SenaxInc/SenaxTankAlarm/TankAlarm-112025-Server-BluesOpta/WEBSITE_PREVIEW.md

# Website Preview - TankAlarm 112025 Server

This document contains screenshots of the web interface served by the TankAlarm-112025-Server-BluesOpta.

## Dashboard
Main fleet telemetry dashboard showing server metadata, statistics, and fleet telemetry table with relay controls.

Dashboard

## Client Console
Configuration management interface for remote clients with PIN-protected controls (unlocked view).

Client Console

## Config Generator
Create new client configurations with sensor definitions and alarm thresholds.

Config Generator

## Serial Monitor
Debug log viewer with server and client serial output.

Serial Monitor

## Calibration
Calibration learning system with manual level reading submission and drift analysis.

Calibration

## Contacts Manager
Contact and notification management with alarm associations.

Contacts Manager

## Server Settings
Server-wide configuration including FTP backup, network settings, and daily email schedule.

Server Settings

## Historical Data
Historical trends, charts, and analytics for tank fleet with level trends, alarm frequency, and site/tank details.

Historical Data

---
*Screenshots automatically generated by GitHub Actions*  
*Last updated: 2026-11-09 08:55:44 UTC*
