SenaxInc/SenaxTankAlarm/CODE REVIEW/CODE_REVIEW_07012026_DAC_LOOP_POWER_INTEGRATION_PLAN.md

# A0602 Internally-Powered DAC Gating Option in Client Firmware

**Date:** 2026-07-01  
**Author:** GitHub Copilot (Gemini 3.5 Flash)  
**Status:** Superseded by v2.1.0 (see note below)  
**Related Firmware:** TankAlarm-112025-Client-BluesOpta `v2.0.77`
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
