SenaxInc/SenaxTankAlarm/TankAlarm-112025-Viewer-BluesOpta/screenshots/dashboard.png

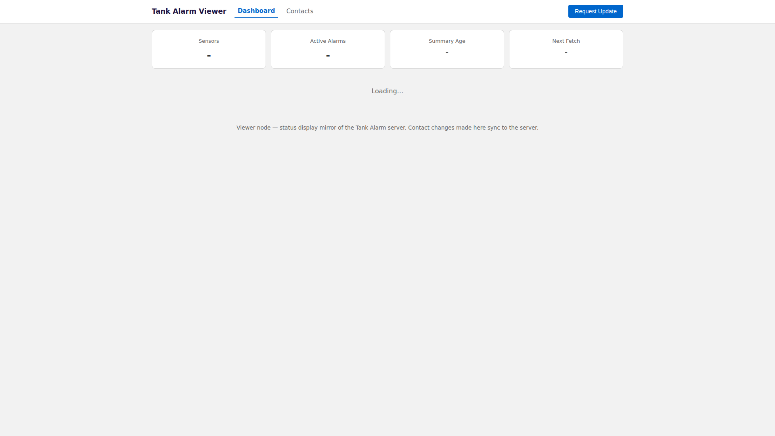
TankAlarm-112025-Viewer-BluesOpta/screenshots/dashboard.png
