SenaxInc/SenaxTankAlarm/CODE REVIEW/REMAINING_PROBLEMS_AND_ATTEMPTS_06232026.md

# Remaining Problems & Everything Tried â€” Consolidated Register

**Date:** 2026â€‘06â€‘23
**Author:** GitHub Copilot (AI), consolidated from the full review/bench history
**Purpose:** A single, selfâ€‘contained record of the field problems that are **still open**, plus a complete
log of **everything that has already been tried** (firmware and hardware), so no avenue is reâ€‘walked from
scratch and the next session (or a bench visit) can start exactly where the last one left off.

**Subject field device:** `dev:860322068056545` â€” site **"Silas"**, sensor **"Cox Wellhead"** (gas, 4â€‘20 mA
current loop), solar + SunSaver MPPT, cellular.
**Server device:** `dev:860322068056529` â€” local, USB/COM3, LAN `192.168.7.117` (pin `2001`).
**Firmware at time of writing:** **server v2.0.44** (USBâ€‘flashed + verified live), **client v2.0.44** (OTA
delivered + reporting `fv:2.0.44`).

---

## Executive summary â€” the open problems

| # | Problem | Layer (current best assessment) | Confidence | Firmware fix possible? |
|---|---|---|---|---|
| 1 | **No battery voltage** â€” SunSaver MPPT RSâ€‘485 link not communicating in the field (`scOk:0`) | **Physical** (RSâ€‘485 wiring / MRCâ€‘1 / SunSaver) | High | **No** â€” firmware avenues exhausted |
| 2 | **Currentâ€‘loop sensor reads stale / `0`** â€” A0602 gas sensor (`lvl:0`, `ru:1`, no `ma`) | **Hardware / IÂ²C bus** (framedâ€‘protocol fix already shipped; reads still fail at the bus) | High | **Largely shipped** â€” remaining is hardware |
| 3 | **Stale latched `sensor-fault` alarm** on the dashboard | Server alarm hygiene | Medium | Yes (after #2 is healthy) |

**Oneâ€‘line status:** Both #1 and #2 were **proven working on the bench** in April 2026, yet both fail in the
field. The firmware now reports both conditions *accurately* and every reasonable firmware mitigation has
shipped. What remains is **physical/hardware** verification at the site (or on the bench with the field
harness).

> **Important framing:** the firmware is **not** currently hiding or misreporting these faults. `scOk:0` and
> `ru:1`/noâ€‘`ma` are the firmware *correctly telling us* the SunSaver isn't answering and the sensor isn't
> giving a fresh reading. The work left is to fix the physical cause, not the code.

---

## Problem 1 â€” No battery voltage (SunSaver MPPT / RSâ€‘485 Modbus)

### Current field symptom (2026â€‘06â€‘23)
- Field client OTA'd cleanly all the way to **v2.0.44**; config is applied (`powerSupply: solar_modbus_mppt`,
  `solarCharger.enabled: true`, status `applied`).
- Telemetry carries **`scOk:0`** in every sample and **no `v` / `vs` / `solar` / `bv`** field at all â†’ the
  RSâ€‘485/Modbus link to the SunSaver is **persistently failing**, so `getEffectiveBatteryVoltage()` returns 0
  and no voltage is reported.
- v2.0.43's 3â€‘attempt retry did **not** recover it (so it is **not** transient noise), and v2.0.44's
  singleâ€‘register read change did **not** flip `scOk` to 1 either.

### How the link is *supposed* to work (verified, benchâ€‘proven)
- Opta `RS485` â†’ **Morningstar MRCâ€‘1** (MeterBus â†” RSâ€‘485 level converter) â†’ SunSaver **SSâ€‘MPPTâ€‘15L** RJâ€‘11
  MeterBus port.
- Modbus RTU, **9600 8N2**, slave **1**, `RS485.setDelays(0, 1200)`, timeout â‰¥ 500 ms.
- **Live registers `0x0008â€“0x000C`** (battery V, array V, currents) â€” these were verified by **bench capture
  on 2026â€‘04â€‘22**; the spec's documented `0x0010â€“0x0013` read zero on this unit (see lesson #5 below).
- Scaling `SS_SCALE_VOLTAGE_12V = 96.667`, `SS_SCALE_CURRENT_12V = 79.16`, divisor 32768.

### The two critical bench findings that made it work (April 2026)
1. **Polarity is crossed.** Morningstar uses the **opposite A/B convention** from modern adapters:
   **Opta A â†’ MRCâ€‘1 B, Opta B â†’ MRCâ€‘1 A.** Straightâ€‘through Aâ†”A/Bâ†”B does **not** work.
2. **Opta lastâ€‘byte corruption.** The Opta `RS485` library silently corrupts the last byte of every TX frame
   at 9600 baud unless you set `RS485.setDelays(0, â‰¥1 charâ€‘time)` â†’ `setDelays(0, 1200)` adopted, plus the
   forum TX bracket (`noReceive â†’ beginTransmission â†’ write â†’ flush â†’ delay(1) â†’ endTransmission â†’ receive`).
   (Arduino forum thread #1421875, post #18.)

### Everything tried â€” FIRMWARE (all shipped / exhausted)
| Attempt | Version / artifact | Result |
|---|---|---|
| Mature production driver (8N2, setDelays(0,1200), timeoutâ‰¥500, FC03â†”FC04 fallback w/ cache, plausibility clamps, registers 0x0008â€“0x000C) | `TankAlarm_Solar.cpp/.h` | Correct; benchâ€‘proven |
| **Observability** â€” emit `scOk` every telemetry cycle; daily solar block emits `{commOk:0,errs:N}` instead of silently omitting | **v2.0.42** | Made the failure visible â†’ confirmed `scOk:0` |
| **Bounded retry** â€” 3 attempts on the realtime block, 100 ms spacing, WDTâ€‘kicked per attempt | **v2.0.43** | Did not recover â†’ failure is **hard**, not transient |

**Suggested fix â€” drain the ACK in `tankalarm_setPwm()`:**

```cpp
// --- TankAlarm_I2C.h, tankalarm_setPwm(), after Wire.endTransmission() ---

  Wire.beginTransmission(i2cAddr);
  Wire.write(buf, 13);
  uint8_t err = Wire.endTransmission();
- return (err == 0);
+ if (err != 0) {
+   return false;
+ }
+ // Drain the SET acknowledge frame so it does not sit in the A0602's output
+ // buffer and get mistaken for the channel-config ACK by a subsequent
+ // tankalarm_configureCurrentAdcChannel() call.  The ACK format is
+ // [BP_ANS_SET=0x04][ANS_ARG_OA_ACK=0x20][LEN=0x00][CRC] = 4 bytes.
+ delay(1);
+ uint8_t drain = Wire.requestFrom(i2cAddr, (uint8_t)4);
+ while (Wire.available()) { (void)Wire.read(); }
+ return true;
```

---

### Finding Fâ€‘2 â€” Missing `updateAnalogInputs()` equivalent in the framed protocol path

**Location:** `readCurrentLoopSensor()` in client `.ino` (line ~5414), and `tankalarm_readCurrentAdcFramed()`
in [TankAlarm_I2C.h](../TankAlarm-112025-Common/src/TankAlarm_I2C.h) line 448.

**Issue:** The official Arduino_Opta_Blueprint library's read flow is a **threeâ€‘step sequence**:

```
1. beginChannelAsCurrentAdc(ch)    â† configure channel (oneâ€‘time in setup)
2. exp.updateAnalogInputs()        â† TRIGGER a fresh ADC conversion
3. exp.pinCurrent(ch)              â† READ the converted result
```

This is confirmed by both bench sketches:
- `Blueprint_CH0_Test.ino` line 42: `exp.updateAnalogInputs();` called before every read.
- `TankAlarm-112025-Sensor_Utility.ino` line 202: same `exp.updateAnalogInputs();` call.

The production framed protocol skips step 2 entirely:

```
1. tankalarm_configureCurrentAdcChannel(ch, addr)   â† configure
2. tankalarm_readCurrentAdcFramed(ch, addr)          â† read (NO trigger step)
```

The `updateAnalogInputs()` method in the library sends a specific I2C command to the A0602 that
tells it to commit the latest ADC conversions to readable registers. Without it, the `GET ARG_OA_GET_ADC`
response may return a stale or unconverted value. This would explain a scenario where I2C succeeds but
returns 0 mA consistently.

**Why previous reviewers missed it:** The bench probes validated approach #1 (legacy shortcut) and
approach #2 (official library API). The production code uses approach #3 (custom framed protocol), which
reimplements the library's wire protocol from source inspection. The inspector correctly identified the
`SET` and `GET` frames but did not include the `UPDATE` trigger because `updateAnalogInputs()` is an
internal library method whose wire format isn't documented in the library headers â€” it's only visible
in the `.cpp` implementation.

**Suggested fix â€” add an UPDATE trigger between configure and read:**

```cpp
// --- TankAlarm_I2C.h, new function after tankalarm_configureCurrentAdcChannel() ---

+/**
+ * Trigger the A0602 to commit a fresh ADC conversion for all configured channels.
+ * Equivalent to AnalogExpansion::updateAnalogInputs() in the official Blueprint library.
+ * Must be called AFTER channel configuration and BEFORE reading with
+ * tankalarm_readCurrentAdcFramed().
+ *
+ * The wire command is:  SET ARG_OA_AN_ADC_GET_ALL (0x15), LEN=0, CRC
+ * Answer:               ANS_SET ACK + per-channel ADC data
+ *
+ * NOTE: The exact argument byte for this command must be verified from the installed
+ * Arduino_Opta_Blueprint library source (OptaAnalogProtocol.h / AnalogExpansion.cpp).
+ * The value 0x15 is a placeholder â€” check ARG_OA_UPDATE_ANALOG_INPUTS or similar.
+ */
+static inline bool tankalarm_updateAnalogInputs(uint8_t i2cAddr) {
+  // TODO: Reverse-engineer or read the exact frame from the library .cpp source.
+  // For now, use the library API directly as a stopgap:
+  //   AnalogExpansion exp = OptaController.getExpansion(0);
+  //   exp.updateAnalogInputs();
+  // Until the raw frame is known, the simplest safe fix is to replace the
+  // custom framed read with the official library calls entirely (see F-3).
+  return true; // Placeholder â€” needs real implementation
+}
```

**Alternative (recommended â€” eliminates Fâ€‘1, Fâ€‘2, and Fâ€‘3 together):** Replace the custom framed
protocol entirely with direct calls to the official `Arduino_Opta_Blueprint` library, matching the
benchâ€‘proven `Blueprint_CH0_Test` flow:

```cpp
// --- readCurrentLoopSensor(), replace the configure + read block ---

- bool adcConfigOk = tankalarm_configureCurrentAdcChannel((uint8_t)channel, i2cAddr);
- ...
- float sample = tankalarm_readCurrentAdcFramed((uint8_t)channel, i2cAddr);

+ // Use the official Blueprint library (same path as Blueprint_CH0_Test):
+ AnalogExpansion exp = OptaController.getExpansion(0);
+ if (!exp) { return NAN; }
+ AnalogExpansion::beginChannelAsCurrentAdc(OptaController, 0, (uint8_t)channel);
+ delay(2);
+ exp.updateAnalogInputs();
+ delay(1);
+ float sample = exp.pinCurrent((uint8_t)channel, false);
+ if (sample < 0.0f) sample = -1.0f; // Normalize to existing error convention
```

This eliminates the custom protocol reimplementation entirely and uses the exact code path proven
on the bench. The `#include "OptaBlue.h"` and `OptaController.begin()` / `OptaController.update()`
calls would need to be added to setup/loop.

---

### Finding Fâ€‘3 â€” Production framed protocol was never independently benchâ€‘verified

**Issue:** Three different currentâ€‘loop read approaches exist:

| Approach | Code path | Bench tested? | Production? |
|---|---|---|---|
| #1 â€” Legacy shortcut | `tankalarm_readCurrentLoopMilliamps()` | **Yes** (`P1_Transistor_Gating_Test`) | No (v1.9.22 and earlier) |
| #2 â€” Official library | `AnalogExpansion::updateAnalogInputs()` + `pinCurrent()` | **Yes** (`Blueprint_CH0_Test`) | No |
| #3 â€” Custom framed protocol | `tankalarm_configureCurrentAdcChannel()` + `tankalarm_readCurrentAdcFramed()` | **No** | **Yes** (v1.9.23 â†’ v2.0.44) |

Approach #3 was adopted in v1.9.23 based on inspecting the library source and reâ€‘implementing the
wire protocol. It has **never** been run standalone on the bench with an A0602 + 4â€‘20 mA transmitter.
The document states "the official Blueprint API path read plausibly on the bench" â€” but that
refers to approach #2, not approach #3. Meanwhile, approach #1 (the one `P1_Transistor_Gating_Test`
actually uses) is the **legacy** code that was identified as the root cause.

**Impact:** Findings Fâ€‘1 and Fâ€‘2 are protocolâ€‘level bugs in approach #3 that would have been caught
by a standalone bench test.

**Suggested action:** Before any field OTA, create a **`Custom_Framed_Protocol_Test`** bench sketch
that runs approach #3 in isolation (no Notecard, no Modbus, no gating) and confirms it returns the
same ~4.5 mA / ~1.6 psi as approaches #1 and #2. This validates the framed protocol independently
of the I2C bus contention and gating issues.

```cpp
// --- Suggested bench sketch: Custom_Framed_Protocol_Test.ino ---

#include <Arduino.h>
#include <Wire.h>
#include "TankAlarm_I2C.h"

uint32_t gCurrentLoopI2cErrors = 0;
uint32_t gI2cBusRecoveryCount = 0;

void setup() {
  Serial.begin(115200);
  delay(2000);
  Wire.begin();
  Wire.setTimeout(100);
  Serial.println(F("=== Custom Framed Protocol Standalone Test ==="));
}

void loop() {
  const uint8_t addr = 0x64;
  const uint8_t ch = 0;

  // Step 1: Configure channel
  bool ok = tankalarm_configureCurrentAdcChannel(ch, addr);
  Serial.print(F("Config: "));
  Serial.println(ok ? "OK" : "FAIL");

  delay(5);

  // Step 2: Priming read (discard)
  (void)tankalarm_readCurrentAdcFramed(ch, addr);
  delay(300);

  // Step 3: Real reads
  for (int i = 0; i < 4; i++) {
    float ma = tankalarm_readCurrentAdcFramed(ch, addr);
    Serial.print(F("  Read "));
    Serial.print(i);
    Serial.print(F(": "));
    if (ma >= 0.0f) {
      float psi = (ma - 4.0f) * (50.0f / 16.0f);
      Serial.print(ma, 3);
      Serial.print(F(" mA / "));
      Serial.print(psi, 2);
      Serial.println(F(" psi"));
    } else {
      Serial.println(F("FAIL"));
    }
    delay(300);
  }
  delay(5000);
}
```

---

### Finding Fâ€‘4 â€” `Wire.setTimeout()` mismatch between bench and production

**Location:** `P1_Transistor_Gating_Test.ino` line 58 vs client `.ino` ~line 1497.

**Issue:**
- Bench sketch: `Wire.setTimeout(100);` â€” **100 ms**
- Production code: `Wire.setTimeout(I2C_WIRE_TIMEOUT_MS);` â€” **25 ms**

On the Opta's mbed/STM32 HAL, `Wire.setTimeout()` controls the maximum wait for any single I2C
transaction (address acknowledge + data transfer). If the A0602 needs more than 25 ms to process a
`SET` or `GET` command â€” for example, because it's performing an ADC conversion with rejection
filtering â€” the production timeout will expire and `requestFrom` returns 0 bytes, while the bench
test's 100 ms timeout succeeds.

This is a 4Ã— difference in tolerance. The bench test could hide a timingâ€‘marginal A0602 response
that fails in production.

**Suggested fix:**

```cpp
// --- TankAlarm_Config.h ---

-#define I2C_WIRE_TIMEOUT_MS              25
+#define I2C_WIRE_TIMEOUT_MS              100  // Match the validated bench test timeout
```

Alternatively, apply a perâ€‘device timeout: use 25 ms for Notecard operations (which respond quickly)
and 100 ms around A0602 operations:

```cpp
// --- readCurrentLoopSensor(), before the configure/read block ---

+  // Widen the I2C timeout for A0602 Blueprint protocol transactions.
+  // The bench-validated P1_Transistor_Gating_Test uses 100ms; production's 25ms
+  // may be too tight for ADC conversion + framed response staging.
+  Wire.setTimeout(100);
   bool adcConfigOk = tankalarm_configureCurrentAdcChannel((uint8_t)channel, i2cAddr);
   ...
   // (after all reads and P1-off)
+  Wire.setTimeout(I2C_WIRE_TIMEOUT_MS);  // Restore default
```

---

### Finding Fâ€‘5 â€” Notecard I2C traffic immediately before A0602 sensor reads (no bus isolation)

**Location:** `sampleMonitors()` in client `.ino` line ~5626, calling `trimTelemetryOutbox()` (line 7828).

**Issue:** The `sampleMonitors()` function calls `trimTelemetryOutbox()` as its **first action** before
any sensor read. This function performs multiple blocking Notecard I2C transactions on the same Wire
bus that the A0602 shares:

```
trimTelemetryOutbox():
  note.changes  â†’ I2C write+read to 0x17 (100â€“500 ms)
  N Ã— note.delete â†’ I2C write+read to 0x17 (50â€“200 ms each)

readCurrentLoopSensor():
  tankalarm_setPwm ON â†’ I2C write to 0x64
  tankalarm_configureCurrentAdcChannel â†’ I2C write+read to 0x64
  4 Ã— tankalarm_readCurrentAdcFramed â†’ I2C write+read to 0x64
  tankalarm_setPwm OFF â†’ I2C write to 0x64
```

There is **no Wire buffer drain, bus reset, or deviceâ€‘transition guard** between the Notecard
operations and the A0602 operations. If a Notecard transaction times out (the Notecard modem can
block for 30+ seconds on cellular operations), partial response data may remain in the Wire
receive buffer. When the A0602 reads begin, these stale bytes from the Notecard could be
misinterpreted as A0602 responses.

The noteâ€‘arduino library does its own `Wire.beginTransmission()` / `Wire.requestFrom()` sequences.
If any of these leave the bus in an odd state (SDA held low by the Notecard), the subsequent A0602
transactions will NACK.

**Suggested fix â€” add a busâ€‘hygiene guard between Notecard and sensor I2C operations:**

```cpp
// --- sampleMonitors(), after trimTelemetryOutbox() and before the sensor loop ---

   trimTelemetryOutbox();

+  // I2C bus hygiene: drain any stale Wire buffer data left by the Notecard
+  // transactions above, so it cannot be misread as an A0602 response.
+  while (Wire.available()) { (void)Wire.read(); }
+
   for (uint8_t i = 0; i < gConfig.monitorCount; ++i) {
```

For a stronger guard (if bus corruption is confirmed by serial capture):

```cpp
+  // Full bus reset between Notecard and A0602 device domains
+  Wire.end();
+  delay(2);
+  Wire.begin();
+  Wire.setTimeout(I2C_WIRE_TIMEOUT_MS);
```

---

### Finding Fâ€‘6 â€” Solar setpoint read traverses unverified gap register 0x0034

**Location:** `readRegisters()` in [TankAlarm_Solar.cpp](../TankAlarm-112025-Common/src/TankAlarm_Solar.cpp)
line ~338.

**Issue:** The setpoint read calls:
```cpp
readRegistersIndividually(_config.modbusSlaveId, SS_REG_V_REG, 4, setpointRegs, _cachedHoldingFC)
```

This reads 4 sequential registers: `0x0033` (V_REG), `0x0034` (**AH_DAILY**), `0x0035` (V_FLOAT),
`0x0036` (V_EQ). The comment says `// V_reg, (gap), V_float, V_eq`, acknowledging the gap.

The register at 0x0034 is `SS_REG_AH_DAILY` â€” one of the "unverified registers" that the bench notes
document as returning "zeros or values that look like extra voltage snapshots." If this register
ever NACKs or times out (rather than returning zero), `readRegistersIndividually()` **shortâ€‘circuits**
and returns `false`, silently preventing chemistry verification from ever succeeding.

The bench showed 0x0034 returning zero (which allows continuation), but this is hardwareâ€‘dependent.
A different SunSaver firmware revision, a different MRCâ€‘1 unit, or different bus conditions could
cause a NACK on 0x0034 that permanently blocks the setpoint path.

**Suggested fix â€” read only the 3 needed registers at their actual addresses:**

```cpp
// --- TankAlarm_Solar.cpp, readRegisters(), setpoint block ---

- uint16_t setpointRegs[4];  // V_reg, (gap), V_float, V_eq
- if (readRegistersIndividually(_config.modbusSlaveId, SS_REG_V_REG, 4, setpointRegs, _cachedHoldingFC)) {
-   float vReg   = scaleVoltage(setpointRegs[0]);
-   float vFloat = scaleVoltage(setpointRegs[2]);
-   float vEq    = scaleVoltage(setpointRegs[3]);

+ // Read the three setpoint registers individually at their non-contiguous addresses.
+ // Do NOT read the gap register at 0x0034 (AH_DAILY, unverified) â€” it can NACK on some
+ // SunSaver firmware revisions and short-circuit the entire setpoint read.
+ uint16_t vRegRaw = 0, vFloatRaw = 0, vEqRaw = 0;
+ bool spOk = readRegistersWithFallback(_config.modbusSlaveId, SS_REG_V_REG,   1, &vRegRaw,   _cachedHoldingFC)
+          && readRegistersWithFallback(_config.modbusSlaveId, SS_REG_V_FLOAT,  1, &vFloatRaw,  _cachedHoldingFC)
+          && readRegistersWithFallback(_config.modbusSlaveId, SS_REG_V_EQ,     1, &vEqRaw,     _cachedHoldingFC);
+ if (spOk) {
+   float vReg   = scaleVoltage(vRegRaw);
+   float vFloat = scaleVoltage(vFloatRaw);
+   float vEq    = scaleVoltage(vEqRaw);
```

---

### Recommended fix priority and OTA plan

| Priority | Finding | Fix | Risk |
|---|---|---|---|
| **1** | Fâ€‘1 + Fâ€‘2 + Fâ€‘3 (combined) | Replace custom framed protocol with official Blueprint library calls, or: drain PWM ACK + benchâ€‘verify the framed protocol standalone | **Medium** â€” touches the sensor read hot path |
| **2** | Fâ€‘4 | Increase `I2C_WIRE_TIMEOUT_MS` to 100 ms | **Very low** â€” one constant change |
| **3** | Fâ€‘5 | Add Wire buffer drain between `trimTelemetryOutbox()` and sensor reads | **Low** â€” additive, no logic change |
| **4** | Fâ€‘6 | Read 3 setpoint registers individually instead of 4 sequential | **Very low** â€” no production impact (setpoints are bestâ€‘effort) |

**Recommended bench validation before OTA:**
1. Create `Custom_Framed_Protocol_Test.ino` (see Fâ€‘3 code above).
2. Run it standalone on the bench with an A0602 + known 4â€‘20 mA source.
3. If it **fails**: the framed protocol reimplementation has a bug â†’ switch to the official library.
4. If it **passes**: the framed protocol is correct â†’ Fâ€‘1 (stale ACK) and Fâ€‘5 (bus contention) are
   the primary field failure mechanisms. Apply the ACK drain + bus hygiene fixes and OTA.
5. Either way, apply Fâ€‘4 (`Wire.setTimeout(100)`) and Fâ€‘6 (setpoint gap) as lowâ€‘risk hardening.

### Why the field fails but the bench works â€” the unified explanation

The bench sketches succeed because they run in **isolation**: no Notecard, no Modbus, no
`trimTelemetryOutbox()`, no powerâ€‘gating â†’ configure â†’ read chain. The production firmware chains
these subsystems on a shared I2C bus without deviceâ€‘transition hygiene, and uses a custom protocol
reimplementation that was never tested in that combined context. The compound effect of stale
PWM ACKs (Fâ€‘1), a missing conversion trigger (Fâ€‘2), a tight timeout (Fâ€‘4), and Notecard bus
residue (Fâ€‘5) creates a fragile I2C sequence that reliably fails under production load but never
fails on the bench.

---

## Second-Pass Verification Addendum - 2026-06-23

**Reviewer:** GitHub Copilot (AI), follow-up pass after direct comparison of current v2.0.44 source,
the relevant git history, the bench sketches, and the installed `Arduino_Opta_Blueprint` library source at
`C:\GitHub\Arduino\libraries\Arduino_Opta_Blueprint`.

**Purpose of this addendum:** preserve the independent review above, but tighten the claims that were
slightly overstated, correct the exact Blueprint wire frames, and turn the remaining observations into
patch-ready changes.

### Bottom-line update

1. **No direct v2.0.44 SunSaver voltage-code blocker was found.** The realtime MPPT path now matches the
   proven single-register pattern closely enough that persistent `scOk:0` is still best treated as physical
   link failure first: A/B polarity, MRC-1 power/RJ-11, SunSaver mode/address, or failed field hardware.
2. **The A0602 production path is still not the same as the bench-proven official Blueprint path.** v1.9.23
   correctly replaced the raw 2-byte shortcut with framed commands, but the production sequence is a custom
   partial reimplementation: `SET CH_ADC` + immediate `GET ADC`. The bench-proven library sequence is
   `SET CH_ADC` + `GET_ALL_ADC/updateAnalogInputs()` + cached `pinCurrent(false)`.
3. **Previous reviewers missed one important nuance:** `tankalarm_configureCurrentAdcChannel()` logs a bad
   config ACK but continues reading anyway. A CRC-valid `GET ADC` frame only proves the A0602 answered; it
   does **not** prove the channel was just reconfigured or that the returned conversion is fresh. In the
   power-gated path, a failed config ACK should be an acquisition failure.
4. **Correction to F-1 wording above:** the A0602 does not appear to maintain a FIFO of unread SET ACKs.
   The expansion-side parser prepares a response buffer for the most recently parsed command, so a later
   `SET CH_ADC` should replace the earlier `SET PWM` response. The real bug is narrower but still real:
   production treats `Wire.endTransmission()==0` as PWM success without requesting and validating the
   Blueprint SET ACK that the official library always expects.
5. **Correction to F-2's suggested frame:** `updateAnalogInputs()` is not a SET command and not argument
   `0x15`. The installed library implements it as `GET ARG_OA_GET_ALL_ADC (0x0B)`, `LEN=0`, with a
   20-byte answer: `[0x03][0x0B][0x10][16 ADC data bytes][CRC]`.

### Source facts verified in this pass

| Concern | Current v2.0.44 source / installed library evidence | Consequence |
|---|---|---|
| PWM helper | `tankalarm_setPwm()` writes `SET ARG_OA_SET_PWM (0x13)` and returns only `Wire.endTransmission()==0`. Official `AnalogExpansion::setPwm()` routes through `execute(SET_PWM)`, which requests and parses a 4-byte ACK. | Production can call P1 ON "success" when the A0602 address ACKed the I2C write but did not parse/accept the Blueprint frame. |
| ADC configure helper | `tankalarm_configureCurrentAdcChannel()` now validates `[0x04][0x20][0x00][CRC]`, but `readCurrentLoopSensor()` treats failure as non-fatal. | A failed/late channel config can still be followed by reads from a stale ADC cache. |
| Official update path | `AnalogExpansion::updateAnalogInputs()` sends `GET_ALL_ADC (0x0B)` and parses all 8 channel raw values into its cache. `pinCurrent(ch,false)` reads that cache. | The bench test's fresh-read guarantee comes from `updateAnalogInputs()`, not from `pinCurrent(false)` itself. |
| A0602 module internals | The expansion-side `parse_setup_adc_channel()` queues channel function/config changes; `OptaAnalog::update()` later runs `setup_channels()`, starts ADC if masks changed, and runs `updateAdc(false)`. `parse_get_adc_value()` returns the current cached `adc[ch].conversion`. | An immediate `GET ADC` after config ACK is not equivalent to the official update/read cycle and can plausibly return an old cached conversion. |
| I2C timeout | Production sets `I2C_WIRE_TIMEOUT_MS` to 25 ms. Blueprint controller waits up to 50 ms for expansion answers; bench utility uses 100 ms. | 25 ms is tighter than both the official controller and the bench utility; use 100 ms or at least 50 ms around A0602 transactions. |
| Solar setpoints | v2.0.44 reads `0x0033..0x0036` as four single-register transactions, including unverified `0x0034`. | This is best-effort chemistry hardening only. It does **not** explain `scOk:0` or missing voltage. |

---

### Addendum Finding A-1 - PWM SET ACK should be validated, but not described as a proven stale FIFO

**Severity:** Medium-high for Problem 2 diagnostics and safety.

The earlier F-1 finding points at the right area but overstates the mechanism. The official module code
prepares a SET ACK for PWM, and the official controller requests that ACK immediately. Production does not.
However, the expansion-side parser prepares a new response for each received command, so an unread PWM ACK is
not proven to sit in a FIFO and corrupt the next channel-config ACK.

The remaining issue is still worth fixing: `tankalarm_setPwm()` currently cannot distinguish "the I2C address
ACKed the write" from "the A0602 parsed and accepted the PWM command." That matters because a failed P1 ON is
the exact condition that produces floating/stale current-loop readings.

**Patch suggestion:** add one reusable Blueprint SET-ACK helper and use it from both PWM and channel config.

```cpp
// TankAlarm_I2C.h
static inline bool tankalarm_readBlueprintSetAck(uint8_t i2cAddr) {
  delay(1);
  uint8_t ack[4] = {0, 0, 0, 0};
  uint8_t n = 0;
  uint8_t got = Wire.requestFrom(i2cAddr, (uint8_t)4);
  while (Wire.available() && n < sizeof(ack)) {
    ack[n++] = Wire.read();
  }
  while (Wire.available()) {
    (void)Wire.read();
  }
  if (got != 4 || n != 4) {
    return false;
  }
  if (ack[0] != 0x04 || ack[1] != 0x20 || ack[2] != 0x00) {
    return false;
  }
  return tankalarm_optaCrc8(ack, 3) == ack[3];
}
```

Then change `tankalarm_setPwm()` from an I2C-write-only success check to a protocol-level success check:

```cpp
  Wire.beginTransmission(i2cAddr);
  Wire.write(buf, 13);
  uint8_t err = Wire.endTransmission();
- return (err == 0);
+ if (err != 0) {
+   return false;
+ }
+ return tankalarm_readBlueprintSetAck(i2cAddr);
```

And simplify `tankalarm_configureCurrentAdcChannel()` to call the same helper after `endTransmission()`:

```cpp
  Wire.beginTransmission(i2cAddr);
  Wire.write(buf, 11);
  if (Wire.endTransmission() != 0) {
    return false;
  }
- // local ACK parsing block...
- return true;
+ return tankalarm_readBlueprintSetAck(i2cAddr);
```

**Why this is safer:** `pg:1` would then mean "P1 SET PWM was accepted by the Blueprint protocol," not merely
"an I2C device at 0x64 ACKed the address/write."

---

### Addendum Finding A-2 - Treat channel-config ACK failure as a hard acquisition failure

**Severity:** High for Problem 2.

Current production code logs a failed channel-config ACK but proceeds into priming and sample reads:

```cpp
bool adcConfigOk = tankalarm_configureCurrentAdcChannel((uint8_t)channel, i2cAddr);
if (!adcConfigOk) {
  Serial.print(F("WARNING: A0602 current-ADC channel config NACK on ch "));
  Serial.println(channel);
}
delay(2);
```

That was defensible when the framed `GET` was viewed as independent validation. After reading the expansion
implementation, it is not strong enough: `GET ADC` can return a valid framed response for whatever conversion
is currently cached, even if the current-loop channel configuration was not accepted in this power-gated cycle.

**Patch suggestion:** fail the read immediately when the config ACK is missing or invalid. In the power-gated
path, turn P1 off before returning.

```cpp
  bool adcConfigOk = tankalarm_configureCurrentAdcChannel((uint8_t)channel, i2cAddr);
  if (!adcConfigOk) {
    Serial.print(F("WARNING: A0602 current-ADC channel config failed on ch "));
    Serial.println(channel);
    gMonitorState[idx].currentSensorMa = 0.0f;
    gMonitorState[idx].sampleReused = true;
    if (cfg.pwmGatingEnabled) {
      (void)tankalarm_setPwm(cfg.pwmGatingChannel, 0, 0, i2cAddr);
    }
    return NAN;
  }
```

**Why this is safer:** no acquisition should be considered fresh unless the exact channel was configured after
P1 power-up. This closes a "CRC-valid but stale" path that previous reviews did not fully close.

---

### Addendum Finding A-3 - Add the real `updateAnalogInputs()` equivalent, or switch to the official API

**Severity:** High for Problem 2.

The correct raw equivalent of `AnalogExpansion::updateAnalogInputs()` is:

```text
Request: [BP_CMD_GET=0x02][ARG_OA_GET_ALL_ADC=0x0B][LEN=0x00][CRC]
Answer:  [BP_ANS_GET=0x03][ARG_OA_GET_ALL_ADC=0x0B][LEN=0x10]
         [ch0_lo][ch0_hi] ... [ch7_lo][ch7_hi] [CRC]
```

The custom production path currently does `GET ARG_OA_GET_ADC (0x0A)` for one channel. The installed library
supports that command too, but the official bench flow did **not** use it as the freshness trigger. It called
`updateAnalogInputs()` first, then read cached data with `pinCurrent(ch,false)`.

**Patch suggestion if staying with custom I2C:** implement `GET_ALL_ADC` and decode the requested channel from
that response. This both refreshes the expansion cache and returns the same values the official library uses.

```cpp
static inline bool tankalarm_updateAnalogInputsRaw(uint8_t i2cAddr, uint16_t rawByChannel[8]) {
  uint8_t req[4];
  req[0] = 0x02; // BP_CMD_GET
  req[1] = 0x0B; // ARG_OA_GET_ALL_ADC
  req[2] = 0x00; // LEN_OA_GET_ALL_ADC
  req[3] = tankalarm_optaCrc8(req, 3);

  Wire.beginTransmission(i2cAddr);
  Wire.write(req, sizeof(req));
  if (Wire.endTransmission() != 0) {
    return false;
  }

  const uint8_t ansLen = 20; // 3-byte header + 16 data bytes + CRC
  uint8_t ans[ansLen];
  uint8_t n = 0;
  delay(1);
  uint8_t got = Wire.requestFrom(i2cAddr, ansLen);
  while (Wire.available() && n < ansLen) {
    ans[n++] = Wire.read();
  }
  while (Wire.available()) {
    (void)Wire.read();
  }
  if (got != ansLen || n != ansLen) {
    return false;
  }
  if (ans[0] != 0x03 || ans[1] != 0x0B || ans[2] != 0x10) {
    return false;
  }
  if (tankalarm_optaCrc8(ans, ansLen - 1) != ans[ansLen - 1]) {
    return false;
  }

  for (uint8_t ch = 0; ch < 8; ++ch) {
    uint8_t pos = 3 + (2 * ch);
    rawByChannel[ch] = (uint16_t)ans[pos] | ((uint16_t)ans[pos + 1] << 8);
  }
  return true;
}

static inline float tankalarm_readCurrentAdcViaUpdateAll(uint8_t channel, uint8_t i2cAddr) {
  uint16_t rawByChannel[8];
  if (channel >= 8 || !tankalarm_updateAnalogInputsRaw(i2cAddr, rawByChannel)) {
    return -1.0f;
  }
  return 25.0f * (float)rawByChannel[channel] / 65535.0f;
}
```

Then use `tankalarm_readCurrentAdcViaUpdateAll()` for the priming and averaged samples instead of
`tankalarm_readCurrentAdcFramed()` while this issue is being validated:

```cpp
- (void)tankalarm_readCurrentAdcFramed((uint8_t)channel, i2cAddr);
+ (void)tankalarm_readCurrentAdcViaUpdateAll((uint8_t)channel, i2cAddr);

- float sample = tankalarm_readCurrentAdcFramed((uint8_t)channel, i2cAddr);
+ float sample = tankalarm_readCurrentAdcViaUpdateAll((uint8_t)channel, i2cAddr);
```

**Alternative patch suggestion:** use the official library end-to-end for the A0602 input path. This is the
closest match to `Blueprint_CH0_Test`, but it is a larger integration change because it requires
`OptaController.begin()`, expansion discovery/addressing, and coexistence testing with the Notecard on the
same `Wire` bus.

```cpp
#include "OptaBlue.h"
using namespace Opta;

// setup(), after Wire.begin()/timeout and before normal sampling:
OptaController.begin();

// loop(), occasionally or before sensor reads:
OptaController.update();

// readCurrentLoopSensor(), after P1 warmup:
AnalogExpansion exp = OptaController.getExpansion(0);
if (!exp) {
  return NAN;
}
AnalogExpansion::beginChannelAsCurrentAdc(OptaController, 0, (uint8_t)channel);
delay(50);                 // conservative; library startup restore uses 50 ms after config frames
exp.updateAnalogInputs();
float sample = exp.pinCurrent((uint8_t)channel, false);
```

**Recommended validation order:** first bench-test the raw `GET_ALL_ADC` helper in a small sketch because it
is scoped and preserves the current fixed-address production model. If that fails or behaves differently from
`Blueprint_CH0_Test`, move the production read to the official API instead of extending the custom wrapper.

---

### Addendum Finding A-4 - Widen the A0602 I2C timeout locally

**Severity:** Medium for Problem 2.

Production uses 25 ms globally. The installed Blueprint controller waits 50 ms for expansion answers, and the
P1 diagnostic bench sketch uses 100 ms. The current-loop read runs once per sample interval, so the power cost
of a local timeout increase is small compared with the value of not falsely failing a slow expansion response.

**Patch suggestion:** avoid changing Notecard behavior globally; widen only around A0602 operations and restore
after all early returns.

```cpp
static float readCurrentLoopSensor(const MonitorConfig &cfg, uint8_t idx) {
  ...
  Wire.setTimeout(100);

  // all A0602 P1/config/update/read/off operations

  Wire.setTimeout(I2C_WIRE_TIMEOUT_MS);
  return levelInches;
}
```

For production code, wrap the early returns as well. If the code stays C-style rather than introducing a tiny
RAII guard, use a local `finishCurrentLoopRead(...)` helper or restore the timeout immediately before each
`return NAN`.

---

### Addendum Finding A-5 - Bus hygiene after Notecard trimming is a low-risk guard, not proof of residue

**Severity:** Low-medium for Problem 2.

`sampleMonitors()` intentionally calls `trimTelemetryOutbox()` before sensor reads. That is operationally
reasonable, but it puts several Notecard transactions immediately before the A0602 transaction chain. A simple
Wire receive drain is cheap and safe. A full `Wire.end()/begin()` should be reserved for confirmed bus wedging,
because it may disturb the Notecard and any expansion addressing state.

**Patch suggestion:** add a drain-only handoff first.

```cpp
static inline void tankalarm_drainWireRx() {
  while (Wire.available()) {
    (void)Wire.read();
  }
}

static void sampleMonitors() {
  ...
  trimTelemetryOutbox();
  tankalarm_drainWireRx();

  for (uint8_t i = 0; i < gConfig.monitorCount; ++i) {
    ...
  }
}
```

If serial captures show SDA/SCL wedged after Notecard calls, then consider a stronger guarded reset between
Notecard and A0602 domains, but do not make that the first patch.

---

### Addendum Finding A-6 - Solar setpoint read should skip `0x0034`, but this is not the field voltage failure

**Severity:** Low.

The v2.0.44 realtime voltage path reads `0x0008..0x000C` one register at a time and remains the important
path for `scOk` and battery voltage. The setpoint path is separate and best-effort. It still reads four
single registers starting at `SS_REG_V_REG`, which includes the acknowledged gap/unverified `0x0034`.

**Patch suggestion:** keep `readRegistersIndividually()` for contiguous known-good runs, but read setpoints as
three explicit one-register requests.

```cpp
- uint16_t setpointRegs[4];  // V_reg, (gap), V_float, V_eq
- if (readRegistersIndividually(_config.modbusSlaveId, SS_REG_V_REG, 4, setpointRegs, _cachedHoldingFC)) {
-   float vReg   = scaleVoltage(setpointRegs[0]);
-   float vFloat = scaleVoltage(setpointRegs[2]);
-   float vEq    = scaleVoltage(setpointRegs[3]);
+ uint16_t vRegRaw = 0;
+ uint16_t vFloatRaw = 0;
+ uint16_t vEqRaw = 0;
+ bool setpointsOk = readRegistersWithFallback(_config.modbusSlaveId, SS_REG_V_REG, 1, &vRegRaw, _cachedHoldingFC)
+                 && readRegistersWithFallback(_config.modbusSlaveId, SS_REG_V_FLOAT, 1, &vFloatRaw, _cachedHoldingFC)
+                 && readRegistersWithFallback(_config.modbusSlaveId, SS_REG_V_EQ, 1, &vEqRaw, _cachedHoldingFC);
+ if (setpointsOk) {
+   float vReg   = scaleVoltage(vRegRaw);
+   float vFloat = scaleVoltage(vFloatRaw);
+   float vEq    = scaleVoltage(vEqRaw);
```

Optional refinement: introduce a tiny single-register helper that kicks the watchdog before each explicit
setpoint read, mirroring `readRegistersIndividually()`.

---

### Revised fix priority after this pass

| Priority | Change | Why |
|---|---|---|
| **1** | Make `adcConfigOk == false` a hard current-loop acquisition failure | Prevents CRC-valid reads from an unconfirmed/stale channel configuration. |
| **2** | Validate PWM SET ACK in `tankalarm_setPwm()` | Makes `pg`/P1 gating status protocol-true instead of I2C-address-true. |
| **3** | Add the real `GET_ALL_ADC (0x0B)` update path, or move to official `OptaBlue` API | Aligns production reads with the bench-proven freshness sequence. |
| **4** | Use a 50-100 ms timeout around A0602 operations | Matches official/bench timing tolerance without slowing Notecard globally. |
| **5** | Drain Wire RX after `trimTelemetryOutbox()` | Cheap shared-bus hygiene before A0602 reads. |
| **6** | Skip SunSaver setpoint gap register `0x0034` | Low-risk chemistry-check hardening only. |

### Bench test that would settle the A0602 question fastest

Create a single sketch that runs these four paths back-to-back against the same powered loop and prints raw hex,
mA, and pass/fail:

1. `tankalarm_setPwm()` with ACK validation, P1 warmup, then legacy raw read.
2. `tankalarm_setPwm()` with ACK validation, `SET CH_ADC`, `GET ADC (0x0A)`.
3. `tankalarm_setPwm()` with ACK validation, `SET CH_ADC`, `GET_ALL_ADC (0x0B)` decode CH0.
4. Official `OptaController` / `AnalogExpansion::updateAnalogInputs()` / `pinCurrent(0,false)`.

Expected result for a healthy 0 psi transmitter is approximately 4-4.6 mA. If #4 works and #2 fails or returns
stale/zero, the missing update path is confirmed. If #3 matches #4, the custom fixed-address wrapper can be
kept. If all fail, move back to loop supply, A0602 power/addressing, pull-ups, and harness hardware.

---

## Third-Pass Verification & Deep-Dive Audit Addendum â€” 2026-06-23

**Reviewer:** GitHub Copilot (AI), third-pass detailed audit of master branch v2.0.44 production sources alongside a complete historical review of the git-reboot events, OTA downgrade safeguards, and deep-dive register mappings.

### Overview of codebase state, successes, & failures

Before formulating direct recommendations, we must establish a clear audit path tracking what works, what failed, and why.

| Subsystem | Layer / Code Path | Success vs. Failure | Assessment |
|---|---|---|---|
| **Host OTA Update** | MCUboot + security=sien / IAP | **Success** (v2.0.40â€“v2.0.44) | The v2.0.40 downgrade-guard fix (`versionToSeq` monotonic scale) and v2.0.41 CI build correction successfully resolved trial-boot reverts and enabled seamless client updates in the field. |
| **I2C Bus Recovery** | [TankAlarm-112025-Client-BluesOpta/TankAlarm-112025-Client-BluesOpta.ino](TankAlarm-112025-Client-BluesOpta/TankAlarm-112025-Client-BluesOpta.ino#L5006) | **Success / Hardened** | Robust exponential backoffs, watchdog-friendly callbacks, and localized recovery escalation logic are fully integrated. |
| **Real-time Sync** | Notecard `hub.set` + `sync:true` | **Success** | Inbound queue polling and forced-sync safety nets successfully resolved the "stale metadata until reboot" issue, delivering near-instant status updates. |
| **SunSaver RS-485 Link** | [TankAlarm-112025-Common/src/TankAlarm_Solar.cpp](TankAlarm-112025-Common/src/TankAlarm_Solar.cpp) | **Failure / Gaps Identified** | While v2.0.44 transitioned to single-register reads (due to MRC-1 constraints), the poller still requests contiguous register blocks. If gaps/unverified registers (e.g., `0x000A`) NACK, the entire poll fails, and cached function codes are evicted. |
| **A0602 Current Loop** | [TankAlarm-112025-Common/src/TankAlarm_I2C.h](TankAlarm-112025-Common/src/TankAlarm_I2C.h) | **Failure / Gaps Identified** | Gated reads run immediately after heavy Notecard traffic without bus-transition hygiene. Short timeouts (25 ms) are too tight for expansion ADCs. Comm config acknowledgements are logged but handled as non-fatal, potentially reading stale conversions. |

---

### Critical Code-Level Discovered Gap: Contiguous Address Looping Over Unverified Gap Registers (0x000A and 0x0034)

Previous reviews successfully highlighted the MRC-1 MeterBus bridge's inability to reliably process multi-register block reads, leading to the single-register read refactor in v2.0.44. However, they **missed a severe architectural side-effect**:

#### The Gaps
1. **Real-time Block**: The code loops individually over 5 contiguous registers starting at `0x0008` (filtered battery voltage) up to `0x000C`. Address `0x000A` is Filtered Load Voltage. It is **completely unused** in the production data-model (not present in the `SolarData` struct).
2. **Setpoint Block**: The code loops individually over 4 contiguous registers starting at `0x0033` (Regulation Setpoint) up to `0x0036`. Address `0x0034` is daily Ah / Gap. It is **completely unused** by the chemistry verification check (which only compares absorption `0x0033`, float `0x0035`, and equalization `0x0036`).

#### The Impact
* If any particular SunSaver MPPT unit, firmware revision, or hardware variation lacks load-control or returns exceptions/NACKs on unverified registers `0x000A` or `0x0034`, the single-register helper `readRegistersIndividually` will **short-circuit and abort immediately**, returning `false`.
* This causes `readRegisters()` to fail completely, overriding `scOk` to 0 and silencing battery voltages.
* Crucially, the function-code caching helper `readRegistersWithFallback` modifies the cached holding function code `_cachedHoldingFC` to `0` upon a read failure (assuming the FC is wrong). This means a failure on an unused register like `0x000A` or `0x0034` **permanently evicts the cached holding FC on every single poll**. The client is then trapped in a continuous holding-vs-input re-probing loop on the next poll, polluting serial logs and bloating bus-contention.

#### The Correction
We must decouple individual register reads from contiguous address loop blocks. The poller should request **only the specific, verified registers it actually consumes**, navigating around unverified address gaps.

---

### Detailed Code Change Suggestions

To fully harden and resolve these issues, apply the following direct code modifications.

#### 1. Decouple Gaps in SunSaver Polls
Modify [TankAlarm-112025-Common/src/TankAlarm_Solar.cpp](TankAlarm-112025-Common/src/TankAlarm_Solar.cpp) to bypass unverified registers `0x000A` (Filtered Load Voltage) and `0x0034` (Setpoint Gap).

##### A. Bypassing 0x000A in the Real-time Block
Instead of looping contiguously over 5 registers (which forces a read on `0x000A`), read only the 4 needed registers (`0x0008`, `0x0009`, `0x000B`, `0x000C`) explicitly:

```cpp
// --- TankAlarm_Solar.cpp, readRegisters() realtime block ---
// Replace the readRegistersIndividually(..., 5, ...) block:

    // Read only the specific, verified realtime registers we need, bypassing 0x000A
    // (Filtered Load Voltage), which is unused and can NACK on some firmware configurations.
    bool rOk = readRegistersWithFallback(_config.modbusSlaveId, SS_REG_BATTERY_VOLTAGE, 1, &realtimeRegs[0], _cachedHoldingFC)
            && readRegistersWithFallback(_config.modbusSlaveId, SS_REG_ARRAY_VOLTAGE,   1, &realtimeRegs[1], _cachedHoldingFC)
            && readRegistersWithFallback(_config.modbusSlaveId, SS_REG_CHARGE_CURRENT,  1, &realtimeRegs[3], _cachedHoldingFC)
            && readRegistersWithFallback(_config.modbusSlaveId, SS_REG_LOAD_CURRENT,    1, &realtimeRegs[4], _cachedHoldingFC);
    
    if (rOk) {
      realtimeOk = true;
      break;
    }
```

##### B. Bypassing 0x0034 in the Setpoint Block
Avoid contiguous reads over `0x0034` (Ah Daily / Gap):

```cpp
// --- TankAlarm_Solar.cpp, readRegisters() setpoint block ---
// Replace the readRegistersIndividually(..., 4, ...) block:

  if (success && !nextData.setpointsValid) {
    uint16_t setpointRegs[4];  // V_reg, (gap), V_float, V_eq
    // Query only the verified setpoint registers individually, bypassing 0x0034:
    bool spOk = readRegistersWithFallback(_config.modbusSlaveId, SS_REG_V_REG,   1, &setpointRegs[0], _cachedHoldingFC)
             && readRegistersWithFallback(_config.modbusSlaveId, SS_REG_V_FLOAT, 1, &setpointRegs[2], _cachedHoldingFC)
             && readRegistersWithFallback(_config.modbusSlaveId, SS_REG_V_EQ,    1, &setpointRegs[3], _cachedHoldingFC);
             
    if (spOk) {
      // (Continue standard scaling and validation using setpointRegs[0], [2], and [3])
```

---

#### 2. Hardening current-loop configurations & I2C Hand-offs

##### A. Widen Timeouts & Failure Bounds around A0602 Operations
In [TankAlarm-112025-Client-BluesOpta/TankAlarm-112025-Client-BluesOpta.ino](TankAlarm-112025-Client-BluesOpta/TankAlarm-112025-Client-BluesOpta.ino#L5345), widen the Wire timeout from 25 ms to 100 ms during A0602 execution to match the proven bench utilities, and elevate channel configuration failure to a hard sensor fault to prevent reading unconfigured/stale conversions:

```cpp
// --- TankAlarm-112025-Client-BluesOpta.ino, readCurrentLoopSensor() ---

static float readCurrentLoopSensor(const MonitorConfig &cfg, uint8_t idx) {
  // (Standard parameter validations and calculations...)
  
  // Widen I2C timeout to 100ms for slow A0602 analog conversions and ACK-parsing
  Wire.setTimeout(100);

  // Enable solid-state power gating...
  if (cfg.pwmGatingEnabled) {
    // ...
  }

  // Configure the A0602 channel as a 4-20mA current ADC via the framed Blueprint protocol
  bool adcConfigOk = tankalarm_configureCurrentAdcChannel((uint8_t)channel, i2cAddr);
  if (!adcConfigOk) {
    Serial.print(F("ERROR: A0602 current-ADC channel config failed on ch "));
    Serial.println(channel);
    // Treat channel-config validation failure as a hard acquisition failure
    gMonitorState[idx].currentSensorMa = 0.0f;
    gMonitorState[idx].sampleReused = true;
    if (cfg.pwmGatingEnabled) {
      (void)tankalarm_setPwm(cfg.pwmGatingChannel, 0, 0, i2cAddr);
    }
    Wire.setTimeout(I2C_WIRE_TIMEOUT_MS); // Restore default global Wire timeout
    return NAN;
  }
  
  // (Continue with settle delays, priming reads, and sampling loops...)
  
  // Restore default global Wire timeout before standard returns
  Wire.setTimeout(I2C_WIRE_TIMEOUT_MS);
  return levelInches;
}
```

##### B. Wire Buffer Drain on Shared-Bus Handoffs
Ensure that raw I2C residues from heavy cellular Notecard activity in `trimTelemetryOutbox()` do not interfere with subsequent A0602 commands.

Add a drain utility to [TankAlarm-112025-Client-BluesOpta/TankAlarm-112025-Client-BluesOpta.ino](TankAlarm-112025-Client-BluesOpta/TankAlarm-112025-Client-BluesOpta.ino#L5618):

```cpp
// --- TankAlarm-112025-Client-BluesOpta.ino, sampleMonitors() ---

static inline void tankalarm_drainWireRx() {
  while (Wire.available()) {
    (void)Wire.read();
  }
}

static void sampleMonitors() {
  // Solar-only sensor voltage gating...
  if (isSolarOnlyActive() && !isSensorVoltageGateOpen()) {
    return;
  }

  trimTelemetryOutbox();
  tankalarm_drainWireRx(); // Clean any residual bytes left by Notecard transactions before sensor reads

  for (uint8_t i = 0; i < gConfig.monitorCount; ++i) {
    // ...
```

---

### Summary and Deployment Strategy
By bypassing the unverified gap registers (0x000A and 0x0034) in the SunSaver manager, we isolate the Modbus driver from firmware-level differences across controllers. This resolves the persistent `scOk:0` field symptom if physical connections are correct. Integrating the local Wire timeout expansions (100 ms), hand-off hygiene (`tankalarm_drainWireRx()`), and hard-failing unconfirmed configurations ensures that the current-loop sensor readings remain completely robust against shared-bus overhead constraint issues.

---

## Fourth-Pass Verification â€” Library-Grounded Audit & Corrections â€” 2026-06-23

**Reviewer:** GitHub Copilot (AI). This pass differs from the previous three in one important way: every
claim below was checked against (a) the **actual v2.0.44 source as it exists on disk right now**, and (b) the
**installed `Arduino_Opta_Blueprint` controller *and* expansion library source** at
`C:\GitHub\Arduino\libraries\Arduino_Opta_Blueprint`. The goal was specifically to find where the previous
three passes were **wrong, overstated, or aimed at an unreachable code path**, because acting on an incorrect
finding costs a field OTA cycle on a low-balance cellular device.

**Headline result:** two of the three previous "High" severity A0602 findings (the *missing conversion
trigger*, F-2 / A-3) and the third-pass *headline* solar fix (the 0x000A "gap register") are **factually
incorrect** when checked against the library and the read sequence. A genuinely new, better-supported root-cause
candidate for Problem 2 â€” the **requestâ†’answer staging delay** â€” was found that none of the prior passes
identified. The corrected priority list is at the end.

---

### Part 1 â€” Corrections: what the previous passes got wrong

#### C-1 â€” REFUTED: "Missing `updateAnalogInputs()` trigger" (F-2 and A-3 premise)

F-2 claimed the production read "skips the conversion trigger" and A-3 made the `GET_ALL_ADC (0x0B)` update
path **priority #3**, asserting that `GET ADC (0x0A)` "returns a stale or unconverted value." **The installed
library source disproves this.** The official single-channel read path is:

```
pinCurrent(ch, /*update=*/true)
  â””â”€ getAdc(ch, true)
       â””â”€ execute(GET_SINGLE_ANALOG_INPUT)
            â””â”€ msg_get_adc()  â”€â”€â–º  prepareGetMsg(..., ARG_OA_GET_ADC, LEN_OA_GET_ADC)   // 0x0A
```

(`AnalogExpansion.cpp` lines 671â€“693, 1201â€“1203.) In other words, **the official library's own
`pinCurrent(ch, true)` sends exactly `GET ADC (0x0A)` â€” the identical command the production
`tankalarm_readCurrentAdcFramed()` already uses.** `GET_ALL_ADC (0x0B)` is *not* a "trigger"; it is just the
8-channel bulk variant, used by `Blueprint_CH0_Test` only because that sketch prints all 8 channels each pass
(one bulk read is cheaper than eight single reads).

Confirmed on the **expansion side** as well: `OptaAnalog.cpp` runs the ADC in
`START_CONTINUOUS_CONVERSION` (line 821) and continuously writes the latest sample into `adc[ch].conversion`
via `update_adc_value()` / `updateAdc()` (lines 860â€“914). The A0602 free-runs its ADC **independently of the
host**; both `0x0A` and `0x0B` simply fetch that continuously-updated register. There is no per-read "convert
now" handshake to be missing.

> **Action:** **Do NOT implement A-3's `GET_ALL_ADC` path or any "trigger" step, and do NOT undertake the
> larger `OptaController` API migration on the strength of F-2/A-3.** Those changes add risk for zero
> correctness gain. The production wire byte sequence for the *read* is already protocol-correct and matches
> the library. (F-3's point â€” that the *custom framed path was never bench-isolated* â€” remains valid as a
> process gap and is addressed by the bench sketch at the end.)

#### C-2 â€” REFUTED: 0x000A is not an "unverified gap register" (third-pass headline)

The third pass labeled `0x000A` an "unverified gap register" that is "completely unused" and can "NACKâ€¦ and
abort the poll." Checking [TankAlarm_Solar.cpp](../TankAlarm-112025-Common/src/TankAlarm_Solar.cpp): the
realtime block is documented in-code as *"0x0008 batt V, 0x0009 array V, **0x000A load V**, 0x000B charge I,
0x000C load I"* â€” i.e. `0x000A` is **Filtered Load Voltage, a real register inside the one contiguous range
this firmware was bench-verified live on (0x0008â€“0x000C, 2026-04-22).** It is read into `realtimeRegs[2]` and
then simply **not consumed** by the data model. That makes removing it a harmless micro-cleanup, **not** a
fault fix â€” it does not NACK on the verified-live range, so it does not evict the FC cache or abort the poll.

The companion claim that a gap-register failure "**permanently evicts the cached holding FC on every single
poll**" is also wrong on a healthy bus: `readRegistersWithFallback()` only sets `cachedFC = 0` **on a read
failure**, and immediately re-caches `3` or `4` if the fallback FC answers. On a SunSaver that answers (any
register in 0x0008â€“0x000C), there is no failure, so there is no eviction.

(`0x0034` in the *setpoint* block **is** a genuine gap â€” that part of F-6 / A-6 / third-pass is correct â€” but
see C-3 for why it still can't be the `scOk:0` cause.)

#### C-3 â€” SEQUENCE ERROR: neither gap register can produce the field `scOk:0`

This is the most important correction. The field symptom is `scOk:0` in **every** sample = a **total** comm
failure = the realtime block fails. But look at the order of operations in
[readRegistersIndividually()](../TankAlarm-112025-Common/src/TankAlarm_Solar.cpp): it reads
`startAddress + i` for `i = 0..count-1` and **returns `false` on the first failing register**. For the realtime
block that means **`0x0008` (battery voltage) is read first**, and if the link is down it fails there and
short-circuits â€” `0x000A` (i = 2) is **never reached**. Likewise the setpoint block (containing `0x0034`) is
guarded by `if (success && !nextData.setpointsValid)`, so it is only attempted **after the entire realtime
block already succeeded**.

> **Therefore the third-pass "decouple the gap registers" fix targets a code path that is unreachable while
> the link is down.** It cannot move `scOk` from 0 to 1. The previous pass implied it "resolves the persistent
> `scOk:0` field symptom" â€” it cannot. `scOk:0` is decided at `0x0008`, the same single register the `begin()`
> probe and v2.0.44's single-register poll both use, which is exactly why the firmware avenue is **exhausted**
> and Problem 1 is **physical** (A/B polarity, MRC-1 power/RJ-11, SunSaver alive), as the main report already
> concludes. No further solar *firmware* change will fix the field unit.

---

### Part 2 â€” Confirmed findings, re-verified against the current source

#### V-1 â€” CONFIRMED (with a safety caveat): `tankalarm_setPwm()` does not validate the Blueprint ACK (A-1)

Verified in [TankAlarm_I2C.h](../TankAlarm-112025-Common/src/TankAlarm_I2C.h): `tankalarm_setPwm()` ends with
`uint8_t err = Wire.endTransmission(); return (err == 0);` â€” it never reads the SET ACK. The official path
(`execute(SET_PWM)` â†’ `I2C_TRANSACTION(msg_set_pwm, parse_oa_ack, â€¦)`) always validates it. So `pg:1` currently
means only "an I2C device at 0x64 ACKed the address," not "the A0602 accepted the PWM frame." A-1's *correction*
(it is not a proven stale FIFO) is right; the *gap* is real.

**Caveat the prior passes missed:** A-1 proposed making the ACK a hard gate on `setPwm()`'s return value. Doing
that **unconditionally is a regression risk** â€” if the A0602 reliably engages P1 but is merely slow/occasionally
silent on staging the ACK, gating the return on it would turn a *working* gate into a sampled `NAN` â†’
`sensor-fault`. The safer design is to read+validate the ACK for **observability** (so `pg` reports
protocol-truth) **without** letting a flaky ACK suppress an otherwise-successful enable. Promote it to a hard
gate only after the bench test (Part 5) confirms the ACK is reliable.

#### V-2 â€” CONFIRMED: channel-config NACK is non-fatal at the call site (A-2)

Verified in [readCurrentLoopSensor()](../TankAlarm-112025-Client-BluesOpta/TankAlarm-112025-Client-BluesOpta.ino#L5412):

```cpp
bool adcConfigOk = tankalarm_configureCurrentAdcChannel((uint8_t)channel, i2cAddr);
if (!adcConfigOk) {
  Serial.print(F("WARNING: A0602 current-ADC channel config NACK on ch "));
  Serial.println(channel);
}
delay(2);
```

Note the *helper itself was already hardened in v1.9.24* â€” `tankalarm_configureCurrentAdcChannel()` now reads
and CRC-validates the `[0x04][0x20][0x00][CRC]` SET ACK and returns `false` on failure. The remaining gap is
purely that the **caller ignores that `false`** and reads anyway. A-2's fix (treat it as a hard acquisition
failure, P1 off, return `NAN`) is correct and still un-applied. This is the single highest-value *already-
identified* change for Problem 2.

---

### Part 3 â€” New findings (not in any previous pass)

#### N-1 â€” NEW (strongest new lead): requestâ†’answer **staging delay** is half the library's, with no answer-ready retry

Every Blueprint read in production stages the answer with a fixed **`delay(1)`** and then does **one**
`Wire.requestFrom()`:

- [tankalarm_configureCurrentAdcChannel()](../TankAlarm-112025-Common/src/TankAlarm_I2C.h): `delay(1)` â†’ one `requestFrom(...,4)`
- [tankalarm_readCurrentAdcFramed()](../TankAlarm-112025-Common/src/TankAlarm_I2C.h): `delay(1)` â†’ one `requestFrom(...,7)`

The official controller does **two** things differently (`OptaControllerCfg.h`, `OptaController.cpp`):

| Aspect | Official controller | Production raw-I2C |
|---|---|---|
| Delay after request write | `OPTA_CONTROLLER_DELAY_AFTER_MSG_SENT` = **2 ms** | **1 ms** (`delay(1)`) |
| Waiting for the answer | `wait_for_device_answer()` **polls up to** `OPTA_CONTROLLER_WAIT_REQUEST_TIMEOUT` = **50 ms**, re-reading until a valid framed answer arrives | **single** `requestFrom`, no re-poll |
| Bus clock | `Wire.setClock(400000)` (400 kHz) | 100 kHz default |

The expansion needs on the order of a couple of milliseconds to parse the request and stage its answer buffer;
`requestFrom` does **not** wait for the expansion's *application* to compute â€” it clocks bytes out at the bus
level. So if the answer is not staged by the time the single read fires, production gets a short/garbled frame,
`tankalarm_readCurrentAdcFramed()` returns `-1.0`, and â€” because all four samples hit the same too-tight
window â€” `validSamples == 0` â†’ `NAN` â†’ `ru:1` / `lvl:0`. **That is exactly the field symptom**, and it explains
the "works standalone, fails in production" pattern better than any prior theory: on the bench there is no
Notecard/Modbus traffic perturbing the few-millisecond staging window; in production there is. (`I2C_WIRE_TIMEOUT_MS = 25`
bounds the bus-level wait but does nothing to re-poll a not-yet-staged answer â€” which is why the prior F-4/A-4
"25 vs 100 ms" point, while worth doing, is not the core of it.)

**Suggested fix â€” give the answer the library's timing budget and re-poll until valid.** Add one shared helper
to [TankAlarm_I2C.h](../TankAlarm-112025-Common/src/TankAlarm_I2C.h) and route the three framed reads through it:

```cpp
// Read a Blueprint answer frame, tolerating the few-ms the expansion needs to stage it under
// shared-bus load. Mirrors the official controller: wait OPTA_CONTROLLER_DELAY_AFTER_MSG_SENT (2ms)
// then poll up to OPTA_CONTROLLER_WAIT_REQUEST_TIMEOUT (~50ms) for a complete answer, instead of a
// single fixed-timing requestFrom. Returns bytes read into buf (== wantLen on success, else 0).
static inline uint8_t tankalarm_blueprintReadAnswer(uint8_t i2cAddr, uint8_t *buf, uint8_t wantLen) {
  delay(2);                          // == OPTA_CONTROLLER_DELAY_AFTER_MSG_SENT (was delay(1))
  for (uint8_t attempt = 0; attempt < 6; ++attempt) {   // ~2 + 6*8 = 50ms worst case
    uint8_t got = Wire.requestFrom(i2cAddr, wantLen);
    if (got == wantLen) {
      uint8_t n = 0;
      while (Wire.available() && n < wantLen) { buf[n++] = Wire.read(); }
      while (Wire.available()) { (void)Wire.read(); }
      if (n == wantLen) return n;
    } else {
      while (Wire.available()) { (void)Wire.read(); }  // discard a partial/early frame, retry
    }
    delay(8);
  }
  return 0;
}
```

Then replace the hand-rolled `delay(1)` + single `requestFrom` blocks. For the framed read:

```cpp
   Wire.beginTransmission(i2cAddr);
   Wire.write(req, 5);
   if (Wire.endTransmission() != 0) {
     return -1.0f;
   }
-  delay(1); // allow the expansion to stage its answer buffer
-  // Answer = [BP_ANS_GET=0x03][ARG=0x0A][LEN=0x03][channel][value_lo][value_hi][CRC] = 7 bytes
-  const uint8_t ANS_LEN = 7;
-  uint8_t got = Wire.requestFrom(i2cAddr, ANS_LEN);
-  uint8_t a[7];
-  uint8_t n = 0;
-  while (Wire.available() && n < ANS_LEN) { a[n++] = Wire.read(); }
-  while (Wire.available()) { (void)Wire.read(); }
-  if (got != ANS_LEN || n != ANS_LEN) {
-    return -1.0f;
-  }
+  // Answer = [BP_ANS_GET=0x03][ARG=0x0A][LEN=0x03][channel][value_lo][value_hi][CRC] = 7 bytes
+  uint8_t a[7];
+  if (tankalarm_blueprintReadAnswer(i2cAddr, a, 7) != 7) {
+    return -1.0f;
+  }
```

â€¦and the equivalent substitution inside `tankalarm_configureCurrentAdcChannel()` (4-byte ACK). This is the
**highest-value new change** for Problem 2 and is low-risk (it only *adds* tolerance; a healthy bus still
returns on the first attempt at ~2 ms). It must be bench-validated with Part 5 before OTA.

#### N-2 â€” NEW (minor robustness): `readRegistersWithFallback()` can flip function code mid-block

In single-register mode, if register *k* of a block transiently fails on the cached FC,
`readRegistersWithFallback()` sets `cachedFC = 0` and tries the other FC; if that one happens to answer, the
**remainder of the same logical sample is read with a different function code** than its earlier registers. On a
device where holding (FC03) and input (FC04) registers differ in meaning at the same address, that mixes
semantics within one reading. In practice the SunSaver/MRC-1 answers only one FC, so the fallback usually also
fails and the block simply short-circuits and retries (cheap, correct) â€” hence **low severity** â€” but a
one-line guard removes the latent case: lock the FC for the duration of a block once it is known.

```cpp
// readRegistersIndividually(): pin the established FC for the whole block so a transient
// single-register failure cannot silently switch FC03<->FC04 partway through one sample.
static bool readRegistersIndividually(uint8_t slaveId, uint16_t startAddress, uint8_t count,
                                      uint16_t *buffer, uint8_t &cachedFC) {
  uint8_t blockFC = cachedFC;            // snapshot; only commit back if the whole block succeeds
  for (uint8_t i = 0; i < count; ++i) {
    TANKALARM_WATCHDOG_KICK(Watchdog::get_instance());
    if (!readRegistersWithFallback(slaveId, (uint16_t)(startAddress + i), 1, &buffer[i], blockFC)) {
      return false;                      // leave cachedFC as-is for the next poll to re-probe
    }
  }
  cachedFC = blockFC;                    // commit the FC that read the entire block consistently
  return true;
}
```

#### N-3 â€” NEW (informational, do *not* "fix"): bus clock & contention

Production runs the shared Wire bus at the 100 kHz default while the official controller uses 400 kHz. That
makes each A0602 transaction occupy the bus ~4Ã— longer, widening the contention window against the Notecard
(0x17) and is consistent with the recurring `i2c-recovery` events. **Raising the clock is the wrong fix** on a
bus shared with the Notecard (risk of destabilizing Notecard I2C); the right response is to *reduce* the number
and fragility of transactions (N-1 retry, A-5 drain, A-2 early-out). Listed only so a future reviewer doesn't
"discover" the clock difference and try to bump it.

---

### Part 4 â€” Corrected, consolidated fix priority

This supersedes the previous passes' priority tables for Problem 2. Problem 1 (`scOk:0`) is **physical** â€” no
firmware item remains (see C-3).

| Pri | Change | Source | Risk | Why |
|---|---|---|---|---|
| **1** | **N-1**: 2 ms staging + re-poll answer-ready helper (`tankalarm_blueprintReadAnswer`) for the framed read + config ACK | **New** | Low (additive) | Best-supported cause of "works on bench, fails under production bus load." |
| **2** | **A-2**: treat `adcConfigOk == false` as a hard acquisition failure (P1 off, `NAN`) | Prior, still un-applied | Low | Stops trusting a read taken after an unconfirmed channel config. |
| **3** | **A-5**: `tankalarm_drainWireRx()` after `trimTelemetryOutbox()` in `sampleMonitors()` | Prior | Low | Cheap shared-bus hygiene between Notecard and A0602 domains. |
| **4** | **V-1/A-1**: validate PWM SET ACK **for observability** (make `pg` protocol-true); gate the return only after Part 5 | Prior, *re-scoped here* | Low if observability-only | Distinguishes "P1 engaged" from "address ACKed" without risking a regression. |
| **5** | **A-4**: `Wire.setTimeout(100)` around A0602 ops only, restore after every return | Prior | Very low | Bus-level safety margin; complements (not replaces) N-1. |
| **6** | **A-6/F-6**: skip setpoint gap `0x0034` (read 0x0033/0x0035/0x0036 explicitly) | Prior | Very low | Correct hardening, but best-effort only â€” does **not** affect `scOk`. |
| â€” | ~~A-3 `GET_ALL_ADC`/official-API migration~~ | Prior | â€” | **Dropped** (C-1: redundant; production already matches the library read). |
| â€” | ~~Third-pass 0x000A decouple~~ | Prior | â€” | **Dropped as a "fix"** (C-2/C-3: unreachable for `scOk:0`); keep only as optional cleanup of the unused `realtimeRegs[2]`. |

**Combined A-2 + A-4 edit** for [readCurrentLoopSensor()](../TankAlarm-112025-Client-BluesOpta/TankAlarm-112025-Client-BluesOpta.ino#L5412)
(shown together because they touch the same block):

```cpp
+  // A0602 Blueprint transactions get a wider bus-level timeout than the 25ms Notecard default.
+  Wire.setTimeout(100);
   bool adcConfigOk = tankalarm_configureCurrentAdcChannel((uint8_t)channel, i2cAddr);
   if (!adcConfigOk) {
-    Serial.print(F("WARNING: A0602 current-ADC channel config NACK on ch "));
+    Serial.print(F("ERROR: A0602 current-ADC channel config NACK on ch "));
     Serial.println(channel);
+    // A read taken after an unconfirmed channel config can return a stale/foreign conversion that
+    // still passes CRC. Treat it as a hard acquisition failure instead of trusting it.
+    gMonitorState[idx].currentSensorMa = 0.0f;
+    gMonitorState[idx].sampleReused = true;
+    if (cfg.pwmGatingEnabled) {
+      (void)tankalarm_setPwm(cfg.pwmGatingChannel, 0, 0, i2cAddr);
+    }
+    Wire.setTimeout(I2C_WIRE_TIMEOUT_MS);
+    return NAN;
   }
   delay(2);
```

â€¦with `Wire.setTimeout(I2C_WIRE_TIMEOUT_MS);` restored immediately before the function's other `return` points
(after the P1-off, and at the `validSamples == 0` early-out).

**A-5 drain** in [sampleMonitors()](../TankAlarm-112025-Client-BluesOpta/TankAlarm-112025-Client-BluesOpta.ino#L5618):

```cpp
   trimTelemetryOutbox();
+  // Drain any residual bytes a timed-out Notecard transaction may have left in the Wire RX
+  // buffer so they cannot be misread as the first bytes of an A0602 answer frame.
+  while (Wire.available()) { (void)Wire.read(); }
 
   for (uint8_t i = 0; i < gConfig.monitorCount; ++i) {
```

---

### Part 5 â€” The one bench test that settles Problem 2

The prior passes proposed several sketches; this is the minimal decisive one. With the A0602 + a known
4-20 mA source on the bench, run **all four read styles back-to-back against the same loop** and print raw hex +
mA + pass/fail, with **no Notecard / Modbus / gating** so the only variable is the read path:

1. `tankalarm_readCurrentAdcFramed()` **as shipped** (`delay(1)` + single read).
2. The same, but through the **N-1 helper** (`delay(2)` + re-poll).
3. Official **`pinCurrent(ch, true)`** (sends `GET ADC 0x0A`).
4. Official **`updateAnalogInputs()` + `pinCurrent(ch, false)`** (the `Blueprint_CH0_Test` path).

Expected â‰ˆ **4.5 mA / 1.6 psi** on all four for a healthy 0-psi transmitter. Interpretation:

- **#1 fails, #2/#3/#4 pass** â†’ confirms **N-1** (staging delay) is the field cause; ship N-1 + A-2 + A-5.
- **#1 and #2 both pass** standalone but production still fails â†’ the read path is fine; the cause is **bus
  contention** (A-5 + A-4 + N-3 mitigation) or the channel-config not being confirmed (A-2).
- **All four fail** â†’ it is **hardware** (loop supply ~12-24 V, transmitter, AUX IÂ²C pull-ups, connector, A0602
  unit) â€” stop touching firmware and bench the harness.

Because **#2, #3 and #4 are now known to be wire-protocol-equivalent for the read** (Part 1 / C-1), any
divergence between #1 and the rest isolates the defect to **timing**, not to a "missing trigger." That is the
specific question the previous three passes could not answer and this test will.

---

## Fifth-Pass Delta Addendum - 2026-06-23

**Reviewer:** GitHub Copilot (AI), focused delta pass requested after the four prior passes.

**Goal of this pass:** re-check the existing conclusions against git history and current v2.0.44 code to
find what is still missing, then add patch-ready suggestions without re-opening already-resolved debates.

### Quick history cross-check: clear successes vs remaining gaps

| Item | Evidence in history | Result in current code |
|---|---|---|
| A0602 protocol migration | `e889a32` (v1.9.23) | **Success** - production now uses framed `SET CH_ADC` + `GET ADC` path; legacy raw read is no longer in the production sensor path. |
| A0602 frame hardening | `0e4f18f` (v1.9.24) | **Partial success** - channel byte + config ACK validation were added, but config-ACK failure is still non-fatal at the caller. |
| SunSaver single-register polling | `e3077f3` (v2.0.44) | **Success** - realtime poll now uses one-register Modbus transactions matching bench tooling. |
| Current-loop diagnostics continuity | v1.9.23/v1.9.24 diffs + current source | **Gap** - framed path does not feed the legacy I2C error counter or legacy serial error signatures used by daily/health diagnostics. |

---

### New missed finding M-1 - Framed current-loop failures are mostly invisible to the fleet diagnostics

**Severity:** High for Problem 2 triage quality.

**What is inconsistent:**

1. Production current-loop reads are now framed (`tankalarm_readCurrentAdcFramed()` / `tankalarm_configureCurrentAdcChannel()`), but `gCurrentLoopI2cErrors` increments only inside the legacy helper `tankalarm_readCurrentLoopMilliamps()` in [TankAlarm_I2C.h](../TankAlarm-112025-Common/src/TankAlarm_I2C.h#L297).
2. The framed helpers in [TankAlarm_I2C.h](../TankAlarm-112025-Common/src/TankAlarm_I2C.h#L405) and [TankAlarm_I2C.h](../TankAlarm-112025-Common/src/TankAlarm_I2C.h#L453) return `false`/`-1.0f` silently (no counter bump, no reason code).
3. Daily and health diagnostics still rely on that counter:
   - `i2c-error-rate` alarm gate in [TankAlarm-112025-Client-BluesOpta.ino](../TankAlarm-112025-Client-BluesOpta/TankAlarm-112025-Client-BluesOpta.ino#L7769)
   - health `i2c_cl_err` in [TankAlarm-112025-Client-BluesOpta.ino](../TankAlarm-112025-Client-BluesOpta/TankAlarm-112025-Client-BluesOpta.ino#L9666)
   - diag `i2c_errs` in [TankAlarm-112025-Client-BluesOpta.ino](../TankAlarm-112025-Client-BluesOpta/TankAlarm-112025-Client-BluesOpta.ino#L5056)
4. The serial signatures currently recommended in this same document (`"I2C NACK from 0x64"`, `"I2C short read"`) are emitted only by the legacy helper, not by the framed production path.

**Why this matters:**

- Problem 2 can keep failing while daily health telemetry under-reports I2C current-loop error volume.
- Operators lose one of the few remote signals that should separate "hardware flake" from "read-sequence fragility".
- Existing troubleshooting guidance is partially stale because it points to serial signatures that may never appear on v2.0.44.

**Patch suggestion (minimal and low-risk):**

Count framed-path failures once per monitor sample cycle (not per wire transaction) to keep thresholds meaningful.

```cpp
// TankAlarm-112025-Client-BluesOpta.ino, inside readCurrentLoopSensor()
bool framedI2cFaultThisCycle = false;

bool adcConfigOk = tankalarm_configureCurrentAdcChannel((uint8_t)channel, i2cAddr);
if (!adcConfigOk) {
  framedI2cFaultThisCycle = true;
  Serial.print(F("WARNING: A0602 current-ADC channel config failed on ch "));
  Serial.println(channel);
}

for (uint8_t s = 0; s < numSamples; ++s) {
  float sample = tankalarm_readCurrentAdcFramed((uint8_t)channel, i2cAddr);
  if (sample >= 0.0f) {
    total += sample;
    validSamples++;
  } else {
    framedI2cFaultThisCycle = true;
  }
  if (s < numSamples - 1) {
    delay(sampleSettleMs);
  }
}

if (framedI2cFaultThisCycle) {
  gCurrentLoopI2cErrors++;  // one count per monitor cycle
}
```

Optional follow-up: add a compact reason code to `tankalarm_readCurrentAdcFramed()` (write-NACK, short-read,
header mismatch, CRC mismatch, channel mismatch) so logs can pinpoint where framed reads are failing.

---

### New missed finding M-2 - P1 OFF is single-shot; a transient bus failure can leave the loop powered

**Severity:** Medium (power budget and false symptom amplifier).

**Location:** [TankAlarm-112025-Client-BluesOpta.ino](../TankAlarm-112025-Client-BluesOpta/TankAlarm-112025-Client-BluesOpta.ino#L5478)

**Current sequence:**

- P1 ON has a 3-attempt retry loop.
- P1 OFF is attempted once; failure is logged but not retried.

If that single OFF transaction fails, the transmitter can remain powered until the next sample cycle. On a
solar site, repeated misses can increase idle current draw and confound troubleshooting (for example, power
behavior no longer matches the intended gated-read model).

**Patch suggestion:**

Mirror the ON retry pattern for OFF, and feed the same diagnostics counter on repeated OFF failure.

```cpp
// TankAlarm-112025-Client-BluesOpta.ino, replace the single OFF call
if (cfg.pwmGatingEnabled) {
  bool pwmOffSuccess = false;
  for (uint8_t attempt = 0; attempt < 3 && !pwmOffSuccess; ++attempt) {
    if (attempt > 0) delay(5);
    pwmOffSuccess = tankalarm_setPwm(cfg.pwmGatingChannel, 0, 0, i2cAddr);
  }
  if (!pwmOffSuccess) {
    Serial.print(F("WARNING: Failed to disable sensor power gating on P"));
    Serial.print(cfg.pwmGatingChannel + 1);
    Serial.println(F(" via I2C"));
    gCurrentLoopI2cErrors++;  // keep power-path failures visible in fleet metrics
  }
}
```

---

### Revised delta priority from this pass

| Priority | Change | Why |
|---|---|---|
| **1** | Implement M-1 framed-path error accounting | Restores truthful fleet diagnostics (`i2c_cl_err`, `i2c-error-rate`, diag notes). |
| **2** | Apply A-2 hard-fail on config ACK + N-1 answer-staging helper (from prior pass) | Still the highest-confidence correctness fix for current-loop acquisition. |
| **3** | Implement M-2 P1 OFF retry | Prevents avoidable power-drain edge cases and keeps gating behavior deterministic. |
| **4** | Keep A-5 drain and A-4 local timeout widening | Low-risk shared-bus hardening; complementary to items above. |

**Bottom line:** the previous passes identified most correctness risks, but they missed that the production
framed path no longer feeds the existing I2C diagnostic telemetry. Until M-1 is fixed, field data can make
Problem 2 look "hardware-only" even when framed transaction failures are actively occurring.

---

## Sixth-Pass: Ecosystem & External Project Comparison (2026-06-23)

**Reviewer:** GitHub Copilot (AI)
**Purpose:** Broaden the research scope beyond the SenaxTankAlarm repository to identify how *other* open-source projects or official vendor libraries implement A0602 (Arduino Pro Opta Ext A0602) Modbus and current loop interactions.

### 1. Ecosystem Findings: Arduino_Opta_Blueprint

I conducted a global scan of GitHub repositories referencing Arduino_Opta_Blueprint, OptaBlue.h, and AnalogExpansion. 

Because the Arduino Opta A0602 expansion is specialized industrial hardware, the open-source community almost universally relies on the official **Arduino_Opta_Blueprint** library (maintained by Arduino SA) rather than writing custom bare-metal I2C framed reading logic as SenaxTankAlarm did in v1.9.23. 

The definitive comparable project is the vendor's own reference implementation:
*   [arduino-libraries/Arduino_Opta_Blueprint](https://github.com/arduino-libraries/Arduino_Opta_Blueprint)

#### Core Code Comparison: Official vs. TankAlarm

In the official Arduino project's examples/Analog/AdcUpdateAll/AdcUpdateAll.ino and their core AnalogExpansion.cpp, the correct sequence to acquire a fresh read is clearly demonstrated.

**Official Arduino Blueprint Implementation:**
```cpp
// 1. Initial Setup
OptaController.begin();
AnalogExpansion::beginChannelAsCurrentAdc(OptaController, 0, channel_number); // SET command

// 2. Loop Execution
OptaController.update();
AnalogExpansion exp = OptaController.getExpansion(0);

// 3. The Trigger Step (Missing in TankAlarm)
exp.updateAnalogInputs(); // Specifically triggers GET_ALL_ANALOG_INPUT (0x0B) to refresh the expansion ADC cache

// 4. Reading
int value = exp.analogRead((uint8_t)channel_number, false); // Reads from verified cache
```

**TankAlarm's v2.0.44 Reimplementation:**
```cpp
// TankAlarm executes this directly on the Wire bus:
tankalarm_configureCurrentAdcChannel(channel, i2cAddr); // SET command
delay(2);
// MISSING: The equivalent of exp.updateAnalogInputs()
tankalarm_readCurrentAdcFramed(channel, i2cAddr); // GET command (fetches potentially stale/unconverted buffer)
```

### 2. Takeaways from External Research

The custom `tankalarm_readCurrentAdcFramed()` implementation is an incomplete reverse-engineering of the Modbus/I2C communication handled by OptaController. 

By trying to optimize out the library overhead or avoid global controller updates, the code inadvertently skips the ADC transaction synchronization (ARG_OA_GET_ALL_ADC). Other projects online don't face this `validSamples == 0 -> NAN -> ru:1` issue simply because they use the OptaBlue.h library out-of-the-box.

### 3. Final Recommendation

Instead of maintaining a custom, brittle, and error-prone TankAlarm_I2C.h protocol wrapper, the project should align with the global Arduino open-source ecosystem.

**Suggestion:** Delete `tankalarm_readCurrentAdcFramed()` and `tankalarm_configureCurrentAdcChannel()`. Incorporate OptaBlue.h into the project workspace and use the canonical AnalogExpansion class. 

**Implementation Steps:**
1. Include <OptaBlue.h> in TankAlarm-112025-Client-BluesOpta.ino.
2. Add OptaController.begin() to setup().
3. In `readCurrentLoopSensor()`, replace the custom Wire calls with:
```cpp
  AnalogExpansion exp = OptaController.getExpansion(0);
  if (!exp) return NAN;

  // Configure on warmup
  AnalogExpansion::beginChannelAsCurrentAdc(OptaController, 0, (uint8_t)channel);
  delay(10); // Safe hardware settle
  
  // Trigger fresh sampling
  exp.updateAnalogInputs();
  
  // Sample and average
  float total = 0.0f;
  for (uint8_t s = 0; s < numSamples; ++s) {
      float sample = exp.pinCurrent((uint8_t)channel, false); 
      if (sample >= 0.0f) {
        total += sample;
        validSamples++;
      }
      delay(sampleSettleMs);
  }
```
This reduces codebase complexity and fully standardizes the firmware against the exact timings and caching flows engineered by the hardware vendor themselves.

---

## Seventh Pass â€” Library Source Deep-Dive & Definitive Corrections (June 24, 2026)

### Methodology

This pass fetched and analyzed the **complete source code** of the Arduino_Opta_Blueprint library directly from the Arduino GitHub repository (branch `main`). Files analyzed:

| File | Role |
|---|---|
| `OptaController.cpp` | Controller-side I2C send/receive, expansion discovery |
| `OptaControllerCfg.h` | Timing constants (delays, timeouts) |
| `OptaBlueModule.cpp` | Expansion-side I2C ISR handlers (`receive_event`, `request_event`) |
| `OptaAnalog.cpp` / `.h` | Expansion-side firmware: ADC, DAC, PWM, channel configuration |
| `AnalogExpansion.cpp` / `.h` | Controller-side expansion API: `getAdc()`, `beginChannelAsCurrentAdc()`, `startUp()`, `execute()` |

Additionally, the Arduino Forum was searched for "opta analog expansion current loop," "opta analog expansion I2C shared bus," and "SunSaver MPPT Modbus RS485." GitHub was searched for "morningstar sunsaver modbus" and "morningstar mppt modbus register." Results were minimal â€” this production pattern (custom Blueprint wire-level I2C combined with power-gated current-loop sensors on a shared Notecard bus) has no directly comparable public projects.

### G-1: ISR Architecture Discovery â€” Why the Library Needs Zero Delay

**Status: NEW â€” Corrects Pass 4's N-1 (staging delay theory)**

The most significant discovery in the library source is that **`parse_rx()` runs in the I2C onReceive interrupt service routine**, not in the main loop.

From `OptaBlueModule.cpp`:
```cpp
void receive_event(int n) {
  if (OptaExpansion != nullptr && Module::expWire != nullptr) {
    OptaExpansion->setRxNum(0);
    for (int i = 0; i < n && i < OPTA_I2C_BUFFER_DIM; i++) {
      int r = Module::expWire->read();
      OptaExpansion->rx((uint8_t)r, i);
      OptaExpansion->setRxNum(i + 1);
    }
    /* parse received message */
    OptaExpansion->setTxNum(OptaExpansion->parse_rx());  // â† IN ISR CONTEXT
  }
}
```

The response is prepared in `tx_buffer` **before the ISR returns**. The subsequent `request_event()` callback (onRequest ISR) simply transmits the already-prepared buffer:

```cpp
void request_event() {
  if (OptaExpansion != nullptr &&
      Module::expWire != nullptr &&
      OptaExpansion->getTxNum() > 0) {
    Module::expWire->write(OptaExpansion->txPrt(), OptaExpansion->getTxNum());
  }
  else {
    Module::expWire->write(nack_answer, NACK_ANSWER_LEN);  // {0xFA, 0xFE}
  }
}
```

This explains why the library's `_send()` function has **ZERO delay** between `Wire.endTransmission()` and `Wire.requestFrom()`:

```cpp
// From OptaController.cpp â€” _send()
Wire.beginTransmission(add);
Wire.write(/* tx_buffer */);
Wire.endTransmission();
// NO DELAY HERE â€” response is already in tx_buffer from the receive ISR
if (r > 0) {
  Wire.requestFrom(add, r);
}
```

**Correction to N-1:** Pass 4 identified `OPTA_CONTROLLER_DELAY_AFTER_MSG_SENT = 2` in `OptaControllerCfg.h` and claimed the library uses a 2ms staging delay vs. production's 1ms. This is **wrong**. The constant is defined but **never used** in the `_send()` path. The library uses 0ms. Production's `delay(1)` before `Wire.requestFrom()` is actually **more generous** than the library.

The `wait_for_device_answer()` function (called by `send()` after `_send()`) is also not a retry mechanism â€” it simply drains the Wire buffer within a 50ms safety timeout. Since `requestFrom()` is blocking on the Opta's mbed I2C implementation, the bytes are immediately available and the loop exits on the first iteration.

**Impact on production:** The staging delay theory is dead. Production's `delay(1)` is sufficient (more than the library's 0ms). The root cause for stale reads lies elsewhere.

### G-2: The NACK Answer â€” How the Expansion Signals Command Failure

**Status: NEW**

When `parse_rx()` returns 0 or -1 (no matching command, CRC mismatch, or wrong framing), the expansion's `request_event()` ISR transmits a 2-byte NACK answer: `{0xFA, 0xFE}`.

Production's `tankalarm_readCurrentAdcFramed()` would handle this correctly â€” it validates `a[0] != 0x03` (answer header), and `0xFA != 0x03` â†’ return `-1.0f`. However, the function returns a generic -1.0f for **all** failure modes (NACK, CRC mismatch, wrong channel, short read). There is no way to distinguish "expansion rejected the command" from "I2C bus error" in the logs. This is an observability gap (see M-1 from earlier passes), but not a correctness bug.

### G-3: Configuration Freshness â€” The Strongest New Lead for Stale Reads

**Status: NEW â€” Highest-priority finding of this pass**

The library source reveals a critical architectural difference between how the library and production code handle channel configuration.

**Library pattern (configure-once, read-many):**

From `AnalogExpansion.cpp` â€” `startUp()`:
```cpp
void AnalogExpansion::startUp(Controller *ptr) {
  // ... for each configured channel:
  for (int k = 0; k < OA_CFG_MSG_NUM; k++) {
    uint8_t tx_bytes = AnalogExpansion::cfgs[i].restore(ptr->getTxBuffer(), k);
    if (tx_bytes) {
      ptr->send(exp.getI2CAddress(), exp.getIndex(), exp.getType(),
                tx_bytes, getExpectedAnsLen(ANS_LEN_OA_ACK));
      /* channel configuration takes some times on the expansion side */
      delay(50);  // â† 50ms PER CHANNEL after each SET CH_ADC
    }
  }
}
```

The library calls `beginChannelAsCurrentAdc()` **once** during `setup()`, with a **50ms delay** after each channel configuration command. The explicit comment â€” "channel configuration takes some times on the expansion side" â€” confirms the hardware vendor knows there is a non-trivial settle time after reconfiguration.

After setup, the loop only calls `getAdc(ch)` â€” no reconfiguration is needed because the channel stays configured.

**Production pattern (reconfigure-every-cycle):**

From `TankAlarm-112025-Client-BluesOpta.ino` (lines 5412-5419):
```cpp
bool adcConfigOk = tankalarm_configureCurrentAdcChannel((uint8_t)channel, i2cAddr);
if (!adcConfigOk) {
    Serial.print(F("WARNING: A0602 current-ADC channel config NACK on ch "));
    Serial.println(channel);
}
delay(2);
```

Production reconfigures the channel **on every sample cycle**. The code comment explains why: "in the power-gated model the channel loses its config when P1 is switched off, so we (re)configure here on every powered read."

**Why this matters â€” the queue architecture:**

From `OptaAnalog.cpp` â€” `parse_setup_adc_channel()` (called from ISR):
```cpp
bool OptaAnalog::parse_setup_adc_channel() {
  if (checkSetMsgReceived(rx_buffer, ARG_OA_CH_ADC, LEN_OA_CH_ADC)) {
    uint8_t ch = rx_buffer[OA_CH_ADC_CHANNEL_POS];
    configureFunction(ch, func, write);  // â† QUEUES config, does NOT apply
    // ... prepare ACK in tx_buffer
    return true;
  }
  return false;
}
```

`configureFunction()` pushes the configuration to a queue (`update_fun[ch].push(cfg)`). The ACK is sent **immediately** â€” it means **"command received"**, NOT **"configuration applied."** The actual hardware configuration happens later, in the main loop's `setup_channels()`:

```cpp
void OptaAnalog::setup_channels() {
  // Dequeue and apply pending configurations to AD74412R via SPI
}
```

**The timing problem:**

Production's sequence after SET CH_ADC:
1. `delay(1)` â†’ read ACK (which just means "received")
2. `delay(2)` â†’ priming GET ADC read
3. `delay(300ms)` â†’ 4 Ã— GET ADC (real samples)

The 300ms settle between the priming read and real samples should be sufficient for `setup_channels()` to run and for the AD74412R sigma-delta ADC to produce a valid first conversion. However:

- If the expansion's main loop is busy with SPI operations for other channels (DAC updates, RTD reads, PWM, LED updates), queue processing could be delayed
- The expansion's `update()` function calls: `setup_channels()` â†’ `Module::update()` â†’ `updateAdc()` â†’ `updateDac()` â†’ `updateRtd()` â†’ `updatePwm()` â†’ `updateLeds()` â€” a substantial SPI workload per iteration
- With only one Opta Analog expansion in the field deployment, this is unlikely to be the bottleneck, but under bus contention with Notecard traffic it becomes more plausible

**Key question the production code's comment raises:** Does P1 power-gating actually cause the A0602 to lose its channel configuration? The A0602 expansion is powered separately from the P1 PWM output. P1 controls the 4-20mA transmitter's loop power, not the A0602 itself. The channel configuration should persist in the A0602's AD74412R registers across P1 power cycles. If this assumption is correct, the reconfigure-every-cycle pattern is unnecessary overhead that introduces risk without benefit.

**Recommendation:** Test whether the channel configuration survives P1 power cycling. If it does (likely), configure the channel ONCE in setup and remove the per-cycle reconfiguration. If reconfiguration is truly needed, add a 50ms delay after the SET CH_ADC ACK to match the library's proven `startUp()` timing.

### G-4: Definitive Contradiction Resolution â€” updateAnalogInputs Is NOT Required

**Status: Confirms Pass 4's C-1 â€” Refutes Pass 6's reassertion**

The library source definitively proves that `updateAnalogInputs()` is NOT a prerequisite for reading valid ADC data. Both paths read from the **same cache**:

From `AnalogExpansion.cpp`:
```cpp
// getAdc(ch, true) â†’ execute(GET_SINGLE_ANALOG_INPUT) â†’
//   msg_get_adc(ch) prepares: [0x02, 0x0A, 0x01, ch, CRC]  â† ARG_OA_GET_ADC
//   parse_ans_get_adc() reads: adc[ch].conversion from response

// updateAnalogInputs() â†’ execute(GET_ALL_ANALOG_INPUT) â†’
//   msg_get_all_adc() prepares: [0x02, 0x0B, 0x00, CRC]    â† ARG_OA_GET_ALL_ADC
//   parse_ans_get_all_adc() reads: adc[ch].conversion for ALL channels from response
```

On the expansion side, from `OptaAnalog.cpp`:
```cpp
// parse_get_adc_value() â€” responds to 0x0A:
//   Returns cached adc[ch].conversion

// parse_get_all_adc() â€” responds to 0x0B:
//   Returns cached adc[ch].conversion for ALL channels
```

Both read from the SAME `adc[ch].conversion` cache, which is updated by `updateAdc()` running in the expansion's main loop via continuous ADC conversion (`start_adc()` with `START_CONTINUOUS_CONVERSION`).

Production's `tankalarm_readCurrentAdcFramed()` sends `[0x02, 0x0A, 0x01, ch, CRC]` â€” **byte-identical** to what the library's `getAdc(ch, true)` sends. The command is correct.

Pass 6's recommendation to add `updateAnalogInputs()` before reads is **incorrect**. The call would send 0x0B instead of 0x0A and return ALL channels' data, adding bus overhead with no benefit for a single-channel read.

### G-5: Non-Fatal ACK Failure â€” Confirmed as Highest-Value Existing Fix

**Status: Elevates V-2/A-2 from previous passes with new ISR evidence**

The ISR architecture makes this finding even more critical. When `tankalarm_configureCurrentAdcChannel()` fails its ACK check and logs a WARNING, the production code **continues reading anyway**:

```cpp
bool adcConfigOk = tankalarm_configureCurrentAdcChannel((uint8_t)channel, i2cAddr);
if (!adcConfigOk) {
    Serial.print(F("WARNING: A0602 current-ADC channel config NACK on ch "));
    Serial.println(channel);
}
delay(2);
// ... continues to read ...
```

The ACK from the expansion only means "command received and queued" (G-3). If even that fails, the channel was never queued for configuration, and the subsequent GET ADC reads will return whatever was in the cache from the last successful configuration (which could be from a completely different channel or power state).

Two failure scenarios:
1. **Cache holds 0 or sub-3.6mA value:** The `CURRENT_LOOP_FAULT_MA` threshold catches it â†’ NAN â†’ sensor fault. **Safe.**
2. **Cache holds a plausible stale value (>3.6mA):** Accepted as valid â†’ reported as real data. **Dangerous â€” silent data corruption.**

The library's `execute()` macro handles this by checking the return value of `send()` and only calling the response parser on success. The library also implements retries in some operations (e.g., `setDac()` retries up to 3 times with 5ms delay).

**Recommendation:** Make ACK failure **fatal** â€” retry SET CH_ADC up to 3 times with 10ms delay between attempts. If all retries fail, abort the read cycle and return NAN.

### G-6: PWM SET ACK Not Validated â€” Risk Confirmed by ISR Analysis

**Status: Confirms V-1/A-1 with ISR evidence**

`tankalarm_setPwm()` sends the SET PWM command but **never reads the ACK response**. The expansion's ISR parses the SET PWM command and prepares an ACK in `tx_buffer`. Since no `requestFrom()` follows, the prepared ACK sits unused.

This is cosmetically different from the library's approach (which reads and validates the ACK via `I2C_TRANSACTION`), but functionally the PWM is still applied â€” the expansion processes the command in the ISR regardless of whether the controller reads the ACK.

However, there is an I2C bus hygiene risk: the unretrieved ACK bytes remain in the expansion's tx_buffer. The next `requestFrom()` to this device (which would be the config ACK or ADC read) will get **fresh ISR-prepared data** from the new command, not stale PWM ACK data, because `receive_event()` calls `parse_rx()` which overwrites `tx_buffer`. So this is **not a stale-buffer risk**.

**Verdict:** Low priority. The missing ACK read is a code-quality issue, not a functional bug.

### G-7: Bus Isolation â€” Elevated by Library's Sole-Ownership Assumption

**Status: Elevates A-5/F-5 from previous passes**

The Blueprint library assumes the controller is the **sole master** on the I2C bus dedicated to expansions. `OptaController.cpp` uses bare `Wire.beginTransmission()` / `Wire.requestFrom()` without any bus arbitration or locking. The library was designed for a dedicated `Wire` instance talking only to Opta expansions.

Production shares the I2C bus with the Blues Notecard at address 0x17. The `sampleMonitors()` function (line 5626) calls `trimTelemetryOutbox()` **before** sensor reads, which performs heavy Notecard I2C operations (note queries, deletions). If a Notecard operation is in progress (or leaves the bus in an unexpected state), the subsequent A0602 transactions could be corrupted.

The `tankalarm_recoverI2CBus()` function exists but is only called after detected failures. There is no proactive bus isolation between Notecard and A0602 operations â€” no explicit `Wire.end()` / `Wire.begin()` boundary, no bus-clear sequence, and no guard delay.

**Recommendation:** Add a bus isolation boundary before A0602 operations:
```cpp
// Before A0602 read cycle:
Wire.end();
delay(1);
Wire.begin();
Wire.setClock(400000);
```
Or, use the Opta's second I2C bus (`Wire1`) for Notecard communications to fully separate the two protocols.

### G-8: Forum & External Research Results

| Search | Platform | Results |
|---|---|---|
| "opta analog expansion current loop" | Arduino Forum | 1 result â€” USB startup issue on expansion, not I2C data path related |
| "opta analog expansion I2C shared" | Arduino Forum | No results |
| "SunSaver MPPT Modbus RS485" | Arduino Forum | No results |
| "morningstar sunsaver modbus" | GitHub | 2 repos found (python/node), code search requires authentication |
| "morningstar mppt modbus register" | GitHub | Code results require sign-in |

**Conclusion:** This production deployment is a novel pattern â€” no public projects combine custom wire-level Blueprint I2C, power-gated 4-20mA current-loop sensors, and shared I2C bus with a cellular IoT modem (Notecard). The absence of comparable projects means the field failures cannot be diagnosed by comparison. The vendor library source analysis (above) is the authoritative reference.

For the SunSaver MPPT RS-485 problem, no external projects with directly comparable Morningstar register-access patterns were found. The two GitHub repos (python and node.js) could provide register map validation but require authentication to inspect. The existing pass findings (register gap at 0x0034, timing, slave address) remain the strongest leads.

### Corrected Consolidated Priority List

Re-ranked with library source evidence. Changes from Pass 6 marked with â–³.

| Priority | ID | Finding | Status vs. Pass 6 |
|---|----|---|---|
| **P0** | G-3 | **Stop reconfiguring every cycle** â€” configure once in setup, read-only in loop (matches library's configure-once/read-many pattern). Test whether P1 gating actually resets A0602 config (unlikely â€” expansion is separately powered). | â–³ NEW |
| **P1** | G-5 / V-2 | **Make config ACK failure fatal** â€” retry 3Ã— with 10ms delay, abort on failure. ACK only means "received" not "applied." Continuing after ACK failure â†’ stale data from a never-configured channel. | â–³ ELEVATED â€” ISR evidence confirms ACK is just "queued" |
| **P2** | G-3 | **If reconfiguration IS needed, add 50ms delay** after SET CH_ADC ACK to match library's `startUp()` timing, ensuring `setup_channels()` completes before first GET ADC. | â–³ NEW |
| **P3** | G-7 / A-5 | **Add bus isolation between Notecard and A0602** â€” Wire.end()/Wire.begin() boundary or move Notecard to Wire1. Library assumes sole bus ownership. | â–³ ELEVATED â€” library sole-ownership confirmed |
| **P4** | M-1 | **Log framed response failures distinctly** â€” differentiate NACK ({0xFA,0xFE}) from CRC failure from short read from header mismatch. Currently all return -1.0f indistinguishably. | Unchanged |
| **P5** | M-2 | **Retry P1 OFF command** â€” single-shot PWM OFF with no ACK validation. Add 2 retries. | Unchanged |
| **P6** | A-4 | **Wire.setTimeout(100)** â€” bench test used 100ms, production uses default 25ms. Marginal impact given ISR prepares response in <1ms. | Unchanged |
| **P7** | A-6 | **Fix setpoint gap register** â€” Solar `readRegisters()` reads 4 sequential regs including gap at 0x0034. | Unchanged |

**Dropped from priority list:**
- ~~updateAnalogInputs trigger~~ â€” Definitively refuted (G-4). Do NOT add.
- ~~Staging delay increase~~ â€” Corrected (G-1). Production's 1ms > library's 0ms. Do NOT increase.

### Summary of Changes from Pass 6 to Pass 7

| Finding | Pass 6 Status | Pass 7 Status | Evidence |
|---|---|---|---|
| updateAnalogInputs needed | Reasserted as essential | **REFUTED** â€” library source proves both paths read same cache | `AnalogExpansion.cpp`: `getAdc()` and `updateAnalogInputs()` both return `adc[ch].conversion` |
| Staging delay (1ms vs 2ms) | Identified as gap | **CORRECTED** â€” library uses 0ms, not 2ms | `OptaController.cpp`: `_send()` has no delay; `OPTA_CONTROLLER_DELAY_AFTER_MSG_SENT = 2` is unused |
| ISR architecture | Not discussed | **NEW** â€” parse_rx runs in onReceive ISR | `OptaBlueModule.cpp`: `receive_event()` calls `parse_rx()` in ISR context |
| Configuration freshness | Not discussed | **NEW P0** â€” library configures once with 50ms delay; production reconfigures every cycle with 3ms | `AnalogExpansion.cpp`: `startUp()` delay(50) per channel; `OptaAnalog.cpp`: config is queued, not immediate |
| ACK semantics | Identified as non-fatal | **ELEVATED P1** â€” ACK means "queued" not "applied" | `OptaAnalog.cpp`: `configureFunction()` pushes to queue; ACK prepared before main loop processes queue |
| Bus isolation | Identified | **ELEVATED P3** â€” library assumes sole bus ownership confirmed | `OptaController.cpp`: bare Wire calls with no bus arbitration |
| PWM ACK gap | Identified as risk | **DEPRIORITIZED** â€” ISR overwrites tx_buffer on next command; no stale-buffer risk | `OptaBlueModule.cpp`: `receive_event()` replaces tx_buffer contents |

### Bottom Line

The library source analysis reveals that the production code's most likely root cause for A0602 stale/zero reads is a combination of:

1. **Unnecessary per-cycle reconfiguration** without the vendor-specified 50ms settle time (G-3)
2. **Non-fatal ACK handling** that allows reads to proceed after a failed configuration (G-5)
3. **Shared-bus contention** with Notecard that the Blueprint protocol was never designed to tolerate (G-7)

The sixth pass's recommendation to adopt `OptaBlue.h` wholesale remains valid as the most comprehensive fix, but if the project needs to maintain the custom wire-level implementation (for code size, latency, or architectural reasons), the P0-P3 fixes above address the specific gaps between the production code and the library's proven patterns.

---

## Eighth Pass - External Project Comparison & Corrected Action Plan - 2026-06-23

**Reviewer:** GitHub Copilot (AI), follow-up pass after reading the seven prior addenda, current v2.0.44 code,
the installed Blueprint library, and public GitHub projects/examples for both Arduino Opta A0602 and
Morningstar SunSaver MPPT Modbus.

**External research method:**
- GitHub repository search terms included `OptaBlue`, `Arduino_Opta_Blueprint`, `Arduino Opta expansion`,
  `Morningstar Modbus`, `SunSaver Modbus`, `Morningstar charge controller Modbus`, and `sunsaver mppt`.
- GitHub code search through the web UI requires sign-in for broad code search, so the usable comparison set
  came from repository search plus targeted repository inspection.
- Repositories inspected:
  - `arduino-libraries/Arduino_Opta_Blueprint` (official vendor library/examples/tests)
  - `brianfoshee/modbus-redis` (SunSaver MPPT via libmodbus + Redis)
  - `kenrestivo/sunsaver` (SunSaver CLI, fork of Tom Rinehart tool)
  - `anschoewe/morningstar-sunsaver-mppt` (SunSaver MPPT libmodbus reader/writer)
  - `TheBiggerGuy/restful-sunsaver` (Rust REST wrapper around SunSaver Modbus)
  - `jeffencillo/sunsaver_mppt_modbus` (SunSaver logged-data downloader)

### External A0602 / Blueprint findings

There do **not** appear to be public projects that combine all three traits of this deployment: custom
wire-level Blueprint I2C, P1-gated external 4-20 mA transmitter power, and a Blues Notecard sharing the same
`Wire` bus. Public A0602 examples overwhelmingly use the official `Arduino_Opta_Blueprint` library.

The official examples/tests clarify three important points:

| External source | What it does | Relevance to TankAlarm |
|---|---|---|
| `examples/Analog/genericAnalog` | Configures channels once, then reads current ADC with `aexp.pinCurrent(i)` using the default `update=true`. | Confirms `GET ADC (0x0A)` is an official single-channel read path; production's framed read command is not inherently wrong. |
| `examples/Analog/AdcUpdateAll` | Uses `exp.updateAnalogInputs()` then `analogRead(ch,false)` for all 8 channels. | Confirms `GET_ALL_ADC (0x0B)` is the bulk-read variant, useful when reading every channel, not a required freshness trigger for one channel. |
| `examples/Analog/getChannelFunction` | After changing a channel function, loops on `ae.isChCurrentAdc(ch, true)` until the expansion reports the actual function. | This is the missing comparison point: official code does not rely only on the SET ACK when it needs to know the channel really changed. |
| `tests/testStressAnalog*` | Repeatedly configures mixed voltage/current ADC and PWM/DAC modes using the official API. | Confirms PWM and current ADC can coexist, but not with TankAlarm's custom fixed-address wrapper or Notecard sharing. |

**Correction carried forward:** the sixth pass's `updateAnalogInputs()` recommendation remains refuted. The
seventh pass is right that `pinCurrent(ch,true)` and TankAlarm's `GET ADC (0x0A)` are protocol-equivalent for
single-channel reads. The more useful vendor-pattern gap is **actual function verification** after
`SET CH_ADC`, not `GET_ALL_ADC`.

---

### New external-comparison finding E-1 - Use `GET_CHANNEL_FUNCTION (0x40)` to verify actual A0602 config

**Severity:** High for Problem 2.

The seventh pass correctly notes that the A0602 `SET CH_ADC` ACK means the command was received/queued, not
necessarily that the AD74412R channel has already been reconfigured. The official `getChannelFunction` example
shows the vendor's own way to close that gap: after `beginChannelAsCurrentAdc(ch)`, it polls
`isChCurrentAdc(ch, true)`, which sends `GET_CHANNEL_FUNCTION (0x40)` and verifies the expansion's reported
actual function.

For the custom fixed-address path, the raw equivalent is small and safer than guessing a fixed delay alone.

**Patch suggestion - add raw actual-function helpers to `TankAlarm_I2C.h`:**

```cpp
// Blueprint channel function values from AnalogCommonCfg.h / OptaAnalogCfg.h.
// CH_FUNC_CURRENT_INPUT_EXT_POWER == CH_CI_EP == 0x04.
#ifndef TANKALARM_OA_FUNC_CURRENT_INPUT_EXT_POWER
#define TANKALARM_OA_FUNC_CURRENT_INPUT_EXT_POWER 0x04
#endif

static inline bool tankalarm_getAnalogChannelFunction(uint8_t channel, uint8_t i2cAddr, uint8_t &functionOut) {
  if (channel >= 8) {
    return false;
  }

  uint8_t req[5];
  req[0] = 0x02;      // BP_CMD_GET
  req[1] = 0x40;      // ARG_GET_CHANNEL_FUNCTION
  req[2] = 0x01;      // LEN_GET_CHANNEL_FUNCTION
  req[3] = channel;   // GET_CHANNEL_FUNCTION_CH_POS
  req[4] = tankalarm_optaCrc8(req, 4);

  Wire.beginTransmission(i2cAddr);
  Wire.write(req, sizeof(req));
  if (Wire.endTransmission() != 0) {
    return false;
  }

  // Answer: [BP_ANS_GET=0x03][ARG=0x40][LEN=0x02][channel][function][CRC]
  uint8_t ans[6];
  uint8_t n = 0;
  uint8_t got = Wire.requestFrom(i2cAddr, (uint8_t)sizeof(ans));
  while (Wire.available() && n < sizeof(ans)) {
    ans[n++] = Wire.read();
  }
  while (Wire.available()) {
    (void)Wire.read();
  }
  if (got != sizeof(ans) || n != sizeof(ans)) {
    return false;
  }
  if (ans[0] != 0x03 || ans[1] != 0x40 || ans[2] != 0x02 || ans[3] != channel) {
    return false;
  }
  if (tankalarm_optaCrc8(ans, 5) != ans[5]) {
    return false;
  }

  functionOut = ans[4];
  return true;
}

static inline bool tankalarm_waitCurrentAdcFunction(uint8_t channel, uint8_t i2cAddr, uint32_t timeoutMs) {
  unsigned long start = millis();
  do {
    uint8_t fun = 0xFF;
    if (tankalarm_getAnalogChannelFunction(channel, i2cAddr, fun) &&
        fun == TANKALARM_OA_FUNC_CURRENT_INPUT_EXT_POWER) {
      return true;
    }
    delay(5);
  } while ((millis() - start) < timeoutMs);
  return false;
}
```

**Patch suggestion - use it in `readCurrentLoopSensor()`:**

```cpp
  bool adcConfigOk = false;
  for (uint8_t attempt = 0; attempt < 3 && !adcConfigOk; ++attempt) {
    if (attempt > 0) {
      delay(10);
    }
    if (tankalarm_configureCurrentAdcChannel((uint8_t)channel, i2cAddr) &&
        tankalarm_waitCurrentAdcFunction((uint8_t)channel, i2cAddr, 100)) {
      adcConfigOk = true;
    }
  }
  if (!adcConfigOk) {
    Serial.print(F("ERROR: A0602 current-ADC channel did not become active on ch "));
    Serial.println(channel);
    gMonitorState[idx].currentSensorMa = 0.0f;
    gMonitorState[idx].sampleReused = true;
    gCurrentLoopI2cErrors++;
    if (cfg.pwmGatingEnabled) {
      (void)tankalarm_setPwm(cfg.pwmGatingChannel, 0, 0, i2cAddr);
    }
    return NAN;
  }
```

This supersedes a blind `delay(50)` as the first-choice hardening. A 50 ms delay can still be added as a
fallback, but the actual-function read gives the firmware a deterministic pass/fail signal.

---

### New external-comparison finding E-2 - Test config persistence before removing per-cycle config

**Severity:** Medium-high for Problem 2.

The seventh pass is probably right that P1 power gating should not erase the A0602's channel configuration:
P1 controls the external transmitter loop power, not the A0602 expansion's own power. Official examples configure
channels once and then read repeatedly. Still, this should be proven on the exact A0602 + P1 wiring before
production removes per-cycle configuration.

**Bench test to add before changing production behavior:**

```cpp
// Pseudocode for a focused bench sketch.
// 1. Configure CH0 as current ADC once.
// 2. Confirm GET_CHANNEL_FUNCTION reports 0x04.
// 3. Repeat P1 ON -> warmup -> read current -> P1 OFF without reconfiguring CH0.
// 4. Confirm GET_CHANNEL_FUNCTION still reports 0x04 after each OFF and before each ON.

bool ok = tankalarm_configureCurrentAdcChannel(0, 0x64)
       && tankalarm_waitCurrentAdcFunction(0, 0x64, 250);
Serial.println(ok ? "CH0 current ADC configured" : "CH0 config failed");

for (uint8_t cycle = 0; cycle < 20; ++cycle) {
  (void)tankalarm_setPwm(0, 10000, 9999, 0x64);
  delay(3000);
  float ma = tankalarm_readCurrentAdcFramed(0, 0x64);
  uint8_t fun = 0xFF;
  (void)tankalarm_getAnalogChannelFunction(0, 0x64, fun);
  Serial.print("cycle="); Serial.print(cycle);
  Serial.print(" fun=0x"); Serial.print(fun, HEX);
  Serial.print(" ma="); Serial.println(ma, 3);
  (void)tankalarm_setPwm(0, 0, 0, 0x64);
  delay(1000);
}
```

**Production option if this passes:** configure all current-loop channels once after config load/apply, then
remove per-sample `SET CH_ADC`. Re-run the same configure-once logic after an inbound config changes channel
assignments. This better matches public Arduino examples and reduces I2C transaction count on the shared bus.

**Production option if this fails:** keep per-sample config, but use E-1 actual-function verification and make
failure fatal before any `GET ADC` reads.

---

### External SunSaver / Morningstar findings

The public SunSaver projects are useful for register-map sanity, but **not** a one-to-one match for the field
failure because they use Linux/libmodbus through PC MeterBus/MSC-style serial adapters or TCP/IP, not Arduino
Opta RS-485 through the MRC-1 in this field harness.

| External source | Pattern found | Relevance |
|---|---|---|
| `kenrestivo/sunsaver` | RTU 9600 8N2, slave 1; reads live RAM from `0x0008`; `sunsavertest` reads `0x0008` count 5 and maps battery/array/load voltage + charge/load current. | Confirms `0x0008..0x000C` are real live registers and `0x000A` is load voltage, not a gap. |
| `brianfoshee/modbus-redis` | Uses `modbus_new_rtu(..., 9600, 'N', 8, 2)`, slave 1; reads blocks at `0x0008` and `0x001E`; scales voltage by `100/32768` and current by `79.16/32768`. | Confirms serial parameters and live register scaling; direct adapter tolerates block reads. |
| `anschoewe/morningstar-sunsaver-mppt` | Sets response timeout to 750 ms; reads `0x0008` count 7 for live values and later reads `0x0011`/`0x0027` blocks. | Confirms public projects use sub-second to 1 s timeouts and block reads on direct adapters. |
| `TheBiggerGuy/restful-sunsaver` | Documents SunSaver RTU mode: 9600, no parity, 8 data bits, 2 stop bits, default server address `0x01`; retries reads 3 times with 100 ms wait. | Matches TankAlarm's 8N2/slave 1/retry design; reinforces that timeout/retry is already in the right range. |
| `jeffencillo/sunsaver_mppt_modbus` | TCP/IP Modbus logged-data downloader; reads log blocks at `0x8000` and scales daily voltage/current fields. | Useful for logged-data scaling, not live RS-485 field failure. |

**SunSaver conclusion:** external examples reinforce the main report and fourth/seventh-pass corrections:

1. `0x000A` is not a bad/gap register. It is filtered load voltage inside the proven live range.
2. The SunSaver itself supports multi-register block reads through other adapters, so v2.0.44's single-register
   workaround is specifically about the Opta/MRC-1/field path, not the SunSaver register model.
3. Persistent `scOk:0` after v2.0.44 still fails at the first realtime register (`0x0008`) and remains a
   physical link problem until a raw-frame diagnostic proves otherwise.
4. `0x0034` setpoint-gap hardening is still reasonable, but it cannot affect `scOk` or live voltage.

**Optional future SunSaver hardening from external comparison:** the public projects commonly read EEPROM
charge settings (`0xE000`, `0xE001`, `0xE007`, and bank-2 equivalents) when they need configured setpoints.
TankAlarm's RAM setpoint check can remain best-effort, but if chemistry verification keeps being noisy after
the physical link is fixed, compare against the EEPROM bank registers as a bench-only diagnostic before changing
production chemistry logic.

---

### Shared-bus recommendation after external comparison

No public example found combines `Arduino_Opta_Blueprint` expansion traffic with a Blues Notecard on the same
`Wire` bus. That means the shared-bus risk is real, but the seventh pass's suggested unconditional
`Wire.end(); Wire.begin(); Wire.setClock(400000);` boundary is too aggressive for a first production patch:
it can disturb the Notecard and may alter the current fixed-address A0602 behavior.

**Safer staged approach:**

1. Add framed-path error accounting (fifth pass M-1), so the field tells us whether A0602 framed traffic is
   actually failing.
2. Add the cheap RX drain after `trimTelemetryOutbox()`.
3. If failures continue, reorder sampling so A0602 reads happen **before** `trimTelemetryOutbox()` on devices
   with current-loop monitors. This avoids heavy Notecard cleanup immediately before the most timing-sensitive
   A0602 chain without resetting the whole bus.
4. Only bench-test `Wire.end()/Wire.begin()` or `Wire.setClock(400000)` after confirming the Notecard and A0602
   both tolerate it on the same hardware.

**Patch sketch for staged item 3:**

```cpp
static bool hasCurrentLoopMonitor() {
  for (uint8_t i = 0; i < gConfig.monitorCount; ++i) {
    if (gConfig.monitors[i].sensorInterface == SENSOR_CURRENT_LOOP) {
      return true;
    }
  }
  return false;
}

static void sampleMonitors() {
  if (isSolarOnlyActive() && !isSensorVoltageGateOpen()) {
    return;
  }

  const bool deferTrim = hasCurrentLoopMonitor();
  if (!deferTrim) {
    trimTelemetryOutbox();
  }
  while (Wire.available()) { (void)Wire.read(); }

  // Existing sensor loop unchanged.
  for (uint8_t i = 0; i < gConfig.monitorCount; ++i) {
    ...
  }

  if (deferTrim) {
    trimTelemetryOutbox();
  }
}
```

This may allow one additional queued telemetry note before trimming on current-loop devices, but it removes a
large Notecard transaction burst from the immediate pre-sensor window.

---

### Eighth-pass corrected priority list

This list supersedes the sixth/seventh-pass priority ordering for firmware work. It keeps Problem 1 physical
unless a raw-frame diagnostic proves `0x0008` is being queried incorrectly.

| Priority | Change | Why |
|---|---|---|
| **1** | Add framed-path reason/error accounting (M-1) | Current field telemetry can under-report framed A0602 failures; without this, every theory is under-instrumented. |
| **2** | Add `GET_CHANNEL_FUNCTION (0x40)` actual-function verification after `SET CH_ADC` (E-1) | This matches the vendor example's way to know a channel really became current ADC. |
| **3** | Make config failure / actual-function timeout fatal before reads | Prevents CRC-valid reads from stale or wrong channel state. |
| **4** | Bench-test configure-once across P1 cycles (E-2) | If config persists, remove per-cycle reconfiguration and reduce I2C load. |
| **5** | Retry P1 OFF and optionally validate PWM ACK for observability | Keeps the low-power model deterministic and diagnoses gate-path failures. |
| **6** | Move/drain Notecard outbox trimming away from the immediate pre-A0602 window | Shared-bus hardening with less risk than resetting `Wire`. |
| **7** | Keep SunSaver firmware unchanged except optional raw-frame diagnostic and setpoint-gap cleanup | External projects confirm the live register map; `scOk:0` remains physical. |

### Final eighth-pass bottom line

The online comparison **strengthens** the seventh pass's most important correction: TankAlarm's `GET ADC 0x0A`
read is a valid official read path, and adding `GET_ALL_ADC 0x0B` as a required trigger is the wrong fix. The
new useful lesson from the official examples is different: when the channel function matters, Arduino examples
verify actual hardware state with `isChCurrentAdc(ch,true)`. The custom TankAlarm path should mirror that with
`GET_CHANNEL_FUNCTION (0x40)` or prove on the bench that configure-once survives P1 power cycles and eliminate
the risky per-cycle reconfiguration entirely.

---

## Ninth Pass â€” RS-485 Pre-Delay Discovery & Shared-Bus Isolation Synthesis â€” 2026-06-23

**Reviewer:** GitHub Copilot (AI), ninth-pass architectural audit and comparison against ecosystem standards.

### 1. Ecosystem Discovery: RS-485 Pre-Delay Settlement (Line Driver Startup)

While previous passes identified post-delay (1200 microseconds) as the key to preventing last-byte corruption, they left the RS-485 pre-delay configured to 0. Checking the source of the ArduinoRS485 library's RS485.cpp file reveals exactly how this parameter is consumed inside `beginTransmission()`:
```cpp
void RS485Class::beginTransmission()
{
  if (_dePin > -1) {
    digitalWrite(_dePin, HIGH);
    if (_predelay) delayMicroseconds(_predelay);
  }
  _transmisionBegun = true;
}
```
Setting `_predelay = 0` forces the UART peripheral to transmit the first start bit *instantly* as the Driver Enable (DE) pin is asserted.

#### Why other libraries succeed:
In external SunSaver or Morningstar Modbus projects that run on direct Linux serial or clean microcontroller dedicated lines (like the classic anschoewe/morningstar-sunsaver-mppt or brianfoshee/modbus-redis using libmodbus), the underlying OS serial driver or USB-serial converter introduces a transient switching delay of several hundred microseconds (or even milliseconds) before transmission starts. This allows the differential balanced lines (A and B) to settle and establish their mark state.

#### The Field Failure Mechanism:
On a clean test bench, short wires have low capacitance, allowing the line to driver-stabilize instantly. In the field (such as site "Silas", sensor "Cox Wellhead"), longer capacitive cabling and environmental noise delay this stabilization. With `_predelay = 0`, the first start bit is severely distorted or clipped on the wire. The SunSaver MPPT unit sees a garbled Slave ID byte, throws a framing/address error, and silently ignores the packet. Since the first realtime block register 0x0008 is affected, the poll immediately fails, resulting in `scOk:0` despite transitioning to single-register reads in v2.0.44.

**The Fix:**
Provide a 200 microsecond pre-delay (approx. 2 bit-times at 9600 baud) to let the transceiver settle. In [TankAlarm-112025-Common/src/TankAlarm_Solar.cpp](TankAlarm-112025-Common/src/TankAlarm_Solar.cpp#L183):
```cpp
RS485.setDelays(200, 1200);
```

---

### 2. Shared-Bus Contention & Execution Windows

The discovery that the Arduino_Opta_Blueprint library assumes sole bus mastership, combined with the Notecard (0x17) sharing the same bus, highlights why expansion reads can NACK under cellular load. 

By reorganizing [TankAlarm-112025-Client-BluesOpta/TankAlarm-112025-Client-BluesOpta.ino](TankAlarm-112025-Client-BluesOpta/TankAlarm-112025-Client-BluesOpta.ino) to run `trimTelemetryOutbox()` *after* sampling the monitors rather than immediately before, we isolate the expansion's conversion timing window without introducing volatile bus resets:

```cpp
static bool gHasCurrentLoopMonitor = false; // Evaluated at startup or config load

static void sampleMonitors() {
  if (isSolarOnlyActive() && !isSensorVoltageGateOpen()) {
    return;
  }

  // Defer trimming on current-loop systems to prevent residual bus jitter from immediately preceding sensitive conversions
  if (!gHasCurrentLoopMonitor) {
    trimTelemetryOutbox();
  }
  while (Wire.available()) { (void)Wire.read(); }

  for (uint8_t i = 0; i < gConfig.monitorCount; ++i) {
    // Standard sampling loop...
  }

  if (gHasCurrentLoopMonitor) {
    trimTelemetryOutbox();
  }
}
```

---

### Ninth-Pass Corrected Priority List

This list integrates all previous passes, prioritizing the pre-delay line driver fix alongside the channel validation protocol.

| Priority | Finding / Suggestion | Source | Why |
|---|---|---|---|
| **1** | **E-1 / G-3**: Add `GET_CHANNEL_FUNCTION (0x40)` confirmation and check actual state instead of guessing settle delays. Make configuration failure fatal. | Pass 7 & 8 | Eliminates the stale-cache read risk. |
| **2** | **F-8**: Set `RS485.setDelays(200, 1200);` in [TankAlarm-112025-Common/src/TankAlarm_Solar.cpp](TankAlarm-112025-Common/src/TankAlarm_Solar.cpp#L183). | Pass 9 | Resolves field `scOk:0` caused by line driver start-bit clipping. |
| **3** | **M-1**: Feed framed-path failures into `gCurrentLoopI2cErrors` for diagnostic visibility. | Pass 5 | Ensures remote telemetry continues to log failure metrics. |
| **4** | **M-2**: Retry P1 OFF commands up to 3 times. | Pass 5 | Guarantees low-power power gating remains deterministic. |
| **5** | **F-9**: Defer Notecard outbox trimming on devices with A0602 loop sensors. | Pass 9 | Decouples heavy I2C bus traffic from expansion reads. |
| **6** | **F-6**: Skip setpoint gap register `0x0034` by explicit addressing. | Pass 3 | Ensures best-effort chemistry checks never short-circuit the poll. |

---

## Tenth Pass â€” Cross-Pass Reconciliation & External-Grounded RS-485 Correction â€” 2026-06-23

**Reviewer:** GitHub Copilot (AI). After nine passes this document contains **mutually contradictory
conclusions** (pass 4 vs 7 on staging delay; pass 6 vs 4/7/8 on `updateAnalogInputs`; pass 9's new pre-delay
value). A reader can no longer act on it safely. This pass does two things: (1) **reconciles every contested
claim against the actual library source and authoritative external references**, and (2) does the requested
**fresh external research** specifically on the RS-485 timing the last passes introduced.

**Sources consulted this pass (all read directly):**
- **ArduinoRS485** `RS485.cpp` / `RS485.h` (installed): `begin()`, `beginTransmission()`, `endTransmission()`, `setDelays()`, default-delay constants.
- **ArduinoModbus** `libmodbus/modbus-rtu.cpp` (installed): how RTU brackets a transmission.
- **Arduino_Opta_Blueprint** `OptaController.cpp` (installed): `_send()`, `send()`, `wait_for_device_answer()`.
- **Arduino Forum thread 1421875** "Opta RS485 bug: last byte of any frame is modified" â€” the definitive community thread, **the exact one this report cites**.
- **Official Arduino tutorial** "Getting Started with RS-485 on Optaâ„¢" â€” the vendor's own `setDelays()` example.

---

### Part 1 â€” Reconciliation table: the verdict on every contested claim

| Claim | Raised in | Final verdict (this pass) | Decisive evidence |
|---|---|---|---|
| A0602 read needs an `updateAnalogInputs()` / `GET_ALL_ADC (0x0B)` "trigger" | F-2, A-3, **Pass 6** | **REFUTED (final)** | Library `pinCurrent(ch,true)`â†’`getAdc(ch,true)`â†’`GET_ADC (0x0A)`; expansion free-runs ADC. Official `genericAnalog` example reads with `pinCurrent(i)` (single-channel `0x0A`). Production already matches. |
| Production requestâ†’answer **staging delay** (`delay(1)`) is too short; need 2 ms + re-poll | **Pass 4 (N-1)** | **REFUTED â€” I withdraw my own N-1** | `OptaController::_send()` does `endTransmission()`â†’`requestFrom()` with **zero** delay; `OPTA_CONTROLLER_DELAY_AFTER_MSG_SENT (2)` is **not used** in the send path. Expansion stages its reply in the onReceive **ISR**, so it is ready instantly. Production's `delay(1)` is already **more** than the library uses. Pass 7 (G-1) was correct. |
| `setDelays(200, 1200)` â€” raise **pre-delay** to 200 Âµs to stop field "start-bit clipping" | **Pass 9 (F-8)** | **Mechanism real, value wrong, priority too high** | See Part 2. 200 Âµs matches **neither** documented reference (community uses **0**; official tutorial uses **3.5 char-times â‰ˆ 3646 Âµs**). Bench already worked at pre=0 with the same MRC-1. |
| Config-ACK failure must be **fatal** before reading | A-2, G-5, E-1 | **CONFIRMED â€” top firmware item** | Caller still ignores `adcConfigOk==false` ([client .ino L5412](../TankAlarm-112025-Client-BluesOpta/TankAlarm-112025-Client-BluesOpta.ino#L5412)). ACK only means "queued." |
| Reconfigure-once + verify actual function (`GET_CHANNEL_FUNCTION 0x40`) | G-3, E-1 | **CONFIRMED â€” strong** | Library `startUp()` configures once with `delay(50)`/channel; official `getChannelFunction` example polls `isChCurrentAdc(ch,true)`. |
| Framed failures invisible to fleet diagnostics (`gCurrentLoopI2cErrors`) | M-1 | **CONFIRMED** | Counter bumped only in legacy helper; framed path returns silently. |
| 0x000A / 0x0034 "gap register" decouple fixes `scOk:0` | Pass 3 | **REFUTED for `scOk` (final)** | `readRegistersIndividually` fails at `0x0008` first (short-circuit). 0x000A is real "load V" in the verified-live range. (0x0034 cleanup is harmless but cannot affect `scOk`.) |
| Persistent field `scOk:0` is physical (MRC-1 / A-B / power), firmware exhausted | Main report, Pass 4 | **CONFIRMED â€” reinforced** | Production `setDelays(0,1200)` = the community-accepted Opta fix (Part 2). No external project uses the MRC-1 MeterBus bridge, so the bridge remains the unique, code-unvalidatable suspect. |

---

### Part 2 â€” The RS-485 pre-delay, grounded in the actual library + the two authoritative references

Pass 9 introduced `RS485.setDelays(200, 1200)` as a **#2 priority field fix** for `scOk:0`. The mechanism it
cites is real, but the **value and the priority are not supported** by the evidence.

**What the library actually does (`RS485.cpp`, verified):**
```cpp
void RS485Class::beginTransmission() {            // called by ModbusRTU TX (modbus-rtu.cpp L331)
  if (_dePin > -1) { digitalWrite(_dePin, HIGH); if (_predelay) delayMicroseconds(_predelay); }
  _transmisionBegun = true;
}
void RS485Class::endTransmission() {
  _serial->flush();
  if (_dePin > -1) { if (_postdelay) delayMicroseconds(_postdelay); digitalWrite(_dePin, LOW); }
}
```
So `_predelay` is the **DE-assert â†’ first-byte** guard and `_postdelay` is the **last-byte â†’ DE-release** guard.
Confirmed too: ArduinoModbus routes its TX through these (`ctx_rtu->rs485->beginTransmission()/endTransmission()`,
`modbus-rtu.cpp` L330â€“334), so `setDelays()` **does** apply to the SunSaver poll.

**The two authoritative reference values â€” and why 200 Âµs is neither:**

| Source | `setDelays` used | Pre-delay @ 9600 | Rationale |
|---|---|---|---|
| Arduino **Forum 1421875** (the cited thread, accepted solution post #18) | `setDelays(0, postDelay)` | **0** | Author swept post-delay; **800â€“1000 Âµs fixes last-byte corruption**; pre stays 0. Explicitly "not pre-delay." |
| Official **Arduino RS-485 tutorial** | `setDelays(preDelayBR, postDelayBR)` with `bitduration*wordlen*3.5` | **â‰ˆ3646 Âµs** (3.5 char-times) | The Modbus **T3.5** inter-frame silence guard. |
| **Production (current)** | `setDelays(0, 1200)` | **0** | Matches the forum fix; post 1200 Âµs > the ~1146 Âµs one-char time for 8N2. âœ… |
| **Pass 9 proposal** | `setDelays(200, 1200)` | **200** | ~2 bit-times â€” **arbitrary**; the transceiver's own DE-valid time is < 1 Âµs, and 200 Âµs is far below T3.5. |

**Conclusion on F-8:**
1. The bench **already proved pre=0 works with this exact MRC-1** (the document's own April log). A pure
   cable-capacitance explanation is therefore weak â€” capacitance does not change a `3646`-vs-`0` outcome into a
   `200`-vs-`0` one.
2. If a pre-delay experiment is still wanted (field â‰  bench is a legitimate concern), use the **protocol-meaningful
   T3.5 value**, not 200 Âµs. For the production **8N2** framing (11 bits/char): `1/9600 Ã— 11 Ã— 3.5 â‰ˆ 4010 Âµs`
   (use ~4000 Âµs). T3.5 has a real purpose â€” it guarantees the inter-frame silence the SunSaver needs to detect a
   fresh frame â€” whereas 200 Âµs has none.
3. **Do this on the bench first** (`firmware/sunsaver-rs485-windowed-probe`, which already sweeps the pre-delay),
   **not** as a field OTA labeled a "fix." Demote F-8 from #2 to a **diagnostic experiment**, because every prior
   bench result says the TX timing is already correct and the field fault is physical.

**Suggested change (if/when bench-confirmed) â€” note the corrected value and the comment:**
```cpp
// TankAlarm_Solar.cpp begin(), after ModbusRTUClient.begin():
// Post-delay 1200us > one 8N2 char-time (~1146us) â€” fixes the documented Opta last-byte
// corruption (Arduino forum 1421875). Pre-delay normally 0 (bench-proven). Only raise the
// pre-delay to the Modbus T3.5 inter-frame guard (~4000us for 9600 8N2) if a bench sweep with
// the field MRC-1 harness shows the first request byte is being clipped; 200us is not a
// meaningful value for either the transceiver DE-valid time or T3.5.
RS485.setDelays(0, 1200);   // unchanged default; see windowed-probe sketch before changing pre-delay
```

---

### Part 3 â€” What the external research adds (requested comparison)

**RS-485 / Opta (new this pass):**
- The **definitive Opta RS-485 community thread (1421875)** independently re-derives exactly what this project
  already ships: **post-delay â‰ˆ one character time eliminates the corruption; pre-delay 0 is fine.** This is
  strong third-party confirmation that the firmware's TX timing is correct and **not** the `scOk:0` cause.
- The **official Arduino RS-485 example** is the only mainstream source using a non-zero pre-delay, and it uses
  **T3.5 (~3646 Âµs)**, reinforcing that the only defensible non-zero pre-delay is T3.5 â€” never 200 Âµs.

**A0602 / Blueprint (re-confirmed against examples):** the official `genericAnalog` example reads a current-ADC
channel with `aexp.pinCurrent(i)` (default `update=true` â†’ single-channel `GET_ADC 0x0A`), which is **byte-for-byte
the production command**. This is the third independent confirmation that the read protocol is correct and that
the open A0602 issues are config-confirmation, settle/verify, bus hygiene, and diagnostics â€” not the read opcode.

**SunSaver / MeterBus (carry-forward from Pass 8, still decisive):** every public SunSaver project
(`kenrestivo/sunsaver`, `brianfoshee/modbus-redis`, `anschoewe/morningstar-sunsaver-mppt`,
`TheBiggerGuy/restful-sunsaver`) talks to the controller through a **direct USB/serial MeterBus adapter or
TCP**, at 9600 8N2 slave 1 with live registers at `0x0008`. **None use the Morningstar MRC-1 RS-485 bridge** this
field harness depends on. So no online code can validate the MRC-1 path â€” which is exactly why Problem 1 must be
closed on the bench with the field MRC-1, not in firmware. (Arduino also publishes an Opta "tank level
application note" â€” relevant as an architecture reference, but it is a level-sensor demo, not a SunSaver/MRC-1
Modbus example.)

---

### Part 4 â€” Final de-conflicted priority list (supersedes Pass 9's table)

Problem 1 (`scOk:0`) = **physical**; the only firmware item is an optional raw-frame diagnostic. Problem 2 (A0602)
has real, low-risk firmware hardening. Refuted items are struck so they are not re-attempted.

| Pri | Change | Source | Risk | Status |
|---|---|---|---|---|
| **1** | Make config-ACK failure / `GET_CHANNEL_FUNCTION (0x40)` verify **fatal** before any read (P1 off, `NAN`) | A-2 / G-5 / E-1 | Low | **Top firmware fix for Problem 2** |
| **2** | Bench-test **configure-once across P1 cycles**; if config persists, stop per-cycle `SET CH_ADC` (else add 50 ms settle) | G-3 / E-2 | Low (bench-gated) | Removes the riskiest A0602 timing assumption |
| **3** | Feed framed-path failures into `gCurrentLoopI2cErrors` + distinct reason codes | M-1 | Low | Restores fleet diagnostics truthfulness |
| **4** | Drain Wire RX after `trimTelemetryOutbox()`; optionally read A0602 **before** trimming on current-loop devices | A-5 / F-9 | Low | Shared-bus hygiene (Blueprint assumes sole master) |
| **5** | Retry **P1 OFF** Ã—3; validate PWM SET ACK **for observability only** (don't gate the return) | M-2 / A-1 | Low | Deterministic gating + truthful `pg` |
| **6** | `Wire.setTimeout(100)` around A0602 ops; skip setpoint gap `0x0034` | A-4 / A-6 | Very low | Margin + best-effort cleanup |
| **D** | **Diagnostic only:** bench-sweep RS-485 **pre-delay at T3.5 (~4000 Âµs, 8N2)** with the field MRC-1; add a one-shot raw-frame client dump for `0x0008` | Pass 9 (corrected) / Main report | n/a | Characterizes the physical link; **not** a field OTA |
| ~~â€”~~ | ~~Raise staging delay to 2 ms + re-poll (N-1)~~ | Pass 4 | â€” | **Withdrawn** â€” library uses 0 ms; `delay(1)` already sufficient |
| ~~â€”~~ | ~~`setDelays(200, 1200)` as a field fix (F-8)~~ | Pass 9 | â€” | **Dropped** â€” 200 Âµs unsupported; see Part 2 |
| ~~â€”~~ | ~~`updateAnalogInputs()` / `GET_ALL_ADC` trigger; OptaBlue migration for "freshness"~~ | F-2/A-3/Pass 6 | â€” | **Refuted** â€” production read already matches the library |

### Bottom line of the tenth pass

Reading the **actual** RS-485/Modbus/Blueprint source plus the two authoritative Arduino references resolves the
inter-pass contradictions: (a) the A0602 **read opcode is correct** (no trigger needed) â€” confirmed a third way;
(b) the **staging-delay theory (my own N-1) is withdrawn** â€” the library uses no such delay; (c) the **RS-485 TX
timing production ships (`setDelays(0,1200)`) is the community-accepted correct configuration**, so the pass-9
`200 Âµs` pre-delay is not a fix â€” if anything is swept it must be the **T3.5 â‰ˆ 4000 Âµs** value, on the bench. The
genuinely actionable firmware work remains entirely on the A0602 side (config-confirmation fatal-fail, configure-
once/verify, diagnostics, bus hygiene), and **Problem 1 stays physical** because no external project â€” and no
firmware change â€” can substitute for verifying the MRC-1/SunSaver harness on the bench.

## Eleventh Pass - External Pattern Delta (Error Taxonomy + Bounded Retries) - 2026-06-23

**Reviewer:** GitHub Copilot (AI). This pass is intentionally **delta-only** against pass 10.
It does not reopen refuted claims (no `updateAnalogInputs` trigger, no revived staging-delay theory,
no `setDelays(200,1200)` field-fix claim). It adds two practical gaps found while comparing against
external ArduinoModbus and note-arduino transport patterns.

---

### Part 1 - Net-new external comparison points

1. **ArduinoModbus examples consistently expose transport errors via `lastError()`** when
   `requestFrom(...)` fails. The library itself also tracks protocol-level errors internally.
2. **note-arduino I2C transport uses bounded retries and typed error paths** for failed I2C
   send/receive operations (including explicit handling of `endTransmission()` error classes),
   rather than a single attempt with a generic failure.

These two patterns match what this codebase already does well in other places: bounded retries,
typed telemetry, and failure-mode visibility.

---

### Part 2 - New finding E11-1 (Solar Modbus observability gap)

**What is new:**

`readHoldingRegisters()` and `readInputRegisters()` in [TankAlarm-112025-Common/src/TankAlarm_Solar.cpp](../TankAlarm-112025-Common/src/TankAlarm_Solar.cpp#L23)
and [TankAlarm-112025-Common/src/TankAlarm_Solar.cpp](../TankAlarm-112025-Common/src/TankAlarm_Solar.cpp#L43)
return `false` on failure but do not capture `ModbusRTUClient.lastError()` or classify the
failure source.

That means all solar comm failures currently collapse into a single boolean path (`success=false`),
which obscures whether the dominant failure is timeout, CRC/integrity, illegal response, or other
transport-level faults. This is now the biggest missing observability piece on the solar side.

**Why this matters now:**

Pass 10 correctly concludes Problem 1 is physical-first. To close physical faults faster,
we need error taxonomy from field telemetry, not only `scOk`.

**Suggested low-risk patch direction:**

```cpp
// TankAlarm_Solar.cpp (file-local diagnostics)
static uint32_t sSolarModbusFailCount = 0;
static char sSolarModbusLastErr[48] = {0};

static void noteSolarModbusFailure() {
  ++sSolarModbusFailCount;
  const char* err = ModbusRTUClient.lastError();
  if (err && err[0]) {
    // Truncate safely for telemetry-friendly storage
    size_t i = 0;
    while (err[i] && i < sizeof(sSolarModbusLastErr) - 1) {
      sSolarModbusLastErr[i] = err[i];
      ++i;
    }
    sSolarModbusLastErr[i] = '\0';
  }
}

// In readHoldingRegisters/readInputRegisters failure branches:
// noteSolarModbusFailure();
```

Then include compact health fields (for example `sc_errs`, `sc_lerr`) in the existing health/diag note paths,
mirroring the current-loop `i2c_cl_err` style.

---

### Part 3 - New finding E11-2 (A0602 framed path lacks in-function retry envelope)

**What is new:**

Framed A0602 helpers are single-attempt per transaction:

- [TankAlarm-112025-Common/src/TankAlarm_I2C.h](../TankAlarm-112025-Common/src/TankAlarm_I2C.h#L405)
- [TankAlarm-112025-Common/src/TankAlarm_I2C.h](../TankAlarm-112025-Common/src/TankAlarm_I2C.h#L453)

Both return immediate failure on first write NACK/short answer/header/CRC mismatch. While the caller
does multi-sample averaging, there is no **local bounded retry** for the transaction itself.

External comparison shows a stronger baseline pattern: bounded transport retries with strict caps.

**Important scope guard:**

This is **not** a request to re-introduce the withdrawn pass-4 timing theory. Keep pass-10's
timing conclusions unchanged. This is only about retrying explicit transport failures.

**Suggested low-risk patch direction:**

```cpp
// TankAlarm_I2C.h
static inline bool tankalarm_i2cWriteWithRetry(uint8_t i2cAddr, const uint8_t* buf, uint8_t len) {
  const uint8_t kMaxAttempts = 3;  // bounded, deterministic
  for (uint8_t a = 0; a < kMaxAttempts; ++a) {
    Wire.beginTransmission(i2cAddr);
    Wire.write(buf, len);
    if (Wire.endTransmission() == 0) {
      return true;
    }
    if (a + 1 < kMaxAttempts) {
      delay(2);
    }
  }
  return false;
}

// Use for framed SET/GET writes in tankalarm_configureCurrentAdcChannel()
// and tankalarm_readCurrentAdcFramed() before parsing the framed answer.
```

This keeps behavior deterministic (bounded time), improves resilience to transient bus disturbances,
and aligns with the transport-hardening pattern already proven in external libraries.

---

### Part 4 - Eleventh-pass delta priority (additive to pass 10)

| Delta Pri | Item | Why |
|---|---|---|
| **D1** | Add solar Modbus error taxonomy (`lastError()` capture + counters) | Fastest way to sharpen Problem 1 field diagnostics without changing transport behavior. |
| **D2** | Add bounded write-retry wrapper for framed A0602 SET/GET transactions | Reduces transient single-attempt dropouts while preserving pass-10 timing conclusions. |

### Bottom line of the eleventh pass

Pass 10 remains directionally correct: Problem 1 stays physical-first, and the major firmware work is still
on the A0602 hardening path. The two net-new additions here are transport-observability and bounded retry
consistency. They do not contradict prior reconciliations and give better field evidence for the next bench cycle.

---

## Final Recommendation â€” Signed Review with Implementation Code (June 23, 2026)

**Reviewer:** GitHub Copilot, Claude Opus 4.6 (fast mode) (Preview)
**Scope:** Definitive final recommendation after reviewing all eleven prior passes, reading the complete
production source (`TankAlarm_I2C.h`, `TankAlarm_Solar.cpp/.h`, `TankAlarm_Config.h`,
`TankAlarm-112025-Client-BluesOpta.ino`), the Arduino_Opta_Blueprint library source, the ArduinoModbus
`ModbusClient.h` API, and all external comparison research.

This section contains:
1. **What to implement** â€” concrete code changes, ready for review and merge
2. **What NOT to change** â€” things the prior passes got right, or things that are correct as-is
3. **Bench-gated items** â€” changes that need hardware verification before shipping
4. **Signature**

---

### 1. IMPLEMENT â€” A0602 Config-Fatal + Actual-Function Verification

**Priority: Highest. This is the single most impactful firmware change for Problem 2.**

The production code currently treats `tankalarm_configureCurrentAdcChannel()` failure as a non-fatal WARNING
and continues reading. The library source proves the ACK only means "command received and queued" â€” not
"configuration applied." If the ACK itself fails, the channel was never even queued, and all subsequent
reads return stale or zero data. Making this fatal with retry and actual-function verification closes the
most dangerous gap in the A0602 read path.

**File: `TankAlarm-112025-Common/src/TankAlarm_I2C.h`** â€” add after `tankalarm_readCurrentAdcFramed()`:

```cpp
// ============================================================================
// A0602 Channel Function Verification (Blueprint GET_CHANNEL_FUNCTION 0x40)
// ============================================================================

// Blueprint channel function value for current-input with external power.
// From AnalogCommonCfg.h: CH_FUNC_CURRENT_INPUT_EXT_POWER = 0x04.
#define OA_FUNC_CURRENT_INPUT_EXT_POWER 0x04

/**
 * Query the A0602 expansion for the actual configured function of a channel.
 * This mirrors the official library's isChCurrentAdc(ch, true) behavior.
 *
 * @param channel  A0602 channel (0-7)
 * @param i2cAddr  I2C address of the expansion
 * @param functionOut  Receives the reported function byte on success
 * @return true if the query succeeded and the response was valid
 */
static inline bool tankalarm_getChannelFunction(
    uint8_t channel,
    uint8_t i2cAddr,
    uint8_t &functionOut
) {
  if (channel >= 8) return false;

  uint8_t req[5];
  req[0] = 0x02;      // BP_CMD_GET
  req[1] = 0x40;      // ARG_GET_CHANNEL_FUNCTION
  req[2] = 0x01;      // payload length
  req[3] = channel;
  req[4] = tankalarm_optaCrc8(req, 4);

  Wire.beginTransmission(i2cAddr);
  Wire.write(req, 5);
  if (Wire.endTransmission() != 0) return false;

  delay(1);
  const uint8_t ANS_LEN = 6;
  uint8_t got = Wire.requestFrom(i2cAddr, ANS_LEN);
  uint8_t ans[6];
  uint8_t n = 0;
  while (Wire.available() && n < ANS_LEN) { ans[n++] = Wire.read(); }
  while (Wire.available()) { (void)Wire.read(); }

  if (got != ANS_LEN || n != ANS_LEN) return false;
  if (ans[0] != 0x03 || ans[1] != 0x40 || ans[2] != 0x02 || ans[3] != channel) return false;
  if (tankalarm_optaCrc8(ans, 5) != ans[5]) return false;

  functionOut = ans[4];
  return true;
}

/**
 * After sending SET CH_ADC, poll the expansion until it reports the channel
 * is actually configured as current-ADC (function 0x04). This closes the
 * gap between "ACK = queued" and "configuration applied."
 *
 * @param channel   A0602 channel (0-7)
 * @param i2cAddr   I2C address
 * @param timeoutMs Maximum time to wait
 * @return true if the channel reports current-ADC function within the timeout
 */
static inline bool tankalarm_waitChannelCurrentAdc(
    uint8_t channel,
    uint8_t i2cAddr,
    uint32_t timeoutMs
) {
  unsigned long start = millis();
  do {
    uint8_t fn = 0xFF;
    if (tankalarm_getChannelFunction(channel, i2cAddr, fn) &&
        fn == OA_FUNC_CURRENT_INPUT_EXT_POWER) {
      return true;
    }
    delay(5);
  } while ((millis() - start) < timeoutMs);
  return false;
}
```

**File: `TankAlarm-112025-Client-BluesOpta.ino`** â€” replace the existing config block at ~L5412:

```cpp
  // Configure the A0602 channel as a 4-20mA current ADC via the framed Blueprint protocol.
  // Retry up to 3 times, then verify the expansion actually applied the configuration
  // by polling GET_CHANNEL_FUNCTION (0x40). If the channel never becomes current-ADC,
  // abort the read cycle â€” continuing would return stale/zero data from an unconfigured
  // channel cache. (See review passes G-3, G-5, E-1.)
  bool adcConfigOk = false;
  for (uint8_t cfgAttempt = 0; cfgAttempt < 3 && !adcConfigOk; ++cfgAttempt) {
    if (cfgAttempt > 0) delay(10);
    if (tankalarm_configureCurrentAdcChannel((uint8_t)channel, i2cAddr)) {
      // ACK received â€” now wait for the expansion's main loop to actually apply
      // the queued configuration. The vendor library uses 50ms in startUp().
      if (tankalarm_waitChannelCurrentAdc((uint8_t)channel, i2cAddr, 100)) {
        adcConfigOk = true;
      }
    }
  }
  if (!adcConfigOk) {
    Serial.print(F("ERROR: A0602 ch "));
    Serial.print(channel);
    Serial.println(F(" did not become current-ADC after 3 attempts â€” aborting read"));
    gMonitorState[idx].currentSensorMa = 0.0f;
    gMonitorState[idx].sampleReused = true;
    gCurrentLoopI2cErrors++;
    if (cfg.pwmGatingEnabled) {
      (void)tankalarm_setPwm(cfg.pwmGatingChannel, 0, 0, i2cAddr);
    }
    return NAN;
  }
```

This replaces the current:
```cpp
  bool adcConfigOk = tankalarm_configureCurrentAdcChannel((uint8_t)channel, i2cAddr);
  if (!adcConfigOk) {
    Serial.print(F("WARNING: A0602 current-ADC channel config NACK on ch "));
    Serial.println(channel);
  }
  delay(2);
```

---

### 2. IMPLEMENT â€” Framed-Path Failure Accounting

**Priority: High. Without this, field telemetry cannot distinguish A0602 bus failures from protocol failures.**

The framed read functions (`tankalarm_configureCurrentAdcChannel`, `tankalarm_readCurrentAdcFramed`) return
boolean/float failure codes but never increment `gCurrentLoopI2cErrors`. Only the legacy bare-read path
(`tankalarm_readCurrentLoopMilliamps`) feeds that counter. Since production uses the framed path exclusively,
the counter is always 0 â€” a blind spot.

**File: `TankAlarm-112025-Client-BluesOpta.ino`** â€” in `readCurrentLoopSensor()`, after the sample loop
(~L5475), add accounting for framed failures:

```cpp
  // Feed framed-path failures into gCurrentLoopI2cErrors so fleet diagnostics
  // report the true A0602 error rate. The framed functions return -1.0f on any
  // I2C/header/CRC failure but do not increment the shared counter themselves
  // (they are in the header-only common library without access to sketch globals).
  uint8_t failedSamples = numSamples - validSamples;
  if (failedSamples > 0) {
    gCurrentLoopI2cErrors += failedSamples;
  }
```

---

### 3. IMPLEMENT â€” Defer Notecard Trim on Current-Loop Devices

**Priority: Medium. Reduces shared-bus contention risk without resetting the Wire bus.**

`trimTelemetryOutbox()` does heavy I2C traffic (note.changes + N Ã— note.delete) to the Notecard at 0x17
immediately before sensor reads. The Blueprint library assumes sole bus ownership. Moving the trim after
sensor reads on current-loop devices isolates the A0602's timing-sensitive window.

**File: `TankAlarm-112025-Client-BluesOpta.ino`** â€” modify `sampleMonitors()`:

```cpp
static void sampleMonitors() {
  if (isSolarOnlyActive() && !isSensorVoltageGateOpen()) {
    return;
  }

  // On devices with current-loop sensors, defer the Notecard outbox trim until
  // after sensor reads to avoid heavy I2C bus traffic immediately before the
  // timing-sensitive A0602 framed protocol. The Blueprint library was designed
  // for sole bus ownership â€” interleaving Notecard I2C can cause NACKs.
  bool hasCLMonitor = false;
  for (uint8_t i = 0; i < gConfig.monitorCount; ++i) {
    if (gConfig.monitors[i].sensorInterface == SENSOR_CURRENT_LOOP) {
      hasCLMonitor = true;
      break;
    }
  }

  if (!hasCLMonitor) {
    trimTelemetryOutbox();
  }

  // Drain any stale bytes left on the Wire bus from prior operations
  while (Wire.available()) { (void)Wire.read(); }

  for (uint8_t i = 0; i < gConfig.monitorCount; ++i) {
    // ... existing sensor loop unchanged ...
```

And at the end of the function, before the closing brace:

```cpp
  if (hasCLMonitor) {
    trimTelemetryOutbox();
  }
}
```

---

### 4. IMPLEMENT â€” Solar Modbus Error Taxonomy

**Priority: Medium. Sharpens Problem 1 diagnostics for the next bench cycle.**

`readHoldingRegisters()` and `readInputRegisters()` return `false` on failure without capturing
`ModbusRTUClient.lastError()`. This collapses all failures into a single boolean â€” timeout,
CRC error, illegal response, and bus fault are all indistinguishable in telemetry.

**File: `TankAlarm-112025-Common/src/TankAlarm_Solar.cpp`** â€” add file-local diagnostics:

```cpp
// Solar Modbus error accounting for fleet diagnostics
static uint32_t sSolarModbusErrors = 0;
static char     sSolarLastError[32] = {0};

static void recordModbusFailure() {
  ++sSolarModbusErrors;
  const char* err = ModbusRTUClient.lastError();
  if (err && err[0]) {
    strlcpy(sSolarLastError, err, sizeof(sSolarLastError));
  }
}
```

Then in `readHoldingRegisters()` and `readInputRegisters()`, add `recordModbusFailure()` on the
`requestFrom` failure branch:

```cpp
static bool readHoldingRegisters(uint8_t slaveId, uint16_t startAddress, uint8_t count, uint16_t *buffer) {
  if (!ModbusRTUClient.requestFrom(slaveId, HOLDING_REGISTERS, startAddress, count)) {
    recordModbusFailure();
    return false;
  }
  // ... rest unchanged ...
}
```

Add public accessors to `SolarManager` so the client can include these in health/diag notes:

```cpp
// In TankAlarm_Solar.h â€” SolarManager public section:
uint32_t getModbusErrorCount() const { return sSolarModbusErrors; }
const char* getLastModbusError() const { return sSolarLastError; }
void resetModbusErrorCount() { sSolarModbusErrors = 0; sSolarLastError[0] = '\0'; }
```

---

### 5. IMPLEMENT â€” Setpoint Gap Register Fix

**Priority: Low. Prevents a wasted Modbus transaction on reserved register 0x0034.**

The setpoint read starts at `SS_REG_V_REG (0x0033)` and reads 4 contiguous registers: 0x0033, 0x0034,
0x0035, 0x0036. Register 0x0034 is reserved/unused in the SunSaver MPPT register map. Because
`readRegistersIndividually()` short-circuits on first failure, if 0x0034 doesn't respond, the V_float
and V_eq setpoints are never read.

**File: `TankAlarm-112025-Common/src/TankAlarm_Solar.cpp`** â€” in `readRegisters()`, replace the
setpoint block (~L338):

```cpp
  if (success && !nextData.setpointsValid) {
    // Read the three defined setpoint registers individually, skipping the
    // reserved gap at 0x0034. readRegistersIndividually would short-circuit
    // at the gap and never reach V_float / V_eq.
    uint16_t vRegRaw = 0, vFloatRaw = 0, vEqRaw = 0;
    bool spOk = readRegistersWithFallback(
        _config.modbusSlaveId, SS_REG_V_REG, 1, &vRegRaw, _cachedHoldingFC);
#if defined(ARDUINO_OPTA) || defined(ARDUINO_ARCH_MBED)
    TANKALARM_WATCHDOG_KICK(Watchdog::get_instance());
#elif defined(ARDUINO_ARCH_STM32)
    IWatchdog.reload();
#endif
    if (spOk) {
      (void)readRegistersWithFallback(
          _config.modbusSlaveId, SS_REG_V_FLOAT, 1, &vFloatRaw, _cachedHoldingFC);
#if defined(ARDUINO_OPTA) || defined(ARDUINO_ARCH_MBED)
      TANKALARM_WATCHDOG_KICK(Watchdog::get_instance());
#elif defined(ARDUINO_ARCH_STM32)
      IWatchdog.reload();
#endif
      (void)readRegistersWithFallback(
          _config.modbusSlaveId, SS_REG_V_EQ, 1, &vEqRaw, _cachedHoldingFC);
    }
    if (spOk) {
      float vReg   = scaleVoltage(vRegRaw);
      float vFloat = scaleVoltage(vFloatRaw);
      float vEq    = scaleVoltage(vEqRaw);
      if (vReg >= 8.0f && vReg <= 32.0f && vFloat >= 8.0f && vFloat <= 32.0f) {
        nextData.vRegSetpoint   = vReg;
        nextData.vFloatSetpoint = vFloat;
        nextData.vEqSetpoint    = (vEq >= 8.0f && vEq <= 32.0f) ? vEq : 0.0f;
        nextData.setpointsValid = true;
        Serial.print(F("Solar: setpoints read V_reg="));
        Serial.print(vReg, 2);
        Serial.print(F(" V_float="));
        Serial.print(vFloat, 2);
        Serial.print(F(" V_eq="));
        Serial.println(nextData.vEqSetpoint, 2);
      } else {
        Serial.print(F("Solar: setpoint read returned implausible values (V_reg="));
        Serial.print(vReg, 2);
        Serial.println(F(")"));
      }
    }
  }
```

---

### 6. What I Would NOT Change

These items are correct as-is. Prior passes that questioned them were refuted by library source evidence.

| Item | Why it stays | Evidence |
|---|---|---|
| **`tankalarm_readCurrentAdcFramed()` read opcode** (`GET ADC 0x0A`) | Byte-identical to the official library's `getAdc(ch, true)`. The command, header validation, CRC check, channel guard, and `25.0f * raw / 65535.0f` scale are all correct. | `AnalogExpansion.cpp`: `pinCurrent()` â†’ `getAdc()` â†’ same 0x0A command. Official `genericAnalog` example confirms. |
| **`tankalarm_optaCrc8()` implementation** | Standard CRC8 with polynomial 0x07 and init 0x00. Matches the library's `OptaCrc::crc8()`. | Direct byte comparison against `OptaCrc.cpp`. |
| **`RS485.setDelays(0, 1200)`** | The community-accepted fix for Opta last-byte corruption (forum thread 1421875). Pre-delay 0 is correct â€” the bench proved it works with this MRC-1. The only defensible non-zero pre-delay is T3.5 (~4000 Âµs), not 200 Âµs, and only after a bench sweep. | Forum post #18; official Arduino RS-485 tutorial; bench success log from April 2026. |
| **No `updateAnalogInputs()` / `GET_ALL_ADC (0x0B)` call** | Both `GET_ADC (0x0A)` and `GET_ALL_ADC (0x0B)` read from the same `adc[ch].conversion` cache. The expansion free-runs continuous ADC conversion. Adding 0x0B would be wasted bus overhead. | `OptaAnalog.cpp`: `parse_get_adc_value()` and `parse_get_all_adc()` both return `adc[ch].conversion`. Confirmed three ways across passes 4, 7, 8, and 10. |
| **`delay(1)` before `Wire.requestFrom()` in framed functions** | The library uses **0 ms** (response is prepared in the onReceive ISR). Production's 1 ms is already more generous. Increasing it provides no benefit. | `OptaController.cpp`: `_send()` has zero delay. `OPTA_CONTROLLER_DELAY_AFTER_MSG_SENT = 2` is defined but unused. |
| **Power gating sequence** (P1 ON â†’ chunked warmup â†’ configure â†’ priming read â†’ settle â†’ sample Ã— 4 â†’ P1 OFF) | The sequence is structurally sound. PWM ON retry (3Ã—) is already implemented. The warmup chunking with WDT kicks is correct for multi-second waits. | Production code at L5370-5405. |
| **Per-cycle reconfiguration** (keep until bench-verified) | The code comment says "in the power-gated model the channel loses its config when P1 is switched off." This is *probably* wrong (P1 controls the transmitter, not the A0602), but removing it without bench verification risks a regression in the field. The config-fatal + function-verify fix (item 1 above) makes per-cycle reconfiguration **safe** regardless. | See bench-gated items below. |
| **SunSaver firmware** â€” `setDelays`, register map, FC03/FC04 fallback, bounded retry, single-register reads | All of this is correct per external project comparison and the bench log. `scOk:0` is physical. No firmware change will fix it. | Five public SunSaver projects all confirm 9600 8N2, slave 1, registers 0x0008-0x000C. None use MRC-1. |
| **`tankalarm_recoverI2CBus()`** | The SCL-toggle + STOP-condition + Wire.begin() sequence is the standard I2C bus recovery procedure. It is correctly guarded against DFU interference and has WDT kick support. | TankAlarm_I2C.h L68-116. |

---

### 7. Bench-Gated Items (Do NOT Ship Without Hardware Verification)

| Item | Bench test required | If passes | If fails |
|---|---|---|---|
| **Configure-once persistence** | Run 20 P1 ON/OFF cycles with `tankalarm_getChannelFunction()` check after each OFF. Does the A0602 retain current-ADC config? | Remove per-cycle `SET CH_ADC`. Configure once after config load. Reduces I2C transactions by ~5 per sample cycle. | Keep per-cycle config. The config-fatal + function-verify fix (item 1) makes it safe and deterministic. |
| **RS-485 pre-delay T3.5 sweep** | Use `firmware/sunsaver-rs485-windowed-probe` with the field MRC-1 harness. Sweep pre-delay: 0, 1000, 2000, 3000, 4000 Âµs. Record `scOk` at each value. | If T3.5 (4000 Âµs) fixes `scOk:0` on the bench with the field harness, ship `setDelays(4000, 1200)` as an OTA. | `scOk:0` is confirmed physical (wiring/MRC-1/power). Swap A/B on site. |
| **`Wire.setTimeout(100)` around A0602** | Verify on bench that increasing the timeout from 25 ms to 100 ms does not cause WDT starvation during multi-sample cycles. | Ship `I2C_WIRE_TIMEOUT_MS = 100` for A0602 ops (set/restore around the read cycle). | Keep 25 ms. The ISR prepares responses in < 1 ms, so 25 ms is already generous for healthy bus conditions. |

---

### 8. Final Consolidated Priority

This is the definitive, de-conflicted list. It supersedes all prior pass priority tables.

| Pri | Change | File(s) | Risk | Resolves |
|-----|---|---|---|---|
| **1** | Config-fatal + `GET_CHANNEL_FUNCTION` verification (Section 1 above) | `TankAlarm_I2C.h`, client `.ino` | Low | Problem 2: stale/zero reads from unconfigured channel |
| **2** | Framed-path failure accounting (Section 2) | Client `.ino` | Very low | Problem 2: blind diagnostic counter |
| **3** | Defer Notecard trim on current-loop devices (Section 3) | Client `.ino` | Low | Problem 2: shared-bus contention |
| **4** | Solar Modbus error taxonomy (Section 4) | `TankAlarm_Solar.cpp/.h` | Low | Problem 1: indistinguishable failure modes |
| **5** | Setpoint gap register fix (Section 5) | `TankAlarm_Solar.cpp` | Very low | Problem 1 (minor): wasted transaction on 0x0034 |
| **6** | Bench-gated: configure-once test | Bench sketch | n/a | Problem 2: reduce I2C load |
| **7** | Bench-gated: RS-485 pre-delay sweep | Bench sketch | n/a | Problem 1: characterize link |

**Explicitly dropped (do not implement):**

| Item | Why |
|---|-----|
| `updateAnalogInputs()` / `GET_ALL_ADC (0x0B)` trigger | Refuted 4Ã— â€” both paths read the same cache |
| Staging delay increase beyond `delay(1)` | Library uses 0 ms; ISR prepares response instantly |
| `setDelays(200, 1200)` as field OTA | 200 Âµs is not a meaningful value; bench sweep T3.5 first |
| `Wire.end()/Wire.begin()` bus reset between Notecard and A0602 | Too aggressive; deferred trim + drain is safer |
| Full OptaBlue.h migration | Architecturally valid but high-risk refactor; the targeted fixes above close the specific gaps without a rewrite |

---

### 9. Summary

After eleven review passes and extensive source-level analysis of the Arduino_Opta_Blueprint library, the
ArduinoModbus/RS485 stack, and five external SunSaver projects, the conclusion is:

**Problem 1 (SunSaver scOk:0) is physical.** The firmware's RS-485 timing, register map, retry logic, and
Modbus parameters all match community best practices and external projects. The MRC-1 MeterBus bridge is the
unique, code-unvalidatable variable. The only firmware improvement is better diagnostics (`lastError()` capture).

**Problem 2 (A0602 stale/zero reads) has one high-value firmware fix remaining.** The read protocol is correct
(byte-identical to the official library). The root cause is that configuration failure is non-fatal â€” the code
warns and continues reading from an unconfigured channel. Making config failure fatal with actual-function
verification (`GET_CHANNEL_FUNCTION 0x40`) and bounded retry is the single change most likely to resolve the
field symptom. Secondary hardening (deferred trim, failure accounting) reduces the shared-bus exposure that
the Blueprint library was never designed for.

**Problem 3 (stale sensor-fault alarm)** will self-resolve once Problem 2's reads succeed, if the proposed
server-side self-clear logic is implemented.

---

**Signed:**

**GitHub Copilot** â€” Claude Opus 4.6 (fast mode) (Preview)
**Date:** 2026-06-23
**Document version at time of review:** Passes 1â€“11 + this final recommendation
**Firmware version reviewed:** v2.0.44 (server + client)

*This review is complete. Additional reviewers may append their assessments below.*

---

## Final Recommendation â€” GitHub Copilot Review v12.0 â€” 2026-06-23

**Reviewer:** GitHub Copilot  
**Review version:** v12.0  
**Firmware reviewed:** v2.0.44 client/server sources currently on `master`  
**Purpose:** final, de-conflicted recommendation after reading all prior passes, re-checking current source,
and doing the requested external comparison. This section is written so later reviewers can append their own
final reviews below it without needing to re-litigate the intermediate contradictions.

### Executive recommendation

I would **not** spend another field OTA trying to repair the SunSaver `scOk:0` with normal firmware changes.
The current RS-485 driver already has the critical Opta post-delay fix, 9600 8N2, slave 1, FC03/FC04 fallback,
bounded retry, and v2.0.44 single-register reads. External SunSaver projects confirm `0x0008..0x000C` is the
live block and `0x000A` is load voltage, not a gap. Persistent `scOk:0` still points to the physical path:
A/B polarity, MRC-1 power/RJ-11, SunSaver DIP/modbus mode, or a different/dead field unit.

For the A0602 current-loop problem, I **would** ship a narrowly scoped firmware hardening release if hardware
testing is unavailable. The highest-confidence firmware gap is not the read opcode. The `GET ADC (0x0A)` read is
valid and matches the official library's single-channel path. The gap is that production accepts a channel-config
failure as a warning, then reads anyway. I would make configuration and actual-function verification fatal,
account for framed-path failures, retry P1 OFF, and move Notecard outbox trimming away from the immediate
pre-A0602 window.

### Implement first: A0602 actual-function verification and fatal config failure

**Why:** `tankalarm_configureCurrentAdcChannel()` validates the SET ACK, but [the caller](../TankAlarm-112025-Client-BluesOpta/TankAlarm-112025-Client-BluesOpta.ino#L5412) treats failure as non-fatal. The official Blueprint example `getChannelFunction` uses actual hardware function verification (`isChCurrentAdc(ch,true)`) after a channel change. The custom fixed-address equivalent is `GET_CHANNEL_FUNCTION (0x40)`.

**Add to** [TankAlarm_I2C.h](../TankAlarm-112025-Common/src/TankAlarm_I2C.h), after `tankalarm_optaCrc8()` and before the callers that need it:

```cpp
#ifndef TANKALARM_OA_FUNC_CURRENT_INPUT_EXT_POWER
#define TANKALARM_OA_FUNC_CURRENT_INPUT_EXT_POWER 0x04  // CH_FUNC_CURRENT_INPUT_EXT_POWER / CH_CI_EP
#endif

static inline bool tankalarm_getAnalogChannelFunction(uint8_t channel, uint8_t i2cAddr, uint8_t &functionOut) {
  if (channel >= 8) {
    return false;
  }

  uint8_t req[5];
  req[0] = 0x02;     // BP_CMD_GET
  req[1] = 0x40;     // ARG_GET_CHANNEL_FUNCTION
  req[2] = 0x01;     // LEN_GET_CHANNEL_FUNCTION
  req[3] = channel;
  req[4] = tankalarm_optaCrc8(req, 4);

  Wire.beginTransmission(i2cAddr);
  Wire.write(req, sizeof(req));
  if (Wire.endTransmission() != 0) {
    return false;
  }

  uint8_t ans[6];
  uint8_t n = 0;
  delay(1);
  uint8_t got = Wire.requestFrom(i2cAddr, (uint8_t)sizeof(ans));
  while (Wire.available() && n < sizeof(ans)) {
    ans[n++] = Wire.read();
  }
  while (Wire.available()) {
    (void)Wire.read();
  }

  if (got != sizeof(ans) || n != sizeof(ans)) {
    return false;
  }
  if (ans[0] != 0x03 || ans[1] != 0x40 || ans[2] != 0x02 || ans[3] != channel) {
    return false;
  }
  if (tankalarm_optaCrc8(ans, 5) != ans[5]) {
    return false;
  }

  functionOut = ans[4];
  return true;
}

static inline bool tankalarm_waitCurrentAdcFunction(uint8_t channel, uint8_t i2cAddr, uint32_t timeoutMs) {
  unsigned long start = millis();
  do {
    uint8_t functionValue = 0xFF;
    if (tankalarm_getAnalogChannelFunction(channel, i2cAddr, functionValue) &&
        functionValue == TANKALARM_OA_FUNC_CURRENT_INPUT_EXT_POWER) {
      return true;
    }
    delay(5);
  } while ((millis() - start) < timeoutMs);
  return false;
}
```

**Replace the non-fatal config block** in `readCurrentLoopSensor()` with bounded config + actual-function verification:

```cpp
  Wire.setTimeout(100);  // A0602-only tolerance; restore before every return.

  bool adcConfigOk = false;
  for (uint8_t attempt = 0; attempt < 3 && !adcConfigOk; ++attempt) {
    if (attempt > 0) {
      delay(10);
    }
    if (tankalarm_configureCurrentAdcChannel((uint8_t)channel, i2cAddr) &&
        tankalarm_waitCurrentAdcFunction((uint8_t)channel, i2cAddr, 250)) {
      adcConfigOk = true;
    }
  }

  if (!adcConfigOk) {
    Serial.print(F("ERROR: A0602 current-ADC function not active on ch "));
    Serial.println(channel);
    gMonitorState[idx].currentSensorMa = 0.0f;
    gMonitorState[idx].sampleReused = true;
    gCurrentLoopI2cErrors++;
    if (cfg.pwmGatingEnabled) {
      (void)tankalarm_setPwm(cfg.pwmGatingChannel, 0, 0, i2cAddr);
    }
    Wire.setTimeout(I2C_WIRE_TIMEOUT_MS);
    return NAN;
  }
```

Also restore the default timeout before the existing `validSamples == 0`, under-range, and normal return paths.
If the code starts to accumulate many timeout restore sites, use a small local helper rather than leaving any
early return with the 100 ms timeout active.

### Implement second: framed-path failure accounting

> *(Content for this section is defined in the v12.0 body above â€” see "Solar Modbus error taxonomy" and "Framed-path failure accounting" sections.)*

---

## Final Recommendation â€” GitHub Copilot Review v16.0 â€” 2026-06-23

### MRC-1/SunSaver-Focused Analysis (Hardware-Correct Assumption)

**Reviewer:** GitHub Copilot â€” Claude Opus 4.6 (fast mode) (Preview)
**Review version:** v16.0
**Firmware reviewed:** v2.0.44 client/server sources on `master`
**Scope:** Specifically focused on Problem 1 (SunSaver `scOk:0`) under the assumption that the
MRC-1, wiring, polarity, and SunSaver hardware are all correctly configured and match the bench-proven
setup. This review challenges the "it's physical" consensus from all prior passes (v12.0â€“v15.0) by
performing a line-by-line code audit of the production Modbus path vs. the bench-proven path, plus a
deep read of the ArduinoRS485, ArduinoModbus, and libmodbus (Arduino port) library sources.

---

### 1. Executive Summary

After auditing every function in `TankAlarm_Solar.cpp` (L1â€“520), the ArduinoRS485 library (`RS485.cpp`),
the ArduinoModbus library (`ModbusRTUClient.cpp`, `ModbusClient.cpp`), and the libmodbus Arduino port
(`modbus-rtu.cpp`, `modbus.c`), I found **no definitive firmware bug** that would explain persistent
`scOk:0` on correctly-configured hardware. The production Modbus path uses the same library, the same
`requestFrom()` API, the same `setDelays(0, 1200)`, and the same single-register read approach as the
bench-proven `sunsaver-modbus-test.ino`.

However, I identified **ten enumerated differences** between bench and production, **one genuine
library-level gap** (no receive-buffer flush on timeout), and **four recommended firmware changes**
that would either close diagnostic blind spots or eliminate unnecessary Modbus transactions.

If the hardware is truly correct, the most plausible firmware-adjacent explanation for persistent
`scOk:0` is **mbed OS RTOS interference** (interrupt/thread preemption during the RS-485 sendâ†’receive
turnaround) or **field RS-485 bus noise** that exhausts all retry attempts via CRC-triggered flushes.
Neither can be diagnosed without enhanced remote diagnostics or a site visit.

---

### 2. Code Analysis Method

| Source | Lines reviewed | Key functions |
|---|---|---|
| `TankAlarm_Solar.cpp` | L1â€“520 (all) | `readHoldingRegisters`, `readInputRegisters`, `readRegistersWithFallback`, `readRegistersIndividually`, `begin`, `end`, `poll`, `readRegisters`, `scaleVoltage`, `scaleCurrent`, `updateHealthStatus` |
| `TankAlarm_Solar.h` | L1â€“260 (all) | Register defines, scaling constants, config defaults, charge states |
| Client `.ino` | L1620â€“1660, L2020â€“2070, L2996â€“3070, L4240â€“4310, L4640â€“4730 | Solar init, poll, sanitize, DFU suspend/resume, config update reinit |
| `firmware/sunsaver-modbus-test/` | Full sketch (200 lines) | Bench-proven single-register FC03 reads |
| `firmware/sunsaver-rs485-raw/` | Key sections (150 lines) | Raw RS-485 probe with explicit `flush()` + `delay(1)` |
| ArduinoRS485 `RS485.cpp` (GitHub master) | Full file | `begin`, `endTransmission`, `beginTransmission`, `setDelays`, `flush`, `receive`, `noReceive` |
| ArduinoModbus `ModbusRTUClient.cpp` | Full file | `begin` â€” calls `setDelays(preDelay, postDelay)` before `modbus_new_rtu` |
| ArduinoModbus `ModbusClient.cpp` | Full file | `begin` â€” enables `MODBUS_ERROR_RECOVERY_PROTOCOL` |
| libmodbus `modbus-rtu.cpp` (Arduino port) | Full file | `_modbus_rtu_send`, `_modbus_rtu_recv`, `_modbus_rtu_select`, `_modbus_rtu_flush`, `_modbus_rtu_close` |
| libmodbus `modbus.c` (Arduino port) | Full file | `send_msg`, `_modbus_receive_msg`, `check_confirmation`, `read_registers`, `modbus_flush`, `_modbus_init_common` |

---

### 3. Key Findings

#### Finding 1: `setDelays(0, 1200)` is correctly applied in ALL code paths

`ModbusRTUClient.begin(9600, SERIAL_8N2)` internally calls:
```
_rs485->setDelays(ModbusRTUDelay::preDelay(9600), ModbusRTUDelay::postDelay(9600))
```
which computes to `setDelays(3500, 3500)` (T3.5 Modbus inter-frame gap â‰ˆ 3500 Âµs at 9600 baud).

Then `RS485.begin(9600, SERIAL_8N2)` is called inside `modbus_connect()`. The RS485 library has a guard:
```cpp
_predelay = _predelay == 0 ? predelay : _predelay;   // preserves 3500
_postdelay = _postdelay == 0 ? postdelay : _postdelay; // preserves 3500
```

Production then overrides: `RS485.setDelays(0, 1200)` â€” setting `_predelay=0`, `_postdelay=1200`.

I traced all three `begin()` call sites:
- **Initial setup** (L170): `begin()` â†’ library sets 3500/3500 â†’ production sets 0/1200 â†’ **correct**
- **DFU resume** (L4295): `end()` â†’ `begin()` â†’ same path â†’ **correct**
- **Config update** (L4703â€“4704): `end()` â†’ `begin()` â†’ same path â†’ **correct**

The startup probe and initial `readRegisters()` both execute AFTER `setDelays(0, 1200)`. No bug.

#### Finding 2: `endTransmission()` properly handles TX flush and post-delay

```cpp
void RS485Class::endTransmission() {
  _serial->flush();                              // 1. Wait for TX shift register to empty
  if (_dePin > -1) {
    if (_postdelay) delayMicroseconds(_postdelay); // 2. Wait 1200 Âµs
    digitalWrite(_dePin, LOW);                     // 3. Deassert DE
  }
  _transmisionBegun = false;
}
```

At 9600 baud 8N2, one character = 11 bits = 1146 Âµs. The 1200 Âµs post-delay covers a full character
time after `flush()`. The raw bench test (`sunsaver-rs485-raw`) adds an explicit `flush()` + `delay(1)`
before `endTransmission()`, but that's redundant â€” the library's `endTransmission()` already calls
`flush()` internally. No bug.

#### Finding 3: Library enables `MODBUS_ERROR_RECOVERY_PROTOCOL` but NOT `LINK`

In `ModbusClient::begin()`:
```cpp
modbus_set_error_recovery(_mb, MODBUS_ERROR_RECOVERY_PROTOCOL);
```

This enables receive-buffer flush (`modbus_flush()` â†’ `_modbus_rtu_flush()`) on:
- CRC mismatch (`_modbus_rtu_check_integrity`)
- Function code mismatch (`check_confirmation`)
- Response length mismatch (`check_confirmation`)

But does **NOT** flush on:
- Timeout (`ETIMEDOUT` in `_modbus_rtu_select`) â€” requires `MODBUS_ERROR_RECOVERY_LINK` flag

The Arduino `_modbus_rtu_flush()` implementation correctly drains the buffer:
```cpp
while (ctx_rtu->rs485->available()) {
    ctx_rtu->rs485->read();
}
```

**Impact:** If a slave response arrives JUST after the timeout expires (between `select()` timeout and
the next `noReceive()` call in `_modbus_rtu_send()`), the stale bytes persist in the UART buffer. On
the next transaction, these stale bytes would be parsed as the new response. If they pass CRC and FC
checks (same slave ID, same FC, valid CRC), they would cause **silent data corruption** â€” the caller
receives the WRONG register value.

**Practical likelihood:** Very low. Requires the slave to respond within microseconds after a 1000 ms
timeout. And the CRC of the stale response must match. But in a noisy RS-485 environment, noise bytes
that fail CRC would trigger protocol-recovery flushes, consuming timeout budget across all retries.

#### Finding 4: Production reads register 0x000A but never uses it

Bench test reads: `0x0008, 0x0009, 0x000B, 0x000C` (4 registers, skips 0x000A).
Production reads: `0x0008, 0x0009, 0x000A, 0x000B, 0x000C` (5 contiguous, includes 0x000A).

`realtimeRegs[2]` (0x000A = load voltage) is populated but never referenced:
```cpp
float battV = scaleVoltage(realtimeRegs[0]);  // 0x0008
float arrV  = scaleVoltage(realtimeRegs[1]);  // 0x0009
float chgI  = scaleCurrent(realtimeRegs[3]);  // 0x000B  â† skips [2]
float lodI  = scaleCurrent(realtimeRegs[4]);  // 0x000C
```

One wasted Modbus round-trip per poll (~50â€“100 ms at 9600 baud).

#### Finding 5: Setpoint block reads gap register 0x0034

```cpp
readRegistersIndividually(slaveId, SS_REG_V_REG, 4, setpointRegs, _cachedHoldingFC)
```
Reads: 0x0033, 0x0034, 0x0035, 0x0036. Register 0x0034 is inconsistently documented ("Ah_daily" in the
header, "sweep_vmp" in the raw probe). The value is stored in `setpointRegs[1]` but never used.

Additionally, if 0x0034 fails with the cached FC, `_cachedHoldingFC` is cleared to 0. The next register
read (0x0035) tries both FCs, adding one extra transaction. This is self-correcting but represents
FC-cache perturbation from a wasted register.

#### Finding 6: No `lastError()` capture in production

The bench test captures diagnostics:
```cpp
Serial.print(F("  Last Modbus error: "));
Serial.println(ModbusRTUClient.lastError());
```

Production does not. When reads fail, the error reason (timeout, CRC, illegal function, illegal address)
is lost. This is the single biggest diagnostic blind spot for Problem 1.

---

### 4. All Differences Between Bench Test and Production

| # | Bench (`sunsaver-modbus-test`) | Production (`TankAlarm_Solar.cpp`) | Impact |
|---|---|---|---|
| 1 | FC03 (HOLDING_REGISTERS) only | FC03â†”FC04 fallback with shared `_cachedHoldingFC` cache | Extra transactions on cache miss |
| 2 | Timeout 500 ms | Timeout 1000 ms (configurable) | Longer blocking on dead bus |
| 3 | Does NOT read 0x000A | Reads 0x000A (unused) | +1 transaction per poll |
| 4 | No concurrent I2C/Ethernet/RTOS activity | Notecard I2C, Ethernet, mbed OS threads | Potential RTOS preemption |
| 5 | No retry logic | 3 attempts with 100 ms delay | More resilient but longer blocking |
| 6 | No WDT kicks | WDT kick between each register | Negligible overhead |
| 7 | Captures `lastError()` | Does NOT capture `lastError()` | Diagnostic blind spot |
| 8 | 3000 ms poll interval | 60+ s poll interval | More time for bus noise accumulation |
| 9 | No setpoint reads | Reads setpoints once (with gap register) | +4 transactions (one wasted) |
| 10 | Reads 8 individual registers per poll | Reads 5 individual registers per poll | Production actually does FEWER reads per poll |

None of these differences constitute a bug. Differences 1, 3, and 9 add unnecessary Modbus transactions.
Difference 7 is a diagnostic gap. Difference 4 is the only one that could cause intermittent failures
on correct hardware, but it cannot be tested without instrumenting the RS-485 timing.

---

### 5. Recommended Changes

#### Priority 1 â€” Add `lastError()` diagnostic capture (LOW RISK)

**Why:** This is the single highest-value change for diagnosing `scOk:0`. Without it, we cannot
distinguish between timeout (slave not responding), CRC error (wire noise), illegal function (FC
mismatch), or illegal address (wrong register map).

```cpp
static bool readHoldingRegisters(uint8_t slaveId, uint16_t startAddress,
                                  uint8_t count, uint16_t *buffer) {
  if (!ModbusRTUClient.requestFrom(slaveId, HOLDING_REGISTERS, startAddress, count)) {
    // NEW: capture the specific error for diagnostics
    const char *err = ModbusRTUClient.lastError();
    Serial.print(F("Solar: FC03 0x"));
    Serial.print(startAddress, HEX);
    Serial.print(F(" fail: "));
    Serial.println(err ? err : F("unknown"));
    return false;
  }
  // ... rest unchanged ...
}
```

Apply the same pattern to `readInputRegisters()`. The `lastError()` strings come from `modbus_strerror(errno)`
and include: "Connection timed out", "Invalid CRC", "Illegal function", "Illegal data address",
"Slave device or server failure", "Response not from requested slave".

For field telemetry, consider adding the last error string to the solar status note sent to the server.

#### Priority 2 â€” Fix setpoint gap register 0x0034 (VERY LOW RISK)

Replace the contiguous 4-register read with targeted reads of the 3 actually-used setpoint registers:

```cpp
// BEFORE: reads 4 contiguous from 0x0033 (includes gap at 0x0034)
// readRegistersIndividually(slaveId, SS_REG_V_REG, 4, setpointRegs, _cachedHoldingFC)

// AFTER: read only the 3 registers we actually use
static const uint16_t kSetpointAddrs[] = { SS_REG_V_REG, SS_REG_V_FLOAT, SS_REG_V_EQ };
uint16_t setpointRegs[3];
bool setpointOk = true;
for (uint8_t i = 0; i < 3 && setpointOk; ++i) {
  TANKALARM_WATCHDOG_KICK(Watchdog::get_instance());
  if (!readRegistersWithFallback(_config.modbusSlaveId, kSetpointAddrs[i], 1,
                                  &setpointRegs[i], _cachedHoldingFC)) {
    setpointOk = false;
  }
}
if (setpointOk) {
  float vReg   = scaleVoltage(setpointRegs[0]);  // 0x0033
  float vFloat = scaleVoltage(setpointRegs[1]);  // 0x0035
  float vEq    = scaleVoltage(setpointRegs[2]);  // 0x0036
  // ... plausibility check unchanged ...
}
```

Eliminates one wasted transaction and prevents FC-cache perturbation from the gap register.

#### Priority 3 â€” Add Modbus response time to solar telemetry (LOW RISK)

This is the most informative diagnostic for the "hardware correct but failing" hypothesis:

```cpp
static bool readHoldingRegisters(uint8_t slaveId, uint16_t startAddress,
                                  uint8_t count, uint16_t *buffer) {
  unsigned long t0 = millis();
  bool ok = ModbusRTUClient.requestFrom(slaveId, HOLDING_REGISTERS, startAddress, count);
  unsigned long elapsed = millis() - t0;

  if (!ok) {
    const char *err = ModbusRTUClient.lastError();
    Serial.print(F("Solar: FC03 0x"));
    Serial.print(startAddress, HEX);
    Serial.print(F(" fail ("));
    Serial.print(elapsed);
    Serial.print(F("ms): "));
    Serial.println(err ? err : F("unknown"));
    return false;
  }

  // On success, log response time for the first register only (avoid log spam)
  if (startAddress == SS_REG_BATTERY_VOLTAGE) {
    Serial.print(F("Solar: FC03 response "));
    Serial.print(elapsed);
    Serial.println(F("ms"));
  }
  // ... rest unchanged ...
}
```

If the bench shows ~50 ms response time and the field shows ~900 ms (near timeout), that points to
wire/bus issues. If the field shows ~50 ms on success but intermittent timeouts at 1000 ms, that points
to the MRC-1 occasionally not responding at all.

#### Priority 4 â€” Skip unused load voltage register 0x000A (OPTIONAL, VERY LOW RISK)

Match the bench test's register set exactly:

```cpp
// BEFORE: 5 contiguous registers (0x0008â€“0x000C, includes unused 0x000A)
// readRegistersIndividually(slaveId, SS_REG_BATTERY_VOLTAGE, 5, realtimeRegs, ...)

// AFTER: read only the 4 registers the bench test reads and production uses
static const uint16_t kRealtimeAddrs[] = {
  SS_REG_BATTERY_VOLTAGE,  // 0x0008
  SS_REG_ARRAY_VOLTAGE,    // 0x0009
  SS_REG_CHARGE_CURRENT,   // 0x000B
  SS_REG_LOAD_CURRENT      // 0x000C
};
uint16_t realtimeRegs[4];
bool allOk = true;
for (uint8_t i = 0; i < 4 && allOk; ++i) {
  TANKALARM_WATCHDOG_KICK(Watchdog::get_instance());
  if (!readRegistersWithFallback(_config.modbusSlaveId, kRealtimeAddrs[i], 1,
                                  &realtimeRegs[i], _cachedHoldingFC)) {
    allOk = false;
  }
}
if (allOk) {
  float battV = scaleVoltage(realtimeRegs[0]);  // 0x0008
  float arrV  = scaleVoltage(realtimeRegs[1]);  // 0x0009
  float chgI  = scaleCurrent(realtimeRegs[2]);  // 0x000B
  float lodI  = scaleCurrent(realtimeRegs[3]);  // 0x000C
```

Eliminates one Modbus round-trip per poll and makes the production register set byte-identical to the
bench test. This change needs to be wrapped in the existing retry loop.

---

### 6. Other Changes Worth Considering

1. **Remote Modbus diagnostic probe** â€” A one-shot diagnostic (triggered by Notecard environment variable
   or `note.add` command) that reads every known SunSaver register individually, logs success/failure
   with `lastError()` and response time for each, and reports the results via a Notecard note. This would
   let you remotely characterize the link without a site visit.

2. **Log `_cachedHoldingFC` in solar telemetry** â€” If the FC cache is stuck at 0 (uncached) or flipping
   between 3 and 4, that reveals a pattern. Add it to the solar status note: `"cachedFC":3`.

3. **Make FC fallback configurable** â€” Add a `modbusUseFC03Only` boolean to `SolarConfig`. When true,
   skip the FC04 fallback entirely (matching the bench test). This eliminates the FC cache complexity
   and halves the timeout on a dead-bus failure (one FC attempt instead of two).

4. **Add `MODBUS_ERROR_RECOVERY_LINK` to `modbus_set_error_recovery()`** â€” This would cause the library
   to call `modbus_flush()` on timeout, draining any stale bytes. However, this changes the library's
   error recovery behavior and should be bench-tested first. The simplest approach is a one-line change
   in production code after `begin()`:
   ```cpp
   // Enable full error recovery (protocol + link) for stale-byte protection
   // modbus_set_error_recovery(_mb, (modbus_error_recovery_mode)
   //   (MODBUS_ERROR_RECOVERY_PROTOCOL | MODBUS_ERROR_RECOVERY_LINK));
   ```
   This requires accessing the private `_mb` member of `ModbusClient`, which would need a library
   modification or a friend declaration. Not worth the complexity for a marginal improvement.

5. **Application-level receive buffer drain** â€” A simpler alternative to #4:
   ```cpp
   // Drain stale bytes before each Modbus transaction
   while (RS485.available()) { RS485.read(); }
   if (!ModbusRTUClient.requestFrom(...)) { ... }
   ```
   This is safe because it runs BEFORE `requestFrom()` sends anything, so no legitimate response bytes
   exist yet. Belt-and-suspenders defense against noise-injected stale bytes.

---

### 7. What NOT to Change

| Item | Why it stays |
|---|---|
| `RS485.setDelays(0, 1200)` | Verified correct in all code paths. The 1200 Âµs post-delay covers one full character time at 9600 8N2. The 0 Âµs pre-delay is bench-proven. |
| `SERIAL_8N2` | Correct per SunSaver/MRC-1 spec and bench verification. |
| Single-register reads (`readRegistersIndividually`) | Bench-proven approach. Multi-register block reads are not reliably bridged by the MRC-1. |
| `SOLAR_RETRY_DELAY_MS = 100` | Reasonable settle time for MRC-1 turnaround. The MRC-1 translates Modbusâ†’MeterBus, so it needs processing time between requests. |
| FC03â†”FC04 fallback (keep, but consider making configurable) | Generic Modbus device support. The SunSaver works with FC03, but other chargers might use FC04. Making it configurable (item 3 above) is preferable to removing it. |
| `ModbusRTUClient.setTimeout(1000)` | More generous than bench (500 ms). Reducing to 500 ms would match the bench but risks timeouts if the MRC-1 is slower in the field (longer cable, bus contention). Keep at 1000 ms. |

---

### 8. Final Assessment: If Hardware IS Correct, What Explains `scOk:0`?

Given that the production Modbus path is functionally identical to the bench-proven path (same library,
same API, same delays, same single-register reads), and no code bug was found, the remaining firmware-
adjacent explanations are:

1. **mbed OS RTOS thread preemption during RS-485 turnaround.** The Opta runs mbed OS with Ethernet
   and Notecard threads. If a higher-priority thread preempts the main loop between `endTransmission()`
   (DE deassert) and `receive()` (RE enable), there's a window where incoming bytes could be missed.
   This is speculative and requires timing instrumentation to confirm.

2. **Field RS-485 bus noise exhausting retries.** If the RS-485 cable picks up EMI (from solar inverter
   switching, long unshielded runs, or ground loops), noise bytes could trigger CRC-error flushes that
   consume the retry budget. The library's `MODBUS_ERROR_RECOVERY_PROTOCOL` handles this by flushing,
   but each CRC error costs one full timeout cycle. With 3 retries Ã— 2 FC attempts Ã— 1000 ms timeout =
   up to 6 seconds of CRC-triggered blocking per poll.

3. **Configuration drift.** If the field device's `solarCharger` config was modified via OTA (different
   baud rate, slave ID, or timeout), the config might not match the bench setup. Verify by reading the
   Notecard environment variable or the saved config JSON on the flash filesystem.

None of these can be diagnosed without either the `lastError()` capture (Priority 1) or a site visit.

**Bottom line:** I cannot find a firmware bug that would cause persistent `scOk:0` on correctly-configured
hardware. The recommended changes (Priorities 1â€“4) are all incremental improvements that narrow the
diagnostic gap and reduce unnecessary Modbus traffic. They are worth shipping in the next firmware
release regardless of whether they fix `scOk:0`, because they make the SunSaver integration more
robust and more observable.

---

**Signed:**

**GitHub Copilot** â€” Claude Opus 4.6 (fast mode) (Preview)
**Date:** 2026-06-23
**Document version at time of review:** 3359 lines (all prior passes + v12.0 recommendation)
**Firmware version reviewed:** v2.0.44 (server + client)
**Library sources reviewed:** ArduinoRS485 (master), ArduinoModbus (master), libmodbus Arduino port (master)
**Analysis depth:** Full line-by-line audit of production Solar code + library source-level tracing of
`ModbusRTUClient.begin()` â†’ `setDelays()` â†’ `RS485.begin()` â†’ `_modbus_rtu_send()` â†’ `endTransmission()`
â†’ `flush()` â†’ `delayMicroseconds()` â†’ `_modbus_rtu_select()` â†’ `_modbus_rtu_recv()` â†’ `readBytes()` â†’
`_modbus_rtu_check_integrity()` â†’ `check_confirmation()` â†’ `modbus_flush()` â†’ `_modbus_rtu_flush()`.

*This review is complete. Additional reviewers may append their assessments below.*

**Why:** `gCurrentLoopI2cErrors` is still fed mainly by the legacy raw helper, while production now uses the
framed helpers. That makes the existing daily alarm and health/diag counters under-report the exact failure we
need to see.

**Minimal change inside `readCurrentLoopSensor()`:**

```cpp
  uint8_t failedFramedSamples = 0;
  for (uint8_t s = 0; s < numSamples; ++s) {
    float sample = tankalarm_readCurrentAdcFramed((uint8_t)channel, i2cAddr);
    if (sample >= 0.0f) {
      total += sample;
      validSamples++;
    } else {
      failedFramedSamples++;
    }
    // existing delay/WDT block remains
  }

  if (failedFramedSamples > 0) {
    gCurrentLoopI2cErrors += failedFramedSamples;
  }
```

If space allows, I would add a tiny reason-code enum later (`write-nack`, `short-read`, `bad-header`, `bad-crc`,
`wrong-channel`), but the counter alone is the first useful field signal.

### Implement third: P1 OFF retry

**Why:** P1 ON already retries; P1 OFF is single-shot. On a solar site, failing OFF can leave the transmitter
powered and distort both power budget and future observations.

```cpp
  if (cfg.pwmGatingEnabled) {
    bool pwmOffSuccess = false;
    for (uint8_t attempt = 0; attempt < 3 && !pwmOffSuccess; ++attempt) {
      if (attempt > 0) {
        delay(5);
      }
      pwmOffSuccess = tankalarm_setPwm(cfg.pwmGatingChannel, 0, 0, i2cAddr);
    }
    if (!pwmOffSuccess) {
      Serial.print(F("WARNING: Failed to disable sensor power gating on P"));
      Serial.print(cfg.pwmGatingChannel + 1);
      Serial.println(F(" via I2C"));
      gCurrentLoopI2cErrors++;
    }
  }
```

### Implement fourth: move Notecard trimming away from A0602 reads

**Why:** `trimTelemetryOutbox()` can do multiple Notecard I2C transactions immediately before A0602 reads. I would
not reset the whole `Wire` bus as a first patch. I would defer trimming on current-loop devices and drain RX.

```cpp
static bool hasCurrentLoopMonitor() {
  for (uint8_t index = 0; index < gConfig.monitorCount; ++index) {
    if (gConfig.monitors[index].sensorInterface == SENSOR_CURRENT_LOOP) {
      return true;
    }
  }
  return false;
}

static void sampleMonitors() {
  if (isSolarOnlyActive() && !isSensorVoltageGateOpen()) {
    return;
  }

  const bool deferOutboxTrim = hasCurrentLoopMonitor();
  if (!deferOutboxTrim) {
    trimTelemetryOutbox();
  }
  while (Wire.available()) {
    (void)Wire.read();
  }

  for (uint8_t i = 0; i < gConfig.monitorCount; ++i) {
    // existing sensor loop unchanged
  }

  if (deferOutboxTrim) {
    trimTelemetryOutbox();
  }
}
```

### Implement fifth: solar Modbus diagnostics, but do it with compile-safe accessors

**Why:** I do want `lastError()` capture, but the earlier final recommendation's inline header accessors to
`.cpp`-local statics would not compile. Declare methods in the class, define them in the `.cpp`, and keep the
storage file-local or make it private member state.

**Header declaration only:**

```cpp
// TankAlarm_Solar.h, public SolarManager section
uint32_t getModbusErrorCount() const;
const char* getLastModbusError() const;
void resetModbusErrorStats();
```

**Source implementation:**

```cpp
// TankAlarm_Solar.cpp, file scope
static uint32_t sSolarModbusErrorCount = 0;
static char sSolarLastModbusError[32] = {0};

static void noteSolarModbusFailure() {
  ++sSolarModbusErrorCount;
  const char *errorText = ModbusRTUClient.lastError();
  if (!errorText || !errorText[0]) {
    errorText = "unknown";
  }
  size_t index = 0;
  while (errorText[index] && index < sizeof(sSolarLastModbusError) - 1) {
    sSolarLastModbusError[index] = errorText[index];
    ++index;
  }
  sSolarLastModbusError[index] = '\0';
}

uint32_t SolarManager::getModbusErrorCount() const {
  return sSolarModbusErrorCount;
}

const char* SolarManager::getLastModbusError() const {
  return sSolarLastModbusError;
}

void SolarManager::resetModbusErrorStats() {
  sSolarModbusErrorCount = 0;
  sSolarLastModbusError[0] = '\0';
}
```

Call `noteSolarModbusFailure()` in the `requestFrom(...)` failure branches of `readHoldingRegisters()` and
`readInputRegisters()`. If you later publish the fields, keep them compact (`sc_errs`, `sc_lerr`) and only in
health/diag or daily failure blocks, not every normal telemetry note.

### Implement sixth: setpoint gap cleanup, not a voltage fix

This is safe and tidy, but it will not move `scOk` from 0 to 1. It only prevents best-effort chemistry checking
from depending on `0x0034`.

```cpp
  if (success && !nextData.setpointsValid) {
    uint16_t vRegRaw = 0;
    uint16_t vFloatRaw = 0;
    uint16_t vEqRaw = 0;

    bool setpointsOk = readRegistersWithFallback(_config.modbusSlaveId, SS_REG_V_REG, 1, &vRegRaw, _cachedHoldingFC);
    if (setpointsOk) {
      setpointsOk = readRegistersWithFallback(_config.modbusSlaveId, SS_REG_V_FLOAT, 1, &vFloatRaw, _cachedHoldingFC);
    }
    if (setpointsOk) {
      setpointsOk = readRegistersWithFallback(_config.modbusSlaveId, SS_REG_V_EQ, 1, &vEqRaw, _cachedHoldingFC);
    }

    if (setpointsOk) {
      float vReg = scaleVoltage(vRegRaw);
      float vFloat = scaleVoltage(vFloatRaw);
      float vEq = scaleVoltage(vEqRaw);
      // existing plausibility and assignment block
    }
  }
```

### What I would not change

| Do not change | Reason |
|---|---|
| `tankalarm_readCurrentAdcFramed()` using `GET ADC (0x0A)` | It matches the official `pinCurrent(ch,true)` path. Do not add `GET_ALL_ADC` as a required trigger. |
| `delay(1)` before A0602 `requestFrom()` | The official controller uses zero delay; the withdrawn staging-delay theory should stay withdrawn. |
| `RS485.setDelays(0, 1200)` as a normal field OTA | This is the forum-proven Opta last-byte fix. A non-zero pre-delay should only be a bench diagnostic, and if tested it should be T3.5-scale, not 200 us. |
| SunSaver realtime register path `0x0008..0x000C` | External projects confirm it. `0x000A` is load voltage, not a gap. |
| Full `OptaBlue.h` migration as the first fix | Architecturally valid, but too broad for the current failure. Targeted custom-path fixes are lower risk. |
| `Wire.end()/Wire.begin()` reset between Notecard and A0602 as the first bus fix | Too disruptive. Defer trim and drain first; only reset the bus if logs prove wedging. |
| Removing per-cycle A0602 config without a bench test | Likely safe, but not proven on this harness. Verify P1 cycles preserve config first. |

### If hardware testing is unavailable

If I had to ship a best-guess firmware fix without bench access, I would ship **client-only A0602 hardening** and
avoid solar transport changes:

1. Add `GET_CHANNEL_FUNCTION (0x40)` verification with fatal failure before reads.
2. Add framed-path error accounting.
3. Retry P1 OFF.
4. Defer `trimTelemetryOutbox()` until after sampling on current-loop devices.
5. Widen `Wire.setTimeout(100)` only around A0602 operations, restoring it before every return.
6. Leave `GET ADC (0x0A)`, `delay(1)`, and `RS485.setDelays(0,1200)` unchanged.

This best-guess release may not make a physically broken loop produce data, but it should stop silently trusting
an unconfirmed A0602 channel state, improve field diagnostics, and reduce the shared-bus timing pressure. For
the SunSaver voltage issue, without hardware access I would add only a raw-frame diagnostic if bandwidth allows;
I would not claim a firmware fix for `scOk:0`.

### Signature

**Signed:** GitHub Copilot  
**Review version:** v12.0  
**Date:** 2026-06-23  
**Firmware version reviewed:** v2.0.44 client/server  
**Status:** Final recommendation appended for subsequent reviewer addenda.

---

## Final Recommendation â€” GitHub Copilot Review v13.0 â€” 2026-06-23

**Reviewer:** GitHub Copilot  
**Review version:** v13.0  
**Firmware reviewed:** v2.0.44 client/server sources currently on the master branch  
**Purpose:** Final consolidated recommendation following deep-dive audits, external ecosystem comparisons, and library source inspections.

### Executive Summary

After reviewing all eleven prior passes, assessing the codebase, and parsing the [Arduino_Opta_Blueprint](https://github.com/arduino-libraries/Arduino_Opta_Blueprint) and [ArduinoRS485](https://github.com/arduino-libraries/ArduinoRS485) source implementations, here are our definitive, de-conflicted recommendations.

We agree that **Problem 1 (SunSaver `scOk:0`) is primarily a physical cabling/hardware issue** (A/B polarity crossover, MRC-1 MeterBus RJ-11 power, or DIP switch configurations). The existing driver timing (`setDelays(0, 1200)`) is the proven standard to resolve Opta serial corruption.

We have identified **vital firmware improvements for Problem 2 (A0602 Current Loop)** that significantly reduce shared-bus contention, stabilize configuration states, and restore complete fleet diagnostics.

---

### Best Guess Fixes (Assuming Hardware Testing is Unavailable)

If the hardware cannot be tested or accessed on the bench, our absolute best-guess corrective firmware patch is detailed below. These targeted, low-risk client modifications should be shipped as a single cellular OTA to field clients:

#### 1. Implement Fatal Channel-Config & Actual-Function Verification
Currently, the client logs a warning on config failure and reads anyway. This can lead to silently reading stale/unconverted data. Instead, explicitly verify that the channel was configured using `GET_CHANNEL_FUNCTION (0x40)` and make configuration failures fatal.

**In [TankAlarm-112025-Common/src/TankAlarm_I2C.h](TankAlarm-112025-Common/src/TankAlarm_I2C.h#L405) (Add raw verification functions):**
```cpp
#ifndef TANKALARM_OA_FUNC_CURRENT_INPUT_EXT_POWER
#define TANKALARM_OA_FUNC_CURRENT_INPUT_EXT_POWER 0x04  // CH_FUNC_CURRENT_INPUT_EXT_POWER
#endif

static inline bool tankalarm_getAnalogChannelFunction(uint8_t channel, uint8_t i2cAddr, uint8_t &functionOut) {
  if (channel >= 8) {
    return false;
  }

  uint8_t req[5];
  req[0] = 0x02;     // BP_CMD_GET
  req[1] = 0x40;     // ARG_GET_CHANNEL_FUNCTION
  req[2] = 0x01;     // LEN_GET_CHANNEL_FUNCTION
  req[3] = channel;
  req[4] = tankalarm_optaCrc8(req, 4);

  Wire.beginTransmission(i2cAddr);
  Wire.write(req, sizeof(req));
  if (Wire.endTransmission() != 0) {
    return false;
  }

  uint8_t ans[6];
  uint8_t n = 0;
  delay(1);
  uint8_t got = Wire.requestFrom(i2cAddr, (uint8_t)sizeof(ans));
  while (Wire.available() && n < sizeof(ans)) {
    ans[n++] = Wire.read();
  }
  while (Wire.available()) {
    (void)Wire.read();
  }

  if (got != sizeof(ans) || n != sizeof(ans)) {
    return false;
  }
  if (ans[0] != 0x03 || ans[1] != 0x40 || ans[2] != 0x02 || ans[3] != channel) {
    return false;
  }
  if (tankalarm_optaCrc8(ans, 5) != ans[5]) {
    return false;
  }

  functionOut = ans[4];
  return true;
}

static inline bool tankalarm_waitCurrentAdcFunction(uint8_t channel, uint8_t i2cAddr, uint32_t timeoutMs) {
  unsigned long start = millis();
  do {
    uint8_t functionValue = 0xFF;
    if (tankalarm_getAnalogChannelFunction(channel, i2cAddr, functionValue) &&
        functionValue == TANKALARM_OA_FUNC_CURRENT_INPUT_EXT_POWER) {
      return true;
    }
    delay(5);
  } while ((millis() - start) < timeoutMs);
  return false;
}
```

**In [TankAlarm-112025-Client-BluesOpta/TankAlarm-112025-Client-BluesOpta.ino](TankAlarm-112025-Client-BluesOpta/TankAlarm-112025-Client-BluesOpta.ino#L5412) (Fatal config handling with widened local timeout):**
```cpp
  Wire.setTimeout(100);  // Settle timeout margin for slow A0602 ADC conversions

  bool adcConfigOk = false;
  for (uint8_t attempt = 0; attempt < 3 && !adcConfigOk; ++attempt) {
    if (attempt > 0) {
      delay(10);
    }
    if (tankalarm_configureCurrentAdcChannel((uint8_t)channel, i2cAddr) &&
        tankalarm_waitCurrentAdcFunction((uint8_t)channel, i2cAddr, 250)) {
      adcConfigOk = true;
    }
  }

  if (!adcConfigOk) {
    Serial.print(F("ERROR: A0602 current-ADC function not active on ch "));
    Serial.println(channel);
    gMonitorState[idx].currentSensorMa = 0.0f;
    gMonitorState[idx].sampleReused = true;
    gCurrentLoopI2cErrors++;
    if (cfg.pwmGatingEnabled) {
      (void)tankalarm_setPwm(cfg.pwmGatingChannel, 0, 0, i2cAddr);
    }
    Wire.setTimeout(I2C_WIRE_TIMEOUT_MS); // Restore global standard timeout
    return NAN;
  }
```
*(Make sure that `Wire.setTimeout(I2C_WIRE_TIMEOUT_MS);` is also called to restore standard timeout margins before any other return exits in `readCurrentLoopSensor()`!)*

#### 2. Implement Framed-Path Failure Accounting (M-1 Fix)
The current framed current-loop paths fail silently without updating the fleet's diagnostic metrics (`gCurrentLoopI2cErrors`), masking faults as "reused only." Incorporate accounting:

**In [TankAlarm-112025-Client-BluesOpta/TankAlarm-112025-Client-BluesOpta.ino](TankAlarm-112025-Client-BluesOpta/TankAlarm-112025-Client-BluesOpta.ino#L5441):**
```cpp
  uint8_t failedFramedSamples = 0;
  for (uint8_t s = 0; s < numSamples; ++s) {
    float sample = tankalarm_readCurrentAdcFramed((uint8_t)channel, i2cAddr);
    if (sample >= 0.0f) {
      total += sample;
      validSamples++;
    } else {
      failedFramedSamples++;
    }
    // Settle delays and watchdog kicks continue as-is...
  }

  if (failedFramedSamples > 0) {
    gCurrentLoopI2cErrors += failedFramedSamples;
  }
```

#### 3. Bounded Power-Gating OFF Retries (M-2 Fix)
Power ON utilizes 3 attempts, whereas Power OFF runs as a single risk-prone write.

**In [TankAlarm-112025-Client-BluesOpta/TankAlarm-112025-Client-BluesOpta.ino](TankAlarm-112025-Client-BluesOpta/TankAlarm-112025-Client-BluesOpta.ino#L5478):**
```cpp
  if (cfg.pwmGatingEnabled) {
    bool pwmOffSuccess = false;
    for (uint8_t attempt = 0; attempt < 3 && !pwmOffSuccess; ++attempt) {
      if (attempt > 0) {
        delay(5);
      }
      pwmOffSuccess = tankalarm_setPwm(cfg.pwmGatingChannel, 0, 0, i2cAddr);
    }
    if (!pwmOffSuccess) {
      Serial.print(F("WARNING: Failed to disable sensor power gating on P"));
      Serial.print(cfg.pwmGatingChannel + 1);
      Serial.println(F(" via I2C"));
      gCurrentLoopI2cErrors++;
    }
  }
```

#### 4. Relocate Outbox Trimming to Decouple Shared-Bus Contention (F-9 Fix)
The Blueprint protocol was designed assuming a single master bus. Trimming cellular outboxes immediately preceding expansion ADCs causes transient crosstalk. Defer trimming on current-loop monitor devices:

**In [TankAlarm-112025-Client-BluesOpta/TankAlarm-112025-Client-BluesOpta.ino](TankAlarm-112025-Client-BluesOpta/TankAlarm-112025-Client-BluesOpta.ino#L5618):**
```cpp
static bool gHasCurrentLoopMonitor = false; // Set this flag in configuration loading

static void sampleMonitors() {
  if (isSolarOnlyActive() && !isSensorVoltageGateOpen()) {
    return;
  }

  const bool deferOutboxTrim = gHasCurrentLoopMonitor;
  if (!deferOutboxTrim) {
    trimTelemetryOutbox();
  }
  while (Wire.available()) {
    (void)Wire.read();
  }

  for (uint8_t i = 0; i < gConfig.monitorCount; ++i) {
    // Standard monitor read logic continues as-is...
  }

  if (deferOutboxTrim) {
    trimTelemetryOutbox();
  }
}
```

---

### What NOT to Change

Through libraries and forum research, several hypotheses from older reviews have been disproven and should **not** be modified:

1. **Do not change the GET ADC opcode or commands:** Our custom `GET_ADC (0x0A)` matches the vendor's main `getAdc()` read path. Implementing `GET_ALL_ADC (0x0B)` or similar "trigger updates" is redundant.
2. **Do not inject a random RS-485 Pre-Delay (like 200 Âµs):** Pre-delay is functionally `0` in almost all Modbus implementations on Opta outside of explicit `T3.5` framing windows (~4000 Âµs).
3. **Do not increase the staging delay:** The A0602's `tx_buffer` is prepared inside the `receive_event()` interrupt service routine on the slave expansion. There is zero processing lag; hence, our existing `delay(1)` is already more generous than the official controller which uses zero delay.
4. **Do not force aggressive bus resets:** Proactively ending and starting `Wire` is disruptive to the Notecard link; soft queue-draining and trimming relocations remain the safer approaches.

---

### Signature

**Signed:** GitHub Copilot  
**Review version:** v13.0  
**Date:** 2026-06-23  
**Firmware version reviewed:** v2.0.44 client/server  

---

## Final Recommendation â€” GitHub Copilot Review v14.0 â€” 2026-06-23

**Reviewer:** GitHub Copilot (Claude Opus 4.8)
**Review version:** v14.0
**Firmware reviewed:** v2.0.44 client/server, current `master` sources on disk
**Scope:** Final recommendation after reading all thirteen prior passes and the v12/v13 signed reviews,
re-reading the current production source, and â€” the part that is new in this pass â€” **verifying the one
assumption that every prior passâ€™s #1 fix depends on but none of them actually checked.**

### 0. The check no prior pass performed â€” and why it changes the confidence level

Every pass from the eighth onward makes the same #1 recommendation: after `SET CH_ADC`, verify the channel with
`GET_CHANNEL_FUNCTION (0x40)` and treat a mismatch as fatal. All of them assumed the â€œcurrent ADCâ€ channel
reports function **`0x04`** (`CH_FUNC_CURRENT_INPUT_EXT_POWER`). **If that constant were wrong, making the check
fatal would reject a correctly-configured channel and turn an intermittent fault into a permanent
`sensor-fault` on every read â€” strictly worse than today.** Before signing off on shipping that as the top fix,
I traced it through the installed library:

1. `AnalogCommonCfg.h` â€” the `CfgFun_t` enum: `CH_FUNC_HIGH_IMPEDENCE=0 â€¦ CH_FUNC_CURRENT_INPUT_EXT_POWER=4,
   CH_FUNC_CURRENT_INPUT_LOOP_POWER=5 â€¦`. So `EXT_POWER` is indeed **4**.
2. `AnalogExpansion.cpp` L1638-1642 â€” `isChCurrentAdc(ch, /*actual_hw=*/true)` returns
   `fun == CH_FUNC_CURRENT_INPUT_EXT_POWER`. The vendorâ€™s own verifier checks **4**.
3. **The decisive step â€” `OptaAnalog.cpp::parse_setup_adc_channel()` L1955-2010.** A `SET CH_ADC` with
   `TYPE == OA_CURRENT_ADC` maps to **two different** functions:
   - `CH_FUNC_CURRENT_INPUT_LOOP_POWER (5)` â€” **only** when `write == false`, i.e. when
     `OA_CH_ADC_ADDING_ADC_POS == OA_ENABLE` (adding an ADC on top of an existing DAC-voltage channel);
   - `CH_FUNC_CURRENT_INPUT_EXT_POWER (4)` â€” the normal `else if (TYPE == OA_CURRENT_ADC)` branch.

   Productionâ€™s [`tankalarm_configureCurrentAdcChannel()`](../TankAlarm-112025-Common/src/TankAlarm_I2C.h) sends
   `OA_CH_ADC_ADDING_ADC_POS = 0x02 (OA_DISABLE)` â†’ `write == true` â†’ the LOOP_POWER branch is **not** taken â†’
   the channel is configured as **`CH_FUNC_CURRENT_INPUT_EXT_POWER (4)`**.

**Conclusion: the `0x04` constant is correct for this firmware, and the fatal `GET_CHANNEL_FUNCTION` verify is
safe to ship.** I also confirmed the helperâ€™s wire format against `OptaAnalogProtocol.h`
(`ARG_GET_CHANNEL_FUNCTION=0x40`, request `[0x02][0x40][0x01][ch][CRC]`, answer
`[0x03][0x40][0x02][ch][fun][CRC]`) and that the helpers are **not yet present** in the repo, and the config
block is **still non-fatal** on disk (client `.ino` ~L5412).

> **One caveat to record for the future:** the `0x04` expectation is coupled to production sending
> `ADDING_ADC = OA_DISABLE`. If anyone ever flips that byte to `OA_ENABLE`, the channel would report `5`
> (`LOOP_POWER`) and the verify constant must change with it. Tie the constant to the config frame, not to a
> magic number floating on its own.

This is the value this pass adds over v12/v13: their code is right, and it is now **proven non-bricking**.

### 1. Implement â€” A0602 config-fatal + actual-function verification (verified safe, ship first)

Add the verifier to [TankAlarm_I2C.h](../TankAlarm-112025-Common/src/TankAlarm_I2C.h). The helper bodies in
the **Pass-8 (E-1)** and **v12/v13** sections are correct as written; the only change I make is to tie the
constant to the config frame and document the coupling:

```cpp
// Must equal the function the expansion reports for the channel after our SET CH_ADC frame.
// Verified against OptaAnalog.cpp::parse_setup_adc_channel(): because
// tankalarm_configureCurrentAdcChannel() sends ADDING_ADC = OA_DISABLE (write==true), the
// expansion assigns CH_FUNC_CURRENT_INPUT_EXT_POWER (=4). If that config byte ever changes to
// OA_ENABLE, the expansion would report CH_FUNC_CURRENT_INPUT_LOOP_POWER (=5) and THIS must change too.
#ifndef TANKALARM_OA_FUNC_CURRENT_INPUT_EXT_POWER
#define TANKALARM_OA_FUNC_CURRENT_INPUT_EXT_POWER 0x04
#endif
// + tankalarm_getAnalogChannelFunction() and tankalarm_waitCurrentAdcFunction() exactly as in E-1.
```

Then make the caller fatal in `readCurrentLoopSensor()` (client `.ino`), replacing the current non-fatal block.
Note the local `Wire.setTimeout(100)` must be restored before **every** return in the function:

```cpp
  Wire.setTimeout(100);                       // A0602-only tolerance; restore before EVERY return.
  bool adcConfigOk = false;
  for (uint8_t attempt = 0; attempt < 3 && !adcConfigOk; ++attempt) {
    if (attempt > 0) delay(10);
    if (tankalarm_configureCurrentAdcChannel((uint8_t)channel, i2cAddr) &&
        tankalarm_waitCurrentAdcFunction((uint8_t)channel, i2cAddr, 100)) {
      adcConfigOk = true;
    }
  }
  if (!adcConfigOk) {
    Serial.print(F("ERROR: A0602 current-ADC channel not confirmed on ch "));
    Serial.println(channel);
    gMonitorState[idx].currentSensorMa = 0.0f;
    gMonitorState[idx].sampleReused = true;
    gCurrentLoopI2cErrors++;                  // make the failure visible (see item 2)
    if (cfg.pwmGatingEnabled) (void)tankalarm_setPwm(cfg.pwmGatingChannel, 0, 0, i2cAddr);
    Wire.setTimeout(I2C_WIRE_TIMEOUT_MS);
    return NAN;
  }
```

Why this is the right first fix: the read opcode is already correct, so the only way a CRC-valid frame can carry
a wrong/stale value is if the channel was never actually configured. The ACK alone does not prove that (it means
â€œqueuedâ€); `GET_CHANNEL_FUNCTION` proves the AD74412R is actually in current-ADC mode before we trust a reading.

### 2. Implement â€” framed-path failure accounting (very low risk)

`gCurrentLoopI2cErrors` is fed only by the legacy raw helper, so the framed production path is invisible to the
existing `i2c-error-rate` / `i2c_cl_err` / diag telemetry. Count one fault per cycle (item 1 already bumps it on
config failure; also bump it when every sample failed) in `readCurrentLoopSensor()`:

```cpp
  if (validSamples == 0) {
    gCurrentLoopI2cErrors++;                  // framed reads all failed this cycle
    gMonitorState[idx].currentSensorMa = 0.0f;
    gMonitorState[idx].sampleReused = true;
    Wire.setTimeout(I2C_WIRE_TIMEOUT_MS);     // restore before this early return too
    return NAN;
  }
```

### 3. Implement â€” P1 OFF retry + defer Notecard trim (low risk)

Mirror the existing 3-attempt P1-ON pattern for P1-OFF, and move `trimTelemetryOutbox()` to **after** sampling on
current-loop devices (with a leading `while (Wire.available()) (void)Wire.read();` drain). Both are exactly as
written in the v12/v13 sections; I have nothing to correct in them.

### 4. Implement â€” solar Modbus error taxonomy (compile-safe form only)

I agree with the v12 correction: do **not** use inline header accessors to `.cpp`-local statics (wonâ€™t compile).
Declare the methods in `TankAlarm_Solar.h`, define them in the `.cpp`, keep the counters file-local, and call
`noteSolarModbusFailure()` (capturing `ModbusRTUClient.lastError()`) in the `requestFrom` failure branches of
`readHoldingRegisters()`/`readInputRegisters()`. This is diagnostics only â€” it will not change `scOk`.

### 5. What I would NOT change

| Do not change | Reason (verified this pass or prior) |
|---|---|
| `GET ADC (0x0A)` read opcode in `tankalarm_readCurrentAdcFramed()` | Byte-identical to the libraryâ€™s `pinCurrent(ch,true)`â†’`getAdc(ch,true)`. Confirmed 4Ã—. |
| Add `updateAnalogInputs()` / `GET_ALL_ADC (0x0B)` â€œtriggerâ€ | Both opcodes read the same free-running `adc[ch].conversion` cache. Refuted. |
| `delay(1)` before A0602 `requestFrom()` | Library uses **0**; the answer is staged in the expansionâ€™s onReceive ISR. `delay(1)` is already generous. |
| `RS485.setDelays(0, 1200)` (pre-delay 0) | The forum-1421875 community fix + bench-proven. A non-zero pre-delay, if ever tested, must be T3.5 (~4000 Âµs @9600 8N2), bench-only â€” never the arbitrary 200 Âµs. |
| SunSaver register map / FC03â†”FC04 / single-register reads / retry | Confirmed by five external SunSaver projects; `0x000A` is load-V inside the live range. `scOk:0` is physical. |
| Remove per-cycle `SET CH_ADC` (without a bench test) | Likely safe, but unproven on this harness. Item 1 makes per-cycle config **safe and self-checking**, so there is no urgency to remove it blind. |
| `Wire.end()/Wire.begin()` reset between Notecard and A0602 | Too disruptive as a first move; deferred-trim + drain is the safer hygiene step. |
| Full `OptaBlue.h` migration | Architecturally valid but a large, risky refactor; items 1-3 close the specific gaps without it. |

### 6. If hardware testing is unavailable â€” my best-guess fix

Ship a **client-only** OTA containing items **1, 2, 3** (config-fatal + function-verify, framed-path accounting,
P1-OFF retry + deferred trim) and the local `Wire.setTimeout(100)`. Leave `0x0A`, `delay(1)`, and
`setDelays(0,1200)` untouched. This is the highest-confidence, lowest-risk change set because:

- It is **provably non-bricking** (Section 0): a correctly-configured channel reports function `4`, so the fatal
  verify passes on healthy hardware and only fails when the channel genuinely is not in current-ADC mode.
- Worst realistic outcome: a sensor that is *already* failing keeps returning `NAN`/`ru:1` (no regression), but now
  the cause is **visible** in `gCurrentLoopI2cErrors` and the serial `ERROR:` line, which is exactly the field
  evidence the next step needs.
- It will *not* manufacture data for a physically broken loop â€” and it should not, because silently trusting an
  unconfirmed channel is how the stale `18.02 mA` reading happened in the first place.

For Problem 1 (`scOk:0`) with no bench access, I would ship **only** the item-4 Modbus error taxonomy plus,
if bandwidth allows, a one-shot raw-frame dump of the `0x0008` request/response. I would **not** claim any
firmware fix for `scOk:0` â€” the evidence says it is the MRC-1/SunSaver physical path, and no code change
substitutes for swapping A/B and confirming MRC-1 power on site.

### 7. Bottom line

The documentâ€™s many passes converged on the right answer; this passâ€™s job was to make the top fix **safe to
ship without a bench**. It is: I verified against the expansion firmware that productionâ€™s configuration frame
yields the exact channel function the proposed verifier checks for, so config-fatal + `GET_CHANNEL_FUNCTION`
verification can go out as a client OTA with confidence. Everything else of value is diagnostics and shared-bus
hygiene. Problem 1 remains physical.

### Signature

**Signed:** GitHub Copilot (Claude Opus 4.8)
**Review version:** v14.0
**Date:** 2026-06-23
**Firmware version reviewed:** v2.0.44 client/server
**Status:** Final recommendation appended; subsequent reviewers may add their assessments below.

---

## Final Recommendation - GitHub Copilot Review v15.0 - 2026-06-23

**Reviewer:** GitHub Copilot (GPT-5.3-Codex)
**Review version:** v15.0
**Firmware reviewed:** v2.0.44 client/server on current `master`
**Intent:** final delta recommendation after refreshing this document through v14.0 and doing one more
external pattern check against ArduinoModbus and note-arduino transport behavior.

### 1. Remaining research delta (what was still worth checking)

This pass re-checked only two unresolved patterns:

1. **Solar Modbus error observability pattern:** ArduinoModbus examples consistently print
   `ModbusRTUClient.lastError()` when `requestFrom(...)` fails.
2. **I2C transport resilience pattern:** note-arduino retries failed I2C transmissions in a bounded way and
   preserves typed failure reasons instead of collapsing everything to one generic failure.

That external pattern still supports the same direction as v14.0:

- For current-loop: verify channel mode before trusting reads, then instrument failures.
- For solar: add typed diagnostics first; do not claim a firmware cure for persistent `scOk:0`.

---

### 2. Final implementation recommendations (ship order)

#### 2.1 Implement first - A0602 actual-function verification + fatal config failure

This remains the highest-value firmware change for Problem 2 because it prevents reading from an
unconfirmed mode after each P1 power cycle.

**Add helpers in [TankAlarm-112025-Common/src/TankAlarm_I2C.h](../TankAlarm-112025-Common/src/TankAlarm_I2C.h):**

```cpp
#ifndef TANKALARM_OA_FUNC_CURRENT_INPUT_EXT_POWER
#define TANKALARM_OA_FUNC_CURRENT_INPUT_EXT_POWER 0x04
#endif

// GET ARG_OA_GET_CHANNEL_FUNCTION (0x40)
// Request: [0x02][0x40][0x01][ch][crc]
// Answer : [0x03][0x40][0x02][ch][fun][crc]
static inline bool tankalarm_getAnalogChannelFunction(uint8_t channel, uint8_t i2cAddr, uint8_t &funOut) {
  uint8_t req[5];
  req[0] = 0x02;
  req[1] = 0x40;
  req[2] = 0x01;
  req[3] = channel;
  req[4] = tankalarm_optaCrc8(req, 4);

  Wire.beginTransmission(i2cAddr);
  Wire.write(req, sizeof(req));
  if (Wire.endTransmission() != 0) {
    return false;
  }

  delay(1);
  uint8_t ans[6];
  uint8_t got = Wire.requestFrom(i2cAddr, (uint8_t)sizeof(ans));
  uint8_t n = 0;
  while (Wire.available() && n < sizeof(ans)) {
    ans[n++] = Wire.read();
  }
  while (Wire.available()) {
    (void)Wire.read();
  }

  if (got != sizeof(ans) || n != sizeof(ans)) {
    return false;
  }
  if (ans[0] != 0x03 || ans[1] != 0x40 || ans[2] != 0x02 || ans[3] != channel) {
    return false;
  }
  if (tankalarm_optaCrc8(ans, 5) != ans[5]) {
    return false;
  }

  funOut = ans[4];
  return true;
}

static inline bool tankalarm_waitCurrentAdcFunction(uint8_t channel, uint8_t i2cAddr, uint16_t timeoutMs = 100) {
  const unsigned long start = millis();
  while ((millis() - start) < timeoutMs) {
    uint8_t fun = 0xFF;
    if (tankalarm_getAnalogChannelFunction(channel, i2cAddr, fun) &&
        fun == TANKALARM_OA_FUNC_CURRENT_INPUT_EXT_POWER) {
      return true;
    }
    delay(5);
  }
  return false;
}
```

**Make the caller fatal in [TankAlarm-112025-Client-BluesOpta/TankAlarm-112025-Client-BluesOpta.ino](../TankAlarm-112025-Client-BluesOpta/TankAlarm-112025-Client-BluesOpta.ino):**

```cpp
Wire.setTimeout(100);

bool adcConfigOk = false;
for (uint8_t attempt = 0; attempt < 3 && !adcConfigOk; ++attempt) {
  if (attempt > 0) {
    delay(10);
  }
  if (tankalarm_configureCurrentAdcChannel((uint8_t)channel, i2cAddr) &&
      tankalarm_waitCurrentAdcFunction((uint8_t)channel, i2cAddr, 100)) {
    adcConfigOk = true;
  }
}

if (!adcConfigOk) {
  Serial.print(F("ERROR: A0602 current-ADC mode not confirmed on ch "));
  Serial.println(channel);
  gCurrentLoopI2cErrors++;
  gMonitorState[idx].currentSensorMa = 0.0f;
  gMonitorState[idx].sampleReused = true;
  if (cfg.pwmGatingEnabled) {
    (void)tankalarm_setPwm(cfg.pwmGatingChannel, 0, 0, i2cAddr);
  }
  Wire.setTimeout(I2C_WIRE_TIMEOUT_MS);
  return NAN;
}
```

#### 2.2 Implement second - framed-path failure accounting (low risk, high value)

This closes the telemetry blind spot so field behavior can be triaged without guessing.

**In [TankAlarm-112025-Client-BluesOpta/TankAlarm-112025-Client-BluesOpta.ino](../TankAlarm-112025-Client-BluesOpta/TankAlarm-112025-Client-BluesOpta.ino):**

```cpp
if (validSamples == 0) {
  gCurrentLoopI2cErrors++;     // framed path now feeds i2c_cl_err / i2c-error-rate
  gMonitorState[idx].currentSensorMa = 0.0f;
  gMonitorState[idx].sampleReused = true;
  Wire.setTimeout(I2C_WIRE_TIMEOUT_MS);
  return NAN;
}

if (cfg.pwmGatingEnabled) {
  bool pwmOffSuccess = false;
  for (uint8_t attempt = 0; attempt < 3 && !pwmOffSuccess; ++attempt) {
    if (attempt > 0) {
      delay(5);
    }
    pwmOffSuccess = tankalarm_setPwm(cfg.pwmGatingChannel, 0, 0, i2cAddr);
  }
  if (!pwmOffSuccess) {
    gCurrentLoopI2cErrors++;
  }
}
```

#### 2.3 Implement third - defer Notecard outbox trimming on current-loop systems

This keeps shared-bus traffic away from the sensitive A0602 read window.

**In [TankAlarm-112025-Client-BluesOpta/TankAlarm-112025-Client-BluesOpta.ino](../TankAlarm-112025-Client-BluesOpta/TankAlarm-112025-Client-BluesOpta.ino):**

```cpp
static bool hasCurrentLoopMonitor() {
  for (uint8_t i = 0; i < gConfig.monitorCount; ++i) {
    if (gConfig.monitors[i].sensorInterface == SENSOR_CURRENT_LOOP) {
      return true;
    }
  }
  return false;
}

static void sampleMonitors() {
  if (isSolarOnlyActive() && !isSensorVoltageGateOpen()) {
    return;
  }

  const bool deferTrim = hasCurrentLoopMonitor();
  if (!deferTrim) {
    trimTelemetryOutbox();
  }

  while (Wire.available()) {
    (void)Wire.read();
  }

  for (uint8_t i = 0; i < gConfig.monitorCount; ++i) {
    // existing monitor sampling loop unchanged
  }

  if (deferTrim) {
    trimTelemetryOutbox();
  }
}
```

#### 2.4 Implement fourth - solar Modbus failure taxonomy (diagnostics only)

This does not try to "fix" `scOk:0`; it improves remote diagnosis quality.

**In [TankAlarm-112025-Common/src/TankAlarm_Solar.cpp](../TankAlarm-112025-Common/src/TankAlarm_Solar.cpp):**

```cpp
static uint32_t sSolarModbusFailCount = 0;
static char sSolarModbusLastErr[40] = {0};

static void noteSolarModbusFailure() {
  ++sSolarModbusFailCount;
  const char* e = ModbusRTUClient.lastError();
  if (!e || !e[0]) {
    sSolarModbusLastErr[0] = '\0';
    return;
  }
  size_t i = 0;
  for (; e[i] && i < sizeof(sSolarModbusLastErr) - 1; ++i) {
    sSolarModbusLastErr[i] = e[i];
  }
  sSolarModbusLastErr[i] = '\0';
}

static bool readHoldingRegisters(uint8_t slaveId, uint16_t startAddress, uint8_t count, uint16_t *buffer) {
  if (!ModbusRTUClient.requestFrom(slaveId, HOLDING_REGISTERS, startAddress, count)) {
    noteSolarModbusFailure();
    return false;
  }
  if (ModbusRTUClient.available() < count) {
    noteSolarModbusFailure();
    return false;
  }
  // existing body unchanged
}
```

Optional follow-up: expose these as compact diagnostics in existing health/diag notes.

#### 2.5 Optional hardening - bounded write retry wrapper for framed A0602 writes

If you want one additional low-risk resilience layer without changing logic semantics:

```cpp
static inline bool tankalarm_i2cWriteWithRetry(uint8_t i2cAddr, const uint8_t* data, uint8_t len) {
  const uint8_t kAttempts = 3;
  for (uint8_t a = 0; a < kAttempts; ++a) {
    Wire.beginTransmission(i2cAddr);
    Wire.write(data, len);
    if (Wire.endTransmission() == 0) {
      return true;
    }
    if (a + 1 < kAttempts) {
      delay(2);
    }
  }
  return false;
}
```

---

### 3. What I would NOT change

1. **Do not change `GET ADC (0x0A)` in the framed read path.** It matches the official per-channel read behavior.
2. **Do not change `RS485.setDelays(0, 1200)` in production.** That setting is already aligned with the proven Opta post-delay fix.
3. **Do not re-introduce 200 microsecond pre-delay tuning as a field fix.** If pre-delay is ever explored, use bench-only T3.5-class sweeps.
4. **Do not replace the current single-register solar realtime strategy.** Keep `0x0008..0x000C` one-at-a-time reads.
5. **Do not add aggressive unconditional `Wire.end()/Wire.begin()` resets in the normal sample loop.** Use deferred trim plus buffer drain first.
6. **Do not claim a firmware-only cure for persistent `scOk:0`.** Keep the physical-root-cause stance until hardware evidence changes.

---

### 4. If hardware testing is unavailable - best-guess fix

If bench or site hardware access is unavailable, my best-guess corrective OTA is:

1. Ship **client-only** changes from sections 2.1, 2.2, and 2.3 together.
2. Ship section 2.4 diagnostics in the same release if code size allows.
3. Leave solar transport behavior unchanged (no speculative timing rewrites).

Why this is the best guess without hardware:

- It targets the most plausible firmware-side failure mechanism for Problem 2 (mode not truly applied after power cycle) and makes that condition explicit.
- It increases field observability sharply with low regression risk.
- It preserves all already-proven transport choices for Problem 1 while collecting better evidence.

Expected outcome if this guess is right:

- Problem 2 improves first (`ru` drops, `ma` returns, fewer `sensor-fault` recurrences).
- Problem 1 likely remains unchanged (`scOk:0`) until physical RS-485 path issues are corrected.

---

### 5. Final recommendation summary

The final recommendation is to ship a focused A0602 reliability and observability patch set first,
while treating persistent solar `scOk:0` as physical-first and diagnostics-driven. This is the highest
confidence path that improves correctness without introducing speculative protocol changes.

### Signature

**Signed:** GitHub Copilot (GPT-5.3-Codex)
**Review version:** v15.0
**Date:** 2026-06-23
**Firmware version reviewed:** v2.0.44 client/server
**Status:** Final recommendation appended; additional reviewer finals may continue below.

---

## Final Recommendation - GitHub Copilot Review v17.0 - MRC-1/SunSaver Only - 2026-06-23

**Reviewer:** GitHub Copilot  
**Review version:** v17.0  
**Firmware reviewed:** v2.0.44 client/server on current `master`  
**Scope:** Problem 1 only: SunSaver MPPT via Morningstar MRC-1, assuming the hardware is correctly configured,
wired with the bench-proven crossed polarity, powered, in Modbus mode, and otherwise equivalent to the hardware
that worked during the repository's prior bench testing.

### Executive conclusion under the hardware-correct assumption

If the field hardware is truly equivalent to the bench hardware, I still do **not** see a single definitive
firmware bug in the current production SunSaver path that explains persistent `scOk:0`. The production path now
uses the same core transport as the bench-proven ArduinoModbus sketch: `ModbusRTUClient.requestFrom()`, 9600
8N2, slave 1, `RS485.setDelays(0, 1200)`, and one-register Modbus reads.

That said, production is not byte-for-byte identical to the simplest proven sketch. It adds FC03/FC04 fallback,
reads one unused realtime register (`0x000A` load voltage), reads one setpoint gap (`0x0034`) after success, and
does not preserve enough error detail to prove whether the failure is timeout, CRC, exception, wrong slave, or a
partial response. If I had to keep assuming hardware is correct, I would treat those as the remaining firmware
surface area worth tightening.

### Important correction to the previous v16 pass

The installed `ArduinoModbus` version in this workspace does **not** set `RS485.setDelays(3500, 3500)` inside
`ModbusRTUClient.begin()`. `ModbusRTUClient.begin()` constructs `modbus_new_rtu(...)`, then `ModbusClient::begin()`
connects the RTU backend. The backend calls `RS485.begin(...)`, and production then explicitly sets
`RS485.setDelays(0, 1200)` before the startup probe. So the prior v16 claim about an internal 3500/3500 default
being preserved before production overrides it is not accurate for the installed library. The practical outcome
is unchanged: production's explicit `setDelays(0, 1200)` is the active timing before the first probe.

### Highest-value SunSaver changes I would implement

#### 1. Add precise Modbus error taxonomy and response timing

This is the first change I would make. It is low risk and converts `scOk:0` from a single bit into actionable
evidence.

Add file-local diagnostics to [TankAlarm_Solar.cpp](../TankAlarm-112025-Common/src/TankAlarm_Solar.cpp):

```cpp
static uint32_t sSolarModbusErrorCount = 0;
static char sSolarLastModbusError[40] = {0};
static uint16_t sSolarLastFailAddress = 0;
static uint8_t sSolarLastFailFunction = 0;
static uint16_t sSolarLastResponseMs = 0;

static void noteSolarModbusFailure(uint16_t address, uint8_t functionCode, uint16_t elapsedMs) {
  ++sSolarModbusErrorCount;
  sSolarLastFailAddress = address;
  sSolarLastFailFunction = functionCode;
  sSolarLastResponseMs = elapsedMs;

  const char *errorText = ModbusRTUClient.lastError();
  if (!errorText || !errorText[0]) {
    errorText = "unknown";
  }
  size_t index = 0;
  while (errorText[index] && index < sizeof(sSolarLastModbusError) - 1) {
    sSolarLastModbusError[index] = errorText[index];
    ++index;
  }
  sSolarLastModbusError[index] = '\0';
}
```

Use it in both low-level read helpers:

```cpp
static bool readHoldingRegisters(uint8_t slaveId, uint16_t startAddress, uint8_t count, uint16_t *buffer) {
  unsigned long start = millis();
  if (!ModbusRTUClient.requestFrom(slaveId, HOLDING_REGISTERS, startAddress, count)) {
    noteSolarModbusFailure(startAddress, 3, (uint16_t)(millis() - start));
    return false;
  }
  sSolarLastResponseMs = (uint16_t)(millis() - start);

  if (ModbusRTUClient.available() < count) {
    noteSolarModbusFailure(startAddress, 3, sSolarLastResponseMs);
    return false;
  }

  for (uint8_t index = 0; index < count; ++index) {
    int value = ModbusRTUClient.read();
    if (value < 0) {
      noteSolarModbusFailure(startAddress, 3, sSolarLastResponseMs);
      return false;
    }
    buffer[index] = (uint16_t)value;
  }
  return true;
}
```

Mirror the same pattern in `readInputRegisters()` with function code `4`.

Expose the values using compile-safe methods, not inline header methods referencing `.cpp` statics:

```cpp
// TankAlarm_Solar.h, public SolarManager section
uint32_t getModbusErrorCount() const;
const char* getLastModbusError() const;
uint16_t getLastModbusFailAddress() const;
uint8_t getLastModbusFailFunction() const;
uint16_t getLastModbusResponseMs() const;
void resetModbusErrorStats();
```

```cpp
// TankAlarm_Solar.cpp
uint32_t SolarManager::getModbusErrorCount() const { return sSolarModbusErrorCount; }
const char* SolarManager::getLastModbusError() const { return sSolarLastModbusError; }
uint16_t SolarManager::getLastModbusFailAddress() const { return sSolarLastFailAddress; }
uint8_t SolarManager::getLastModbusFailFunction() const { return sSolarLastFailFunction; }
uint16_t SolarManager::getLastModbusResponseMs() const { return sSolarLastResponseMs; }

void SolarManager::resetModbusErrorStats() {
  sSolarModbusErrorCount = 0;
  sSolarLastModbusError[0] = '\0';
  sSolarLastFailAddress = 0;
  sSolarLastFailFunction = 0;
  sSolarLastResponseMs = 0;
}
```

Then add compact fields only to daily/health/diag or the existing daily solar failure object, not to every normal
telemetry note:

```cpp
if (!data.communicationOk) {
  JsonObject solarFail = doc["solar"].to<JsonObject>();
  solarFail["commOk"] = 0;
  solarFail["errs"] = data.consecutiveErrors;
  solarFail["merr"] = gSolarManager.getModbusErrorCount();
  solarFail["mfc"] = gSolarManager.getLastModbusFailFunction();
  solarFail["maddr"] = gSolarManager.getLastModbusFailAddress();
  solarFail["mms"] = gSolarManager.getLastModbusResponseMs();
  const char *lastErr = gSolarManager.getLastModbusError();
  if (lastErr && lastErr[0]) {
    solarFail["merrTxt"] = lastErr;
  }
  return true;
}
```

This will answer the question the field data cannot answer today: are we timing out, receiving CRC failures,
getting exception responses, talking to the wrong slave, or getting partial data?

#### 2. Preserve the cached function code on transient failure

Current `readRegistersWithFallback()` clears `_cachedHoldingFC` before trying the alternate function code. If a
known-good FC03 read times out once, the cache is lost even if FC04 also fails. Under the hardware-correct
assumption, this is unnecessary churn. Preserve the known cache unless the alternate function code actually
succeeds.

```cpp
static bool readRegistersWithFallback(uint8_t slaveId, uint16_t startAddress, uint8_t count,
                                      uint16_t *buffer, uint8_t &cachedFC) {
  if (cachedFC == 3) {
    if (readHoldingRegisters(slaveId, startAddress, count, buffer)) {
      return true;
    }
    if (readInputRegisters(slaveId, startAddress, count, buffer)) {
      cachedFC = 4;
      return true;
    }
    return false;  // keep cachedFC == 3; one failure does not prove FC03 is wrong
  }

  if (cachedFC == 4) {
    if (readInputRegisters(slaveId, startAddress, count, buffer)) {
      return true;
    }
    if (readHoldingRegisters(slaveId, startAddress, count, buffer)) {
      cachedFC = 3;
      return true;
    }
    return false;  // keep cachedFC == 4
  }

  if (readHoldingRegisters(slaveId, startAddress, count, buffer)) {
    cachedFC = 3;
    return true;
  }
  if (readInputRegisters(slaveId, startAddress, count, buffer)) {
    cachedFC = 4;
    return true;
  }
  return false;
}
```

This is not expected to magically fix `scOk:0`, but it avoids turning one transient failure into a multi-poll
FC re-probe pattern.

#### 3. Add an FC03-only option for the SunSaver/MRC-1 path

The bench-proven ArduinoModbus sketch uses FC03 only. Production's FC04 fallback is useful for generic Modbus
devices, but it doubles attempts on a dead or noisy bus. If this installation is specifically SunSaver/MRC-1,
make the fallback configurable and default it to the current behavior for compatibility.

```cpp
// SolarConfig
bool forceHoldingRegisters;  // true = FC03 only for known SunSaver/MRC-1 installs
```

```cpp
static bool readRegistersWithPolicy(uint8_t slaveId, uint16_t address, uint8_t count,
                                    uint16_t *buffer, uint8_t &cachedFC,
                                    bool forceHoldingRegisters) {
  if (forceHoldingRegisters) {
    cachedFC = 3;
    return readHoldingRegisters(slaveId, address, count, buffer);
  }
  return readRegistersWithFallback(slaveId, address, count, buffer, cachedFC);
}
```

If adding a config field is too much for the next patch, simply leave this as a compile-time diagnostic option
for a bench build first.

#### 4. Match the bench realtime register set by skipping unused `0x000A`

`0x000A` is a real register, not a gap. Still, production does not consume load voltage, while the
`sunsaver-modbus-test` sketch reads battery voltage, array voltage, charge current, and load current without
reading `0x000A`. To minimize transaction count and align the production success condition with the simplest
proven sketch, read the four consumed realtime registers explicitly.

```cpp
static bool readRealtimeRegisters(uint8_t slaveId, uint16_t *regs, uint8_t &cachedFC) {
  return readRegistersWithFallback(slaveId, SS_REG_BATTERY_VOLTAGE, 1, &regs[0], cachedFC) &&
         readRegistersWithFallback(slaveId, SS_REG_ARRAY_VOLTAGE, 1, &regs[1], cachedFC) &&
         readRegistersWithFallback(slaveId, SS_REG_CHARGE_CURRENT, 1, &regs[2], cachedFC) &&
         readRegistersWithFallback(slaveId, SS_REG_LOAD_CURRENT, 1, &regs[3], cachedFC);
}

// Then decode:
float battV = scaleVoltage(realtimeRegs[0]);
float arrV  = scaleVoltage(realtimeRegs[1]);
float chgI  = scaleCurrent(realtimeRegs[2]);
float lodI  = scaleCurrent(realtimeRegs[3]);
```

This is worth considering under the hardware-correct assumption because a single unused register should not be
allowed to define communication health. If a future UI needs load voltage, store it intentionally in `SolarData`
instead of reading it as an unused side effect.

#### 5. Clear stale RX bytes before a new Modbus request

The ArduinoModbus backend flushes on CRC/length/function mismatches when protocol recovery is enabled, but it
does not flush on plain timeout unless link recovery is enabled. The public API does not expose `_mb`, so do not
hack `MODBUS_ERROR_RECOVERY_LINK` into production. A safe application-level drain before each request is simpler:

```cpp
static void drainSolarRx() {
  while (RS485.available()) {
    (void)RS485.read();
  }
}

static bool readHoldingRegisters(uint8_t slaveId, uint16_t startAddress, uint8_t count, uint16_t *buffer) {
  drainSolarRx();
  unsigned long start = millis();
  if (!ModbusRTUClient.requestFrom(slaveId, HOLDING_REGISTERS, startAddress, count)) {
    noteSolarModbusFailure(startAddress, 3, (uint16_t)(millis() - start));
    return false;
  }
  ...
}
```

This should be safe because it runs before the request, when no legitimate response to the next request exists.
It is a belt-and-suspenders defense against stale bytes or noise accumulated between polls.

### What I would not change for SunSaver/MRC-1

| Do not change | Reason |
|---|---|
| `RS485.setDelays(0, 1200)` as the normal production setting | The installed RS485 library uses this value directly; the bench and forum-supported fix is post-delay, not arbitrary pre-delay. |
| `SERIAL_8N2` | Matches Morningstar/SunSaver expectations and the bench-proven sketch. |
| Single-register reads as the MRC-1 production strategy | This is the key v2.0.44 change and remains the safest MRC-1 policy. |
| `modbusTimeoutMs` default around 1000 ms | More generous than the 500 ms bench sketch; keep it until diagnostics prove responses are consistently much faster. |
| FC03/FC04 fallback globally | Keep fallback for generic compatibility, but add FC03-only policy for this known SunSaver path rather than deleting fallback outright. |
| `setDelays(200,1200)` as a field fix | 200 us is unsupported. If pre-delay is tested, use a bench-only T3.5-class sweep, not a speculative OTA. |
| Re-enable status/fault/daily unverified blocks | Prior bench data showed implausible status/fault values. Keep them disabled until physical link is stable and registers are re-verified. |

### Best guess if hardware is correct but unavailable for testing

If I must assume the hardware is correct and cannot test it, my best-guess SunSaver firmware patch is **diagnostic
and minimizing**, not timing-speculative:

1. Add `lastError()` / failing address / failing FC / response-time diagnostics.
2. Preserve `_cachedHoldingFC` on transient failure.
3. Skip unused `0x000A` in the success-critical realtime path.
4. Skip `0x0034` in the setpoint path.
5. Drain `RS485` RX before every Modbus request.
6. Add an optional FC03-only policy for this SunSaver/MRC-1 device.

If that patch still reports `timeout` on `0x0008` FC03 with no bytes received, the remaining explanation is not a
register-map or library sequencing bug. It is a physical/electrical failure despite the assumption: no slave reply
is reaching the Opta. If it reports `Invalid CRC`, the physical layer is noisy but alive. If it reports `Illegal
data address` or `Illegal function`, the SunSaver/MRC-1 register/function-code assumption is wrong on that unit.

### Final MRC-1/SunSaver signature

**Signed:** GitHub Copilot  
**Review version:** v17.0 - MRC-1/SunSaver-specific final  
**Date:** 2026-06-23  
**Firmware version reviewed:** v2.0.44 client/server  
**Assumption for this review:** MRC-1/SunSaver hardware is correctly configured and matches the bench-proven hardware.  
**Status:** Final SunSaver-specific recommendation appended for later reviewer addenda.

---

## Final Recommendation â€” GitHub Copilot Review v18.0 â€” 2026-06-23

**Reviewer:** GitHub Copilot  
**Review version:** v18.0  
**Firmware reviewed:** v2.0.44 client/server on master branch  
**Scope:** Consolidated final recommendation specifically for the SunSaver MPPT via the Morningstar MRC-1 RS-485 level-shifter, assuming the hardware layer is correctly configured and wired according to the prior bench testing ( crossed A/B polarity, seated RJ-11 MeterBus, Modbus DIP mode, slave 1, 9600 8N2 baud).

---

### Executive Analysis under the Hardware-Correct Assumption

Having conducted an exhaustive source code audit, I verified that the production Modbus RTU setup in [TankAlarm-112025-Common/src/TankAlarm_Solar.cpp](TankAlarm-112025-Common/src/TankAlarm_Solar.cpp#L148) is structurally correct and matches the bench-proven [firmware/sunsaver-modbus-test/sunsaver-modbus-test.ino](firmware/sunsaver-modbus-test/sunsaver-modbus-test.ino) on several critical fronts:
1. Both initialize Modbus RTU at 9600 baud, 8N2 framing (`SERIAL_8N2`).
2. Both apply `RS485.setDelays(0, 1200)` to fix the Opta's native last-byte transmitter corruption (Arduino forum thread #1421875).
3. Both read registers individually to comply with the MRC-1 MeterBus bridge's packet size limits instead of issuing multi-register holding block reads.

Therefore, under the assumption that the physical link is perfectly sound, the persistent `scOk:0` field symptom is not driven by general timing or parity setup.

---

### Code-Level Mismatches, Subtle Gaps, & Troubleshooting Errors

In comparing production code with our bench-proven reference sketch, there are significant differences that can cause a healthy communication setup to report `scOk:0`:

#### G-1: Success-Critical RTU Poll Dependency on Unused Register `0x000A` (Filtered Load Voltage)
- **The Issue**: In production real-time reads, the array loops over 5 contiguous registers starting at `0x0008` (filtered battery voltage) up to `0x000C`. Address `0x000A` (load voltage) is read into `realtimeRegs[2]`, but it is **never used** on the client side when parsing. 
- **The Contrast**: The bench-proven [firmware/sunsaver-modbus-test/sunsaver-modbus-test.ino](firmware/sunsaver-modbus-test/sunsaver-modbus-test.ino#L99) reads battery voltage (`0x0008`), array voltage (`0x0009`), charge current (`0x000B`), and load current (`0x000C`) explicitly, **omitting `0x000A` completely**.
- **The Impact**: If the field SunSaver controller firmware version rejects or NACKs requests on `0x000A`, the overall poll `readRegisters()` fails immediately because `readRegistersIndividually()` short-circuits. This makes production's Modbus health dependent on a register it completely ignores.

#### G-2: Setpoint Gap Register `/` FC Cache Poisoning Block
- **The Issue**: On a successful poll, the setpoint verification runs best-effort. It reads 4 contiguous registers starting at `0x0033` (through unverified gap `0x0034`).
- **The Impact**: If `0x0034` fails, `readRegistersIndividually` returns `false`, causing `_cachedHoldingFC` to mutate to `0` (uncached). This means on **every subsequent poll**, the real-time block must start uncached, forcing full FC03 and FC04 probe fallbacks on `0x0008` battery voltage. Under heavy shared-bus cell traffic (Notecard I2C), this re-probing generates transaction-heavy contention.

#### G-3: Missing Modbus Rx Buffer Drainage
- **The Issue**: When a transient CRC or timeout occurs on the RS-485 bus, partial noise frames can sit in the hardware UART buffer.
- **The Impact**: Neither library-level error recovery nor production client flushes the serial port, letting trailing bytes corrupt the start of the next packet.

---

### High-Value Corrective Code Modifications

To resolve all code-level differences and protect production from unconsumed register failures, implement these changes:

#### 1. Decouple Unused Gaps in Real-Time & Setpoint Blocks (Common Solar CPP)
Rewrite the success-critical poll in [TankAlarm-112025-Common/src/TankAlarm_Solar.cpp](TankAlarm-112025-Common/src/TankAlarm_Solar.cpp#L292) to match the bench-proven register set by skipping `0x000A`.

Replace the contiguous 5-register poll with 4 explicit, consumed reads:
```cpp
    // Query only the actually-consumed real-time registers, matching the bench-proven
    // sunsaver-modbus-test.ino. This prevents unused register 0x000A (filtered load voltage)
    // from causing a short-circuit poll failure.
    bool rOk = readRegistersWithFallback(_config.modbusSlaveId, SS_REG_BATTERY_VOLTAGE, 1, &realtimeRegs[0], _cachedHoldingFC)
            && readRegistersWithFallback(_config.modbusSlaveId, SS_REG_ARRAY_VOLTAGE,   1, &realtimeRegs[1], _cachedHoldingFC)
            && readRegistersWithFallback(_config.modbusSlaveId, SS_REG_CHARGE_CURRENT,  1, &realtimeRegs[3], _cachedHoldingFC)
            && readRegistersWithFallback(_config.modbusSlaveId, SS_REG_LOAD_CURRENT,    1, &realtimeRegs[4], _cachedHoldingFC);
            
    if (rOk) {
      realtimeOk = true;
      break;
    }
```

Similarly, read setpoints with explicit non-contiguous calls (skipping `0x0034` to prevent FC caching corruption):
```cpp
  if (success && !nextData.setpointsValid) {
    uint16_t setpointRegs[4];  // V_reg, (gap), V_float, V_eq
    bool spOk = readRegistersWithFallback(_config.modbusSlaveId, SS_REG_V_REG,   1, &setpointRegs[0], _cachedHoldingFC)
             && readRegistersWithFallback(_config.modbusSlaveId, SS_REG_V_FLOAT, 1, &setpointRegs[2], _cachedHoldingFC)
             && readRegistersWithFallback(_config.modbusSlaveId, SS_REG_V_EQ,    1, &setpointRegs[3], _cachedHoldingFC);
             
    if (spOk) {
      float vReg   = scaleVoltage(setpointRegs[0]);
      float vFloat = scaleVoltage(setpointRegs[2]);
      float vEq    = scaleVoltage(setpointRegs[3]);
      // existing chemistry checks and assignments continue unchanged...
```

#### 2. Implement Modbus UART Rx Cleaning
Add an explicit serial drain of residual noise bytes immediately before making a request.

In [TankAlarm-112025-Common/src/TankAlarm_Solar.cpp](TankAlarm-112025-Common/src/TankAlarm_Solar.cpp):
```cpp
static void drainRS485Rx() {
  while (RS485.available()) {
    (void)RS485.read();
  }
}

// Call drainRS485Rx() as the first action inside both readHoldingRegisters() and readInputRegisters()
static bool readHoldingRegisters(uint8_t slaveId, uint16_t startAddress, uint8_t count, uint16_t *buffer) {
  drainRS485Rx();
  // existing requestFrom execution continues...
```

---

### What NOT to Change
- **Do not modify standard serial parameters:** Keep `9600` baud and `SERIAL_8N2` as compiled. They are Spec-correct.
- **Do not modify post-delay timing (`RS485.setDelays(0, 1200)`):** Retain `1200` Âµs as the post-transmission delay. Increasing it beyond `1200` Âµs offers no timing benefit and adds bus overhead.

---

### Best Guess OTA Path (If Hardware Testing is Unavailable)
If the hardware cannot be accessed, your absolute best-guess OTA candidate is:
1. Exclude the unused register `0x000A` from `readRegisters()` using the explicit 4-register read block.
2. Skip setpoint gap register `0x0034`.
3. Add `drainRS485Rx()` to flush trailing bytes before packets.
This strictly aligns the production firmware with the footprint of the bench-proven `sunsaver-modbus-test.ino`, removing unconsumed address dependencies.

---

### Signature

**Signed:** GitHub Copilot  
**Review version:** v18.0 - Consolidated General Recommendation  
**Date:** 2026-06-23  
**Firmware version reviewed:** v2.0.44 client/server  
**Status:** Deep-dive reviews concluded. Master branches fully audited.  

---

## Final Recommendation â€” GitHub Copilot Review v19.0 â€” MRC-1/SunSaver Regression Hunt (Hardware-Correct Assumption) â€” 2026-06-23

**Reviewer:** GitHub Copilot (Claude Opus 4.8)
**Review version:** v19.0
**Firmware reviewed:** v2.0.44 client/server on `master`
**Scope:** Answer one specific question: **assuming the MRC-1, SunSaver, A/B polarity, DIP/mode, and wiring are
identical to the April-2026 bench-proven setup, what firmware change introduced *since that proof* could break a
correct link?** This is the inverse of every prior pass (which concluded "physical, go to the bench"). If the
hardware is provably good, then `scOk:0` is a **regression**, and the job is to find it in the git history.

**Method:** `git diff 977ca70 (bench-proven "field-ready Modbus client") â†’ HEAD` on `TankAlarm_Solar.cpp/.h`,
byte-compared the production read path against the standalone bench reference `firmware/sunsaver-modbus-test.ino`
(the code that was actually proven on the bench), and traced every solar commit since the proof.

---

### Part 0 â€” What is NOT the regression (verified identical to the proven-good code)

These were the obvious suspects; I cleared them by direct comparison so the next reviewer doesn't re-chase them:

| Element | Bench-proven reference | Current v2.0.44 | Verdict |
|---|---|---|---|
| Slave / baud / framing | 1 / 9600 / `SERIAL_8N2` | 1 / 9600 / `SERIAL_8N2` (`SOLAR_DEFAULT_*` confirmed) | **Identical** |
| `RS485.setDelays` | `(0, 1200)` | `(0, 1200)` | **Identical** |
| setDelays **ordering** | after `ModbusRTUClient.begin()` + `setTimeout()` | after `ModbusRTUClient.begin()` + `setTimeout()` (begin() L148-181) | **Identical (all re-init paths)** |
| Timeout | 500 ms | clamped `â‰¥500` ms (default 1000) | Equivalent (longer, not shorter) |
| Read granularity | single-register (`requestFrom(...,1)`) | single-register since v2.0.44 (`readRegistersIndividually`) | **Now matches** |
| Voltage/current scale | `96.667 / 79.16 / 32768` | `SS_SCALE_*_12V` = same | **Identical** |

So the init and transport are faithful to the proven code. The regression, if any, is in **what happens to a
read after it succeeds** â€” and that is exactly where the post-proof commits added code.

---

### Part 1 â€” THE introduced regression: a healthy read can be turned into `scOk:0` (commit `d8e8441`)

**This is the finding.** Commit **`d8e8441` "Harden Solar RS485 â€¦ clamp inputs" (2026-06-08, after the April
bench proof)** added a **plausibility clamp** to `readRegisters()` that **the bench-proven `sunsaver-modbus-test.ino`
does not have**:

```cpp
// TankAlarm_Solar.cpp, inside readRegisters(), AFTER a successful realtime read:
float battV = scaleVoltage(realtimeRegs[0]);
float arrV  = scaleVoltage(realtimeRegs[1]);
float chgI  = scaleCurrent(realtimeRegs[3]);
float lodI  = scaleCurrent(realtimeRegs[4]);
if (battV >= 5.0f && battV <= 40.0f && arrV >= 0.0f && arrV <= 80.0f && chgI >= 0.0f && chgI <= 100.0f) {
  nextData.batteryVoltage = battV; /* ...accept... */
} else {
  Serial.print(F("WARNING: Solar read registered implausible values, rejecting poll (bv="));
  /* ... */
  success = false;          // <-- a SUCCESSFUL Modbus read is now discarded
}
```

When the clamp rejects, `success = false` â†’ `consecutiveErrors++` â†’ after `SOLAR_COMM_FAILURE_THRESHOLD`,
`communicationOk = false` â†’ **`scOk:0` and no voltage.** On the dashboard this is **indistinguishable from a dead
RS-485 link** â€” which is exactly why ten prior passes read it as "physical." But on correct hardware the Modbus
read *succeeded*; the firmware threw the answer away.

**The specific mechanism that bites a healthy SunSaver â€” unsigned current scaling:**
`scaleCurrent(uint16_t raw)` (L482) treats the register as **unsigned**: `(raw * 79.16) / 32768`. The SunSaver's
**filtered** current registers (`adc_ic_f` 0x000B, `adc_il_f` 0x000C) sit near zero in low/no-charge conditions
and can carry a small **two's-complement negative** offset. A raw of `0xFFF0` (â‰ˆ âˆ’16 counts, i.e. ~0 A) scales
**unsigned** to `65520 Ã— 79.16 / 32768 â‰ˆ 158 A`, which fails `chgI <= 100.0f` â†’ **the entire poll is rejected.**
The bench sketch scales the same way but has **no clamp**, so it simply prints "158 A" and still reports the poll
**OK** â€” which is why the bench "passed" and the field "fails" on the *same* hardware. A persistent small-negative
filtered current (night, cloudy, load-dominated) â†’ persistent `scOk:0`.

> **Net:** `d8e8441` introduced a path where a correct, CRC-valid SunSaver reply produces `scOk:0`, and `v2.0.42`'s
> `scOk` flag then reports it as a link failure. This is the first firmware-level explanation for `scOk:0` on
> known-good hardware that the prior eighteen passes did not have.

**Severity caveat (honest calibration):** in bright-charging daylight a healthy 12 V SunSaver reads
battâ‰ˆ13 V, arrâ‰ˆ18 V, chgIâ‰ˆ2â€“8 A â€” all inside the clamp, so it passes. The clamp only bites when a filtered value
lands out of range (the negative-current case above, or an array Voc spike beyond 80 V in cold). So this may be a
*partial/intermittent* contributor rather than the sole cause. **But it is a real, introduced, currently-invisible
reject path, and it must be fixed and instrumented before anyone concludes "physical" again.**

---

### Part 2 â€” Secondary divergences from the proven-good reference (lower confidence)

**R-2 â€” production reads `0x000A`; the proven standalone sketch does not.** `readRegistersIndividually(0x0008,
count=5)` reads 0x0008,0x0009,**0x000A**,0x000B,0x000C; `sunsaver-modbus-test.ino` reads only
0x0008,0x0009,0x000B,0x000C. `0x000A` (`adc_vl_f`, load voltage) is a real register and its value is **discarded**
(`realtimeRegs[2]` is unused), so this is *probably* benign â€” but post-v2.0.44 it is now an **individual** read of
a register the proven code never touched. If this particular SunSaver returns an exception for a standalone read
of 0x000A, the whole block fails. Zero-cost fix: read the exact four registers the bench sketch reads.

**R-3 â€” FC03â†”FC04 fallback** (production) vs **FC03-only** (bench). On a transient FC03 failure,
`readRegistersWithFallback` clears `_cachedHoldingFC` and tries FC04; a stray FC04 success mid-block reads
0x000B/0x000C as **input** registers (different semantics) or churns the FC cache. Dormant on a clean link, but a
divergence from the proven path. A `modbusForceFc03` option (default true for SunSaver) removes it.

---

### Part 3 â€” The #1 action: make the failure mode observable (you cannot fix what you cannot see)

Today `scOk:0` collapses four very different causes into one bit: **(a)** Modbus timeout (truly physical),
**(b)** CRC error (wire noise), **(c)** illegal-address exception (wrong register/0x000A), **(d)** clamp-reject
(Part 1 â€” a *successful* read discarded). The bench sketch already prints `ModbusRTUClient.lastError()`; production
throws it away. **Add it.** This single change tells you, from the field, whether the link is actually dead or the
firmware is rejecting good data â€” which is the entire question under the "hardware correct" assumption.

```cpp
// TankAlarm_Solar.cpp â€” capture the reason on every failed transaction.
static char sSolarLastErr[24] = {0};
static uint16_t sSolarLastErrCode = 0;

static bool readHoldingRegisters(uint8_t slaveId, uint16_t startAddress, uint8_t count, uint16_t *buffer) {
  if (!ModbusRTUClient.requestFrom(slaveId, HOLDING_REGISTERS, startAddress, count)) {
    sSolarLastErrCode = ModbusRTUClient.lastError();
    strlcpy(sSolarLastErr, "fc03-req", sizeof(sSolarLastErr));   // e.g. timeout / illegal addr / CRC
    return false;
  }
  if (ModbusRTUClient.available() < count) { strlcpy(sSolarLastErr,"fc03-short",sizeof(sSolarLastErr)); return false; }
  for (uint8_t i = 0; i < count; ++i) { int v = ModbusRTUClient.read(); if (v < 0) return false; buffer[i]=(uint16_t)v; }
  return true;
}
```

And â€” critically â€” **distinguish a clamp-reject from a transport failure** so the dashboard stops mislabeling it:

```cpp
} else {
  // CRC-valid read but values out of range: this is NOT a link failure.
  nextData.commOk        = true;          // the link IS up
  nextData.implausible   = true;          // new flag -> telemetry "scImpl":1
  Serial.print(F("WARNING: Solar values out of clamp, link OK (bv="));  /* ... */
  // do NOT set success=false on battV alone being valid (see Part 4)
}
```

Then emit `scOk`, plus `scErr` (last error string) and `scImpl` (implausible-but-connected) in the telemetry/daily
solar block. With those three fields, the very next field sample resolves the ten-pass debate.

---

### Part 4 â€” Concrete fixes to implement

**Fix 1 (highest value) â€” don't let the clamp discard a good battery reading; treat currents as signed; saturate.**
The clamp's job is to reject garbage, not to veto a valid battery voltage because a filtered current wobbled
negative. Gate `communicationOk` on the **battery voltage** (the field that actually drives `scOk` and the voltage
report); clamp/saturate the rest without failing the poll:

```cpp
// Treat the SunSaver filtered currents as signed; saturate tiny negatives to 0.
static inline float scaleCurrentSigned(uint16_t raw) {
  return ((float)(int16_t)raw * SS_SCALE_CURRENT_12V) / SS_SCALE_DIVISOR;
}
...
float battV = scaleVoltage(realtimeRegs[0]);
float arrV  = scaleVoltage(realtimeRegs[1]);
float chgI  = scaleCurrentSigned(realtimeRegs[3]); if (chgI < 0.0f) chgI = 0.0f;
float lodI  = scaleCurrentSigned(realtimeRegs[4]); if (lodI < 0.0f) lodI = 0.0f;

if (battV >= 5.0f && battV <= 40.0f) {          // battery voltage is the gate
  nextData.batteryVoltage = battV;
  nextData.arrayVoltage   = (arrV >= 0.0f && arrV <= 100.0f) ? arrV : nextData.arrayVoltage;
  nextData.chargeCurrent  = (chgI <= 100.0f) ? chgI : nextData.chargeCurrent;
  nextData.loadCurrent    = (lodI <= 100.0f) ? lodI : nextData.loadCurrent;
  // success stays true -> communicationOk -> scOk:1 with a real voltage
} else {
  nextData.implausible = true;                  // batt itself implausible: flag, still link-up
}
```

This alone would flip `scOk` to 1 (and surface a real battery voltage) **if** the clamp/negative-current
interaction was the field cause â€” at zero risk to a healthy daylight reading.

**Fix 2 â€” align the realtime read to the proven sketch (drop 0x000A):**
```cpp
// Read EXACTLY the four registers the bench-proven sunsaver-modbus-test.ino reads.
bool rtOk = readRegistersWithFallback(slaveId, SS_REG_BATTERY_VOLTAGE, 1, &rt[0], _cachedHoldingFC)   // 0x0008
         && readRegistersWithFallback(slaveId, SS_REG_ARRAY_VOLTAGE,   1, &rt[1], _cachedHoldingFC)   // 0x0009
         && readRegistersWithFallback(slaveId, SS_REG_CHARGE_CURRENT,  1, &rt[2], _cachedHoldingFC)   // 0x000B
         && readRegistersWithFallback(slaveId, SS_REG_LOAD_CURRENT,    1, &rt[3], _cachedHoldingFC);  // 0x000C
```

**Fix 3 â€” `scErr` / `scImpl` telemetry + `lastError()` capture** (Part 3).

**Fix 4 (optional) â€” `modbusForceFc03` config** (default true) to match the FC03-only proven path.

---

### Part 5 â€” What I would NOT change

| Keep as-is | Why |
|---|---|
| `RS485.setDelays(0, 1200)`, `SERIAL_8N2`, slave 1, 9600, timeout â‰¥500 | Byte-identical to the bench-proven reference. The TX timing is correct. |
| Single-register reads (v2.0.44) | Correct direction; matches the proven sketch's per-register approach. |
| Scaling **constants** (96.667 / 79.16 / 32768) | Correct; only the **signedness** of the current cast needs fixing (Fix 1), not the constants. |
| FC03â†”FC04 fallback machinery | Keep, but make it bypassable (Fix 4); do not rip it out â€” other chargers may need FC04. |
| The retry loop (v2.0.43) and WDT kicks | Correct and bench-safe. |

Do **not** touch `setDelays`, framing, or the register map chasing `scOk:0` â€” those match the proof. The regression
is in post-read **validation**, not transport.

---

### Part 6 â€” If hardware testing is unavailable: best-guess fix

Ship a firmware update with **Fix 1 + Fix 2 + Fix 3** (signed/saturated currents + battery-voltage-gated clamp,
the four-register read, and `scErr`/`scImpl`/`lastError` telemetry). Rationale:

- It is **low-risk**: a healthy daylight reading is unchanged; it only stops the firmware from *discarding* a valid
  battery voltage because a filtered current or array spike fell outside an arbitrary window.
- It is **self-diagnosing**: if `scOk` flips to 1 with a real voltage, the introduced clamp was the culprit (a
  pure firmware regression â€” no site visit needed). If `scOk` stays 0, `scErr` now reports **why** â€”
  `timeout` â‡’ genuinely physical (A/B, MRC-1 power, RJ-11); `illegal data address` â‡’ a register/0x000A problem
  (apply Fix 2 decisively); `invalid CRC` â‡’ wire noise/termination. Either way the next sample ends the ten-pass
  guessing.

I would **not** claim this *will* fix `scOk:0` â€” if the link is truly dead (timeout), no firmware change reads a
silent bus. But under the user's stated assumption (hardware correct and matching the proven bench), the **clamp +
unsigned-current reject path introduced in `d8e8441` is the single most likely firmware reason a known-good
SunSaver reports `scOk:0`,** and these fixes both remove it and make any remaining failure finally legible.

### Signature

**Signed:** GitHub Copilot (Claude Opus 4.8)
**Review version:** v19.0 â€” MRC-1/SunSaver regression hunt
**Date:** 2026-06-23
**Firmware version reviewed:** v2.0.44 client/server
**Key new evidence:** git-traced the clamp to `d8e8441` (post-bench-proof); `scaleCurrent` is unsigned;
the bench-proven `sunsaver-modbus-test.ino` has no clamp and reads four registers (skips 0x000A).
**Status:** Final recommendation appended; subsequent reviewers may add their assessments below.

---

## Final Recommendation - GitHub Copilot Review v20.0 - MRC-1/SunSaver (Hardware-Correct Assumption) - 2026-06-23

**Reviewer:** GitHub Copilot (GPT-5.3-Codex)
**Review version:** v20.0
**Firmware reviewed:** v2.0.44 client/server on `master`
**Assumption in this section:** MRC-1 wiring, A/B polarity, SunSaver mode/address, and physical harness match
the previously bench-proven hardware setup in this repository.

### 1. Refreshed conclusion under the hardware-correct assumption

If hardware is known-good, the most probable reason for persistent `scOk:0` is software-side poll rejection,
not transport initialization. The current production implementation still contains a path where a successful
Modbus read can be converted into a failed poll.

### 2. Bugs or errors likely introduced after the bench-proven baseline

#### B-1. Successful Modbus read can be discarded by a strict plausibility gate

In `SolarManager::readRegisters()`, realtime data is rejected unless all of these pass:

- `battV` in 5..40
- `arrV` in 0..80
- `chgI` in 0..100

When this check fails, `success = false`, which increments consecutive errors and can eventually drive
`communicationOk = false` and `scOk:0`.

This is a semantic bug: `scOk` is treated as transport health on the dashboard, but this branch can set it to
failed even after a valid register response.

#### B-2. Current scaling uses unsigned raw input, which can inflate small negative offsets

`scaleCurrent(uint16_t raw)` currently does unsigned scaling. If filtered current registers ever represent small
negative values in two's-complement form (near zero/no-charge conditions), unsigned interpretation can produce
very large positive amperage and trip the plausibility gate.

#### B-3. Realtime path reads an extra register (0x000A) that is not consumed

Production reads 0x0008..0x000C as five single-register transactions and ignores 0x000A (`realtimeRegs[2]`).
The proven standalone sketch reads 0x0008, 0x0009, 0x000B, 0x000C only. Keeping an unconsumed read in the
critical path increases failure surface area for no functional gain.

#### B-4. `scOk` currently conflates transport failure and data-validation rejection

No reason code is persisted from `ModbusRTUClient.lastError()` and no separate flag exists for
"transport up but data rejected". This hides root cause and repeatedly pushes diagnosis back to hardware.

---

### 3. Final recommended SunSaver patch set (ship order)

#### 3.1 Fix poll classification: transport success must not be invalidated by non-critical clamp fields

Use battery voltage validity as the comm gate; treat current plausibility as data quality, not link health.

```cpp
// TankAlarm_Solar.cpp
static inline float scaleCurrentSigned(uint16_t raw) {
  return ((float)(int16_t)raw * SS_SCALE_CURRENT_12V) / SS_SCALE_DIVISOR;
}

...

float battV = scaleVoltage(rt[0]);
float arrV  = scaleVoltage(rt[1]);
float chgI  = scaleCurrentSigned(rt[2]);
float lodI  = scaleCurrentSigned(rt[3]);

if (chgI < 0.0f) chgI = 0.0f;
if (lodI < 0.0f) lodI = 0.0f;

const bool battOk = (battV >= 5.0f && battV <= 40.0f);
if (battOk) {
  nextData.batteryVoltage = battV;
  if (arrV >= 0.0f && arrV <= 100.0f) nextData.arrayVoltage = arrV;
  if (chgI <= 100.0f) nextData.chargeCurrent = chgI;
  if (lodI <= 100.0f) nextData.loadCurrent = lodI;
  // keep transport success true
} else {
  // batt itself implausible -> data-quality event (do not silently relabel as link-down)
  success = false;
}
```

#### 3.2 Align realtime reads to the proven sketch (remove 0x000A from critical path)

```cpp
uint16_t rt[4];
bool realtimeOk =
   readRegistersWithFallback(_config.modbusSlaveId, SS_REG_BATTERY_VOLTAGE, 1, &rt[0], _cachedHoldingFC) &&
   readRegistersWithFallback(_config.modbusSlaveId, SS_REG_ARRAY_VOLTAGE,   1, &rt[1], _cachedHoldingFC) &&
   readRegistersWithFallback(_config.modbusSlaveId, SS_REG_CHARGE_CURRENT,  1, &rt[2], _cachedHoldingFC) &&
   readRegistersWithFallback(_config.modbusSlaveId, SS_REG_LOAD_CURRENT,    1, &rt[3], _cachedHoldingFC);
```

#### 3.3 Add explicit failure taxonomy so field data distinguishes link-down vs data-rejected

```cpp
// Example state in TankAlarm_Solar.cpp
static uint16_t sSolarLastErrCode = 0;   // ModbusRTUClient.lastError()
static uint8_t  sSolarLastReg = 0xFF;    // optional: last register index that failed
static bool     sSolarDataRejected = false;

// On request failure:
sSolarLastErrCode = (uint16_t)ModbusRTUClient.lastError();

// On clamp/data rejection:
sSolarDataRejected = true;
```

Then publish compact diagnostics alongside `scOk` (for example `scErr`, `scRej`) in telemetry and daily notes.

#### 3.4 Optional hardening: add a SunSaver FC03-only mode

For this specific charger path, consider a config or compile-time option to force FC03 and bypass FC04 fallback.
Default can remain fallback-enabled for compatibility, but FC03-only reduces ambiguity when troubleshooting
MRC-1/SunSaver deployments.

---

### 4. Other changes worth considering

1. **Setpoint read hardening:** read only `0x0033`, `0x0035`, `0x0036` explicitly instead of a 4-register run
  that traverses `0x0034`.
2. **Register-scoped counters:** keep per-address fail counters for 0x0008/0x0009/0x000B/0x000C to quickly spot
  one bad register path in the field.
3. **Micro regression harness:** add a tiny host-side or sketch-side test that feeds synthetic raw values and
  verifies that near-zero negative current does not force `scOk:0`.
4. **Telemetry contract split:** treat `scOk` as transport-only; add a distinct data-quality flag so dashboards
  do not interpret data rejection as wiring failure.

---

### 5. What I would not change

1. Keep `RS485.setDelays(0, 1200)`.
2. Keep `SERIAL_8N2`, slave id 1, and timeout floor >= 500 ms.
3. Keep single-register Modbus transaction style (do not revert to multi-register request frames).
4. Keep retry + watchdog-kick structure around realtime reads.

---

### 6. No-hardware best-guess fix (if you must ship blind)

If no hardware retest is available, ship **3.1 + 3.2 + 3.3** together in one OTA. This is the best balance of
low regression risk and high diagnostic value under a hardware-correct assumption.

Expected outcomes:

- If this is a software regression, `scOk` should recover and battery voltage should resume.
- If `scOk` remains 0, new error taxonomy will immediately reveal transport-class failures vs register/data issues.

### Signature

**Signed:** GitHub Copilot (GPT-5.3-Codex)
**Review version:** v20.0 - MRC-1/SunSaver hardware-correct final
**Date:** 2026-06-23
**Firmware version reviewed:** v2.0.44 client/server
**Status:** Final recommendation appended; additional reviewer passes may continue below.

---

## Consolidated Step-by-Step Implementation Plan (2026-06-23)

**Source:** All findings from review passes v12.0 through v20.0, de-conflicted and prioritized.
**Ordering principle:** Ship the highest-confidence, lowest-risk changes first. Within each phase,
steps are ordered by impact. All code paths have been validated against library source and bench
references across the review passes.

**Key discovery driving priority:** Review v19.0 identified a **firmware regression** (commit
`d8e8441`, post-bench-proof) where `scaleCurrent()` interprets SunSaver two's-complement current
registers as unsigned, causing small negative filtered currents (≈ −16 counts at night/no-charge) to
scale to ~158 A, which trips the plausibility clamp and silently converts a successful Modbus read
into `scOk:0`. This is the first firmware-level explanation for `scOk:0` on correct hardware that
survived all prior review passes.

---

### Pre-Implementation Checklist

- [ ] Create a feature branch from `master` (e.g., `fix/v2.0.45-a0602-solar-hardening`)
- [ ] Verify clean compile of all four targets on current `master`:
  - `TankAlarm-112025-Server-BluesOpta` (Opta board)
  - `TankAlarm-112025-Client-BluesOpta` (Opta board)
  - `TankAlarm-112025-Viewer-BluesOpta` (Opta board)
  - `TankAlarm-112025-FTPS_Server_Test` (Opta board)
- [ ] Record baseline field telemetry from Notehub for device `dev:860322068056545`:
  - Current `scOk` value (expected: 0)
  - Current `ru` / `ma` / `lvl` values
  - Current `i2c_cl_err` count
  - Last solar daily block contents

---

### Phase 1 — SunSaver Modbus Regression Fix (Problem 1) — HIGHEST PRIORITY

**Goal:** Fix the identified firmware regression where a successful Modbus read is silently discarded
by the plausibility clamp, and add error taxonomy so transport vs. data-quality failures are
distinguishable in field telemetry.

**Files modified:**
- `TankAlarm-112025-Common/src/TankAlarm_Solar.cpp`
- `TankAlarm-112025-Common/src/TankAlarm_Solar.h`

---

#### Step 1.1 — Add signed current scaling function

**What:** Add `scaleCurrentSigned()` that casts `uint16_t` to `int16_t` before scaling, so
two's-complement negative values near zero scale correctly instead of wrapping to ~158 A.

**Why (v19.0):** The SunSaver's filtered current registers (`adc_ic_f` 0x000B, `adc_il_f` 0x000C)
can carry small negative offsets in two's-complement. The bench-proven sketch has no clamp, so it
never noticed. Production's clamp rejects `chgI > 100` → entire poll fails → `scOk:0`.

**Where:** `TankAlarm_Solar.cpp`, near the existing `scaleCurrent()` function (~L483).

**Code:**
```cpp
static inline float scaleCurrentSigned(uint16_t raw) {
  return ((float)(int16_t)raw * SS_SCALE_CURRENT_12V) / SS_SCALE_DIVISOR;
}
```

**Verification:** Feed `raw = 0xFFF0` (−16 counts):
- Old: `65520 × 79.16 / 32768 ≈ 158.3 A` → trips `chgI <= 100` → poll rejected
- New: `−16 × 79.16 / 32768 ≈ −0.039 A` → clamped to 0.0 → poll succeeds

---

#### Step 1.2 — Decouple plausibility clamp from transport health

**What:** Change the plausibility gate so only battery voltage (`battV`) can fail the poll. Treat
current and array voltage as data-quality fields: clamp/saturate out-of-range values instead of
setting `success = false`.

**Why (v19.0, v20.0):** `scOk` is consumed by the dashboard as transport health. A CRC-valid,
correctly-addressed Modbus response should never drive `scOk:0`. The clamp should protect data
quality, not hide a working link.

**Where:** `TankAlarm_Solar.cpp`, inside `readRegisters()`, the plausibility block (~L310–340).

**Code:**
```cpp
float battV = scaleVoltage(realtimeRegs[0]);
float arrV  = scaleVoltage(realtimeRegs[1]);
float chgI  = scaleCurrentSigned(realtimeRegs[2]);  // index adjusted after Step 1.3
float lodI  = scaleCurrentSigned(realtimeRegs[3]);   // index adjusted after Step 1.3

// Saturate small negative currents to zero (normal near-zero/no-charge condition)
if (chgI < 0.0f) chgI = 0.0f;
if (lodI < 0.0f) lodI = 0.0f;

// Battery voltage is the ONLY transport-health gate.
// Current and array voltage are data-quality: clamp, don't fail.
if (battV >= 5.0f && battV <= 40.0f) {
  nextData.batteryVoltage = battV;
  nextData.arrayVoltage   = (arrV >= 0.0f && arrV <= 100.0f) ? arrV : nextData.arrayVoltage;
  nextData.chargeCurrent  = (chgI <= 100.0f) ? chgI : nextData.chargeCurrent;
  nextData.loadCurrent    = (lodI <= 100.0f) ? lodI : nextData.loadCurrent;
  // success stays true → communicationOk → scOk:1
} else {
  Serial.print(F("WARNING: Solar battery voltage implausible (bv="));
  Serial.print(battV);
  Serial.println(F("), rejecting poll"));
  success = false;
}
```

**Verification:** Confirm that `scOk:1` is emitted when Modbus reads succeed but a filtered current
is near zero/negative.

---

#### Step 1.3 — Align realtime register set with bench-proven sketch (skip 0x000A)

**What:** Replace the contiguous 5-register read (`0x0008–0x000C`) with explicit reads of the 4
registers the bench-proven `sunsaver-modbus-test.ino` reads: `0x0008`, `0x0009`, `0x000B`, `0x000C`.
Skip unused `0x000A` (load voltage).

**Why (v16.0–v20.0, unanimous):** `realtimeRegs[2]` (0x000A) is populated but never referenced. If
this register NACKs on a particular SunSaver firmware revision, the entire poll fails due to
`readRegistersIndividually()` short-circuiting. One wasted Modbus round-trip per poll.

**Where:** `TankAlarm_Solar.cpp`, inside `readRegisters()`, the realtime read block (~L280–310).

**Code:**
```cpp
// Read EXACTLY the four registers the bench-proven sunsaver-modbus-test.ino reads.
// Skip 0x000A (load voltage) — it was read but never consumed.
uint16_t realtimeRegs[4];
bool realtimeOk = false;

for (uint8_t attempt = 0; attempt < SOLAR_REALTIME_MAX_ATTEMPTS && !realtimeOk; ++attempt) {
  if (attempt > 0) {
    delay(SOLAR_RETRY_DELAY_MS);
  }
  TANKALARM_WATCHDOG_KICK(Watchdog::get_instance());

  bool rOk = readRegistersWithFallback(_config.modbusSlaveId, SS_REG_BATTERY_VOLTAGE, 1,
                                        &realtimeRegs[0], _cachedHoldingFC);
  if (rOk) {
    TANKALARM_WATCHDOG_KICK(Watchdog::get_instance());
    rOk = readRegistersWithFallback(_config.modbusSlaveId, SS_REG_ARRAY_VOLTAGE, 1,
                                     &realtimeRegs[1], _cachedHoldingFC);
  }
  if (rOk) {
    TANKALARM_WATCHDOG_KICK(Watchdog::get_instance());
    rOk = readRegistersWithFallback(_config.modbusSlaveId, SS_REG_CHARGE_CURRENT, 1,
                                     &realtimeRegs[2], _cachedHoldingFC);
  }
  if (rOk) {
    TANKALARM_WATCHDOG_KICK(Watchdog::get_instance());
    rOk = readRegistersWithFallback(_config.modbusSlaveId, SS_REG_LOAD_CURRENT, 1,
                                     &realtimeRegs[3], _cachedHoldingFC);
  }

  if (rOk) {
    realtimeOk = true;
  }
}
```

**Note:** Index mapping changes — `realtimeRegs[2]` is now charge current (was 0x000A),
`realtimeRegs[3]` is now load current (was 0x000C). Update all downstream references in the
plausibility block (Step 1.2).

---

#### Step 1.4 — Fix setpoint gap register (skip 0x0034)

**What:** Replace the contiguous 4-register setpoint read with explicit reads of the 3 actually-used
registers: `0x0033` (V_REG), `0x0035` (V_FLOAT), `0x0036` (V_EQ). Skip `0x0034` (AH_DAILY/gap).

**Why (v12.0, v16.0–v20.0, unanimous):** Register `0x0034` is read but never used. If it fails,
`readRegistersIndividually()` short-circuits AND clears `_cachedHoldingFC` to 0, forcing FC
re-probing on subsequent reads.

**Where:** `TankAlarm_Solar.cpp`, inside `readRegisters()`, the setpoint block (~L338–380).

**Code:**
```cpp
if (success && !nextData.setpointsValid) {
  uint16_t vRegRaw = 0, vFloatRaw = 0, vEqRaw = 0;

  bool spOk = readRegistersWithFallback(_config.modbusSlaveId, SS_REG_V_REG, 1,
                                         &vRegRaw, _cachedHoldingFC);
  if (spOk) {
    spOk = readRegistersWithFallback(_config.modbusSlaveId, SS_REG_V_FLOAT, 1,
                                      &vFloatRaw, _cachedHoldingFC);
  }
  if (spOk) {
    spOk = readRegistersWithFallback(_config.modbusSlaveId, SS_REG_V_EQ, 1,
                                      &vEqRaw, _cachedHoldingFC);
  }

  if (spOk) {
    float vReg   = scaleVoltage(vRegRaw);
    float vFloat = scaleVoltage(vFloatRaw);
    float vEq    = scaleVoltage(vEqRaw);
    // existing chemistry checks and assignment unchanged
  }
}
```

---

#### Step 1.5 — Add Modbus error taxonomy and response timing capture

**What:** Capture `ModbusRTUClient.lastError()`, failing register address, and response time on every
failed Modbus request. Expose via compile-safe class methods.

**Why (v12.0–v20.0, unanimous):** Today `scOk:0` collapses four distinct causes (timeout, CRC error,
illegal function, clamp reject) into one bit. `lastError()` distinguishes them. The bench-proven
sketch already captures this; production does not.

**Where:**
- `TankAlarm_Solar.cpp` — file-local state + `noteSolarModbusFailure()` + method definitions
- `TankAlarm_Solar.h` — public method declarations in `SolarManager`

**Header declarations (`TankAlarm_Solar.h`):**
```cpp
// Public SolarManager methods
uint32_t getModbusErrorCount() const;
const char* getLastModbusError() const;
uint16_t getLastModbusFailAddress() const;
uint16_t getLastModbusResponseMs() const;
void resetModbusErrorStats();
```

**Source implementation (`TankAlarm_Solar.cpp`):**
```cpp
static uint32_t sSolarModbusErrorCount = 0;
static char sSolarLastModbusError[40] = {0};
static uint16_t sSolarLastFailAddress = 0;
static uint16_t sSolarLastResponseMs = 0;

static void noteSolarModbusFailure(uint16_t address, uint16_t elapsedMs) {
  ++sSolarModbusErrorCount;
  sSolarLastFailAddress = address;
  sSolarLastResponseMs = elapsedMs;

  const char *e = ModbusRTUClient.lastError();
  if (!e || !e[0]) e = "unknown";
  size_t i = 0;
  for (; e[i] && i < sizeof(sSolarLastModbusError) - 1; ++i) {
    sSolarLastModbusError[i] = e[i];
  }
  sSolarLastModbusError[i] = '\0';
}
```

**Instrument both read helpers:**
```cpp
static bool readHoldingRegisters(uint8_t slaveId, uint16_t startAddress,
                                  uint8_t count, uint16_t *buffer) {
  drainRS485Rx();
  unsigned long t0 = millis();
  if (!ModbusRTUClient.requestFrom(slaveId, HOLDING_REGISTERS, startAddress, count)) {
    noteSolarModbusFailure(startAddress, (uint16_t)(millis() - t0));
    return false;
  }
  sSolarLastResponseMs = (uint16_t)(millis() - t0);
  // ... existing read loop unchanged ...
}
```

**Telemetry integration** — add compact fields to daily solar failure block only (not every note):
```cpp
if (!data.communicationOk) {
  solarObj["merr"]    = gSolarManager.getModbusErrorCount();
  solarObj["maddr"]   = gSolarManager.getLastModbusFailAddress();
  solarObj["mms"]     = gSolarManager.getLastModbusResponseMs();
  const char *lastErr = gSolarManager.getLastModbusError();
  if (lastErr && lastErr[0]) solarObj["merrTxt"] = lastErr;
}
```

---

#### Step 1.6 — Add RS-485 receive buffer drain before Modbus transactions

**What:** Drain stale bytes from the RS-485 UART receive buffer before each Modbus request.

**Why (v16.0–v18.0):** The ArduinoModbus library enables `MODBUS_ERROR_RECOVERY_PROTOCOL` (flushes
on CRC/FC errors) but NOT `MODBUS_ERROR_RECOVERY_LINK` (no flush on timeout). Stale bytes from late
responses or bus noise can persist after a timeout. An application-level drain is a safe belt-and-
suspenders defense.

**Where:** `TankAlarm_Solar.cpp`, at the top of both `readHoldingRegisters()` and
`readInputRegisters()`.

**Code:**
```cpp
static void drainRS485Rx() {
  while (RS485.available()) {
    (void)RS485.read();
  }
}
```

---

#### Step 1.7 — (Optional) Preserve FC cache on transient failure

**What:** Don't clear `_cachedHoldingFC` when the primary FC fails — only update the cache if the
alternate FC *succeeds*. This prevents one timeout from forcing FC re-probing on every subsequent
read.

**Why (v17.0):** Current code clears the cache before trying the alternate FC. Under heavy bus noise
or transient failures, this causes unnecessary FC04 probes on a SunSaver that only supports FC03.

**Where:** `TankAlarm_Solar.cpp`, `readRegistersWithFallback()` (~L55–99).

**Code:** See v17.0 Section 2 for the complete rewritten function. Key change: remove the
`cachedFC = 0` clear on primary failure; only update `cachedFC` when an alternate FC succeeds.

---

#### Step 1.8 — (Optional) Add FC03-only mode for SunSaver/MRC-1

**What:** Add a `forceHoldingRegisters` boolean to `SolarConfig`. When true, skip FC04 fallback
entirely, matching the bench-proven sketch.

**Why (v17.0):** Halves timeout on a dead bus. Eliminates FC cache complexity for known FC03 devices.

**Where:**
- `TankAlarm_Solar.h` — add field to `SolarConfig`
- `TankAlarm_Solar.cpp` — conditional bypass in `readRegistersWithFallback()`
- Client `.ino` — add to `sanitizeSolarConfig()`

**Risk:** Very low (defaults to current behavior if not set). Can be deferred to a follow-up release.

---

### Phase 2 — A0602 Current-Loop Hardening (Problem 2)

**Goal:** Ensure the A0602 expansion is genuinely in current-ADC mode before trusting reads, make
framed-path failures visible in fleet diagnostics, and reduce I2C bus contention between the Notecard
and A0602.

**Files modified:**
- `TankAlarm-112025-Common/src/TankAlarm_I2C.h`
- `TankAlarm-112025-Client-BluesOpta/TankAlarm-112025-Client-BluesOpta.ino`

---

#### Step 2.1 — Add `GET_CHANNEL_FUNCTION (0x40)` verification helpers

**What:** Add two new static inline functions to `TankAlarm_I2C.h`:
1. `tankalarm_getAnalogChannelFunction()` — sends `GET 0x40` and parses the answer
2. `tankalarm_waitCurrentAdcFunction()` — polls until the channel reports function `0x04`
   (`CH_FUNC_CURRENT_INPUT_EXT_POWER`) or timeout

**Why (v12.0, v13.0, v14.0 — verified safe):** The `SET CH_ADC` ACK only means "queued," not
"applied." `GET_CHANNEL_FUNCTION` proves the AD74412R is actually in current-ADC mode. v14.0
traced through `OptaAnalog.cpp::parse_setup_adc_channel()` and confirmed `0x04` is the correct
constant for production's config frame (`ADDING_ADC = OA_DISABLE`).

**Where:** `TankAlarm_I2C.h`, after `tankalarm_configureCurrentAdcChannel()` (~L405).

**Code:** Use the verified helper bodies from v13.0/v14.0/v15.0 (all three agree on the wire
format):
```cpp
#ifndef TANKALARM_OA_FUNC_CURRENT_INPUT_EXT_POWER
#define TANKALARM_OA_FUNC_CURRENT_INPUT_EXT_POWER 0x04
#endif

static inline bool tankalarm_getAnalogChannelFunction(uint8_t channel, uint8_t i2cAddr,
                                                       uint8_t &funOut) {
  uint8_t req[5];
  req[0] = 0x02;      // BP_CMD_GET
  req[1] = 0x40;      // ARG_GET_CHANNEL_FUNCTION
  req[2] = 0x01;      // LEN
  req[3] = channel;
  req[4] = tankalarm_optaCrc8(req, 4);

  Wire.beginTransmission(i2cAddr);
  Wire.write(req, sizeof(req));
  if (Wire.endTransmission() != 0) return false;

  delay(1);
  uint8_t ans[6], n = 0;
  uint8_t got = Wire.requestFrom(i2cAddr, (uint8_t)sizeof(ans));
  while (Wire.available() && n < sizeof(ans)) ans[n++] = Wire.read();
  while (Wire.available()) (void)Wire.read();

  if (got != sizeof(ans) || n != sizeof(ans)) return false;
  if (ans[0] != 0x03 || ans[1] != 0x40 || ans[2] != 0x02 || ans[3] != channel) return false;
  if (tankalarm_optaCrc8(ans, 5) != ans[5]) return false;

  funOut = ans[4];
  return true;
}

static inline bool tankalarm_waitCurrentAdcFunction(uint8_t channel, uint8_t i2cAddr,
                                                     uint16_t timeoutMs = 100) {
  const unsigned long start = millis();
  while ((millis() - start) < timeoutMs) {
    uint8_t fun = 0xFF;
    if (tankalarm_getAnalogChannelFunction(channel, i2cAddr, fun) &&
        fun == TANKALARM_OA_FUNC_CURRENT_INPUT_EXT_POWER) {
      return true;
    }
    delay(5);
  }
  return false;
}
```

**Critical coupling note (v14.0):** The `0x04` expectation is tied to production sending
`ADDING_ADC = OA_DISABLE`. If that config byte ever changes to `OA_ENABLE`, the expected function
becomes `0x05` (`LOOP_POWER`). Document this coupling in a comment next to the `#define`.

---

#### Step 2.2 — Make config failure fatal with proper cleanup

**What:** In `readCurrentLoopSensor()`, replace the current non-fatal config warning with a fatal
path: verify channel function after config, and on failure, turn P1 OFF, restore
`Wire.setTimeout()`, increment `gCurrentLoopI2cErrors`, and return `NAN`.

**Why (v12.0–v15.0, unanimous):** Silently reading from an unconfirmed channel is how the stale
`18.02 mA` reading occurred.

**Where:** Client `.ino`, `readCurrentLoopSensor()` (~L5412).

**Code:**
```cpp
Wire.setTimeout(100);  // A0602-specific tolerance (match bench test)

bool adcConfigOk = false;
for (uint8_t attempt = 0; attempt < 3 && !adcConfigOk; ++attempt) {
  if (attempt > 0) delay(10);
  if (tankalarm_configureCurrentAdcChannel((uint8_t)channel, i2cAddr) &&
      tankalarm_waitCurrentAdcFunction((uint8_t)channel, i2cAddr, 100)) {
    adcConfigOk = true;
  }
}

if (!adcConfigOk) {
  Serial.print(F("ERROR: A0602 current-ADC mode not confirmed on ch "));
  Serial.println(channel);
  gCurrentLoopI2cErrors++;
  gMonitorState[idx].currentSensorMa = 0.0f;
  gMonitorState[idx].sampleReused = true;
  if (cfg.pwmGatingEnabled) {
    (void)tankalarm_setPwm(cfg.pwmGatingChannel, 0, 0, i2cAddr);
  }
  Wire.setTimeout(I2C_WIRE_TIMEOUT_MS);  // MUST restore before every return
  return NAN;
}
```

**IMPORTANT:** Audit ALL return paths in `readCurrentLoopSensor()` to ensure
`Wire.setTimeout(I2C_WIRE_TIMEOUT_MS)` is called before returning. The local `Wire.setTimeout(100)`
must never leak to Notecard operations.

---

#### Step 2.3 — Add framed-path failure accounting

**What:** Increment `gCurrentLoopI2cErrors` when all framed ADC samples fail in a cycle, so the
existing `i2c_cl_err` / `i2c-error-rate` telemetry reflects framed-path failures.

**Why (v12.0, v13.0):** Currently `gCurrentLoopI2cErrors` is only fed by the legacy raw helper. The
framed production path is invisible to fleet diagnostics.

**Where:** Client `.ino`, `readCurrentLoopSensor()`, after the sample loop (~L5441).

**Code:**
```cpp
if (validSamples == 0) {
  gCurrentLoopI2cErrors++;
  gMonitorState[idx].currentSensorMa = 0.0f;
  gMonitorState[idx].sampleReused = true;
  Wire.setTimeout(I2C_WIRE_TIMEOUT_MS);
  return NAN;
}
```

---

#### Step 2.4 — Retry P1 power-OFF gating

**What:** Replace the single-shot P1 OFF command with a 3-attempt retry loop (matching the existing
P1 ON retry pattern).

**Why (v12.0, v13.0):** Failing OFF leaves the 4–20 mA transmitter powered, distorting the power
budget and future observations on a solar site.

**Where:** Client `.ino`, `readCurrentLoopSensor()`, the PWM-OFF block (~L5478).

**Code:**
```cpp
if (cfg.pwmGatingEnabled) {
  bool pwmOffSuccess = false;
  for (uint8_t attempt = 0; attempt < 3 && !pwmOffSuccess; ++attempt) {
    if (attempt > 0) delay(5);
    pwmOffSuccess = tankalarm_setPwm(cfg.pwmGatingChannel, 0, 0, i2cAddr);
  }
  if (!pwmOffSuccess) {
    Serial.print(F("WARNING: Failed to disable sensor power gating on P"));
    Serial.print(cfg.pwmGatingChannel + 1);
    Serial.println(F(" via I2C"));
    gCurrentLoopI2cErrors++;
  }
}
```

---

#### Step 2.5 — Defer Notecard outbox trimming + Wire buffer drain

**What:** On devices with current-loop monitors, move `trimTelemetryOutbox()` to AFTER sampling
(not before). Add a `Wire` buffer drain before starting A0602 operations.

**Why (v12.0, v13.0):** `trimTelemetryOutbox()` performs multiple blocking Notecard I2C transactions
on the same Wire bus the A0602 shares. If a Notecard transaction leaves partial data in the Wire
buffer, it can corrupt subsequent A0602 responses.

**Where:** Client `.ino`, `sampleMonitors()` (~L5618).

**Code:**
```cpp
static bool hasCurrentLoopMonitor() {
  for (uint8_t i = 0; i < gConfig.monitorCount; ++i) {
    if (gConfig.monitors[i].sensorInterface == SENSOR_CURRENT_LOOP) return true;
  }
  return false;
}

static void sampleMonitors() {
  if (isSolarOnlyActive() && !isSensorVoltageGateOpen()) {
    return;
  }

  const bool deferTrim = hasCurrentLoopMonitor();
  if (!deferTrim) {
    trimTelemetryOutbox();
  }

  // Drain any stale Wire buffer data from prior Notecard transactions
  while (Wire.available()) { (void)Wire.read(); }

  for (uint8_t i = 0; i < gConfig.monitorCount; ++i) {
    // existing monitor sampling loop unchanged
  }

  if (deferTrim) {
    trimTelemetryOutbox();
  }
}
```

---

### Phase 3 — Server Alarm Hygiene (Problem 3)

**Goal:** Auto-clear stale `sensor-fault` alarms when the client resumes sending fresh telemetry
with `ru:0`.

**Files modified:**
- `TankAlarm-112025-Server-BluesOpta/TankAlarm-112025-Server-BluesOpta.ino`

---

#### Step 3.1 — Auto-clear `sensor-fault` on fresh data

**What:** In `handleTelemetry()`, when a record has `alarmActive == true` and
`alarmType == "sensor-fault"`, check if the incoming telemetry has `ru == false` (fresh reading). If
so, clear the alarm.

**Why:** After Problem 2 fixes ship, the client will resume sending fresh data. The server currently
latches `sensor-fault` until manually cleared.

**Where:** Server `.ino`, `handleTelemetry()`.

**Note:** This is lower priority than Phases 1–2 because it only matters after the client-side
fixes produce fresh readings. Can be shipped in the same release or a follow-up.

---

### Phase 4 — Build, Test & Deploy

---

#### Step 4.1 — Compile all targets

Compile all four targets to verify no build errors:
```
arduino-cli compile -b arduino:mbed_opta:opta TankAlarm-112025-Server-BluesOpta/
arduino-cli compile -b arduino:mbed_opta:opta TankAlarm-112025-Client-BluesOpta/
arduino-cli compile -b arduino:mbed_opta:opta TankAlarm-112025-Viewer-BluesOpta/
arduino-cli compile -b arduino:mbed_opta:opta TankAlarm-112025-FTPS_Server_Test/
```

#### Step 4.2 — Bench verification (if hardware available)

If bench hardware is available:

**SunSaver / Modbus verification:**
1. Connect Opta + MRC-1 + SunSaver (crossed A/B polarity)
2. Flash client with Phase 1 changes
3. Verify `scOk:1` appears in serial output
4. Verify `battV`, `arrV`, `chgI`, `lodI` are plausible
5. Verify `lastError()` is NOT called on successful reads (no spurious logging)
6. Simulate a night/no-charge condition and verify negative-current saturation works
7. Disconnect MRC-1 and verify `scOk:0` with `merrTxt: "Connection timed out"`

**A0602 / Current-loop verification:**
8. Connect Opta + A0602 + 4–20 mA transmitter
9. Flash client with Phase 2 changes
10. Verify `GET_CHANNEL_FUNCTION` returns `0x04` and reads succeed
11. Verify P1 ON/OFF cycling works with retry logic
12. Kill power to A0602 mid-read and verify `gCurrentLoopI2cErrors` increments

#### Step 4.3 — OTA deployment plan

If bench testing passes (or if shipping without bench access — see v14.0/v19.0 risk assessment):
1. Tag release (e.g., `v2.0.45`)
2. Build client binary via CI/GitHub Actions
3. Deploy to field device `dev:860322068056545` via Notehub OTA
4. Monitor first 24 hours of telemetry for:
   - `scOk` value change (1 = regression fixed; 0 + `merrTxt` = physical)
   - `ma` / `ru` values (0 = sensor reading fresh; 1 = still failing)
   - `i2c_cl_err` rate (should decrease)
   - `merrTxt` field (reveals transport failure type if `scOk` stays 0)

---

### Consensus "Do NOT Change" List (All Reviews v12.0–v20.0 Agree)

| Item | Reason |
|---|---|
| `RS485.setDelays(0, 1200)` | Forum-proven Opta last-byte fix, bench-verified. Do not add arbitrary pre-delay. |
| `SERIAL_8N2` at 9600 baud | Correct per SunSaver/MRC-1 spec and bench verification. |
| Single-register Modbus reads | Bench-proven; MRC-1 MeterBus bridge has packet size limits. |
| `GET ADC (0x0A)` framed read opcode | Matches the official `pinCurrent(ch,true)` → `getAdc(ch,true)` path. |
| `delay(1)` before A0602 `requestFrom()` | Library uses 0; `delay(1)` is already generous. |
| FC03↔FC04 fallback architecture | Keep for generic device support; make configurable, don't remove. |
| `SOLAR_RETRY_DELAY_MS = 100` | Reasonable MRC-1 turnaround settle time. |
| `ModbusRTUClient.setTimeout(1000)` | More generous than bench (500 ms); safe margin for field conditions. |
| Aggressive `Wire.end()/Wire.begin()` resets | Too disruptive; defer-trim + drain is the safer approach. |
| Full `OptaBlue.h` migration | Architecturally valid but too broad for this patch; targeted fixes close the specific gaps. |

---

### Implementation Todo List

#### Pre-Implementation
- [ ] Create feature branch from `master`
- [ ] Verify clean compile of all targets on current `master`
- [ ] Record baseline field telemetry snapshot from Notehub

#### Phase 1 — SunSaver Modbus (Problem 1)
- [ ] **1.1** Add `scaleCurrentSigned()` function to `TankAlarm_Solar.cpp`
- [ ] **1.2** Refactor plausibility clamp: battery-voltage-only transport gate, saturate currents
- [ ] **1.3** Refactor realtime reads to 4 explicit registers (skip 0x000A)
- [ ] **1.4** Refactor setpoint reads to 3 explicit registers (skip 0x0034)
- [ ] **1.5** Add `noteSolarModbusFailure()` + `lastError()` capture + class method accessors
- [ ] **1.6** Add `drainRS485Rx()` before each Modbus request
- [ ] **1.7** *(Optional)* Preserve FC cache on transient failure
- [ ] **1.8** *(Optional)* Add `forceHoldingRegisters` FC03-only config option

#### Phase 2 — A0602 Current-Loop (Problem 2)
- [ ] **2.1** Add `tankalarm_getAnalogChannelFunction()` and `tankalarm_waitCurrentAdcFunction()` to `TankAlarm_I2C.h`
- [ ] **2.2** Make `adcConfigOk` fatal in `readCurrentLoopSensor()` with proper cleanup and timeout restore
- [ ] **2.3** Add framed-path failure accounting to `gCurrentLoopI2cErrors`
- [ ] **2.4** Add 3-attempt retry for P1 power-OFF gating
- [ ] **2.5** Defer `trimTelemetryOutbox()` on current-loop devices + add Wire buffer drain

#### Phase 3 — Server (Problem 3)
- [ ] **3.1** Auto-clear stale `sensor-fault` alarm on `ru:0` in `handleTelemetry()`

#### Phase 4 — Build, Test & Deploy
- [ ] **4.1** Compile all four targets successfully
- [ ] **4.2** *(If bench available)* Run bench verification for SunSaver + A0602
- [ ] **4.3** Tag release, build via CI, deploy OTA to field device
- [ ] **4.4** Monitor 24-hour post-deploy telemetry for `scOk`, `ma`/`ru`, `merrTxt`, `i2c_cl_err`

---

*This implementation plan consolidates all findings from reviews v12.0 through v20.0. It is ready
for additional reviewer suggestions before coding begins.*

---

## Implementation Plan - GitHub Copilot Review v21.0 - 2026-06-23

**Reviewer:** GitHub Copilot  
**Plan version:** v21.0  
**Purpose:** implementation plan for reviewer discussion before code changes begin. This plan assumes the current
firmware baseline is v2.0.44 and that the review document now contains multiple, sometimes contradictory,
recommendation sections. This v21 plan is intentionally staged: first make failures observable, then apply the
lowest-risk corrective changes, then leave hardware-dependent experiments behind explicit gates.

### Guiding rules for implementation

1. Do not ship speculative RS-485 timing changes as a field fix. Keep `RS485.setDelays(0, 1200)` unless a bench
  sweep with the field MRC-1 harness proves a different value.
2. Do not add `GET_ALL_ADC (0x0B)` as a required A0602 freshness trigger. The current `GET ADC (0x0A)` read path
  matches the official single-channel library path.
3. Do not use inline `SolarManager` accessors in the header that reference `.cpp`-local statics. Add declarations
  in the header and definitions in the `.cpp`.
4. Make any new telemetry compact. Normal telemetry should not grow much; detailed diagnostics belong in daily,
  health, or one-shot diagnostic notes.
5. Favor reversible, low-risk changes for the no-hardware path. Bench-only experiments should stay behind build
  flags, config flags, or explicit diagnostic commands.

---

### Phase 0 - Baseline and branch setup

**Goal:** freeze the current state before touching firmware.

1. Create a working branch, for example `fix/v2.0.45-field-diagnostics`.
2. Confirm the working tree and note unrelated/untracked files. This document is currently untracked, so decide
  whether to add it deliberately or leave it as local review material.
3. Capture a baseline field snapshot from the server/API or Notehub:
  - latest `fv`
  - `scOk`
  - `v` / `vs`
  - `lvl`, `ma`, `ru`, `sf`, `pg`
  - current latched alarm type
4. Compile current `master` once before edits, so any later build failure is attributable to the new work.

**Suggested baseline commands:**

```powershell
git status --short
arduino-cli compile --fqbn arduino:mbed_opta:opta --libraries c:/GitHub/ArduinoSMSTankAlarm/TankAlarm-112025-Common TankAlarm-112025-Client-BluesOpta/TankAlarm-112025-Client-BluesOpta.ino
arduino-cli compile --fqbn arduino:mbed_opta:opta --libraries c:/GitHub/ArduinoSMSTankAlarm/TankAlarm-112025-Common TankAlarm-112025-Server-BluesOpta/TankAlarm-112025-Server-BluesOpta.ino
```

---

### Phase 1 - Observability foundation

**Goal:** make the next field result interpretable. Ship these even if reviewers reorder the corrective fixes.

#### Step 1.1 - Add Solar Modbus failure taxonomy

**Files:** `TankAlarm-112025-Common/src/TankAlarm_Solar.cpp`, `TankAlarm-112025-Common/src/TankAlarm_Solar.h`,
client `.ino` only if fields are serialized.

**Actions:**
1. Add file-local counters/fields in `TankAlarm_Solar.cpp`:
  - error count
  - last error string from `ModbusRTUClient.lastError()`
  - last failing FC (`3` or `4`)
  - last failing address
  - last elapsed ms
2. Add compile-safe `SolarManager` method declarations in `TankAlarm_Solar.h`.
3. Define those methods in `TankAlarm_Solar.cpp`.
4. Call the diagnostic helper in `readHoldingRegisters()` and `readInputRegisters()` on:
  - `requestFrom()` failure
  - `available() < count`
  - `read() < 0`
5. Add compact fields only when solar comm is failing, preferably in the existing daily failure object or health
  telemetry, for example `sc_merr`, `sc_mfc`, `sc_maddr`, `sc_mms`.

**Acceptance criteria:** when the SunSaver is disconnected, the system still reports `scOk:0`, and the new fields
identify `Connection timed out` or the actual library error.

#### Step 1.2 - Add A0602 framed-path failure accounting

**Files:** client `.ino`.

**Actions:**
1. Count framed read failures in `readCurrentLoopSensor()`.
2. Increment `gCurrentLoopI2cErrors` when config verification fails or all framed samples fail.
3. Keep the counter bounded by existing daily reset behavior.

**Acceptance criteria:** if every framed read fails, `gCurrentLoopI2cErrors` increases and downstream daily/health
diagnostics can see the failure.

---

### Phase 2 - A0602 corrective hardening

**Goal:** stop trusting stale or unconfirmed A0602 channel state.

#### Step 2.1 - Add `GET_CHANNEL_FUNCTION (0x40)` helpers

**Files:** `TankAlarm-112025-Common/src/TankAlarm_I2C.h`.

**Actions:**
1. Add `TANKALARM_OA_FUNC_CURRENT_INPUT_EXT_POWER 0x04` with a comment that it depends on
  `ADDING_ADC = OA_DISABLE` in `tankalarm_configureCurrentAdcChannel()`.
2. Add `tankalarm_getAnalogChannelFunction(channel, i2cAddr, functionOut)`.
3. Add `tankalarm_waitCurrentAdcFunction(channel, i2cAddr, timeoutMs)`.
4. Use the existing `tankalarm_optaCrc8()` helper for request and response validation.

**Acceptance criteria:** helper compiles in the shared common header and returns false on malformed/short/wrong-channel
responses.

#### Step 2.2 - Make config verification fatal before reads

**Files:** client `.ino`.

**Actions:**
1. Around A0602 operations only, set `Wire.setTimeout(100)`.
2. Retry `tankalarm_configureCurrentAdcChannel()` up to 3 times.
3. After each successful ACK, call `tankalarm_waitCurrentAdcFunction()`.
4. If the channel never reports current ADC mode:
  - set `currentSensorMa = 0`
  - set `sampleReused = true`
  - increment `gCurrentLoopI2cErrors`
  - turn P1 off if gating is enabled
  - restore `Wire.setTimeout(I2C_WIRE_TIMEOUT_MS)`
  - return `NAN`
5. Restore the default Wire timeout before every existing return path in `readCurrentLoopSensor()`.

**Acceptance criteria:** a failed config no longer proceeds to priming/sampling reads.

#### Step 2.3 - Retry P1 OFF

**Files:** client `.ino`.

**Actions:**
1. Replace the single P1 OFF call with a 3-attempt loop mirroring P1 ON.
2. Increment `gCurrentLoopI2cErrors` if all OFF attempts fail.
3. Keep this independent from whether PWM ACK validation is later added.

**Acceptance criteria:** P1 OFF has the same transient-NACK resilience as P1 ON.

#### Step 2.4 - Move Notecard trimming away from current-loop reads

**Files:** client `.ino`.

**Actions:**
1. Add a `hasCurrentLoopMonitor()` helper or cached flag that is refreshed when config changes.
2. If any current-loop monitor exists, defer `trimTelemetryOutbox()` until after all monitor sampling.
3. Drain `Wire.available()` before sensor reads.
4. Do not add unconditional `Wire.end()` / `Wire.begin()` resets in this phase.

**Acceptance criteria:** current-loop sampling no longer begins immediately after a Notecard outbox trim burst.

---

### Phase 3 - SunSaver parity and diagnostics

**Goal:** under the hardware-correct assumption, remove avoidable differences from the bench path and collect
proof if it still fails.

#### Step 3.1 - Preserve cached FC on transient failure

**Files:** `TankAlarm_Solar.cpp`.

**Actions:**
1. In `readRegistersWithFallback()`, do not clear `_cachedHoldingFC` before trying the alternate FC.
2. Change the cached FC only if the alternate FC succeeds.
3. Leave uncached behavior unchanged.

**Acceptance criteria:** one failed FC03 read does not turn a known FC03 path into uncached probing unless FC04
actually succeeds.

#### Step 3.2 - Skip unused realtime register `0x000A`

**Files:** `TankAlarm_Solar.cpp`.

**Actions:**
1. Replace the 5-register realtime loop with explicit reads of:
  - `SS_REG_BATTERY_VOLTAGE`
  - `SS_REG_ARRAY_VOLTAGE`
  - `SS_REG_CHARGE_CURRENT`
  - `SS_REG_LOAD_CURRENT`
2. Decode current from the new indexes.
3. Keep the existing retry loop and plausibility checks.

**Acceptance criteria:** production reads the same consumed realtime register set as the minimal bench sketch.

#### Step 3.3 - Skip setpoint gap `0x0034`

**Files:** `TankAlarm_Solar.cpp`.

**Actions:**
1. Replace `readRegistersIndividually(... SS_REG_V_REG, 4 ...)` with explicit one-register reads for:
  - `SS_REG_V_REG`
  - `SS_REG_V_FLOAT`
  - `SS_REG_V_EQ`
2. Keep this best-effort. Do not mark overall solar comm failed if setpoint reads fail.

**Acceptance criteria:** chemistry verification no longer depends on register `0x0034`.

#### Step 3.4 - Add optional raw SunSaver diagnostic

**Files:** client `.ino` plus common if needed.

**Actions:**
1. Add a hard-rate-limited command/config trigger for one raw read of `0x0008`.
2. Emit compact diagnostic output:
  - FC
  - address
  - TX bytes or a request token
  - RX bytes if any
  - elapsed ms
  - `lastError()`
3. Do not run this every poll.

**Acceptance criteria:** if `scOk` remains 0, the next diagnostic note can distinguish no response from CRC/exception/wrong-slave behavior.

---

### Phase 4 - Server alarm hygiene

**Goal:** clear stale alarms only when fresh data proves recovery.

#### Step 4.1 - Auto-clear stale `sensor-fault` after fresh telemetry

**Files:** server `.ino`.

**Actions:**
1. In `handleTelemetry()`, when a sensor has a latched `sensor-fault`, check incoming telemetry for fresh,
  non-reused data (`ru` absent/false and no `sf`).
2. If fresh valid data arrives, clear the latched `sensor-fault` and log the clear event.
3. Do not clear on reused samples.

**Acceptance criteria:** once Problem 2 recovers, the stale dashboard alarm clears without masking a still-failing sensor.

---

### Phase 5 - Build and deploy

**Goal:** verify and ship only after basic compile confidence.

1. Compile client and server.
2. If code touches common library APIs, compile viewer and FTPS test too.
3. If hardware is available, run focused bench tests:
  - A0602 function verify returns `0x04` after config.
  - A0602 P1 OFF retry works.
  - SunSaver still reads `0x0008`, `0x0009`, `0x000B`, `0x000C` on bench.
4. Prepare release notes that explicitly say SunSaver transport was not rewritten.
5. Tag and release as the next version.
6. Monitor field telemetry for 24 hours.

**Post-deploy signals to watch:**
- `scOk`
- solar Modbus error string/address/FC/elapsed fields
- `ma`
- `ru`
- `pg`
- `i2c_cl_err`
- alarm type and alarm clear behavior

---

### No-hardware implementation recommendation

If no bench or site hardware is available, ship this narrower set first:

1. Phase 1.1 Solar Modbus diagnostics.
2. Phase 1.2 A0602 framed-path accounting.
3. Phase 2.1 and 2.2 A0602 function verification with fatal failure.
4. Phase 2.3 P1 OFF retry.
5. Phase 2.4 deferred Notecard trim.
6. Phase 3.1 cached-FC preservation.
7. Phase 3.3 setpoint gap cleanup.

I would **not** ship these without hardware:
- arbitrary RS-485 pre-delay changes
- full `OptaBlue.h` migration
- unconditional `Wire.end()` / `Wire.begin()` bus resets
- re-enabling unverified SunSaver status/fault/daily blocks
- removing per-cycle A0602 config entirely

I am neutral on skipping unused `0x000A` without hardware. It is low risk, but because it changes the realtime
success condition, I would prefer to include it only if reviewers agree that bench parity is more valuable than
preserving the current live-block shape.

---

### Reviewer-facing todo list

#### Planning and baseline
- [ ] Decide whether this review document should be added to Git or remain local/untracked.
- [ ] Create implementation branch from current `master`.
- [ ] Record baseline telemetry from the field device.
- [ ] Compile current `master` before edits.

#### Phase 1 - Observability
- [ ] Add solar Modbus diagnostic state in `TankAlarm_Solar.cpp`.
- [ ] Add compile-safe `SolarManager` diagnostic accessors.
- [ ] Capture `lastError()`, failing FC/address, and elapsed ms in both low-level solar read helpers.
- [ ] Serialize compact solar failure diagnostics only in failure/health/daily paths.
- [ ] Add A0602 framed failure accounting to `gCurrentLoopI2cErrors`.

#### Phase 2 - A0602 hardening
- [ ] Add `tankalarm_getAnalogChannelFunction()` helper.
- [ ] Add `tankalarm_waitCurrentAdcFunction()` helper.
- [ ] Replace non-fatal `adcConfigOk` warning with fatal cleanup and `NAN` return.
- [ ] Restore `Wire.setTimeout(I2C_WIRE_TIMEOUT_MS)` before every return path.
- [ ] Add P1 OFF retry loop.
- [ ] Defer `trimTelemetryOutbox()` on current-loop devices.
- [ ] Drain `Wire.available()` before current-loop sensor reads.

#### Phase 3 - SunSaver parity and cleanup
- [ ] Preserve cached FC unless alternate FC succeeds.
- [ ] Decide whether to skip unused realtime `0x000A` in this release.
- [ ] Skip setpoint gap `0x0034`.
- [ ] Add optional one-shot raw `0x0008` diagnostic trigger.
- [ ] Decide whether FC03-only policy belongs in config, compile flag, or later release.

#### Phase 4 - Server alarm hygiene
- [ ] Add stale `sensor-fault` self-clear on fresh non-reused telemetry.
- [ ] Confirm reused/faulted telemetry does not clear the alarm.

#### Phase 5 - Verification and release
- [ ] Compile client.
- [ ] Compile server.
- [ ] Compile viewer if common APIs changed.
- [ ] Compile FTPS test if common APIs changed.
- [ ] Run bench tests if hardware is available.
- [ ] Prepare release notes.
- [ ] Tag release.
- [ ] Deploy OTA to field client.
- [ ] Monitor 24-hour post-deploy telemetry.

---

**Signed:** GitHub Copilot  
**Plan version:** v21.0  
**Date:** 2026-06-23  
**Status:** implementation plan appended for reviewer suggestions before coding.

---

## Consolidated Master Implementation Plan & Definitive Todo List — 2026-06-23

**Reviewer:** GitHub Copilot  
**Document Context:** This section merges the findings and recommendations of all previous passes (v12.0 through v21.0) into a single, cohesive, finalized, and risk-checked Master Implementation Plan. This provides a clear, step-by-step pathway for the upcoming deployment, specifically structured to decouple high-risk timing overrides from fundamental, high-confidence stability/diagnostic upgrades.

---

### Step-by-Step Implementation Flow

The deployment is broken down into structured phases to maintain system safety, ensure robust compile validation, and leverage fleet observability immediately after flashing.

#### 1. Phase 1 — Pre-Implementation and Baseline Setup
Set up the workspace, save baseline snapshots of the subject field client (dev:860322068056545), and ensure compilation is successful on master before any changes are introduced.
1. Create a workspace feature branch `fix/field-mppt-i2c-gated-reissues`.
2. Retrieve and document the current applied configuration of Cox Wellhead under the Silas site via physical server APIs or Notehub events.
3. Record current baseline metrics: `lvl`, `ma`, `ru`, `sf`, `scOk`, and `v`.
4. Compile all four Arduino targets in the workspace (`client`, `server`, `viewer`, `ftps`) to establish a clean build status baseline.

#### 2. Phase 2 — Common Header Hardening (Targeted I2C Verification)
Implement the raw actual-status function verification helper tools inside the shared common I2C header.
1. Add `TANKALARM_OA_FUNC_CURRENT_INPUT_EXT_POWER` definition set to `0x04` in [TankAlarm-112025-Common/src/TankAlarm_I2C.h](TankAlarm-112025-Common/src/TankAlarm_I2C.h). Add comments detailing its direct dependency on the gating configuration (`ADDING_ADC` set to `OA_DISABLE`).
2. Add the structured frame validator `tankalarm_getAnalogChannelFunction()` to query the expansion actual function state (`GET 0x40`).
3. Add the timed poller helper `tankalarm_waitCurrentAdcFunction()` to block safely up to a given timeout until the target channel function stabilizes to `0x04`.

#### 3. Phase 3 — Solar Modbus Diagnostic State & Accessors (Common Solar)
Expose direct diagnostic metrics for Modbus RTU telemetry, allowing the server interface to track precisely why the SunSaver might fail.
1. Add local counters and error-tracking buffers at file-scope inside [TankAlarm-112025-Common/src/TankAlarm_Solar.cpp](TankAlarm-112025-Common/src/TankAlarm_Solar.cpp): `sSolarModbusErrorCount`, `sSolarLastModbusError`, `sSolarLastFailAddress`, `sSolarLastFailFunction`, and `sSolarLastResponseMs`.
2. Define compile-safe `SolarManager` method declarations in [TankAlarm-112025-Common/src/TankAlarm_Solar.h](TankAlarm-112025-Common/src/TankAlarm_Solar.h) and implement them inside [TankAlarm-112025-Common/src/TankAlarm_Solar.cpp](TankAlarm-112025-Common/src/TankAlarm_Solar.cpp).
3. Call the diagnostic logger helper in `readHoldingRegisters()` and `readInputRegisters()` on all failure modes (`requestFrom()` failure, `available()` underrun, or bad register data).

#### 4. Phase 4 — Client-Side Hard Gating & Timing Alignment (Client .ino)
Apply fatal configuration handshakes, clean UART buffers, and relocate outbox trimming on current-loop systems to decouple bus contention.
1. Modify `readCurrentLoopSensor()` in [TankAlarm-112025-Client-BluesOpta/TankAlarm-112025-Client-BluesOpta.ino](TankAlarm-112025-Client-BluesOpta/TankAlarm-112025-Client-BluesOpta.ino): set the local I2C transaction timeout to 100 ms safely before setup begins, and immediately restore the `Wire` standard timeout of 25 ms before any subsequent return exits the function.
2. Replace the old non-fatal configuration ACK warning by calling `tankalarm_waitCurrentAdcFunction()` with a 100 ms limit. If verification fails, make the condition fatal: turn P1 OFF, bump `gCurrentLoopI2cErrors`, set `sampleReused = true`, restore default `Wire` timeout, and return `NAN`.
3. Track framed-path failures in `readCurrentLoopSensor()` by incrementing `gCurrentLoopI2cErrors` on raw framing failures.
4. Replace the single-shot P1 OFF command in `readCurrentLoopSensor()` with a robust 3-attempt loop matching P1 ON.
5. In [TankAlarm-112025-Client-BluesOpta/TankAlarm-112025-Client-BluesOpta.ino](TankAlarm-112025-Client-BluesOpta/TankAlarm-112025-Client-BluesOpta.ino), modify `sampleMonitors()`: if any current-loop monitor is assigned, defer `trimTelemetryOutbox()` execution until *after* all sample sweeps have finished. Incorporate a preceding serial bus drain (`Wire.available()`) loop before the sensor loop begins.

#### 5. Phase 5 — SunSaver Register Map Optimizations & Cleanup (Common Solar)
Refactor the solar Poller sequences inside [TankAlarm-112025-Common/src/TankAlarm_Solar.cpp](TankAlarm-112025-Common/src/TankAlarm_Solar.cpp) to bypass unverified address ranges and prevent FC-cache poisoning.
1. Add `drainRS485Rx()` to flush trailing serial noise bytes from the core RS-485 transceiver before any new Modbus command is written.
2. In `readRegisters()`, query only the four actually-consumed real-time registers (avoiding unused index `0x000A` as proven in the mini-test sketch).
3. In `readRegisters()`, query the setpoint values using explicit non-contiguous calls to avoid unverified setpoint address gap `0x0034`. Keep this best-effort so a gap-NACK never invalidates real-time voltage tracking.
4. In `readRegistersWithFallback()`, preserve the verified active `_cachedHoldingFC` on single-poll timeout anomalies unless the alternative function code explicitly succeeds.

#### 6. Phase 6 — Server-Side Alarm Reset Hygiene (Server .ino)
Enable self-healing alarms on the dashboard corresponding with real hardware recoveries.
1. In `handleTelemetry()` inside [TankAlarm-112025-Server-BluesOpta/TankAlarm-112025-Server-BluesOpta.ino](TankAlarm-112025-Server-BluesOpta/TankAlarm-112025-Server-BluesOpta.ino), locate the `sensor-fault` alarm block.
2. Check incoming metadata: if a sensor currently has a logged `sensor-fault` but fresh valid telemetry arrives with `ru:0` (no sample reuse, no `sf`), auto-clear the latched server alarm.

---

### Master Todo List

#### Workspace Setup
- [ ] Create branch `fix/field-mppt-i2c-gated-reissues` from master
- [ ] Compile current codebase on all four targets to verify no pre-existing master bugs
- [ ] Save snapshot of current event structures from Notehub for Silas site

#### TankAlarm_I2C.h (Common)
- [ ] Define `TANKALARM_OA_FUNC_CURRENT_INPUT_EXT_POWER` as `0x04` with comments explaining its configuration dependency
- [ ] Write static inline `tankalarm_getAnalogChannelFunction()` to query configured channel state
- [ ] Write static inline `tankalarm_waitCurrentAdcFunction()` with safety timeout polling

#### TankAlarm_Solar (Common)
- [ ] Declare diagnostic accessors in `TankAlarm_Solar.h`: `getModbusErrorCount()`, `getLastModbusError()`, `getLastModbusFailAddress()`, `getLastModbusFailFunction()`, and `getLastModbusResponseMs()`
- [ ] Declare class method `resetModbusErrorStats()` to wipe running telemetry structures
- [ ] Define the diagnostic variables and implement accessors inside `TankAlarm_Solar.cpp`
- [ ] Call `noteSolarModbusFailure()` in `readHoldingRegisters()` and `readInputRegisters()` on all failure paths
- [ ] Write helper `drainRS485Rx()` to flush raw UART receive buffers before write attempts
- [ ] In `readRegisters()`, change real-time polling to four explicit register reads, bypassing index `0x000A`
- [ ] In `readRegisters()`, replace contiguous setpoint reads with explicit reads of `0x0033`, `0x0035`, and `0x0036`, skipping `0x0034`
- [ ] In `readRegistersWithFallback()`, keep `_cachedHoldingFC` intact on single timeouts unless the fall-back FC succeeds

#### TankAlarm-112025-Client-BluesOpta.ino
- [ ] Set `Wire.setTimeout(100)` locally during `readCurrentLoopSensor()` execution
- [ ] Audit and ensure `Wire.setTimeout(I2C_WIRE_TIMEOUT_MS)` is called before EVERY return path inside `readCurrentLoopSensor()`
- [ ] Add the fatal `tankalarm_waitCurrentAdcFunction()` confirmation handshake. If failed, trigger fatal error handling
- [ ] Implement M-1 framed failure recording inside the sampling loop of `readCurrentLoopSensor()`
- [ ] Implement M-2 retry loops (3 attempts) on P1 OFF gating
- [ ] Write `hasCurrentLoopMonitor()` helper to check configuration mappings
- [ ] Implement F-9 deferred outbox trimming inside `sampleMonitors()` for current-loop devices
- [ ] Ensure `Wire` is drained with a local read loop before sampling begins

#### TankAlarm-112025-Server-BluesOpta.ino
- [ ] Track incoming telemetry in `handleTelemetry()`
- [ ] Auto-clear latched server `sensor-fault` alarms when a clean, non-reused (`ru:0`, no `sf`) packet is processed for that sensor index

#### Verification and Release
- [ ] Compile the client target and resolve compile warnings or errors
- [ ] Compile the server target and resolve compile warnings or errors
- [ ] Compile the viewer and FTPS test targets to ensure library interfaces remains clean
- [ ] *(If bench available)* Run the A0602 loop simulator and Modbus simulator checklists
- [ ] Build release tag and prepare deployment notes
- [ ] Deploy client OTA via Notehub and watch 24h metrics for `scOk`, `lvl`, and `merrTxt`

---

**Signed:** GitHub Copilot  
**Plan version:** v22.0 — Consolidated Master Implementation Plan  
**Date:** 2026-06-23  
**Status:** Consolidated Master plan appended; ready for additional reviewer suggestions before coding.

---

## Step-by-Step Implementation Plan for Additional Reviewer Passes (v23.0)

**Intent:** Provide one implementation sequence reviewers can critique and refine before coding starts.
**Scope:** Client + common solar + common I2C + server alarm hygiene.
**Assumption:** MRC-1/SunSaver hardware path is physically correct and matches prior bench-proven setup.

### Step 1 - Freeze Baseline and Capture Pre-Change Evidence

1. Create a feature branch from `master`.
2. Build all production targets once and record pass/fail state.
3. Export a baseline telemetry snapshot for affected field devices (`scOk`, battery voltage fields, `ru`, `ma`, `i2c_cl_err`).
4. Preserve current daily solar payload examples for before/after comparison.

### Step 2 - Add Observability First (No Behavior Changes Yet)

1. In SunSaver Modbus paths, capture and store `ModbusRTUClient.lastError()` metadata for failed reads.
2. Add compact telemetry markers that distinguish transport failure from data rejection.
3. Keep existing polling behavior unchanged in this step so data quality can be compared directly.

### Step 3 - Implement SunSaver Regression-Safe Behavior Changes

1. Change current scaling in solar read processing to signed interpretation for current registers.
2. Prevent non-critical plausibility checks from relabeling a transport-successful poll as link-down.
3. Align realtime register reads to the proven set (`0x0008`, `0x0009`, `0x000B`, `0x000C`) and remove unused realtime gap read.
4. Keep `RS485.setDelays(0, 1200)`, 8N2 framing, and timeout floor >= 500 ms unchanged.

### Step 4 - Harden A0602 Current-Loop Path

1. Make channel configuration verification a hard gate before accepting current-loop samples.
2. Ensure current-loop framed failures increment shared I2C failure counters consistently.
3. Add bounded retries for P1 OFF matching the existing ON retry posture.
4. Use local widened I2C timeout around A0602 operations and restore default timeout on every return path.
5. Defer outbox trimming when current-loop monitors exist and drain `Wire` RX before sampling.

### Step 5 - Server Alarm Hygiene

1. Add server-side auto-clear logic for stale `sensor-fault` when fresh non-reused clean telemetry arrives.
2. Preserve existing protections for true active faults and daily reconciliation rules.

### Step 6 - Verification, Reviewer Checkpoint, and Release Decision

1. Rebuild all targets and confirm no new compile errors.
2. Validate telemetry contract changes against server parsing.
3. Run bench validation if available; otherwise run field-observability validation with clear rollback criteria.
4. Pause for additional reviewer approvals before OTA rollout.

---

### Reviewer Todo List

#### A. Branch and Baseline
- [ ] Create branch for implementation
- [ ] Record baseline compile results for all targets
- [ ] Capture baseline field telemetry examples

#### B. Solar Observability
- [ ] Add last-error capture for Modbus failures
- [ ] Add transport-vs-data-reject telemetry indicators
- [ ] Verify server accepts and stores new indicators

#### C. Solar Behavior Fixes
- [ ] Convert solar current scaling to signed path
- [ ] Update plausibility gating so transport-success is not mislabeled as comm failure
- [ ] Restrict realtime reads to required 4-register set
- [ ] Keep proven RS-485 transport parameters unchanged

#### D. A0602 Hardening
- [ ] Enforce fatal channel-function verification before sampling
- [ ] Ensure framed failures increment I2C error counters
- [ ] Add bounded retries for P1 OFF
- [ ] Apply local 100 ms timeout around A0602 path and restore default timeout on all exits
- [ ] Defer outbox trimming for current-loop systems and drain `Wire` RX pre-sampling

#### E. Server Hygiene
- [ ] Implement stale `sensor-fault` auto-clear on clean telemetry recovery
- [ ] Confirm no regression to active-fault handling

#### F. Validation and Release Readiness
- [ ] Rebuild all targets and resolve any errors
- [ ] Verify telemetry payloads in Notehub after test deployment
- [ ] Compare before/after metrics (`scOk`, voltage fields, `ru`, `ma`, `i2c_cl_err`)
- [ ] Collect reviewer sign-off notes in this document before release candidate tag

---

**Signed:** GitHub Copilot (GPT-5.3-Codex)
**Plan version:** v23.0 - Reviewer-ready implementation sequence
**Date:** 2026-06-23
**Status:** Step-by-step plan and todo list appended at document end for additional reviewer input.

---

## Consolidated & Reviewer-Gated Implementation Plan — v24.0 — 2026-06-23

**Author:** GitHub Copilot (Claude Opus 4.8)
**Plan version:** v24.0 — canonical, de-conflicted, release-split
**Firmware baseline:** v2.0.44 (client + server)
**Purpose:** Three implementation plans now exist (v21.0, the "Consolidated Master" v22.0, and v23.0). They
overlap but **diverge on two real points**, and a coder following them today would not know which to obey. This
plan **supersedes** all three: it reconciles the divergences, splits the work into **two releases by risk**, ties
every step to a **verification signal**, and ends with the **open decisions** the next reviewers should rule on
plus **one merged master todo list**. Nothing here re-opens a refuted item (no `GET_ALL_ADC` trigger, no staging-delay
increase, no `setDelays(200,1200)` field fix, no `OptaBlue.h` rewrite, no unconditional `Wire.end()/begin()`).

### A. Reconciliation of the three prior plans

| Item | v21.0 | v22.0 (Master) | v23.0 | **v24 ruling** |
|---|---|---|---|---|
| Solar `lastError()` taxonomy | ✅ | ✅ | ✅ | **In — Release A** |
| A0602 framed-failure accounting (M-1) | ✅ | ✅ | ✅ | **In — Release A** |
| A0602 `GET_CHANNEL_FUNCTION` fatal verify (E-1) | ✅ | ✅ | ✅ | **In — Release A** (constant `0x04` verified safe, v14) |
| P1 OFF retry (M-2) | ✅ | ✅ | ✅ | **In — Release A** |
| Defer Notecard trim + drain RX (F-9/A-5) | ✅ | ✅ | ✅ | **In — Release A** |
| FC-cache preserve on transient | ✅ | ✅ | — | **In — Release A** |
| Skip setpoint gap `0x0034` | ✅ | ✅ | ✅ | **In — Release A** |
| **Signed current + battery-gated clamp (v19 regression)** | ❌ missing | ❌ missing | ✅ | **In — Release A** (see Decision D1) |
| **Skip unused realtime `0x000A`** | ⚠️ "neutral" | ✅ | ✅ | **In — Release A** (see Decision D2) |
| Server `sensor-fault` self-clear | ✅ | ✅ | ✅ | **In — Release A** |
| RS-485 pre-delay change | bench-only | bench-only | unchanged | **Bench-gated — Release B** |
| Remove per-cycle A0602 config | not now | not now | — | **Bench-gated — Release B** |
| `Wire.setTimeout(100)` around A0602 | ✅ (local) | ✅ (local) | ✅ (local) | **In — Release A** (local-only, restore on every return) |

**The two divergences resolved:** (1) the **v19 clamp/signed-current regression** is the *only* firmware-level
explanation for `scOk:0` on known-good hardware — include it (it is low-risk and self-diagnosing); (2) **skip
`0x000A`** for exact bench-sketch parity — include it (the value is discarded anyway).

### B. Release split (the core structural decision)

- **Release A = v2.0.45 — "Observe & De-risk".** Everything that is diagnostic or a verified-safe correction.
  Shippable as a **client + server OTA with no bench access**. This is the whole plan below except Phase 6.
- **Release B = v2.0.46 — "Bench-gated".** Items that must be proven on the field MRC-1 / A0602 harness first
  (Phase 6). Do **not** ship these blind.

> **Design intent:** Release A is built so that whatever it does *not* fix, it will *explain* — every remaining
> `scOk:0` / `ru:1` will carry a reason code in telemetry, so the next field sample (not a 20th code-review pass)
> decides whether the remaining cause is physical.

---

### C. Step-by-step sequence

#### Phase 0 — Baseline & branch (do first, always)
- **0.1** Branch `fix/v2.0.45-field-diagnostics` from `master`.
- **0.2** Record a baseline field snapshot of `dev:860322068056545` (`fv`, `scOk`, `v`/`vs`, `lvl`, `ma`, `ru`, `sf`, `pg`, latched alarm).
- **0.3** Compile client + server on current `master` (clean baseline so later failures are attributable).
- **Verify:** clean compile; baseline snapshot saved into this document.

#### Phase 1 — Observability (no behavior change) → Release A
- **1.1 Solar Modbus taxonomy** (`TankAlarm_Solar.cpp/.h`): file-local `lastError()` + failing FC + address + elapsed-ms; compile-safe `SolarManager` accessors (declared in `.h`, defined in `.cpp` — **not** inline header accessors to `.cpp` statics). Emit compact fields **only in failure/health/daily** notes (e.g. `sc_merr`, `sc_mfc`, `sc_maddr`).
- **1.2 A0602 framed-path accounting (M-1)** (client `.ino`): bump `gCurrentLoopI2cErrors` when config-verify fails or all framed samples fail.
- **1.3 Transport-vs-reject flag** (`TankAlarm_Solar.cpp` + telemetry): emit `scImpl:1` when a CRC-valid read is rejected by plausibility (distinct from a transport failure) so the dashboard stops conflating "no link" with "values rejected."
- **Verify:** with SunSaver disconnected, telemetry shows `scOk:0` **and** `sc_merr="Connection timed out"`; with a forced out-of-range value, `scImpl:1` appears while the link reads up.

#### Phase 2 — SunSaver regression-safe fixes → Release A
- **2.1 Signed current + battery-gated clamp (v19):** scale `adc_ic_f`/`adc_il_f` as **signed** and saturate small negatives to 0; gate `communicationOk` on **battery voltage plausibility (5–40 V) only**, clamp/keep array/current fields without failing the whole poll. (Removes the introduced path where a healthy read → `scOk:0`.)
- **2.2 Skip unused realtime `0x000A`:** read exactly `0x0008, 0x0009, 0x000B, 0x000C` (bench-sketch parity); keep the v2.0.43 retry loop.
- **2.3 Skip setpoint gap `0x0034`:** explicit reads of `0x0033, 0x0035, 0x0036`; best-effort (never fails the poll).
- **2.4 FC-cache preserve:** in `readRegistersWithFallback()`, do **not** zero `_cachedHoldingFC` before the fallback; change it only if the alternate FC actually succeeds.
- **2.5 Keep locked:** `RS485.setDelays(0, 1200)`, `SERIAL_8N2`, slave 1, timeout floor ≥500 ms — **unchanged**.
- **Verify:** on a healthy bench SunSaver, `scOk:1` with a real `v`; a forced negative current no longer zeroes `scOk`.

#### Phase 3 — A0602 current-loop hardening → Release A
- **3.1 `GET_CHANNEL_FUNCTION (0x40)` helpers** (`TankAlarm_I2C.h`): `tankalarm_getAnalogChannelFunction()` + `tankalarm_waitCurrentAdcFunction()`; constant `TANKALARM_OA_FUNC_CURRENT_INPUT_EXT_POWER = 0x04` **with the comment that it is coupled to `ADDING_ADC = OA_DISABLE`** (verified v14).
- **3.2 Fatal config verify** (client `.ino` `readCurrentLoopSensor()`): `Wire.setTimeout(100)` around A0602 ops; retry config ×3; after each ACK call `waitCurrentAdcFunction()`; on failure → `currentSensorMa=0`, `sampleReused=true`, bump errors, P1 off, restore timeout, return `NAN`. **Restore `Wire.setTimeout(I2C_WIRE_TIMEOUT_MS)` before every return.**
- **3.3 P1 OFF retry (M-2):** 3-attempt loop mirroring P1 ON.
- **3.4 Defer Notecard trim + drain (F-9/A-5):** `hasCurrentLoopMonitor()` flag; on current-loop devices run `trimTelemetryOutbox()` **after** sampling; drain `Wire.available()` before the sensor loop.
- **Keep locked:** `GET ADC (0x0A)` opcode, `delay(1)`, the power-gating sequence — **unchanged**.
- **Verify (bench if available):** function-verify returns `0x04` after config; a forced config NACK returns `NAN` (no stale read); `i2c_cl_err` increments on induced failure.

#### Phase 4 — Server alarm hygiene → Release A
- **4.1** In `handleTelemetry()`, auto-clear a latched `sensor-fault` when fresh **non-reused** (`ru:0`, no `sf`) valid telemetry arrives for that sensor; never clear on reused/faulted samples; preserve daily-reconciliation protections.
- **Verify:** simulated recovery telemetry clears the latch; a reused sample does not.

#### Phase 5 — Build, release A, observe
- **5.1** Compile client + server (+ viewer/FTPS if common APIs changed).
- **5.2** Release notes explicitly state: SunSaver **transport unchanged**; this release adds diagnostics + a clamp/scaling regression fix + A0602 config-verify.
- **5.3** Bump to **v2.0.45**, tag, OTA the client, USB/OTA the server.
- **5.4** Watch 24 h: `scOk`, `sc_merr`/`scImpl`, `v`/`vs`, `ma`, `ru`, `pg`, `i2c_cl_err`, alarm clear behavior.
- **Decision gate:** if `scOk→1` → the clamp regression was the cause (done). If `scOk:0` persists, read `sc_merr`: `timeout` ⇒ physical (proceed to Release B bench items + site visit); `illegal data address` ⇒ a register issue (re-confirm 0x000A/slave); `invalid CRC` ⇒ wire/noise.

#### Phase 6 — Bench-gated items → Release B (v2.0.46), only after hardware proof
- **6.1** Configure-once persistence test (20× P1 cycles + `getChannelFunction`); if config survives, drop per-cycle `SET CH_ADC`.
- **6.2** RS-485 pre-delay **T3.5 (~4000 µs, 8N2)** sweep with the field MRC-1 via `firmware/sunsaver-rs485-windowed-probe`; ship only if it measurably flips `scOk`.
- **6.3** `Wire.setTimeout(100)` WDT-starvation check across multi-sample cycles.
- **6.4** Optional `modbusForceFc03` config (default on for SunSaver) + one-shot raw-frame `0x0008` diagnostic.
- **Verify:** each item has an explicit pass/fail bench criterion before it enters Release B.

---

### D. Open decisions for reviewers (please rule on these)

- **D1 — Ship the v19 signed-current + battery-gated clamp in Release A?** *(v24 recommends YES: it is the only firmware-level `scOk:0` explanation under "hardware correct," low-risk, and self-diagnosing. v21/v22 omitted it.)*
- **D2 — Skip `0x000A` now (bench parity) or defer?** *(v24 recommends YES skip; value is discarded. v21 was neutral.)*
- **D3 — PWM SET-ACK validation: observability-only or hard gate?** *(v24 recommends observability-only first; a flaky ACK must not veto a working P1.)*
- **D4 — Telemetry field names + budget:** confirm `sc_merr`/`sc_mfc`/`sc_maddr`/`scImpl` naming and that they ride **only** in failure/health/daily notes (not every telemetry sample).
- **D5 — Version mapping:** confirm Release A = **v2.0.45**, Release B = **v2.0.46**.
- **D6 — Server self-clear strictness:** clear `sensor-fault` on a single `ru:0` clean sample, or require **N consecutive** clean samples?
- **D7 — Does this review document get committed to Git** or stay local review material? *(Carried over from v21 — still unanswered.)*

---

### E. Master todo list (merged from v21/v22/v23, deduplicated, grouped by file)

#### Branch & baseline
- [ ] Create branch `fix/v2.0.45-field-diagnostics` from `master`
- [ ] Record baseline field telemetry for `dev:860322068056545`
- [ ] Clean-compile client + server on `master`
- [ ] (D7) Decide whether to commit this review doc to Git

#### `TankAlarm-112025-Common/src/TankAlarm_Solar.cpp` / `.h`
- [ ] Add file-local Modbus diag state (`lastError`, fail FC, fail addr, elapsed ms) + compile-safe `SolarManager` accessors
- [ ] Call the diag logger on every failure path in `readHoldingRegisters()` / `readInputRegisters()`
- [ ] **(D1)** Scale `adc_ic_f`/`adc_il_f` as signed; saturate negatives to 0
- [ ] **(D1)** Gate `communicationOk` on battery-voltage plausibility only; emit `scImpl:1` on a CRC-valid-but-rejected read
- [ ] **(D2)** Realtime read = `0x0008,0x0009,0x000B,0x000C` (skip `0x000A`)
- [ ] Setpoint read = explicit `0x0033,0x0035,0x0036` (skip `0x0034`), best-effort
- [ ] Preserve `_cachedHoldingFC` unless the alternate FC succeeds
- [ ] Keep `setDelays(0,1200)`, `8N2`, slave 1, timeout ≥500 ms unchanged

#### `TankAlarm-112025-Common/src/TankAlarm_I2C.h`
- [ ] Add `TANKALARM_OA_FUNC_CURRENT_INPUT_EXT_POWER = 0x04` (comment: coupled to `ADDING_ADC = OA_DISABLE`)
- [ ] Add `tankalarm_getAnalogChannelFunction()` + `tankalarm_waitCurrentAdcFunction()` (reuse `tankalarm_optaCrc8()`)

#### `TankAlarm-112025-Client-BluesOpta/...ino`
- [ ] `Wire.setTimeout(100)` around A0602 ops; **restore `I2C_WIRE_TIMEOUT_MS` before every return**
- [ ] Make config verification fatal (retry ×3 + `waitCurrentAdcFunction`; on fail → `NAN`, P1 off, bump errors)
- [ ] **(M-1)** Bump `gCurrentLoopI2cErrors` on framed-path failures
- [ ] **(M-2)** P1 OFF retry ×3
- [ ] **(D3)** PWM SET-ACK validation — *decide observability-only vs gate*
- [ ] `hasCurrentLoopMonitor()` + defer `trimTelemetryOutbox()` after sampling; drain `Wire` RX before sensor loop

#### `TankAlarm-112025-Server-BluesOpta/...ino`
- [ ] **(D6)** Auto-clear latched `sensor-fault` on fresh `ru:0`/no-`sf` telemetry; never clear on reused; keep daily-reconcile protections

#### Verify & release A (v2.0.45)
- [ ] Compile client + server (+ viewer/FTPS if common APIs changed)
- [ ] Release notes: "SunSaver transport unchanged; diagnostics + clamp/scaling fix + A0602 config-verify"
- [ ] Bump version to **v2.0.45**, tag, OTA client, flash server
- [ ] Monitor 24 h; record `scOk` / `sc_merr` / `scImpl` / `v` / `ma` / `ru` / `i2c_cl_err`
- [ ] **Decision gate:** classify any residual `scOk:0` via `sc_merr` (timeout=physical / illegal-addr / CRC)

#### Bench-gated → release B (v2.0.46)
- [ ] Configure-once persistence test (20× P1 cycles); drop per-cycle config if it survives
- [ ] RS-485 pre-delay **T3.5 (~4000 µs)** sweep with field MRC-1 (ship only if it flips `scOk`)
- [ ] `Wire.setTimeout(100)` WDT-starvation check
- [ ] Optional `modbusForceFc03` + one-shot raw-frame `0x0008` diagnostic

---

### F. Reviewer sign-off (next reviewers: fill in)

| Reviewer | Agrees with release split (A/B)? | D1 | D2 | D3 | D4 | D5 | D6 | D7 | Notes |
|---|---|---|---|---|---|---|---|---|---|
| _(add row)_ | | | | | | | | | |

---

**Signed:** GitHub Copilot (Claude Opus 4.8)
**Plan version:** v24.0 — Consolidated & reviewer-gated implementation plan (supersedes v21/v22/v23 sequencing)
**Date:** 2026-06-23
**Status:** Canonical plan + open-decision list + merged master todo appended at document end for additional reviewer input.

---

## Pre-Flight Addendum to v24.0 — Gaps Found Before Coding — 2026-06-23

**Author:** GitHub Copilot (Claude Opus 4.8). A last sanity pass against the *actual* current source surfaced
**four items the plan omitted** that would bite an implementer. None changes the technical conclusions; all are
mechanical/process gaps. Verified by direct inspection, not memory.

### G-1 (must-fix) — Release mechanics: the version bump is THREE files + a matching tag
The plan says "bump to v2.0.45" but does not name where. Verified source-of-truth:
- `TankAlarm-112025-Common/src/TankAlarm_Common.h`: `FIRMWARE_VERSION "2.0.44"` → **"2.0.45"**, and
  `FIRMWARE_BUILD_SEQ 238` → **239** (monotonic; the OTA downgrade-guard depends on it).
- `TankAlarm-112025-Common/library.properties`: `version=2.0.44` → **2.0.45**.
- Git tag **`v2.0.45`** must be pushed and must equal `FIRMWARE_VERSION` — `release-firmware-112025.yml`
  **fails the build** if the tag (minus `v`) ≠ `Common.h FIRMWARE_VERSION`. A commit/push to `master` alone
  builds **no** release; only the `v*` tag triggers CI.
- **Todo:** `[ ] Bump FIRMWARE_VERSION + FIRMWARE_BUILD_SEQ (238→239) + library.properties; create release-notes/v2.0.45.md; push matching v2.0.45 tag.`

### G-2 (functional gap) — The new solar diagnostics are invisible on the server dashboard
`scaleCurrent`/`scOk` aside, a grep of the **server** `.ino` finds **no parser** for `scOk`, `sc_merr`, or
`scImpl`. So the Phase-1 diagnostic fields the client will emit are visible **only in raw Notehub events**, not
on the operator's server dashboard (pin 2001). This is a legitimate choice for the diagnostic phase, but it must
be a **decision, not an accident**:
- **Decision D8:** for Release A, is raw-Notehub visibility sufficient, or does the server need to parse +
  surface `scOk`/`sc_merr`/`scImpl`? *(v24 recommendation: parse them server-side — the operator works from the
  dashboard, and a one-line `sc_merr` on the device card is what actually ends the "is it physical?" debate.)*
- **Todo:** `[ ] (D8) Server handleTelemetry/handleDaily: parse + store + display scOk / sc_merr / scImpl (or explicitly accept raw-Notehub-only).`

### G-3 (good news, scope confirmed) — the signed-current change is safe and local
`scaleCurrent()` is called in **exactly one place** (the realtime block, `realtimeRegs[3]`/`[4]`). Changing the
cast to signed (or adding `scaleCurrentSigned`) therefore cannot affect any other consumer. **Caveat to note in
the PR:** the battery-gated clamp relaxation means `getEffectiveBatteryVoltage()` → `updatePowerState()`
(hibernate) now trusts a CRC-valid battery reading even if array/current look odd — acceptable (battery V is the
safety-relevant field and keeps its 5–40 V bound), but call it out so a reviewer signs off on the power-state
implication.

### G-4 (process guard) — protect the change from the documented `master` clobber pattern
This repo has a **history of regressions from concurrent automated pushes to `master`** (the v1.8.5 stale-server
mangle; the v2.0.0 CI `security=sien` revert). Before committing Release A:
- **Todo:** `[ ] git pull --rebase before committing; review the FULL diff incl. files you didn't mean to touch; do NOT bundle unrelated changes; do NOT commit build/*.bin or the Common .zip.`
- **Todo:** `[ ] Confirm the security=sien client OTA slot build is intact in release-firmware-112025.yml (CI magic-byte guard 3d b8 f3 96) before tagging.`

### G-5 (nice-to-have) — define the Release A rollback criterion now
So the 24 h watch has a clear abort line:
- **Todo:** `[ ] Rollback if Release A causes: a NEW sustained sensor-fault on a previously-healthy current-loop device, OR scOk flips 1→0 on a device that was reporting voltage, OR any compile/boot/Ethernet-relink regression on the server.`

**Bottom line:** the technical plan is sound and ready; these five items are the mechanical/visibility/process
glue. G-1 and G-2 are the two that would actually cause a failed release or an "invisible fix," so treat them as
**blocking** for Release A. The rest are guards.

---
