SenaxInc/SenaxTankAlarm/CODE REVIEW/FIELD_DIAGNOSTICS_TEST_AND_FIX_PLAN.md

# Field Diagnostics Test and Fix Plan

**Date:** 2026-06-23
**Scope:** Client and Server firmware configuration, monitoring, and communication fixes based on `CODE_REVIEW_06232026_FIELD_DIAGNOSTICSv2.md`.

## 1. Issues 1 & 3: Configuration Delivery and Verification
**Problem:** The client is not reporting battery voltage, likely due to an unapplied config (the RS-485 poller isn't running). 
**Action Plan:**
1. **Push Configuration:** Ensure the target field client (Cox Wellhead) is re-pushed with the `Solar + Modbus MPPT (RS-485)` configuration. Monitor for the `config_ack.qo`.
2. **Config Delivery Visibility:** Enhance the Server Management View to display the client's last applied configuration timestamp. This provides immediate "Applied" vs "Pending" states, identifying inbound sync staleness.
3. **Solar State Dashboard Badge:** Add a visual indicator to the Server UI ("Solar State: Disabled" / "Ok" / "Failing") powered by the new `scOk` flags in the v2.0.42 telemetry.
**Validation:** Verify that once the configuration is processed via the Notes pipeline, the dashboard accurately reflects the MPPT's heartbeat instead of silence.

## 2. Issue 4: RS-485 / SunSaver Driver Enhancements
**Problem:** Modbus communications are experiencing silent failures and potential transient timeouts on the RS-485 serial bus.
**Action Plan:**
1. **Enable Hardware Retry Loops:** Provide isolated, hardware-retry blocks inside the client's `TankAlarm_Solar.cpp` loop. E.g., Implement 3 consecutive retries 100ms apart before accepting a NACK / timeout and raising a `SOLAR_ALERT_COMM_FAILURE`.
2. **Enable Communication Alerts:** Transition `alertOnCommFailure` to default `true` whenever `solarCharger.enabled` holds true, giving the operator real-time feedback on link drops.
3. **Validation:** Use `firmware/sunsaver-rs485-windowed-probe` to sweep delays. Induce artificial electrical noise into the RS-485 bench bus to check that the retry logic correctly intercepts unformatted frames and suppresses false alarms.

## 3. Issue 2: A0602 Current-Loop Sensor Safeguards
**Problem:** A persistent hardware I2C issue results in `sensor-faults`. The firmware handles this by safely reusing the last good reading (`ru: 1`), but masks absolute failures from the daily logs and persists old faults on the Server dashboard. 
**Action Plan:**
1. **Daily Report Fault Injection:** Modify the daily roll-up logic in the client's `appendSensorDataToDaily`. If a sample interval consisted of 100% missed readings (`validSamples == 0`), explicitly record `0.0f` (or equivalent sentinel logic) to expose the outage instead of continuing to transmit a stale snapshot.
2. **Server-Side Automatic Unlatching:** Update the Server's anomaly engine (`TankAlarm-112025-Server-BluesOpta.ino`) to automatically clear a stale `sensor-fault` whenever fresh (`ru: 0`) and valid telemetry points arrive, replicating the existing `sensor-stuck` self-clearing.
3. **Validation:** Disconnect the A0602 I2C sensor on the bench configuration, verify the Daily Report sends clear failure data. Reconnect the harness, ensure valid data arrives with `ru: 0`, and check that the server resolves the `sensor-fault` immediately. 

## 4. End-to-End Release Pipeline 
- Patch, build, and deploy the new Server firmware updates handling the Solar Badge and the unlatching algorithms.
- Complete the A0602 trace analysis, resolving the raw I2C NACKs.
- Flash the client bench node, verify Modbus RS-485 logic.
- Conduct live regression trials comparing device events on Notehub versus Server dashboard visuals to confirm parity.

## 5. Copilot Review Notes and Suggestions
**Review date:** 2026-06-23

### Configuration Delivery / Applied-vs-Pending Visibility
- The basic config ACK plumbing already exists. The Client sends `config_ack.qo` with `c`, `st`, `cv`, `message`, and `epoch`; the Server stores `pendingDispatch`, `configVersion`, `lastAckEpoch`, `lastAckStatus`, `dispatchAttempts`, and `lastDispatchEpoch` in `ClientConfigSnapshot`.
- The most useful next step is UI/API visibility, not a new delivery protocol. Surface the existing snapshot fields in the Server Management / Config Generator flow so operators can see: `Pending Dispatch`, `Last Dispatch`, `Last ACK`, `ACK Status`, and whether the ACK `cv` matches the currently cached `configVersion`.
- `/api/client-config` already returns a `dispatch` object for a selected client, but `/api/clients?summary=1` skips config metadata. If the dashboard or site-management view needs Applied/Pending state without fetching each full config, add a compact per-client `cfg` summary to the thin response.
- The Client already refreshes non-transport solar config changes at runtime with `gSolarManager.setConfig()` and only restarts the RS-485 transport when enable/slave/baud/timeout changes. Keep this behavior; it directly addresses the older stale-runtime-solar-config risk.
- For `Solar + Modbus MPPT (RS-485)`, make the generated config explicit. The Server currently emits `solarCharger: { enabled: true }` from the UI, and the Client defaults missing `alertOnCommFail` to `false`. If comm-failure alerting should be enabled for MPPT installs, set `alertOnCommFail: true` in the generated config or make the Client parser default it to true when `solarCharger.enabled` is true and the field is absent.

### Solar / RS-485 Driver and Dashboard State
- The solar driver is already carrying several important hardware fixes: 9600/8N2 framing, `RS485.setDelays(0, 1200)`, timeout floor at 500 ms, FC03/FC04 fallback with cache, realtime register plausibility checks, and `SOLAR_COMM_FAILURE_THRESHOLD` before declaring the link down.
- Add retries carefully. A blanket 3x retry around every register block can multiply worst-case Modbus blocking time, especially with FC03/FC04 fallback. Prefer a bounded retry around the verified realtime block (`0x0008..0x000C`) or around the whole poll attempt, with watchdog kicks and a short inter-retry delay. Do not retry the unverified status/fault/daily register blocks in production builds.
- Coordinate the retry count with `SOLAR_COMM_FAILURE_THRESHOLD`. For example, three immediate retries per poll plus five failed polls before `communicationOk=false` gives up to fifteen low-level attempts before the operator sees failure. That may be right for noise immunity, but it should be intentional.
- The Client already emits `scOk` in telemetry when the SolarManager is enabled, and daily reports include `solar.commOk`. The Server does not currently consume `scOk` into the dashboard model. Add a small solar-state field to `ClientMetadata` or the sensor summary model so the dashboard badge can be driven from both telemetry (`scOk`) and daily (`solar.commOk`).
- Recommended badge logic: `Disabled` when the cached config has no `solarCharger.enabled`; `Ok` when enabled and recent telemetry/daily reports `scOk=1` or `solar.commOk=1`; `Failing` when enabled and recent telemetry/daily reports `scOk=0` or `solar.commOk=0`; `Unknown/Stale` when enabled but no solar state has arrived within a reasonable multiple of the configured poll interval.
- The bench probe exists at `firmware/sunsaver-rs485-windowed-probe/sunsaver-rs485-windowed-probe.ino`. Capture and keep the tuple that passes: baud/framing, slave ID, function code, register address, RX window, and delay profile. A good pass criterion is repeated valid Modbus CRC frames under 9600 8N2 and the production post-delay, not merely "not silent".
- Hardware notes worth preserving in the validation checklist: use the Morningstar MRC-1, confirm the RJ-11 MeterBus cable is fully seated, connect signal ground, and do not trust A/B labels alone. The Client README records Morningstar's inverted A/B convention; the wiring docs should be reconciled so the field instructions use one polarity convention consistently.
- For noise testing, avoid destructive bus faults. Prefer controlled, reversible perturbations: longer cable/stub, temporary termination/bias changes, adjacent noisy load, or current-limited injected disturbance. Record whether the retry layer suppresses transient failures without hiding a truly disconnected MRC-1.

### A0602 / Current-Loop Fault Visibility
- The current Client code already does more than the plan implies. `readCurrentLoopSensor()` uses the framed A0602 Blueprint protocol, validates response framing/CRC/channel, clears stale `currentSensorMa`, marks `sampleReused`, and returns `NAN` when `validSamples == 0`. `validateSensorReading()` then escalates non-finite readings into `sensor-fault` after the existing failure threshold.
- Because of that, avoid using a bare `0.0f` level as the daily-report sentinel. A numeric zero can look like a real empty tank and can corrupt 24-hour deltas and charts. Prefer explicit data-quality flags: keep `sf: 1`, `ru: 1`, omit `ma`, and optionally add a dedicated `dq: "fault"` or `miss: 1` field if the Server/dashboard needs a stronger signal.
- `buildSensorObject()` already includes `sf` and `ru`, and daily reports call `appendDailyMonitor()`, so the daily path can carry fault quality today. The Server should read those flags before updating history or clearing alarms.
- Add a shared Server helper such as `isFreshValidSensorSample(src, rec)` and use it in both `handleTelemetry()` and `handleDaily()`. It should require no `sf`, no `ru`, finite `lvl`, and for current-loop sensors a present, valid `ma >= 4.0` when raw mA is expected. Use that helper before recording history snapshots.
- Auto-unlatch stale diagnostic alarms only on fresh valid data. If `rec->alarmActive` and `rec->alarmType` is `sensor-fault` or `sensor-stuck`, a fresh valid sample should clear it, call `clearAlarmEvent()`, and mark the registry dirty. Do not clear on reused/stale daily rows.
- The existing Server self-clears `sensor-stuck` only in the narrow case where stuck detection has been disabled in config. That is useful, but it does not solve stale `sensor-fault` after a real reconnect. The planned automatic unlatch is still needed.

### Release / Test Additions
- Before field deployment, run one forced config push and verify all three states: Server dispatch becomes pending, Client ACK arrives with matching `cv`, and subsequent telemetry/daily shows the expected solar state.
- Add a regression where the Client reports `sf=1`/`ru=1` daily data while the A0602 is disconnected; the Server should display the fault and avoid recording a healthy-looking history point.
- Add a reconnect regression where three or more fresh valid current-loop samples arrive after the A0602 is restored; the Client should send `sensor-recovered`, and the Server should also self-clear any stale `sensor-fault` if the recovery note was lost.
- Treat release readiness as both firmware and operations: update the config generator defaults, dashboard/API summary, bench probe result, wiring instructions, and release notes together so a field technician can diagnose "not applied", "applied but solar failing", and "sensor failed but safely stale" from the UI alone.

## 6. Independent Code Review — Additional Findings and Recommendations
**Reviewer:** Copilot (Claude Opus 4.6)
**Date:** 2026-06-23
**Method:** Full source analysis of Client `.ino`, `TankAlarm_Solar.cpp/.h`, `TankAlarm_I2C.h`, and Server `.ino`.

### 6.1 Issue 1/3 — Config Delivery: Confirmed Gaps in Summary API

The plan correctly identifies that the config ACK plumbing is complete, but the `/api/clients?summary=1` endpoint (`sendClientDataJson()`, Server L9758) genuinely omits all config dispatch metadata. The summary path returns `cs[]` with sensor state, VIN voltage, firmware version, OTA state, and signal strength — but no `pd` (pendingDispatch), `cv` (configVersion), `ae` (lastAckEpoch), or `as` (lastAckStatus). These fields are only emitted in the full `/api/clients` response inside the `cfgs[]` array (Server L10056–10088).

**Concrete recommendation:** Rather than adding a full `cfgs[]` block to the summary response (which doubles its size), add a compact per-client `cfg` object inside each `cs[]` entry in summary mode:
```cpp
// Inside the per-client clientObj block, after OTA state:
if (cfgSnap) {
  JsonObject cfgSummary = clientObj["cfg"].to<JsonObject>();
  cfgSummary["pd"] = cfgSnap->pendingDispatch;
  if (cfgSnap->lastAckEpoch > 0.0) {
    cfgSummary["ae"] = cfgSnap->lastAckEpoch;
    cfgSummary["as"] = cfgSnap->lastAckStatus;
  }
  if (cfgSnap->configVersion[0] != '\0') {
    cfgSummary["cv"] = cfgSnap->configVersion;
  }
}
```
The `cfgSnap` pointer is already being looked up at Server L9877 for site name resolution, so this adds no extra lookup cost. This would be approximately 4–6 extra JSON fields per client in the summary — well within the existing `JsonDocument` budget.

### 6.2 Issue 4 — RS-485 Retry: Timing Risks with FC03/FC04 Fallback

The plan proposes 3 retries × 100ms between attempts. After reviewing `readRegistersWithFallback()` (Solar.cpp L62–97), there is a compounding concern:

- On a **cache miss** (`cachedFC == 0`), the function already performs two Modbus transactions (FC03 then FC04) back-to-back.
- On a **cached FC failure**, it clears the cache and tries the opposite FC on the same call — also two transactions.
- The Modbus timeout is floored at 500ms (Solar.cpp L148–149).

**Worst-case blocking time per retry:** 2 × 500ms = 1000ms (two failed FC attempts). With 3 retries on the realtime block (registers 0x0008–0x000C): 3 × 1000ms = **3 seconds** of blocking. The poll function already reads three register blocks (realtime, setpoints, and conditionally unverified status), so total worst-case could reach **9 seconds** per poll cycle.

The current watchdog timer is fed during the poll loop, but verify the watchdog window is > 9 seconds. If the Opta's WDT is 8 seconds (common default), the retry logic could trigger a reset on a fully unresponsive bus.

**Concrete recommendation:**
1. Only retry the realtime register block (0x0008–0x000C). The setpoint registers (0x0033, 0x0035, 0x0036) are static and don't need retries — a miss is harmless.
2. Feed the watchdog between retries, not just between register blocks.
3. Set `maxRetries = 2` (not 3) to keep worst-case blocking under 6 seconds.
4. Do NOT retry when `cachedFC == 0` (discovery phase) — the fallback logic is already effectively a retry.

### 6.3 Issue 4 — alertOnCommFailure Default: Config Generator Already Emits `false`

The config generator JS (Server L1980) builds `solarCharger: { enabled: true }` when the power source is `solar_modbus_mppt`, but **does not emit** `alertOnCommFail` at all. The Client parser (Client L3140) defaults missing `alertOnCommFail` to `false`:
```cpp
cfg.solarCharger.alertOnCommFailure =
  solarCfg["alertOnCommFail"].is<bool>()
    ? solarCfg["alertOnCommFail"].as<bool>()
    : false;
```

**Two options to fix this:**

- **Client-side default flip** (simpler, affects all future installs): Change the default in the Client parser from `false` to `true` when `solarCharger.enabled` is true. This is a one-line change but is a behavior change for all existing configs that omit the field.
- **Config generator explicit emission** (safer): Add `alertOnCommFail: true` to the generated config JSON when power source is `solar_modbus_mppt`. This makes the intent explicit and doesn't change behavior for devices with existing saved configs.

Recommend the config generator approach — it's explicit and doesn't silently change behavior for re-applied existing configs.

### 6.4 Issue 2 — sensor-fault Auto-Unlatch: The Real Gap

The plan is correct that the Server only auto-clears `sensor-stuck` when stuck detection is disabled (Server L11634–11670). But the actual gap is narrower than it appears:

The Client **already sends `sensor-recovered`** (Client L5086–5150) after 3 consecutive valid readings following a `sensor-fault`. The Server's `handleAlarm()` (Server L11814–11832) correctly processes this: it sets `rec->alarmActive = false`, calls `clearAlarmEvent()`, and preserves the `sensor-recovered` label. Additionally, the daily alarm reconciliation (Server L12018–12095) catches orphaned alarms by checking the daily report's alarm array against server-side state.

**The only unprotected scenario** is when:
1. The Client sends `sensor-recovered` via Notecard
2. The recovery note is lost (cellular gap, Notehub routing failure)
3. The next daily report's alarm array is also lost or arrives without the alarms section
4. No further alarm state change occurs

This is a real but narrow window. The proposed server-side auto-unlatch on fresh valid telemetry is the right fix. Specifically:

```cpp
// In handleTelemetry(), after the existing sensor-stuck auto-clear block (L11670):
if (rec->alarmActive && strcmp(rec->alarmType, "sensor-fault") == 0) {
  // Fresh valid telemetry with no sf/ru flags = sensor is healthy again.
  // The client would normally send sensor-recovered, but if that note was
  // lost, clear the stale fault here.
  bool hasSf = body["sf"] | 0;
  bool hasRu = body["ru"] | 0;
  float maVal = body["ma"] | 0.0f;
  bool isFreshValid = !hasSf && !hasRu && isfinite(rec->levelInches);
  // For current-loop sensors, also require valid mA
  if (strcmp(rec->sensorType, "currentLoop") == 0) {
    isFreshValid = isFreshValid && (maVal >= 4.0f);
  }
  if (isFreshValid) {
    rec->alarmActive = false;
    strlcpy(rec->alarmType, "clear", sizeof(rec->alarmType));
    clearAlarmEvent(clientUid, sensorIndex);
    markRegistryDirty();
  }
}
```

**Important:** The `sf` and `ru` flags are emitted by `buildSensorObject()` in telemetry but the Server's `handleTelemetry()` does not currently extract them. The telemetry handler reads `"ma"`, `"vt"`, `"lvl"`, `"st"`, etc., but skips `"sf"` and `"ru"`. These fields need to be read from the telemetry body for the auto-unlatch guard to work.
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
