SenaxInc/SenaxTankAlarm/CODE REVIEW/CODE_REVIEW_06182026_OTA_V1934_TO_V1935_SWAP_FAILURE.md

# CODE REVIEW — OTA Update Failure: v1.9.34 → v1.9.35 (MCUboot Swap Never Takes Effect)

**Date:** 2026-06-18
**Scope:** Root-cause analysis of why the OTA update from v1.9.34 to v1.9.35 downloaded and staged successfully but never swapped — the device reverted to v1.9.34 and blacklisted v1.9.35.
**Companions:**
- [CODE_REVIEW_06212026_OTA_V1930_TO_V1931_FAILURE.md](CODE_REVIEW_06212026_OTA_V1930_TO_V1931_FAILURE.md) — empty-version silent-skip (fixed in v1.9.34)
- [CODE_REVIEW_06152026_OTA_VS_USB_UPDATE_FAILURE.md](CODE_REVIEW_06152026_OTA_VS_USB_UPDATE_FAILURE.md) — the five OTA preconditions
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
