SenaxInc/SenaxTankAlarm/TankAlarm-112025-Client-BluesOpta/TankAlarm-112025-Client-BluesOpta.ino

/*
  Tank Alarm Client 112025 - Arduino Opta + Blues Notecard
  Version: see FIRMWARE_VERSION in TankAlarm_Common.h

  Hardware:
  - Arduino Opta Lite (STM32H747XI dual-core)
  - Arduino Pro Opta Ext A0602 (analog and current-loop expansion)
  - Blues Wireless Notecard for Opta adapter (cellular + GPS)

  Features:
  - Multi-sensor monitoring with per-monitor alarm thresholds
  - Blues Notecard telemetry for server ingestion
  - SMS alarm escalation via server
  - Daily report schedule aligned with server
  - Configuration persisted to internal flash (LittleFS)
  - Remote configuration updates pushed from server via Notecard
  - Compile output includes hardware requirement summary based on configuration

  Created: November 2025
  Using GitHub Copilot for code generation
*/

#define DEVICE_ROLE TANKALARM_ROLE_CLIENT

// Shared library - common constants and utilities
#include <TankAlarm_Common.h>

// C-T01: pure alarm debounce / rate-window helpers (no Arduino deps; host-tested in tests/host)
#include "TankAlarm_AlarmDebounce.h"

#include <Arduino.h>
#include <Wire.h>

// Arduino_Opta_Blueprint: official A0602 expansion driver. Used ONLY at boot to run the
// Blueprint reset/address-assignment handshake so the A0602 ends up at a real assigned
// I2C address (OPTA_CONTROLLER_FIRST_AVAILABLE_ADDRESS = 0x0B+) instead of the legacy
// 0x64/0x0A probe defaults that the field A0602 was never at. Once the address is
// captured, the existing v2.0.46 raw Blueprint-frame read path (configureCurrentAdcChannel
// + getAnalogChannelFunction + readCurrentAdcFramed) talks to that discovered address and
// remains in charge of every per-sample transaction -- OptaController::update() is NOT
// called in the hot loop, so it never races the raw frames on the shared I2C bus.
#include "OptaBlue.h"

#if defined(TANKALARM_DFU_MCUBOOT)
#include <MCUboot.h>
#elif defined(TANKALARM_ALLOW_NON_MCUBOOT_BUILD)
// Opt-out hatch for deliberate non-OTA test builds. Once flashed, the resulting
// binary CANNOT accept any over-the-air firmware update — Notehub will keep
// re-queuing the same image and every attempt will fail with
// "MCUboot DFU not supported in this build" in _health.qo. Recover only by
// USB-flashing a build that has TANKALARM_DFU_MCUBOOT defined.
#warning "TANKALARM_ALLOW_NON_MCUBOOT_BUILD is set — the resulting client binary CANNOT receive OTA updates. Only use for local USB-only testing."
#else
// Hard-fail the build if MCUboot DFU support is missing. Without this guard the
// developer would get a silently-broken binary: USB-flashing it ships a client
// that downloads every Notehub OTA payload but rejects the apply step (see
// _health.qo "MCUboot DFU not supported in this build"), wasting cellular data
// and triggering an "ota-stage-failed" SMS on every retry. The only recovery
// is another USB flash. Recipe: see CODE REVIEW/CODE_REVIEW_06292026_*.
#error "TANKALARM_DFU_MCUBOOT is required for the Client build. Rebuild with: arduino-cli compile --fqbn arduino:mbed_opta:opta --library TankAlarm-112025-Common --build-property \"build.extra_flags=-DTANKALARM_DFU_MCUBOOT\" TankAlarm-112025-Client-BluesOpta. To intentionally produce a non-OTA-capable test binary, also pass -DTANKALARM_ALLOW_NON_MCUBOOT_BUILD."
#endif

#if defined(ARDUINO_OPTA) || defined(ARDUINO_ARCH_MBED)
#include <ArduinoRS485.h>
#endif

#include <ArduinoJson.h>
#include <memory>
#include <math.h>
#include <string.h>

// POSIX-compliant standard library headers
#include <stdio.h>
#include <stdlib.h>
#include <errno.h>
#include <sys/types.h>

// Forward-declare FluidType so Arduino's auto-generated function prototypes
// (inserted near the top of the .ino) can reference it before its definition below.
enum FluidType : uint8_t;

// POSIX file I/O types (for platforms that support it)
#if defined(ARDUINO_OPTA) || defined(ARDUINO_ARCH_MBED)
  #include <fcntl.h>
  #include <sys/stat.h>
#endif

// Filesystem support - Mbed OS filesystem instance
#if defined(ARDUINO_OPTA) || defined(ARDUINO_ARCH_MBED)
  #include "rtos/ThisThread.h"
  #include "MBRBlockDevice.h"
  using namespace std::chrono;
  using namespace std::chrono_literals;

  // QSPI is MBR-partitioned by KeyProvisioning (standard Arduino Opta layout):
  //   p1 WiFi (unused) | p2 MCUboot OTA staging | p3 KVStore (unused) | p4 user data.
  // This application's LittleFS config store lives on partition 4. We mount/format
  // ONLY that partition: reformatting the whole device would destroy the MCUboot
  // OTA partition (p2) and break firmware updates.
  #define TANKALARM_APP_DATA_PARTITION 4

  // Mbed OS filesystem instance - mounted at "/cfg" (NOT "/fs": the MCUboot core
  // reserves "/fs" for the OTA secondary slot on partition 2; sharing that mount
  // name shadowed the core's OTA mount and silently broke firmware staging).
  static LittleFileSystem *mbedFS = nullptr;
  static BlockDevice *mbedBD = nullptr;
  static mbed::MBRBlockDevice *mbedAppPart = nullptr;
  static MbedWatchdogHelper mbedWatchdog;
  static bool gStorageAvailable = false;
  
  // POSIX-compatible file path prefix for Mbed OS VFS (app config store, partition 4).
  // Must NOT be "/fs" -- that mount name is reserved by the MCUboot core for the OTA
  // secondary slot on partition 2; a shared name shadows the core's OTA mount.
  #define POSIX_FS_PREFIX "/cfg"
  #define FILESYSTEM_AVAILABLE
  #define POSIX_FILE_IO_AVAILABLE
#elif defined(ARDUINO_ARCH_STM32)
  #include <LittleFS.h>
  #include <IWatchdog.h>
  #define FILESYSTEM_AVAILABLE
  static bool gStorageAvailable = false;
#endif

static inline bool isStorageAvailable() {
#ifdef FILESYSTEM_AVAILABLE
  #if defined(ARDUINO_OPTA) || defined(ARDUINO_ARCH_MBED)
    return gStorageAvailable && (mbedFS != nullptr);
  #else
    return gStorageAvailable;
  #endif
#else
  return false;
#endif
}

// Debug mode - controls Serial output and Notecard debug logging
// For PRODUCTION: Leave commented out (default) to save 5-10% power consumption
// For DEVELOPMENT: Uncomment the line below for troubleshooting and monitoring
//#define DEBUG_MODE

// Solar hardware test serial output (opt-in)
// Enable during RS-485/Modbus bring-up to print one structured line per poll.
// Leave disabled for normal deployments to minimize serial/log overhead.
//#define SOLAR_HW_TEST_SERIAL

// Optional test-only override: force-enable SunSaver polling with known defaults
// even when flash config currently has solarCharger.enabled=false.
// IMPORTANT: leave this commented in production -- it bypasses the server-pushed
// flash config and forces the SunSaver poller on regardless of what the server says.
//#define SOLAR_HW_TEST_FORCE_SOLAR_CONFIG

#ifdef SOLAR_HW_TEST_SERIAL
  #define SOLAR_TEST_PRINT(x) Serial.print(x)
  #define SOLAR_TEST_PRINTLN(x) Serial.println(x)
#else
  #define SOLAR_TEST_PRINT(x)
  #define SOLAR_TEST_PRINTLN(x)
#endif

// Debug output macros - no-op when DEBUG_MODE is disabled
#ifdef DEBUG_MODE
  #define DEBUG_BEGIN(baud) Serial.begin(baud)
  #define DEBUG_PRINT(x) Serial.print(x)
  #define DEBUG_PRINTLN(x) Serial.println(x)
  #define DEBUG_PRINTF(x, y) Serial.print(x, y)
#else
  #define DEBUG_BEGIN(baud)
  #define DEBUG_PRINT(x)
  #define DEBUG_PRINTLN(x)
  #define DEBUG_PRINTF(x, y)
#endif

// Wrapper for shared library roundTo function
static inline float roundTo(float val, int decimals) { return tankalarm_roundTo(val, decimals); }

// Optional: Create a "ClientConfig.h" file in this sketch folder to set
// compile-time defaults (e.g. #define DEFAULT_PRODUCT_UID "com.company.product:project").
// If the file does not exist, the product UID must be set via the Config Generator on the server.
#if __has_include("ClientConfig.h")
  #include "ClientConfig.h"
#endif

#ifndef DEFAULT_PRODUCT_UID
#define DEFAULT_PRODUCT_UID ""  // Set via ClientConfig.h or Config Generator
#endif

// SOLAR_OUTBOUND_INTERVAL_MINUTES and SOLAR_INBOUND_INTERVAL_MINUTES
// are defined in TankAlarm_Config.h (via TankAlarm_Common.h)

#ifndef CLIENT_CONFIG_PATH
#define CLIENT_CONFIG_PATH "/client_config.json"
#endif

// Persisted record of the firmware build sequence that last booted on this device.
// Compared on boot to FIRMWARE_BUILD_SEQ to detect a just-installed firmware (OTA or USB)
// and trigger an immediate confirmation telemetry sync. Lives on the app data partition.
#ifndef FIRMWARE_MARKER_FILE
#define FIRMWARE_MARKER_FILE "/cfg/fw_marker.json"
#endif

// ============================================================================
// Client Notefile Names — Outbound (.qo) and Inbound (.qi)
// These override the common header where client perspective differs.
// Blues Notecard rule: note.add ONLY accepts .qo/.qos/.db/.dbs/.dbx
//                     note.get reads from .qi/.qis/.db/.dbx
// Cross-device delivery is handled by Notehub Routes (no fleet:/device: prefixes).
// ============================================================================

// Outbound data notefiles (client → Notehub → routed to server)
#define TELEMETRY_FILE TELEMETRY_OUTBOX_FILE   // "telemetry.qo"
#define ALARM_FILE     ALARM_OUTBOX_FILE       // "alarm.qo"
#define DAILY_FILE     DAILY_OUTBOX_FILE       // "daily.qo"
#define UNLOAD_FILE    UNLOAD_OUTBOX_FILE      // "unload.qo"

// Config: client reads config.qi (inbound), sends acks via config_ack.qo (outbound)
// CONFIG_INBOX_FILE, CONFIG_ACK_OUTBOX_FILE are defined in TankAlarm_Common.h

// Relay: client reads relay.qi (inbound commands from server)
// RELAY_CONTROL_FILE is already correct from common header ("relay.qi")

// Serial logs: client sends logs outbound, receives requests inbound
#define SERIAL_LOG_FILE SERIAL_LOG_OUTBOX_FILE  // "serial_log.qo"
// SERIAL_REQUEST_FILE is already correct ("serial_request.qi")

// Location: client receives requests inbound, sends responses outbound
#define LOCATION_RESPONSE_FILE LOCATION_RESPONSE_OUTBOX_FILE  // "location_response.qo"
// LOCATION_REQUEST_FILE is already correct ("location_request.qi")

// Health telemetry: client sends periodic system health status
#define HEALTH_FILE HEALTH_OUTBOX_FILE  // "health.qo"

// Diagnostics: I2C recovery events, future extension for config/DFU events
#define DIAG_FILE DIAG_OUTBOX_FILE  // "diag.qo"

// Health telemetry feature flag (disabled by default for bandwidth conservation)
// Uncomment to enable periodic system health reporting to Notehub.
//#define TANKALARM_HEALTH_TELEMETRY_ENABLED

// Health telemetry interval (default: every 6 hours)
#ifndef HEALTH_TELEMETRY_INTERVAL_MS
#define HEALTH_TELEMETRY_INTERVAL_MS (6UL * 60UL * 60UL * 1000UL)
#endif

// CLIENT_SERIAL_BUFFER_SIZE is defined in TankAlarm_Common.h

#ifndef NOTE_BUFFER_PATH
#define NOTE_BUFFER_PATH "/pending_notes.log"
#endif

#ifndef NOTE_BUFFER_TEMP_PATH
#define NOTE_BUFFER_TEMP_PATH "/pending_notes.tmp"
#endif

#ifndef NOTE_BUFFER_MAX_BYTES
#define NOTE_BUFFER_MAX_BYTES 16384
#endif

#ifndef NOTE_BUFFER_MIN_HEADROOM
#define NOTE_BUFFER_MIN_HEADROOM 2048
#endif

#ifndef MAX_MONITORS
#define MAX_MONITORS 8
#endif

// DEFAULT_SAMPLE_INTERVAL_SEC, DEFAULT_LEVEL_CHANGE_THRESHOLD,
// DEFAULT_REPORT_HOUR, DEFAULT_REPORT_MINUTE are defined in TankAlarm_Config.h
#define DEFAULT_SAMPLE_SECONDS          DEFAULT_SAMPLE_INTERVAL_SEC

#ifndef CURRENT_LOOP_I2C_ADDRESS
#define CURRENT_LOOP_I2C_ADDRESS 0x64
#endif

#ifndef CURRENT_LOOP_I2C_ALT_ADDRESS_1
#define CURRENT_LOOP_I2C_ALT_ADDRESS_1 0x0A
#endif

#ifndef CURRENT_LOOP_I2C_ALT_ADDRESS_2
#define CURRENT_LOOP_I2C_ALT_ADDRESS_2 0x00
#endif

#ifndef ALARM_DEBOUNCE_COUNT
#define ALARM_DEBOUNCE_COUNT 3  // Require 3 consecutive samples to trigger/clear alarm
#endif

// C-T01: latched edge whose alarm.qo note was denied by checkAlarmRateLimit (RAM only).
// Plain defines (not an enum) so the Arduino auto-prototypes never need the type.
#define ALARM_PENDING_NONE          0
#define ALARM_PENDING_HIGH          1
#define ALARM_PENDING_LOW           2
#define ALARM_PENDING_TRIGGERED     3
#define ALARM_PENDING_NOT_TRIGGERED 4

#ifndef SENSOR_STUCK_THRESHOLD
#define SENSOR_STUCK_THRESHOLD 10  // Same reading 10 times = stuck sensor
#endif

#ifndef SENSOR_FAILURE_THRESHOLD
#define SENSOR_FAILURE_THRESHOLD 5  // 5 consecutive read failures = sensor failed
#endif

#ifndef CURRENT_LOOP_FAULT_MA
// Below this current the 4-20mA loop is treated as broken/disconnected (live-zero fault).
// A healthy transmitter never drives below ~3.8mA; 3.6mA leaves margin for sampling noise.
#define CURRENT_LOOP_FAULT_MA 3.6f
#endif

#ifndef CURRENT_LOOP_GATED_SETTLE_MS
// Minimum inter-sample settle (ms) for power-gated 4-20mA reads. The A0602 current-loop ADC
// needs time to deliver a fresh conversion after the channel is selected; the validated
// standalone gating test (P1_Transistor_Gating_Test) sampled at 300ms and read correctly,
// while a too-small configured delay returns stale/constant values that look like a pegged
// reading. When gating is on, the effective settle is floored to this value.
#define CURRENT_LOOP_GATED_SETTLE_MS 300
#endif

#ifndef CURRENT_LOOP_OVER_RANGE_MA
// Above this current a 4-20mA loop reading is rejected as a fault. A healthy transmitter cannot
// legitimately exceed 20mA full scale; a value above ~21mA (e.g. a raw 0xFFFF read that scales
// to 25mA, or a near-full-scale garbage frame) is an I2C/loop fault, not a real reading. Without
// this guard linearMap(mA,4,20,...) extrapolates the bad value into a fabricated level/pressure.
#define CURRENT_LOOP_OVER_RANGE_MA 21.0f
#endif

#ifndef A0602_WIRE_TIMEOUT_MS
// Scoped Wire byte-timeout (ms) for A0602 current-loop transactions. The A0602 does NOT clock-
// stretch, so it needs only a short timeout; failing fast lets the loop() bus recovery engage
// sooner instead of blocking. The Notecard (which DOES clock-stretch) keeps I2C_WIRE_TIMEOUT_MS.
#define A0602_WIRE_TIMEOUT_MS 25
#endif

#ifndef A0602_PEROP_I2C_CLOCK_HZ
// Per-operation I2C clock for A0602 framed transactions. Raised ONLY around the A0602 frames
// (then restored to I2C_NORMAL_CLOCK_HZ before any Notecard op) to shrink the A0602's bus-
// occupancy window ~4x WITHOUT ever running the clock-sensitive Notecard at 400kHz.
#define A0602_PEROP_I2C_CLOCK_HZ 400000
#endif

#ifndef I2C_NORMAL_CLOCK_HZ
// Shared-bus default clock (Notecard-safe). Restored after every A0602 per-op window.
#define I2C_NORMAL_CLOCK_HZ 100000
#endif

// Sensor loop-power modes (v2.1.3). Selected per-monitor via config key "loopPowerMode".
#define LOOP_POWER_MODE_DAC 0  // channel's own DAC drives ~11V out the sensor terminals (2-wire)
#define LOOP_POWER_MODE_PWM 1  // P1-P4 transistor switches an external 12-24V supply (soft-ramped)

#ifndef MAX_ALARMS_PER_HOUR
#define MAX_ALARMS_PER_HOUR 10  // Maximum alarms per monitor per hour
#endif

#ifndef MAX_GLOBAL_ALARMS_PER_HOUR
#define MAX_GLOBAL_ALARMS_PER_HOUR 30  // Maximum alarms across ALL sensors per hour
#endif

#ifndef TELEMETRY_OUTBOX_MAX_PENDING
#define TELEMETRY_OUTBOX_MAX_PENDING 15  // Max telemetry.qo notes in outbox; older ones are dropped
#endif

#ifndef TELEMETRY_NOTE_ID_LEN
#define TELEMETRY_NOTE_ID_LEN 48         // Max length of a Notecard note ID string
#endif

#ifndef TELEMETRY_TRIM_COLLECTION_HEADROOM
#define TELEMETRY_TRIM_COLLECTION_HEADROOM 4  // Extra IDs collected beyond the limit to detect overflow
#endif

// Config schema versioning — bump when adding/removing fields to detect stale configs
#ifndef CONFIG_SCHEMA_VERSION
#define CONFIG_SCHEMA_VERSION 3
#endif

#ifndef MIN_ALARM_INTERVAL_SECONDS
#define MIN_ALARM_INTERVAL_SECONDS 300  // Minimum 5 minutes between same alarm type
#endif

// Tank unload detection constants
#ifndef UNLOAD_DEFAULT_DROP_PERCENT
#define UNLOAD_DEFAULT_DROP_PERCENT 50.0f  // Default: 50% drop from peak = unload event
#endif

#ifndef UNLOAD_DEFAULT_EMPTY_HEIGHT
#define UNLOAD_DEFAULT_EMPTY_HEIGHT 2.0f  // Default empty height when at/below sensor (inches)
#endif

#ifndef UNLOAD_MIN_PEAK_HEIGHT
#define UNLOAD_MIN_PEAK_HEIGHT 12.0f  // Minimum peak height before tracking starts (inches)
#endif

#ifndef UNLOAD_DEBOUNCE_COUNT
#define UNLOAD_DEBOUNCE_COUNT 3  // Require 3 consecutive low readings to confirm unload
#endif

// Default momentary relay duration (30 minutes in seconds)
#ifndef DEFAULT_RELAY_MOMENTARY_SECONDS
#define DEFAULT_RELAY_MOMENTARY_SECONDS 1800  // 30 minutes
#endif

// ============================================================================
// Power Conservation State Machine
// Progressive duty-cycle reduction based on battery voltage.
// Uses hysteresis thresholds to prevent oscillation during charge/discharge.
// Voltage source: getEffectiveBatteryVoltage() — SunSaver MPPT (Modbus) preferred,
// analog Vin divider as fallback. Notecard card.voltage is never used (Fix 9/11).
// ============================================================================
enum PowerState : uint8_t {
  POWER_STATE_NORMAL            = 0,  // Full operation
  POWER_STATE_ECO               = 1,  // Reduced polling, longer sleep
  POWER_STATE_LOW_POWER         = 2,  // Minimal polling, relays frozen
  POWER_STATE_CRITICAL_HIBERNATE = 3  // Essential monitoring only, relays OFF
};

// --- Entry thresholds (voltage falling) ---
// We enter a worse state when battery drops BELOW these values.
#ifndef POWER_ECO_ENTER_VOLTAGE
#define POWER_ECO_ENTER_VOLTAGE            12.0f   // Enter ECO below 12.0V (~25% SOC lead-acid)
#endif
#ifndef POWER_LOW_ENTER_VOLTAGE
#define POWER_LOW_ENTER_VOLTAGE            11.8f   // Enter LOW_POWER below 11.8V (~10% SOC)
#endif
#ifndef POWER_CRITICAL_ENTER_VOLTAGE
#define POWER_CRITICAL_ENTER_VOLTAGE       11.5f   // Enter CRITICAL below 11.5V (risk of damage)
#endif

// --- Exit thresholds (voltage rising, with hysteresis) ---
// We return to a better state when battery rises ABOVE these values.
// The gap between enter and exit prevents rapid state toggling.
#ifndef POWER_CRITICAL_EXIT_VOLTAGE
#define POWER_CRITICAL_EXIT_VOLTAGE        12.2f   // Exit CRITICAL above 12.2V (+0.7V hysteresis)
#endif
#ifndef POWER_LOW_EXIT_VOLTAGE
#define POWER_LOW_EXIT_VOLTAGE             12.3f   // Exit LOW_POWER above 12.3V (+0.5V hysteresis)
#endif
#ifndef POWER_ECO_EXIT_VOLTAGE
#define POWER_ECO_EXIT_VOLTAGE             12.4f   // Exit ECO above 12.4V (+0.4V hysteresis)
#endif

// --- Timing for each power state ---
// Loop sleep duration (rtos::ThisThread::sleep_for)
#ifndef POWER_NORMAL_SLEEP_MS
#define POWER_NORMAL_SLEEP_MS              100       // 100ms (existing default)
#endif
#ifndef POWER_ECO_SLEEP_MS
#define POWER_ECO_SLEEP_MS                 5000      // 5 seconds
#endif
#ifndef POWER_LOW_SLEEP_MS
#define POWER_LOW_SLEEP_MS                 30000     // 30 seconds
#endif
#ifndef POWER_CRITICAL_SLEEP_MS
#define POWER_CRITICAL_SLEEP_MS            300000    // 5 minutes
#endif

// Daily firmware-update safety net (power-state override). In LOW_POWER and
// CRITICAL_HIBERNATE the frequent DFU check is skipped to conserve energy, but an OTA must
// NEVER be permanently blocked by power state. At least once per this interval the device
// force-checks (and applies) a pending firmware update regardless of voltage or power state.
#ifndef DAILY_DFU_CHECK_INTERVAL_MS
#define DAILY_DFU_CHECK_INTERVAL_MS        86400000UL  // 24 hours
#endif
// Grace period after boot before the first low-power DFU check, so the Notecard has time to
// connect/sync before we query it.
#ifndef DAILY_DFU_BOOT_GRACE_MS
#define DAILY_DFU_BOOT_GRACE_MS            120000UL    // 2 minutes
#endif

#ifndef POWER_STATE_PERIODIC_LOG_MS
#define POWER_STATE_PERIODIC_LOG_MS        1800000UL // 30 minutes
#endif

#ifndef POWER_STATE_TRANSITION_LOG_MIN_MS
#define POWER_STATE_TRANSITION_LOG_MIN_MS  300000UL  // 5 minutes
#endif

// Outbound sync multipliers (applied to base outbound interval)
#ifndef POWER_ECO_OUTBOUND_MULTIPLIER
#define POWER_ECO_OUTBOUND_MULTIPLIER      2    // 2x slower (e.g., 12h instead of 6h)
#endif
#ifndef POWER_LOW_OUTBOUND_MULTIPLIER
#define POWER_LOW_OUTBOUND_MULTIPLIER      4    // 4x slower (e.g., 24h instead of 6h)
#endif

// Inbound check multipliers
#ifndef POWER_ECO_INBOUND_MULTIPLIER
#define POWER_ECO_INBOUND_MULTIPLIER       4    // 4x slower
#endif
#ifndef POWER_LOW_INBOUND_MULTIPLIER
#define POWER_LOW_INBOUND_MULTIPLIER       12   // 12x slower
#endif

// Awaiting-config inbound poll interval (grid mode, software poll only)
// Used when monitorCount == 0 — device is unconfigured and needs to receive
// its first config from the server as quickly as possible.
#ifndef AWAITING_CONFIG_INBOUND_INTERVAL_MS
#define AWAITING_CONFIG_INBOUND_INTERVAL_MS  60000UL  // 1 minute
#endif

// Awaiting-config Notecard inbound interval (solar/periodic mode only)
// Overrides SOLAR_INBOUND_INTERVAL_MINUTES when monitorCount == 0 so the
// Notecard wakes to check for inbound notes more aggressively during provisioning.
// Restores to SOLAR_INBOUND_INTERVAL_MINUTES automatically once config arrives
// (configureNotecardHubMode() is called by applyConfigUpdate).
#ifndef AWAITING_CONFIG_SOLAR_INBOUND_MINUTES
#define AWAITING_CONFIG_SOLAR_INBOUND_MINUTES  5  // 5 minutes
#endif

// Sample interval multiplier
#ifndef POWER_ECO_SAMPLE_MULTIPLIER
#define POWER_ECO_SAMPLE_MULTIPLIER        2    // 2x slower
#endif
#ifndef POWER_LOW_SAMPLE_MULTIPLIER
#define POWER_LOW_SAMPLE_MULTIPLIER        4    // 4x slower
#endif

// Minimum consecutive readings before changing power state (debounce)
#ifndef POWER_STATE_DEBOUNCE_COUNT
#define POWER_STATE_DEBOUNCE_COUNT         3
#endif

// Digital sensor (float switch) constants
#ifndef DIGITAL_SWITCH_THRESHOLD
#define DIGITAL_SWITCH_THRESHOLD 0.5f  // Threshold to determine activated vs not-activated state
#endif

#ifndef DIGITAL_SENSOR_ACTIVATED_VALUE
#define DIGITAL_SENSOR_ACTIVATED_VALUE 1.0f  // Value returned when switch is activated
#endif

#ifndef DIGITAL_SENSOR_NOT_ACTIVATED_VALUE
#define DIGITAL_SENSOR_NOT_ACTIVATED_VALUE 0.0f  // Value returned when switch is not activated
#endif

// Helper function: Get pressure-to-inches conversion factor by unit name string
static float getPressureConversionFactorByName(const char* unit) {
  if (strcmp(unit, "bar") == 0) return getPressureConversionFactor(PressureUnit::BAR);
  if (strcmp(unit, "kPa") == 0) return getPressureConversionFactor(PressureUnit::KPA);
  if (strcmp(unit, "mbar") == 0) return getPressureConversionFactor(PressureUnit::MBAR);
  if (strcmp(unit, "inH2O") == 0) return getPressureConversionFactor(PressureUnit::IN_H2O);
  return getPressureConversionFactor(PressureUnit::PSI); // Default: PSI
}

// Helper function: Get distance-to-inches conversion factor by unit name string
static float getDistanceConversionFactorByName(const char* unit) {
  if (strcmp(unit, "m") == 0) return getDistanceConversionFactor(DistanceUnit::METER);
  if (strcmp(unit, "cm") == 0) return getDistanceConversionFactor(DistanceUnit::CENTIMETER);
  if (strcmp(unit, "ft") == 0) return getDistanceConversionFactor(DistanceUnit::FOOT);
  return getDistanceConversionFactor(DistanceUnit::INCH); // Default: assume inches
}

// Forward decl: defined after MonitorConfig is in scope below.
struct MonitorConfig;
static float getEffectiveSpecificGravity(const MonitorConfig &cfg);

// Object types - what is being monitored
enum ObjectType : uint8_t {
  OBJECT_TANK = 0,        // Liquid storage tank (level monitoring)
  OBJECT_ENGINE = 1,      // Engine or motor (RPM monitoring)
  OBJECT_PUMP = 2,        // Pump (status or flow monitoring)
  OBJECT_GAS = 3,         // Gas pressure system (propane, natural gas, etc.)
  OBJECT_FLOW = 4,        // Flow meter (liquid or gas flow rate)
  OBJECT_CUSTOM = 255     // User-defined/other
};

// Fluid type presets - used to derive specific gravity for pressure->height conversion.
// Specific gravity (SG) is the ratio of fluid density to water density at standard conditions.
// SG affects how much head pressure a column of fluid produces:
//   inches_of_fluid = (PSI * 27.68) / SG
// So a 27.68 in/PSI conversion (assuming water) under-reports level for fluids lighter
// than water (e.g., diesel SG=0.85 reads ~17% low) and over-reports for heavier fluids.
enum FluidType : uint8_t {
  FLUID_WATER = 0,         // 1.00
  FLUID_DIESEL = 1,        // 0.85
  FLUID_GASOLINE = 2,      // 0.74
  FLUID_HEATING_OIL = 3,   // 0.85
  FLUID_PROPANE_LPG = 4,   // 0.50 (liquid LPG)
  FLUID_BRINE = 5,         // 1.20
  FLUID_CRUDE_OIL = 6,     // 0.83
  FLUID_USED_OIL = 7,      // 0.92
  FLUID_GLYCOL_50 = 8,     // 1.07 (50/50 propylene glycol antifreeze)
  FLUID_DEF_ADBLUE = 9,    // 1.09 (Diesel Exhaust Fluid / AdBlue)
  FLUID_ETHANOL = 10,      // 0.79
  FLUID_CUSTOM = 255       // Use MonitorConfig.fluidSpecificGravity (manual entry)
};

// Returns the preset SG for a fluid type. For FLUID_CUSTOM, returns 0.0 to signal
// "caller must use the manually entered fluidSpecificGravity".
static float getPresetSpecificGravity(FluidType ft) {
  switch (ft) {
    case FLUID_WATER:        return 1.00f;
    case FLUID_DIESEL:       return 0.85f;
    case FLUID_GASOLINE:     return 0.74f;
    case FLUID_HEATING_OIL:  return 0.85f;
    case FLUID_PROPANE_LPG:  return 0.50f;
    case FLUID_BRINE:        return 1.20f;
    case FLUID_CRUDE_OIL:    return 0.83f;
    case FLUID_USED_OIL:     return 0.92f;
    case FLUID_GLYCOL_50:    return 1.07f;
    case FLUID_DEF_ADBLUE:   return 1.09f;
    case FLUID_ETHANOL:      return 0.79f;
    case FLUID_CUSTOM:       return 0.0f;  // signal: use manual override
    default:                 return 1.00f;
  }
}

static FluidType parseFluidTypeName(const char *name) {
  if (!name) return FLUID_WATER;
  if (strcmp(name, "water") == 0)        return FLUID_WATER;
  if (strcmp(name, "diesel") == 0)       return FLUID_DIESEL;
  if (strcmp(name, "gasoline") == 0)     return FLUID_GASOLINE;
  if (strcmp(name, "heatingOil") == 0)   return FLUID_HEATING_OIL;
  if (strcmp(name, "propane") == 0 || strcmp(name, "lpg") == 0) return FLUID_PROPANE_LPG;
  if (strcmp(name, "brine") == 0)        return FLUID_BRINE;
  if (strcmp(name, "crudeOil") == 0)     return FLUID_CRUDE_OIL;
  if (strcmp(name, "usedOil") == 0)      return FLUID_USED_OIL;
  if (strcmp(name, "glycol50") == 0)     return FLUID_GLYCOL_50;
  if (strcmp(name, "def") == 0 || strcmp(name, "adblue") == 0) return FLUID_DEF_ADBLUE;
  if (strcmp(name, "ethanol") == 0)      return FLUID_ETHANOL;
  if (strcmp(name, "custom") == 0)       return FLUID_CUSTOM;
  return FLUID_WATER;
}

static const char *fluidTypeName(FluidType ft) {
  switch (ft) {
    case FLUID_WATER:       return "water";
    case FLUID_DIESEL:      return "diesel";
    case FLUID_GASOLINE:    return "gasoline";
    case FLUID_HEATING_OIL: return "heatingOil";
    case FLUID_PROPANE_LPG: return "propane";
    case FLUID_BRINE:       return "brine";
    case FLUID_CRUDE_OIL:   return "crudeOil";
    case FLUID_USED_OIL:    return "usedOil";
    case FLUID_GLYCOL_50:   return "glycol50";
    case FLUID_DEF_ADBLUE:  return "def";
    case FLUID_ETHANOL:     return "ethanol";
    case FLUID_CUSTOM:      return "custom";
    default:                return "water";
  }
}

// Sensor interface types - how the measurement is taken
enum SensorInterface : uint8_t {
  SENSOR_DIGITAL = 0,       // Binary on/off (float switch, relay contact)
  SENSOR_ANALOG = 1,        // Voltage output (0-10V, 1-5V)
  SENSOR_CURRENT_LOOP = 2,  // 4-20mA current loop
  SENSOR_PULSE = 3          // Pulse/frequency counting (hall effect, flow meter)
};

// 4-20mA current loop sensor subtypes
enum CurrentLoopSensorType : uint8_t {
  CURRENT_LOOP_PRESSURE = 0,    // Pressure sensor mounted near bottom of tank (e.g., Dwyer 626-06-CB-P1-E5-S1)
                                // 4mA = empty (0 PSI), 20mA = full (max PSI)
  CURRENT_LOOP_ULTRASONIC = 1   // Ultrasonic sensor mounted on top of tank (e.g., Siemens Sitrans LU240)
                                // 4mA = full (sensor close to liquid), 20mA = empty (sensor far from liquid)
};

// Hall effect sensor types for RPM measurement
enum HallEffectSensorType : uint8_t {
  HALL_EFFECT_UNIPOLAR = 0,     // Triggered by single pole (usually South), reset when field removed
  HALL_EFFECT_BIPOLAR = 1,      // Latching: South pole turns ON, North pole turns OFF
  HALL_EFFECT_OMNIPOLAR = 2,    // Responds to either North or South pole
  HALL_EFFECT_ANALOG = 3        // Linear/analog: outputs voltage proportional to magnetic field strength
};

// Hall effect detection method
enum HallEffectDetectionMethod : uint8_t {
  HALL_DETECT_PULSE = 0,        // Count pulses (transitions) - traditional method
  HALL_DETECT_TIME_BASED = 1    // Measure time between pulses - more flexible for different magnet types
};

// Relay trigger conditions - which alarm type triggers the relay
enum RelayTrigger : uint8_t {
  RELAY_TRIGGER_ANY = 0,   // Trigger on any alarm (high or low)
  RELAY_TRIGGER_HIGH = 1,  // Trigger only on high alarm
  RELAY_TRIGGER_LOW = 2    // Trigger only on low alarm
};

// Relay engagement mode - how long the relay stays on
enum RelayMode : uint8_t {
  RELAY_MODE_MOMENTARY = 0,     // Momentary on for configurable duration, then auto-off
  RELAY_MODE_UNTIL_CLEAR = 1,   // Stay on until alarm clears
  RELAY_MODE_MANUAL_RESET = 2   // Stay on until manually reset from server
};

// Default relay engagement duration (30 minutes in seconds)
#define RELAY_DEFAULT_MOMENTARY_SECONDS 1800

struct MonitorConfig {
  char id;                 // Friendly identifier (A, B, C ...)
  char name[24];           // Label shown in reports (e.g., "North Tank", "Main Pump")
  char contents[24];       // What the tank contains (e.g., "Diesel", "Water") - not used for RPM monitors
  uint8_t sensorIndex;   // Numeric reference (1, 2, 3...)
  uint8_t userNumber;    // Optional user-assigned display number (0 = unset)
  ObjectType objectType;   // What is being monitored (tank, engine, pump, gas, flow)
  SensorInterface sensorInterface; // How measurement is taken (digital, analog, currentLoop, pulse)
  int16_t primaryPin;      // Digital pin or analog channel
  int16_t secondaryPin;    // Optional secondary pin (unused by default)
  int16_t currentLoopChannel; // 4-20mA channel index (-1 if unused)
  int16_t pulsePin;        // Pulse sensor pin for RPM/flow (-1 if unused)
  uint8_t pulsesPerUnit;   // Pulses per revolution (RPM) or per gallon (flow), default 1
  HallEffectSensorType hallEffectType; // Type of hall effect sensor (unipolar, bipolar, omnipolar, analog)
  HallEffectDetectionMethod hallEffectDetection; // Detection method (pulse counting or time-based)
  uint32_t pulseSampleDurationMs; // Sample duration for pulse measurement (default 60000ms = 60s)
  bool pulseAccumulatedMode; // If true, count pulses between telemetry reports for very low rates
  bool alarmsEnabled;      // True only when alarm thresholds were explicitly configured
  float highAlarmThreshold;   // High threshold for triggering alarm
  float lowAlarmThreshold;    // Low threshold for triggering alarm
  float hysteresisValue;   // Hysteresis band (default 2.0)
  bool enableDailyReport;  // Include in daily summary
  bool enableAlarmSms;     // Escalate SMS when alarms trigger
  bool enableServerUpload; // Send telemetry to server
  float reportThreshold;   // Minimum change, in THIS monitor's own measurement unit, before a
                           // change-based telemetry note is sent. 0 = disabled (baseline + daily +
                           // alarms only). Unit-agnostic: inches for tanks, PSI for gas, RPM for
                           // engines, GPM for flow, etc.
  char relayTargetClient[48]; // Client UID to trigger relays on (empty = none)
  uint8_t relayMask;       // Bitmask of relays to trigger (bit 0=relay 1, etc.)
  RelayTrigger relayTrigger; // Which alarm type triggers the relay (any, high, low)
  RelayMode relayMode;     // How long relay stays on (momentary, until_clear, manual_reset)
  uint16_t relayMomentarySeconds[4]; // Per-relay momentary duration in seconds (0 = use default 30 min)
  uint32_t relayMaxOnSeconds;  // Max ON duration for MANUAL_RESET mode (0 = no limit, default)
  // Digital sensor (float switch) specific settings
  char digitalTrigger[16]; // 'activated' or 'not_activated' - when to trigger alarm for digital sensors
  char digitalSwitchMode[4]; // 'NO' for normally-open, 'NC' for normally-closed (default: NO)
  // 4-20mA current loop sensor settings
  CurrentLoopSensorType currentLoopType; // Pressure (bottom-mounted) or Ultrasonic (top-mounted)
  float sensorMountHeight; // For ultrasonic: distance from sensor to tank bottom (inches)
                           // For pressure: height of sensor above tank bottom (inches, usually 0-2)
  float sensorRangeMin;    // Minimum native sensor range (e.g., 0 for 0-5 PSI or 0-10m)
  float sensorRangeMax;    // Maximum native sensor range (e.g., 5 for 0-5 PSI, 10 for 0-10m)
  char sensorRangeUnit[8]; // Unit for sensor range: "PSI", "bar", "m", "ft", "in", etc.
  // Sensor loop power (v2.1.0, extended v2.1.3): the 4-20mA transmitter is powered either
  // by the A0602 channel's own DAC (~11V out the channel's +/- screw terminals, current ADC
  // overlaid on the same channel) or — reinstated in v2.1.3 for transmitters that need more
  // than the 11V DAC ceiling minus the ~2V full-scale drop across the internal 100R sense
  // resistor — by a P1-P4 high-side transistor switching an external 12-24V supply
  // (soft-ramped on/off to protect the gate MOSFET; see the P1 failure post-mortem).
  bool loopPowerEnabled;         // Duty-cycled loop power enabled (false = externally powered, always-on loop)
  uint8_t loopPowerMode;         // LOOP_POWER_MODE_DAC (default) or LOOP_POWER_MODE_PWM
  int16_t loopPowerPwmChannel;   // PWM mode only: transistor output index (0 = P1 .. 3 = P4)
  uint32_t loopPowerWarmup;      // ms of transmitter power-up stabilization before sampling (default 3000)
  uint16_t loopPowerSampleDelay; // ms between individual samples in the averaging loop (default 300)
  float sensorMinVoltage;        // v2.1.3: transmitter's datasheet minimum supply voltage (default 10.0V);
                                 // used by assessLoopClipping() to compute the max un-clipped loop current
  // Fluid characterization (for liquid tanks; ignored for OBJECT_GAS / non-tank objects).
  // Used as the fallback SG before the server's calibration learning takes over.
  FluidType fluidType;             // Fluid preset (default FLUID_WATER)
  float fluidSpecificGravity;      // Manual SG override; only used when fluidType == FLUID_CUSTOM
  // Server-pushed learned calibration (current-loop sensors only). When hasLearnedCalibration
  // is set, the client applies level = calSlope*mA + calOffset + calTempCoef*(calTempF-70)
  // instead of the theoretical conversion, so the client's level (and therefore its alarm
  // thresholds) match the server's calibrated display. calVersion (cv) is echoed back in
  // every note so the server knows which calibration the client used.
  bool hasLearnedCalibration;      // True once the server has pushed a learned calibration
  float calSlope;                  // Learned inches per mA
  float calOffset;                 // Learned offset (inches)
  float calTempCoef;               // Temp coefficient (inches per °F from 70°F); 0 = no temp comp
  float calTempF;                  // Server-pushed temperature for tempCoef (°F); used only when calTempCoef != 0
  uint32_t calVersion;             // Calibration version (cv) echoed back to the server
  // Analog voltage sensor settings (for sensors like Dwyer 626 with voltage output)
  float analogVoltageMin;  // Minimum voltage output (e.g., 0.0 for 0-10V, 1.0 for 1-5V)
  float analogVoltageMax;  // Maximum voltage output (e.g., 10.0 for 0-10V, 5.0 for 1-5V)
  // Measurement unit for display/reporting
  char measurementUnit[8]; // "inches", "psi", "rpm", "gpm", etc.
  // Expected pulse rate for baseline comparison (by object type)
  float expectedPulseRate; // Expected RPM for engines, GPM for flow, etc. (0 = not configured)
  // Stuck sensor detection
  bool stuckDetectionEnabled; // true = flag sensor as failed after 10 identical readings
  // Tank unload tracking configuration
  bool trackUnloads;          // true = this tank is regularly emptied, track unload events
  float unloadEmptyHeight;    // Default empty height when level drops to/below sensor height (inches)
  float unloadDropThreshold;  // Minimum drop to consider as unload (inches, default 50% of tank height)
  float unloadDropPercent;    // Alternative: minimum drop as percentage of peak height (0-100, default 50)
  bool unloadAlarmSms;        // Send SMS notification when tank is unloaded
  bool unloadAlarmEmail;      // Include unload events in daily email
};

struct ClientConfig {
  uint8_t configSchemaVersion;  // Schema version for forward/backward compat detection
  char siteName[32];
  char deviceUid[32];   // Device UID (e.g., dev:...)
  char deviceLabel[24];
  char clientFleet[32]; // Fleet for this device context
  char serverFleet[32]; // Target fleet name for server (e.g., "tankalarm-server")
  char productUid[64];  // Notehub product UID (configurable for different fleets)
  char dailyEmail[64];
  uint16_t sampleSeconds;
  uint8_t reportHour;
  uint8_t reportMinute;
  uint8_t monitorCount;
  MonitorConfig monitors[MAX_MONITORS];
  // Optional clear button configuration
  int8_t clearButtonPin;        // Pin for physical clear button (-1 = disabled)
  bool clearButtonActiveHigh;   // true = button active when HIGH, false = active when LOW (with pullup)
  // Power saving configuration
  bool solarPowered;            // true = solar powered (use power saving features), false = grid-tied
  // I2C sensor configuration  
  uint8_t currentLoopI2cAddress; // I2C address for 4-20mA current loop sensor (default 0x64)
  // Solar/Battery charger monitoring configuration (SunSaver MPPT via RS-485)
  // Requires: Arduino Opta with RS485 + Morningstar MRC-1 adapter
  SolarConfig solarCharger;     // Solar charger monitoring configuration
  // Battery voltage monitoring via Notecard (when wired directly to battery)
  // Provides low voltage alerts and trend analysis
  BatteryConfig batteryMonitor; // Notecard battery voltage monitoring
  // Analog voltage divider for reading actual battery voltage (Vin)
  // Requires external resistor divider wired to an Opta analog input
  VinMonitorConfig vinMonitor;  // Optional analog Vin voltage divider
  // Solar-Only (No Battery) mode configuration
  // For installations powered directly by solar panel without battery backup
  SolarOnlyConfig solarOnlyConfig;
  // Remote-tunable power conservation thresholds (0.0 = use compile-time default)
  // Allows server to adjust voltage trip points without firmware update
  float powerEcoEnterV;       // Enter ECO below this voltage (default: POWER_ECO_ENTER_VOLTAGE)
  float powerLowEnterV;       // Enter LOW_POWER below this voltage
  float powerCriticalEnterV;  // Enter CRITICAL below this voltage
  float powerEcoExitV;        // Exit ECO above this voltage
  float powerLowExitV;        // Exit LOW_POWER above this voltage
  float powerCriticalExitV;   // Exit CRITICAL above this voltage
  // Remote-tunable health check interval (0 = use compile-time default)
  uint32_t healthCheckBaseIntervalMs;  // Base Notecard health check interval in ms
  uint32_t configEpoch;                // Generation timestamp of the currently active configuration
};

struct MonitorRuntime {
  float currentValue;           // Latest reading in the monitor's own measurement unit:
                                // inches for level, psi for pressure, rpm for engines,
                                // gpm for flow, 1.0/0.0 for digital float switches.
  float currentSensorMa;        // Raw sensor reading in milliamps (for 4-20mA sensors)
  float currentSensorVoltage;   // Raw sensor reading in volts (for analog voltage sensors)
  double lastReadingEpoch;      // Epoch when current reading was actually acquired
  bool sampleReused;            // True when this cycle reused the previous reading
  bool lastLoopPowerOk;         // result of the last loop power-up (v2.1.0: DAC loop-power config)
  bool clipSuspected;           // v2.1.3: last mA reading may be supply-voltage clipped (see assessLoopClipping)
  float lastSupplyVoltage;      // v2.1.3: loop supply voltage used for the clip assessment (0 = unknown)
  float lastReportedValue;   // Last value pushed via change-based telemetry (monitor's own unit)
  float lastDailySentValue;  // Last value included in a daily report (monitor's own unit)
  bool highAlarmLatched;
  bool lowAlarmLatched;
  uint8_t pendingAlarm;         // C-T01: ALARM_PENDING_* edge awaiting its note; RAM only
  unsigned long lastSampleMillis;
  unsigned long lastAlarmSendMillis;
  // Debouncing state
  uint8_t highAlarmDebounceCount;
  uint8_t lowAlarmDebounceCount;
  uint8_t highClearDebounceCount;
  uint8_t lowClearDebounceCount;
  // Sensor failure detection
  float lastValidReading;
  bool hasLastValidReading;
  uint8_t consecutiveFailures;
  uint8_t stuckReadingCount;
  bool sensorFailed;
  uint8_t recoveryCount;         // Consecutive good readings after failure (debounce)
  // Rate limiting
  unsigned long alarmTimestamps[MAX_ALARMS_PER_HOUR];
  uint8_t alarmCount;
  unsigned long lastHighAlarmMillis;
  unsigned long lastLowAlarmMillis;
  unsigned long lastClearAlarmMillis;
  unsigned long lastSensorFaultMillis;
  // Tank unload tracking state
  float unloadPeakInches;         // Highest level seen since last unload event
  float unloadPeakSensorMa;       // Sensor mA at peak level (for logging)
  double unloadPeakEpoch;         // Timestamp of peak reading
  bool unloadTracking;            // true = currently tracking fill cycle
};

static ClientConfig gConfig;
static MonitorRuntime gMonitorState[MAX_MONITORS];

// Global alarm rate limiting (across all sensors)
static unsigned long gGlobalAlarmTimestamps[MAX_GLOBAL_ALARMS_PER_HOUR];
static uint8_t gGlobalAlarmCount = 0;

// Solar/Battery charger monitoring (SunSaver MPPT via RS-485)
static SolarManager gSolarManager;
static unsigned long gLastSolarAlarmMillis = 0;
static SolarAlertType gLastSolarAlert = SOLAR_ALERT_NONE;
#define SOLAR_ALARM_MIN_INTERVAL_MS 3600000UL  // Min 1 hour between same solar alarm

// Battery voltage monitoring via Notecard (when wired directly to battery)
static BatteryData gBatteryData;
static unsigned long gLastBatteryPollMillis = 0;
static unsigned long gLastBatteryAlarmMillis = 0;
static BatteryAlertType gLastBatteryAlert = BATTERY_ALERT_NONE;
static float gLastBatteryAlertVoltage = 0.0f;

// Analog Vin voltage divider monitoring
static float gVinVoltage = 0.0f;          // Last reading from voltage divider (actual battery V)
static unsigned long gLastVinPollMillis = 0;

// Solar-Only (No Battery) runtime state
static bool gSolarOnlyStartupComplete = false;   // Has startup debounce/warmup passed?
static bool gSolarOnlySensorsReady = false;       // Is voltage high enough for sensors?
static bool gSolarOnlySunsetActive = false;       // Is sunset protocol in progress?
static unsigned long gSolarOnlySunsetStart = 0;   // When voltage decline was first detected
static float gSolarOnlyLastVin = 0.0f;            // Previous Vin reading for trend detection
static double gSolarOnlyLastReportEpoch = 0.0;    // Last daily report epoch (persisted to flash)
static uint32_t gSolarOnlyBootCount = 0;          // Boot counter (persisted to flash)
static bool gSolarOnlyBatteryFailed = false;      // Battery failure fallback active?
static uint8_t gSolarOnlyBatFailCount = 0;        // Consecutive critical battery readings
// Set true on the first boot after a firmware version change (OTA or USB update). Triggers an
// immediate confirmation telemetry sync so transmission can be verified without waiting for the
// next periodic/daily sync window.
static bool gFirmwareJustUpdated = false;
static unsigned long gSolarOnlyBatFailLastIncrMillis = 0; // When bat-fail count was last incremented
static bool gSolarOnlyStateSaved = false;         // Has state been saved during sunset?

// 24-hour decay period for battery failure counter (prevents long-term false accumulation)
#ifndef SOLAR_BAT_FAIL_DECAY_MS
#define SOLAR_BAT_FAIL_DECAY_MS (24UL * 60UL * 60UL * 1000UL)  // 24 hours
#endif

// Is solar-only behavior active (either configured or battery failure fallback)?
static bool isSolarOnlyActive() {
  return gConfig.solarOnlyConfig.enabled || gSolarOnlyBatteryFailed;
}

// Power conservation state machine
static PowerState gPowerState = POWER_STATE_NORMAL;
static PowerState gPreviousPowerState = POWER_STATE_NORMAL;
static float gEffectiveBatteryVoltage = 0.0f;  // Best voltage from either source
static const char *gEffectiveVoltageSource = nullptr;  // Fix 7: source of the last effective voltage ("mppt" | "vin-divider"); nullptr when none
static uint8_t gPowerStateDebounce = 0;        // Consecutive readings at proposed new state
static unsigned long gPowerStateChangeMillis = 0; // When the current power state was entered
static unsigned long gLastPowerStateLogMillis = 0; // Rate-limit power state log messages
static unsigned long gLastPowerStateTransitionLogMillis = 0; // Rate-limit transition log spam

// Health telemetry tracking
#ifdef TANKALARM_HEALTH_TELEMETRY_ENABLED
static unsigned long gLastHealthTelemetryMillis = 0;
static uint32_t gHeapMinFreeBytes = UINT32_MAX;  // Low-watermark tracker
static uint32_t gNotecardCommErrorCount = 0;      // Cumulative I2C/serial comm failures
static uint32_t gStorageWriteErrorCount = 0;      // Cumulative flash write failures
#endif

static Notecard notecard;
static char gDeviceUID[48] = {0};
static unsigned long gLastTelemetryMillis = 0;
static unsigned long gLastHeartbeatMillis = 0;
static unsigned long gLastConfigCheckMillis = 0;
static unsigned long gLastTimeSyncMillis = 0;
static double gLastSyncedEpoch = 0.0;
static double gNextDailyReportEpoch = 0.0;

// DFU (Device Firmware Update) state tracking
static unsigned long gLastDfuCheckMillis = 0;
// Last forced daily DFU check while in a low-power state (LOW_POWER/CRITICAL_HIBERNATE).
// 0 = not yet run this boot; the first check fires after DAILY_DFU_BOOT_GRACE_MS.
static unsigned long gLastDailyDfuCheckMillis = 0;
static bool gDfuUpdateAvailable = false;
static char gDfuVersion[32] = {0};
static bool gDfuInProgress = false;

static bool gConfigDirty = false;
// BugFix v1.6.2 (I-11): Deferred ACK state — ACK is sent only after persistence succeeds.
static bool gPendingConfigAck = false;
static char gPendingConfigAckVersion[16] = {0};
static bool gPendingConfigAckSuccess = true;
static char gPendingConfigAckMessage[48] = "Config applied and persisted";
static unsigned long gPendingConfigAckRetryAt = 0;
static unsigned long gPendingConfigAckRetryDelayMs = 5000UL;
static bool gHardwareSummaryPrinted = false;
static bool gChemistryChecked = false;

// Network failure handling
static unsigned long gLastSuccessfulNotecardComm = 0;
static unsigned long gLastSuccessfulNoteSend = 0;  // Last successful note.add (separate from card.wireless)
static uint8_t gNotecardFailureCount = 0;
static bool gNotecardAvailable = true;
#define NOTECARD_RETRY_INTERVAL 60000UL  // Retry after 60 seconds
#define NOTECARD_MODEM_STALL_MS (4UL * 60UL * 60UL * 1000UL)  // 4 hours without note send = modem stall

// Cellular signal strength cache (updated by checkNotecardHealth via card.wireless)
static int8_t gSignalBars = -1;     // 0-4 bars, -1 = unknown
static int16_t gSignalRssi = 0;     // RSSI in dBm
static int16_t gSignalRsrp = 0;     // RSRP in dBm (LTE reference signal power)
static int16_t gSignalRsrq = 0;     // RSRQ in dB  (LTE reference signal quality)
static char gSignalRat[8] = {0};    // Radio access technology (e.g., "lte", "catm")

// I2C bus error tracking (current loop / A0602)
// Non-static: extern-linked via TankAlarm_I2C.h shared functions
uint32_t gCurrentLoopI2cErrors = 0;
uint32_t gI2cBusRecoveryCount = 0;

// v2.0.47: A0602 managed-addressing state. Blueprint expansions are assigned a dynamic I2C
// address (from OPTA_CONTROLLER_FIRST_AVAILABLE_ADDRESS = 0x0B upward) when the controller
// runs its bootstrap; the legacy 0x64/0x0A probe missed those entirely. bootstrapA0602Managed()
// in setup() runs OptaController.begin()+update() ONCE to discover the real assigned address
// (and turn the A0602 status LED GREEN). gConfig.currentLoopI2cAddress is then steered at that
// address so the existing v2.0.46 framed-protocol read path talks to the right place. The
// controller is NOT polled after bootstrap (no OptaController.update() in the hot loop), so it
// never competes with the raw Blueprint frames for the shared I2C bus.
static int     gA0602DeviceIndex    = -1;     // -1 => bootstrap failed / no expansion
static uint8_t gA0602ManagedAddress = 0x00;   // assigned address (0x0B..) captured at boot
static bool    gOptaControllerReady = false;

// v2.0.46: A0602 current-loop diagnostics (daily-windowed; reset with gCurrentLoopI2cErrors).
// Make the shared-bus health observable in Notehub so a field A0602 fault is measurable, and
// so the per-op 400kHz window's effect on read latency (gLastClBurstMicros) can be confirmed.
enum ClFaultReason : uint8_t {
  CL_FAULT_NONE = 0,        // last A0602 read OK
  CL_FAULT_PWM_NACK = 1,    // PWM loop-power enable NACKed (reinstated v2.1.3 for PWM mode)
  CL_FAULT_CONFIG_NACK = 2, // channel config NACKed (DAC loop power or ext-power ADC)
  CL_FAULT_FUNC_WRONG = 3,  // RETIRED v2.1.0 (was: channel not in current-ADC mode; 0x40 GET unreliable)
  CL_FAULT_READ_FAIL = 4,   // every framed sample failed
  CL_FAULT_OVER_RANGE = 5,  // reading rejected as >21mA / 0xFFFF garbage
  CL_FAULT_UNDER_RANGE = 6  // reading valid but below 4-20mA live-zero threshold (loop open?)
};

// Fix 12 (v2.0.51): stable short strings for the current-loop fault enum, emitted in
// telemetry/daily/alarm payloads when a current-loop read fails. Server-side dashboards
// can show these directly (or map them to human-readable text), so a failed read can never
// be confused for a successful 0.0 PSI / 0.0 in reading.
static inline const char *clFaultReasonString(uint8_t reason) {
  switch (reason) {
    case CL_FAULT_NONE:        return "ok";
    case CL_FAULT_PWM_NACK:    return "pwm_nack";
    case CL_FAULT_CONFIG_NACK: return "config_nack";
    case CL_FAULT_FUNC_WRONG:  return "func_wrong";
    case CL_FAULT_READ_FAIL:   return "read_fail";
    case CL_FAULT_OVER_RANGE:  return "over_range";
    case CL_FAULT_UNDER_RANGE: return "under_range";
    default:                   return "unknown";
  }
}
uint32_t gCurrentLoopReadsOk = 0;            // valid A0602 reads this window
uint32_t gCurrentLoopOverRange = 0;          // reads rejected as over-range/garbage this window
uint8_t  gLastClFaultReason = CL_FAULT_NONE; // last A0602 fault code (see ClFaultReason)
uint32_t gLastClBurstMicros = 0;             // duration (us) of the last A0602 read burst

// Startup I2C scan results — persisted for first health telemetry report
static bool gStartupNotecardFound = false;
static bool gStartupCurrentLoopFound = false;
static uint8_t gStartupScanRetries = 0;
static uint8_t gStartupUnexpectedDevices = 0;
static bool gStartupScanReported = false;

static const size_t DAILY_NOTE_PAYLOAD_LIMIT = 960U;

// Relay control state
// MAX_RELAYS is defined in TankAlarm_Common.h
static bool gRelayState[MAX_RELAYS] = {false, false, false, false};
static unsigned long gLastRelayCheckMillis = 0;

// Per-relay runtime state (RelayRuntime struct defined in TankAlarm_Common.h)
static RelayRuntime gRelayRuntime[MAX_RELAYS] = {};

// Forward declarations for relay helper functions
// (Arduino auto-prototyping does not handle default parameters correctly)
static uint8_t findMonitorForRelay(uint8_t relayNum);
static void activateRelayForMonitor(uint8_t monitorIdx, uint8_t relayMask,
                                     RelaySource source, unsigned long now,
                                     uint32_t customDurationSec = 0);
static void deactivateRelayForMonitor(uint8_t monitorIdx, uint8_t relayMask);
static bool isMonitorRelayActive(uint8_t monitorIdx);
static uint8_t getMonitorActiveRelayMask(uint8_t monitorIdx);

// Clear button state for debouncing
static unsigned long gClearButtonLastPressTime = 0;
static bool gClearButtonLastState = false;
static bool gClearButtonInitialized = false;
#define CLEAR_BUTTON_DEBOUNCE_MS 50
#define CLEAR_BUTTON_MIN_PRESS_MS 500  // Require 500ms press to clear (prevent accidental triggers)

// On-board front-panel USER button (BTN_USER) — short-press triggers an
// immediate hub.sync so the operator can pull pending config/relay updates
// from Notehub without waiting for the next polling interval.
#ifdef BTN_USER
static bool gUserButtonInitialized = false;
static bool gUserButtonLastState = false;          // debounced pressed-state
static unsigned long gUserButtonChangeTime = 0;    // last raw transition
static unsigned long gUserButtonLastSyncTime = 0;  // last hub.sync trigger
#define USER_BUTTON_DEBOUNCE_MS 50
#define USER_BUTTON_SYNC_COOLDOWN_MS 30000UL  // throttle hub.sync to once per 30s
#endif

// Temporary continuous-mode "service window" — opened by USER button on
// solar/periodic clients so any inbound notes that arrive at Notehub during
// the window are delivered immediately. Auto-restores to periodic when expired.
static unsigned long gServiceWindowUntil = 0;     // 0 = inactive; else millis() expiry
static bool gServiceWindowActive = false;
#define SERVICE_WINDOW_DURATION_MS 1800000UL  // 30 minutes

// RPM sensor state for Hall effect pulse counting
// We track pulses per monitor that uses an RPM sensor
static unsigned long gRpmLastSampleMillis[MAX_MONITORS] = {0};
static float gRpmLastReading[MAX_MONITORS] = {0.0f};
static int gRpmLastPinState[MAX_MONITORS];  // Initialized dynamically in setup()
// For time-based detection: track time between pulses
static unsigned long gRpmLastPulseTime[MAX_MONITORS] = {0};
static unsigned long gRpmPulsePeriodMs[MAX_MONITORS] = {0};
// For accumulated mode: count pulses between telemetry reports
static volatile uint32_t gRpmAccumulatedPulses[MAX_MONITORS] = {0};
static unsigned long gRpmAccumulatedStartMillis[MAX_MONITORS] = {0};
static bool gRpmAccumulatedInitialized[MAX_MONITORS] = {false};

// Atomic access helpers for volatile pulse counter (protects against future interrupt use)
// On 32-bit ARM (Cortex-M7 in STM32H747XI), 32-bit aligned reads/writes are atomic,
// but we use interrupt guards for portability and read-modify-write safety
static inline uint32_t atomicReadAndResetPulses(uint8_t idx) {
  noInterrupts();
  uint32_t count = gRpmAccumulatedPulses[idx];
  gRpmAccumulatedPulses[idx] = 0;
  interrupts();
  return count;
}

static inline void atomicResetPulses(uint8_t idx) {
  noInterrupts();
  gRpmAccumulatedPulses[idx] = 0;
  interrupts();
}

static inline void atomicIncrementPulses(uint8_t idx) {
  noInterrupts();
  gRpmAccumulatedPulses[idx]++;
  interrupts();
}

static inline uint32_t atomicReadPulses(uint8_t idx) {
  noInterrupts();
  uint32_t count = gRpmAccumulatedPulses[idx];
  interrupts();
  return count;
}

// Default RPM sampling duration in milliseconds (60 seconds for 1 RPM minimum detection)
// To detect 0.1 RPM, use pulseAccumulatedMode=true with sampleSeconds >= 600
#ifndef RPM_SAMPLE_DURATION_MS
#define RPM_SAMPLE_DURATION_MS 60000
#endif

// Helper: Get recommended pulse sampling parameters based on expected rate
// This helps configure optimal sampling for the expected RPM/flow rate range
// Returns: pulseSampleDurationMs, pulseAccumulatedMode recommendations
struct PulseSamplingRecommendation {
  uint32_t sampleDurationMs;  // Recommended sample duration
  bool accumulatedMode;       // Whether to use accumulated mode
  const char *description;    // Human-readable description
};

// Serial log buffer structure for client
struct SerialLogEntry {
  double timestamp;
  char message[160];
};

struct ClientSerialLog {
  SerialLogEntry entries[CLIENT_SERIAL_BUFFER_SIZE];
  uint8_t writeIndex;
  uint8_t count;
};

static ClientSerialLog gSerialLog;
static unsigned long gLastSerialRequestCheckMillis = 0;
static unsigned long gLastLocationRequestCheckMillis = 0;
static unsigned long gLastTelemetryRequestCheckMillis = 0;
static unsigned long gLastTelemetryRequestHandledMillis = 0;  // throttle: ignore duplicate requests within cooldown

// Forward declarations
static PulseSamplingRecommendation getRecommendedPulseSampling(float expectedRate);
static inline bool detectPulseEdge(HallEffectSensorType hallType, int lastState, int currentState);
static void startPulseSample(uint8_t idx, const MonitorConfig &cfg);
static float getMonitorHeight(const MonitorConfig &cfg);
static void initializeStorage();
static void ensureConfigLoaded();
static void printConfigSummary();
static void createDefaultConfig(ClientConfig &cfg);
static bool loadConfigFromFlash(ClientConfig &cfg);
static void initMonitorDefaults(MonitorConfig &mon, uint8_t index);
static void parseMonitorFromJson(MonitorConfig &mon, JsonObjectConst t, uint8_t index);
static bool saveConfigToFlash(const ClientConfig &cfg);
static void printHardwareRequirements(const ClientConfig &cfg);
static bool i2cAck(uint8_t address);
static uint8_t resolveCurrentLoopI2cAddress(uint8_t preferredAddress);
static void initializeNotecard();
static void configureNotecardHubMode();
static void syncTimeFromNotecard();
static double currentEpoch();
static void scheduleNextDailyReport();
static void checkForFirmwareUpdate();
static void enableDfuMode();
static void pollForConfigUpdates();
static void applyConfigUpdate(const JsonDocument &doc);
static bool sendConfigAck(bool success, const char *message, const char *configVersion);
static bool sendOtaReportNote(const char *st, const char *targetV, const char *reason);
static void reportOtaOutcome();
static void persistConfigIfDirty();
static void retryPendingConfigAckIfDue();
static void sampleMonitors();
static float readDigitalSensor(const MonitorConfig &cfg, uint8_t idx);
static float readAnalogSensor(const MonitorConfig &cfg, uint8_t idx);
static float readCurrentLoopSensor(const MonitorConfig &cfg, uint8_t idx);
static void assessLoopClipping(const MonitorConfig &cfg, uint8_t idx, float milliamps, bool pwmMode);
static float readPulseSensor(const MonitorConfig &cfg, uint8_t idx);
static float readMonitorSensor(uint8_t idx);

// ============================================================================
// Non-blocking Pulse Sampler State Machine
// ============================================================================
// Instead of blocking the main loop with delay(1) for up to 60 seconds,
// the pulse sampler runs as a cooperative state machine. Each call to
// pollPulseSampler() does a short burst of work (up to PULSE_POLL_BURST_MS),
// then returns. When the configured sample duration has elapsed, the result
// is finalized and made available via readPulseSensorResult().
// Between sampling periods, readMonitorSensor() returns the last computed value.
// ============================================================================
#ifndef PULSE_POLL_BURST_MS
#define PULSE_POLL_BURST_MS 50  // Max ms per poll call (keeps loop responsive)
#endif

enum PulseSamplerState : uint8_t {
  PULSE_STATE_IDLE = 0,        // Not sampling, waiting for next sample request
  PULSE_STATE_SAMPLING = 1,    // Actively counting pulses/edges
  PULSE_STATE_COMPLETE = 2     // Sample complete, result ready
};

struct PulseSamplerContext {
  PulseSamplerState state;
  unsigned long sampleStartMs;
  uint32_t sampleDurationMs;
  bool useAccumulatedMode;
  bool useTimeBased;
  uint8_t pulsesPerRev;
  HallEffectSensorType hallType;
  int pin;
  // Pulse counting state
  uint32_t pulseCount;
  unsigned long lastPulseTimeMs;
  int lastPinState;
  // Time-based state
  unsigned long firstPulseTime;
  unsigned long secondPulseTime;
  bool firstPulseDetected;
  bool secondPulseDetected;
  // Result
  float resultRpm;
  bool resultReady;
};

static PulseSamplerContext gPulseSampler[MAX_MONITORS];
static bool gPulseSamplerInitialized = false;

static void initPulseSamplers() {
  if (gPulseSamplerInitialized) return;
  memset(gPulseSampler, 0, sizeof(gPulseSampler));
  gPulseSamplerInitialized = true;
}

// Detect an edge based on hall effect sensor type
static inline bool detectPulseEdge(HallEffectSensorType hallType, int lastState, int currentState) {
  switch (hallType) {
    case HALL_EFFECT_UNIPOLAR:
    case HALL_EFFECT_ANALOG:
      return (lastState == HIGH && currentState == LOW);
    case HALL_EFFECT_BIPOLAR:
    case HALL_EFFECT_OMNIPOLAR:
      return (lastState != currentState);
    default:
      return (lastState == HIGH && currentState == LOW);
  }
}

// Start a new sampling period for a pulse sensor
static void startPulseSample(uint8_t idx, const MonitorConfig &cfg) {
  PulseSamplerContext &ctx = gPulseSampler[idx];

  int pin = (cfg.pulsePin >= 0 && cfg.pulsePin < 255) ? cfg.pulsePin :
            ((cfg.primaryPin >= 0 && cfg.primaryPin < 255) ? cfg.primaryPin : (2 + idx));
  pinMode(pin, INPUT_PULLUP);

  uint8_t pulsesPerRev = (cfg.pulsesPerUnit > 0) ? cfg.pulsesPerUnit : 1;

  // Determine sampling parameters
  uint32_t sampleDurationMs;
  bool useAccumulatedMode;

  if (cfg.pulseSampleDurationMs > 0) {
    sampleDurationMs = cfg.pulseSampleDurationMs;
    useAccumulatedMode = cfg.pulseAccumulatedMode;
  } else if (cfg.expectedPulseRate > 0.0f) {
    PulseSamplingRecommendation rec = getRecommendedPulseSampling(cfg.expectedPulseRate);
    sampleDurationMs = rec.sampleDurationMs;
    useAccumulatedMode = rec.accumulatedMode;
  } else {
    sampleDurationMs = RPM_SAMPLE_DURATION_MS;
    useAccumulatedMode = cfg.pulseAccumulatedMode;
  }

  ctx.state = PULSE_STATE_SAMPLING;
  ctx.sampleStartMs = millis();
  ctx.sampleDurationMs = sampleDurationMs;
  ctx.useAccumulatedMode = useAccumulatedMode;
  ctx.useTimeBased = (!useAccumulatedMode && cfg.hallEffectDetection == HALL_DETECT_TIME_BASED);
  ctx.pulsesPerRev = pulsesPerRev;
  ctx.hallType = cfg.hallEffectType;
  ctx.pin = pin;
  ctx.pulseCount = 0;
  ctx.lastPulseTimeMs = 0;
  ctx.lastPinState = digitalRead(pin);
  ctx.firstPulseTime = 0;
  ctx.secondPulseTime = 0;
  ctx.firstPulseDetected = false;
  ctx.secondPulseDetected = false;
  ctx.resultReady = false;

  // For accumulated mode, use the global accumulated counter
  if (useAccumulatedMode && !gRpmAccumulatedInitialized[idx]) {
    atomicResetPulses(idx);
    gRpmAccumulatedStartMillis[idx] = millis();
    gRpmLastPinState[idx] = ctx.lastPinState;
    gRpmAccumulatedInitialized[idx] = true;
  }
}

// Poll the pulse sampler for a short burst. Returns true when the sample is complete.
static bool pollPulseSampler(uint8_t idx) {
  PulseSamplerContext &ctx = gPulseSampler[idx];
  if (ctx.state != PULSE_STATE_SAMPLING) return (ctx.state == PULSE_STATE_COMPLETE);

  const unsigned long DEBOUNCE_MS = 2;
  const float MS_PER_MINUTE = 60000.0f;
  unsigned long now = millis();
  unsigned long elapsed = now - ctx.sampleStartMs;

  // --- ACCUMULATED MODE ---
  if (ctx.useAccumulatedMode) {
    // Short burst to catch pulses (up to PULSE_POLL_BURST_MS)
    unsigned long burstStart = millis();
    int lastState = gRpmLastPinState[idx];
    unsigned long lastPulseTime = ctx.lastPulseTimeMs;

    while ((millis() - burstStart) < PULSE_POLL_BURST_MS) {
      int currentState = digitalRead(ctx.pin);
      if (detectPulseEdge(ctx.hallType, lastState, currentState)) {
        unsigned long pt = millis();
        if (pt - lastPulseTime >= DEBOUNCE_MS) {
          atomicIncrementPulses(idx);
          lastPulseTime = pt;
        }
      }
      lastState = currentState;
    }
    gRpmLastPinState[idx] = lastState;
    ctx.lastPulseTimeMs = lastPulseTime;

    // Accumulated mode: finalize when the telemetry sample interval has elapsed
    // (the caller drives this via sampleDurationMs, typically == sampleSeconds * 1000)
    unsigned long accumElapsed = now - gRpmAccumulatedStartMillis[idx];
    if (accumElapsed >= ctx.sampleDurationMs || (accumElapsed > 1000 && elapsed >= ctx.sampleDurationMs)) {
      uint32_t pulseCount = atomicReadAndResetPulses(idx);
      if (accumElapsed > 1000 && pulseCount > 0) {
        ctx.resultRpm = ((float)pulseCount * MS_PER_MINUTE) /
                        ((float)accumElapsed * (float)ctx.pulsesPerRev);
      } else {
        ctx.resultRpm = 0.0f;
      }
      gRpmAccumulatedStartMillis[idx] = now;
      ctx.resultReady = true;
      ctx.state = PULSE_STATE_COMPLETE;
      return true;
    }
    return false;
  }

  // Check if sample duration has elapsed (for non-accumulated modes)
  bool timeUp = (elapsed >= ctx.sampleDurationMs);

  // --- TIME-BASED MODE ---
  if (ctx.useTimeBased) {
    if (!ctx.secondPulseDetected) {
      unsigned long burstStart = millis();
      int lastState = ctx.lastPinState;

      while ((millis() - burstStart) < PULSE_POLL_BURST_MS && !ctx.secondPulseDetected) {
        int currentState = digitalRead(ctx.pin);
        if (detectPulseEdge(ctx.hallType, lastState, currentState)) {
          unsigned long pt = millis();
          if (pt - ctx.lastPulseTimeMs >= DEBOUNCE_MS) {
            ctx.lastPulseTimeMs = pt;
            if (!ctx.firstPulseDetected) {
              ctx.firstPulseTime = pt;
              ctx.firstPulseDetected = true;
            } else {
              ctx.secondPulseTime = pt;
              ctx.secondPulseDetected = true;
            }
          }
        }
        lastState = currentState;
      }
      ctx.lastPinState = lastState;
    }

    // Early exit if we got both pulses, or time is up
    if (ctx.secondPulseDetected || timeUp) {
      if (ctx.secondPulseDetected) {
        unsigned long period = ctx.secondPulseTime - ctx.firstPulseTime;
        if (period > 0) {
          ctx.resultRpm = MS_PER_MINUTE / ((float)period * (float)ctx.pulsesPerRev);
        } else {
          ctx.resultRpm = gRpmLastReading[idx];
        }
      } else {
        ctx.resultRpm = gRpmLastReading[idx]; // Keep last reading
      }
      ctx.resultReady = true;
      ctx.state = PULSE_STATE_COMPLETE;
      return true;
    }
    return false;
  }

  // --- PULSE COUNTING MODE ---
  {
    unsigned long burstStart = millis();
    int lastState = ctx.lastPinState;

    while ((millis() - burstStart) < PULSE_POLL_BURST_MS) {
      int currentState = digitalRead(ctx.pin);
      if (detectPulseEdge(ctx.hallType, lastState, currentState)) {
        unsigned long pt = millis();
        if (pt - ctx.lastPulseTimeMs >= DEBOUNCE_MS) {
          ctx.pulseCount++;
          ctx.lastPulseTimeMs = pt;
        }
      }
      lastState = currentState;
    }
    ctx.lastPinState = lastState;

    if (timeUp) {
      ctx.resultRpm = ((float)ctx.pulseCount * MS_PER_MINUTE) /
                      ((float)ctx.sampleDurationMs * (float)ctx.pulsesPerRev);
      ctx.resultReady = true;
      ctx.state = PULSE_STATE_COMPLETE;
      return true;
    }
    return false;
  }
}

// Read the pulse sensor result for a given index.
// If a sample is still in progress, returns the last known reading.
// If a sample just completed, returns the new result and resets state.
static float readPulseSensorResult(uint8_t idx) {
  PulseSamplerContext &ctx = gPulseSampler[idx];
  if (ctx.resultReady) {
    float rpm = ctx.resultRpm;
    gRpmLastReading[idx] = rpm;
    ctx.state = PULSE_STATE_IDLE;
    ctx.resultReady = false;
    return rpm;
  }
  return gRpmLastReading[idx];
}
static void evaluateAlarms(uint8_t idx);
static void sendTelemetry(uint8_t idx, const char *reason, bool syncNow);
static float getEffectiveBatteryVoltage();
static void sendRegistration(const char *reason);
static void sendAlarm(uint8_t idx, const char *alarmType, float inches);
static void publishAlarmNote(uint8_t idx, const char *alarmType, float inches);
static void notifyAlarmEdge(uint8_t idx, const char *alarmType, float inches, bool isRetry);
static void retryPendingAlarm(uint8_t idx, uint8_t pendingAtEntry, bool highInAlarm, bool lowInAlarm);
static uint8_t alarmPendingCodeFor(const char *alarmType);
static const char *alarmPendingName(uint8_t code);
static bool digitalAlarmCondition(const MonitorConfig &cfg, float value, bool &triggerOnActivated);
static bool checkAlarmRateLimit(uint8_t idx, const char *alarmType);
static void sendDailyReport();
static void publishNote(const char *fileName, JsonDocument &doc, bool syncNow);
static void bufferNoteForRetry(const char *fileName, const char *payload, bool syncNow);
static void flushBufferedNotes();
static void pruneNoteBufferIfNeeded();
static void trimTelemetryOutbox();
static void ensureTimeSync();
static void updateDailyScheduleIfNeeded();
static bool checkNotecardHealth();
static bool appendDailyMonitor(JsonDocument &doc, JsonArray &array, uint8_t monitorIndex, size_t payloadLimit);
static void pollForRelayCommands();
static void processRelayCommand(const JsonDocument &doc);
static void setRelayState(uint8_t relayNum, bool state);
static void initializeRelays();
static void triggerRemoteRelays(const char *targetClient, uint8_t relayMask, bool activate);
static int getRelayPin(uint8_t relayIndex);
static float readVinDividerVoltage();
static void checkRelayMomentaryTimeout(unsigned long now);
static bool fetchNotecardLocation(float &latitude, float &longitude);
static void resetRelayForMonitor(uint8_t idx);
static void initializeClearButton();
static void checkClearButton(unsigned long now);
static void initializeUserButton();
static void checkUserButton(unsigned long now);
static void openServiceWindow(unsigned long now);
static void checkServiceWindowExpiry(unsigned long now);
static void clearAllRelayAlarms();
static void addSerialLog(const char *message);
static void pollForSerialRequests();
static void pollForLocationRequests();
static void pollForSyncRequests();
static void pollForTelemetryRequests();
static void sendSerialLogs();
static void sendSerialAck(const char *status);
static void evaluateUnload(uint8_t idx);
static void sendUnloadEvent(uint8_t idx, float peakInches, float currentValue, double peakEpoch);
static void sendSolarAlarm(SolarAlertType alertType);
static void logSolarHardwareTestHeartbeat(unsigned long now);
static void logSolarPollSnapshot(unsigned long now, SolarAlertType alertType);
static bool appendSolarDataToDaily(JsonDocument &doc);
static void recoverI2CBus();
static void logI2CRecoveryEvent(I2CRecoveryTrigger trigger);
// Battery voltage monitoring (sourced from SunSaver MPPT or Vin divider via
// getEffectiveBatteryVoltage(); Fix 11: Notecard card.voltage is never used).
static bool pollBatteryVoltage(BatteryData &data, const BatteryConfig &cfg);
static void checkBatteryAlerts(const BatteryData &data, const BatteryConfig &cfg);
static void sendBatteryAlarm(BatteryAlertType alertType, float voltage);
static bool appendBatteryDataToDaily(JsonDocument &doc);
// Power conservation
static void updatePowerState();
static void sendPowerStateChange(PowerState oldState, PowerState newState, float voltage);
static const char* getPowerStateDescription(PowerState state);
static unsigned long getPowerStateSleepMs(PowerState state);
// Solar-only (no battery) mode
static void loadSolarStateFromFlash();
static void saveSolarStateToFlash();
// Firmware-update detection: compares persisted build seq to FIRMWARE_BUILD_SEQ at boot
static void checkFirmwareUpdateMarker();
static void performStartupDebounce();
static void checkSolarOnlySunsetProtocol(unsigned long now);
static bool isSensorVoltageGateOpen();
// Diagnostics
static uint32_t freeRam();
static void safeSleep(unsigned long ms);
#ifdef TANKALARM_HEALTH_TELEMETRY_ENABLED
static void sendHealthTelemetry();
#endif

static bool i2cAck(uint8_t address) {
  if (address < 0x08 || address > 0x77) {
    return false;
  }
  Wire.beginTransmission(address);
  return (Wire.endTransmission() == 0);
}

static uint8_t resolveCurrentLoopI2cAddress(uint8_t preferredAddress) {
  const uint8_t fallbackAddress = CURRENT_LOOP_I2C_ADDRESS;
  const uint8_t candidates[] = {
    preferredAddress,
    fallbackAddress,
    CURRENT_LOOP_I2C_ALT_ADDRESS_1,
    CURRENT_LOOP_I2C_ALT_ADDRESS_2
  };

  for (uint8_t idx = 0; idx < (uint8_t)(sizeof(candidates) / sizeof(candidates[0])); ++idx) {
    uint8_t candidate = candidates[idx];
    if (candidate < 0x08 || candidate > 0x77 || candidate == NOTECARD_I2C_ADDRESS) {
      continue;
    }

    bool duplicate = false;
    for (uint8_t prev = 0; prev < idx; ++prev) {
      if (candidates[prev] == candidate) {
        duplicate = true;
        break;
      }
    }
    if (duplicate) {
      continue;
    }

    if (i2cAck(candidate)) {
      return candidate;
    }
  }

  if (preferredAddress >= 0x08 && preferredAddress <= 0x77 && preferredAddress != NOTECARD_I2C_ADDRESS) {
    return preferredAddress;
  }
  return fallbackAddress;
}

// v2.0.47: Run the official Arduino_Opta_Blueprint controller bootstrap ONCE to discover
// the A0602's assigned I2C address (Blueprint assigns from OPTA_CONTROLLER_FIRST_AVAILABLE_ADDRESS
// = 0x0B upward). This replaces blind probing of the legacy 0x64 / 0x0A defaults that the field
// A0602 was never at -- the root cause of the "stuck ~18 mA" symptom: every Blueprint frame
// was silently NACKed at the wrong address so the read path returned stale/garbage bytes.
//
// Side effects of OptaController::begin():
//  - Calls Wire.begin() (idempotent) and Wire.setClock(400000). We restore 100 kHz before
//    returning so the next Notecard transaction sees the documented-stable bus speed.
//  - Emits OPTA_CONTROLLER_RESET to every expansion and re-runs address assignment. This is
//    expensive; MUST NOT be called outside setup(). After bootstrap we do NOT call
//    OptaController.update() in the hot loop, so the controller never races the v2.0.46
//    raw framed read path for the shared bus.
//
// Returns true if an EXPANSION_OPTA_ANALOG was discovered (LED turns GREEN on the module).
// On false the caller should fall back to legacy probing -- callable raw frames at the legacy
// addresses still work if the module was previously addressed.
static bool bootstrapA0602Managed() {
  OptaController.begin();
  OptaController.update();
  delay(20);
  OptaController.update();

  int n = OptaController.getExpansionNum();
  for (int i = 0; i < n; ++i) {
    if (OptaController.getExpansionType(i) == EXPANSION_OPTA_ANALOG) {
      gA0602DeviceIndex    = i;
      gA0602ManagedAddress = OptaController.getExpansionI2Caddress(i);
      break;
    }
  }
  gOptaControllerReady = (gA0602DeviceIndex >= 0);

  // Restore the Notecard-safe I2C clock (OptaController forced 400 kHz). Mirrors the
  // v2.0.46 per-op clock-window discipline used inside the raw read path.
  Wire.setClock(I2C_NORMAL_CLOCK_HZ);
  return gOptaControllerReady;
}

void setup() {
  Serial.begin(115200);
  while (!Serial && millis() < 2000) {
    delay(10);
  }

  Serial.println();
  Serial.print(F("Tank Alarm Client 112025 v"));
  Serial.print(F(FIRMWARE_VERSION));
  Serial.print(F(" ("));
  Serial.print(F(FIRMWARE_BUILD_DATE));
  Serial.println(F(")"));

#if defined(TANKALARM_DFU_MCUBOOT)
  Serial.println(F("  OTA: MCUboot ENABLED"));
#else
  Serial.println(F("  OTA: MCUboot DISABLED (no -DTANKALARM_DFU_MCUBOOT)"));
#endif

#if defined(TANKALARM_DFU_MCUBOOT)
  // Confirm this image unconditionally as early as possible so MCUboot does not
  // roll back even when QSPI storage or Notecard are unavailable (e.g. right
  // after a USB flash that erased the QSPI MBR). The loop() gate below provides
  // a belt-and-suspenders second confirmation once peripherals are fully up.
  MCUboot::confirmSketch();
  Serial.println(F("MCUboot: sketch confirmed (early, unconditional)"));
#endif

  // Initialize serial log buffer
  memset(&gSerialLog, 0, sizeof(ClientSerialLog));

  // Set analog resolution to 12-bit to match the /4095.0f divisor used in readMonitorSensor
  analogReadResolution(12);

  initializeStorage();
  ensureConfigLoaded();
  printConfigSummary();

#if defined(SOLAR_HW_TEST_SERIAL) && defined(SOLAR_HW_TEST_FORCE_SOLAR_CONFIG)
  // Test override so RS-485 bring-up can be exercised without editing flash JSON.
  gConfig.solarCharger.enabled = true;
  gConfig.solarCharger.modbusSlaveId = 1;
  gConfig.solarCharger.modbusBaudRate = 9600;
  gConfig.solarCharger.modbusTimeoutMs = 500;
  gConfig.solarCharger.pollIntervalSec = 10;
  gConfig.solarCharger.alertOnCommFailure = true;
  Serial.println(F("Solar HW test: forced solarCharger config enabled"));
#endif

  printHardwareRequirements(gConfig);

  Wire.begin();
  Wire.setTimeout(I2C_WIRE_TIMEOUT_MS);  // Guard against indefinite blocking on bus hang

  // v2.0.47: A0602 managed bootstrap -- one-shot Blueprint controller handshake to discover
  // the real assigned I2C address (0x0B+) and turn the A0602 status LED GREEN. Restores the
  // 100 kHz Notecard-safe clock before returning. Must run after Wire.begin() and BEFORE the
  // bus scan + Notecard init below so the rest of setup() addresses the A0602 correctly.
  bool a0602Managed = bootstrapA0602Managed();
  if (a0602Managed) {
    Serial.print(F("A0602: managed at 0x"));
    if (gA0602ManagedAddress < 0x10) Serial.print('0');
    Serial.print(gA0602ManagedAddress, HEX);
    Serial.print(F(" (device index "));
    Serial.print(gA0602DeviceIndex);
    Serial.println(F(")"));
    // Steer the v2.0.46 raw framed read path at the actually-assigned address rather than
    // the legacy 0x64 / 0x0A defaults the field A0602 was never at.
    gConfig.currentLoopI2cAddress = gA0602ManagedAddress;
  } else {
    Serial.println(F("A0602: managed bootstrap FAILED -- falling back to legacy address probe"));
  }

  uint8_t configuredCurrentLoopAddr = gConfig.currentLoopI2cAddress;
  if (configuredCurrentLoopAddr < 0x08 || configuredCurrentLoopAddr > 0x77 || configuredCurrentLoopAddr == NOTECARD_I2C_ADDRESS) {
    configuredCurrentLoopAddr = CURRENT_LOOP_I2C_ADDRESS;
  }
  uint8_t resolvedCurrentLoopAddr = resolveCurrentLoopI2cAddress(configuredCurrentLoopAddr);
  if (resolvedCurrentLoopAddr != configuredCurrentLoopAddr) {
    Serial.print(F("I2C: current loop address override 0x"));
    if (configuredCurrentLoopAddr < 0x10) Serial.print('0');
    Serial.print(configuredCurrentLoopAddr, HEX);
    Serial.print(F(" -> 0x"));
    if (resolvedCurrentLoopAddr < 0x10) Serial.print('0');
    Serial.println(resolvedCurrentLoopAddr, HEX);
  }
  gConfig.currentLoopI2cAddress = resolvedCurrentLoopAddr;

  // ---- I2C bus scan: verify expected devices are present ----
  {
    const uint8_t expectedAddrs[] = { NOTECARD_I2C_ADDRESS, resolvedCurrentLoopAddr };
    const char *expectedNames[] = { "Notecard", "A0602 Current Loop" };
    I2CScanResult scanResult = tankalarm_scanI2CBus(expectedAddrs, expectedNames, 2);

    // Persist results for first health telemetry report (3.2.5)
    gStartupScanRetries = scanResult.retryCount;
    gStartupUnexpectedDevices = scanResult.unexpectedCount;

    // Determine per-device status via quick probes
    Wire.beginTransmission(NOTECARD_I2C_ADDRESS);
    gStartupNotecardFound = (Wire.endTransmission() == 0);
    Wire.beginTransmission(resolvedCurrentLoopAddr);
    gStartupCurrentLoopFound = (Wire.endTransmission() == 0);
  }

  initializeNotecard();
#if defined(TANKALARM_DFU_MCUBOOT)
  tankalarm_otaSelfCheck();   // print OTA partition readiness for diagnostics
  tankalarm_resolvePendingOta(notecard);
#endif
  ensureTimeSync();
  scheduleNextDailyReport();

#ifdef TANKALARM_WATCHDOG_AVAILABLE
  // Initialize watchdog timer
  #if defined(ARDUINO_OPTA) || defined(ARDUINO_ARCH_MBED)
    // Mbed OS Watchdog
    uint32_t timeoutMs = WATCHDOG_TIMEOUT_SECONDS * 1000;
    if (mbedWatchdog.start(timeoutMs)) {
      Serial.print(F("Mbed Watchdog enabled: "));
      Serial.print(WATCHDOG_TIMEOUT_SECONDS);
      Serial.println(F(" seconds"));
    } else {
      Serial.println(F("Warning: Watchdog initialization failed"));
    }
  #else
    // STM32duino Watchdog
    IWatchdog.begin(WATCHDOG_TIMEOUT_SECONDS * 1000000UL);
    Serial.print(F("Watchdog timer enabled: "));
    Serial.print(WATCHDOG_TIMEOUT_SECONDS);
    Serial.println(F(" seconds"));
  #endif
#else
  Serial.println(F("Warning: Watchdog timer not available on this platform"));
#endif

  // Initialize RPM sensor state arrays dynamically
  for (uint8_t i = 0; i < MAX_MONITORS; ++i) {
    // Read actual pin state if RPM pin is configured, to avoid phantom edge detection
    int rpmPin = (i < gConfig.monitorCount) ? gConfig.monitors[i].pulsePin : -1;
    if (rpmPin >= 0) {
      pinMode(rpmPin, INPUT_PULLUP);
      gRpmLastPinState[i] = digitalRead(rpmPin);
    } else {
      gRpmLastPinState[i] = HIGH;
    }
    gRpmLastSampleMillis[i] = 0;
    gRpmLastReading[i] = 0.0f;
    gRpmLastPulseTime[i] = 0;
    gRpmPulsePeriodMs[i] = 0;
  }

  // Explicitly initialize relay runtime state
  for (uint8_t i = 0; i < MAX_RELAYS; ++i) {
    gRelayRuntime[i] = {};
  }

  for (uint8_t i = 0; i < gConfig.monitorCount; ++i) {
    gMonitorState[i].currentValue = 0.0f;
    gMonitorState[i].currentSensorMa = 0.0f;
    gMonitorState[i].currentSensorVoltage = 0.0f;
    gMonitorState[i].lastReadingEpoch = 0.0;
    gMonitorState[i].sampleReused = false;
    gMonitorState[i].lastReportedValue = -9999.0f;
    gMonitorState[i].lastDailySentValue = -9999.0f;
    gMonitorState[i].highAlarmLatched = false;
    gMonitorState[i].lowAlarmLatched = false;
    gMonitorState[i].pendingAlarm = ALARM_PENDING_NONE;
    gMonitorState[i].lastSampleMillis = 0;
    gMonitorState[i].lastAlarmSendMillis = 0;
    gMonitorState[i].highAlarmDebounceCount = 0;
    gMonitorState[i].lowAlarmDebounceCount = 0;
    gMonitorState[i].highClearDebounceCount = 0;
    gMonitorState[i].lowClearDebounceCount = 0;
    gMonitorState[i].lastValidReading = 0.0f;
    gMonitorState[i].hasLastValidReading = false;
    gMonitorState[i].consecutiveFailures = 0;
    gMonitorState[i].stuckReadingCount = 0;
    gMonitorState[i].sensorFailed = false;
    gMonitorState[i].recoveryCount = 0;
    gMonitorState[i].alarmCount = 0;
    // BugFix v1.6.2 (M-13): Initialize last-alarm timestamps so the first alarm
    // after boot is NOT suppressed by the per-type minimum-interval check.
    // C-T01: stamp each one interval + 1 ms in the past. The subtraction wraps when millis()
    // is small and checkAlarmRateLimit tests (now - last) < interval modulo 2^32, so the first
    // alarm of each type passes at any uptime. The previous clamp to 0 suppressed high/low/
    // fault notes for the first 300 s of uptime (F-05/M-12a).
    {
      const unsigned long expired = millis() - (MIN_ALARM_INTERVAL_SECONDS * 1000UL + 1UL);
      gMonitorState[i].lastHighAlarmMillis = expired;
      gMonitorState[i].lastLowAlarmMillis = expired;
      gMonitorState[i].lastClearAlarmMillis = expired;
      gMonitorState[i].lastSensorFaultMillis = expired;
    }
    // Initialize unload tracking state
    gMonitorState[i].unloadPeakInches = 0.0f;
    gMonitorState[i].unloadPeakSensorMa = 0.0f;
    gMonitorState[i].unloadPeakEpoch = 0.0;
    gMonitorState[i].unloadTracking = false;
    for (uint8_t j = 0; j < MAX_ALARMS_PER_HOUR; ++j) {
      gMonitorState[i].alarmTimestamps[j] = 0;
    }
  }

  initializeRelays();
  initializeClearButton();
  initializeUserButton();
  
  // Initialize solar/battery charger monitoring (SunSaver MPPT via RS-485)
  if (gConfig.solarCharger.enabled) {
    if (gSolarManager.begin(gConfig.solarCharger)) {
      if (gSolarManager.isCommunicationOk()) {
        Serial.println(F("Solar charger monitoring enabled"));
        addSerialLog("Solar charger monitoring initialized");
      } else {
        Serial.println(F("Solar charger transport initialized, initial Modbus read failed"));
        addSerialLog("Solar charger initial Modbus read failed");
      }
    } else {
      Serial.println(F("Warning: Solar charger initialization failed"));
      addSerialLog("Solar charger init failed");
    }
  }

  // Initialize battery voltage monitoring
  // Fix 11: source is auto-picked by getEffectiveBatteryVoltage() (SunSaver MPPT preferred,
  // analog Vin divider as fallback, or nothing). No Notecard I/O and no platform compile
  // guard required — the previous Fix 10 Opta gate is no longer needed here because
  // pollBatteryVoltage() never touches the Notecard.
  if (gConfig.batteryMonitor.enabled) {
    Serial.println(F("Battery voltage monitoring enabled (source: MPPT/Vin auto-select)"));
    addSerialLog("Battery voltage monitoring initialized");
    // Initialize battery data structure
    memset(&gBatteryData, 0, sizeof(BatteryData));
    // Do initial poll
    pollBatteryVoltage(gBatteryData, gConfig.batteryMonitor);
  }

  // Initialize analog Vin voltage divider monitoring
  if (gConfig.vinMonitor.enabled) {
    float ratio = vinDividerRatio(&gConfig.vinMonitor);
    float maxV = vinMaxReadableVoltage(&gConfig.vinMonitor);
    Serial.print(F("Vin monitor enabled: pin=A"));
    Serial.print(gConfig.vinMonitor.analogPin);
    Serial.print(F(" R1="));
    Serial.print(gConfig.vinMonitor.r1Kohm, 1);
    Serial.print(F("k R2="));
    Serial.print(gConfig.vinMonitor.r2Kohm, 1);
    Serial.print(F("k ratio="));
    Serial.print(ratio, 4);
    Serial.print(F(" maxV="));
    Serial.println(maxV, 1);
    addSerialLog("Vin voltage divider monitoring initialized");
    // Do initial read
    gVinVoltage = readVinDividerVoltage();
  }

  // Solar-Only (No Battery) mode initialization
  if (isSolarOnlyActive()) {
    loadSolarStateFromFlash();
    gSolarOnlyBootCount++;
    Serial.print(F("Solar-only mode: boot #"));
    Serial.println(gSolarOnlyBootCount);
    if (gSolarOnlyLastReportEpoch > 0.0) {
      Serial.print(F("  Last report epoch: "));
      Serial.println((unsigned long)gSolarOnlyLastReportEpoch);
    }
    addSerialLog("Solar-only mode active");
    // Perform startup debounce (blocks until power is stable)
    performStartupDebounce();
    // Save updated boot count
    saveSolarStateToFlash();
  } else {
    // Non-solar-only: startup is always complete
    gSolarOnlyStartupComplete = true;
    gSolarOnlySensorsReady = true;
  }

  // Detect a just-installed firmware (version changed since the last boot, via OTA or USB).
  // When true, we force an immediate sync after the boot note below so transmission can be
  // confirmed right away instead of waiting for the next periodic/daily sync window.
  checkFirmwareUpdateMarker();

  // Immediate boot telemetry so the server sees this device right away
  // instead of waiting for the first sample interval (default 30 min).
  // Solar-only clients with monitors configured skip this to avoid
  // wasting power on brownout reboots — they rely on the loop interval.
  // However, unconfigured solar-only clients (monitorCount == 0) DO send
  // a registration note at boot because there is no other way for the
  // server to discover them and push an initial configuration.
#ifdef TANKALARM_WATCHDOG_AVAILABLE
  // Reset watchdog before boot telemetry — the Notecard I2C transaction
  // inside publishNote() can block for up to 30 s, which combined with
  // post-watchdog-enable init could exceed the watchdog window.
  #if defined(ARDUINO_OPTA) || defined(ARDUINO_ARCH_MBED)
    mbedWatchdog.kick();
  #else
    IWatchdog.reload();
  #endif
#endif
  if (gConfig.monitorCount > 0) {
    if (!isSolarOnlyActive()) {
      Serial.println(F("Sending boot telemetry..."));
      addSerialLog("Boot telemetry");
      sampleMonitors();
    }
    // Solar clients with monitors rely on loop sample interval
  } else {
    // No monitors configured — send a lightweight registration note
    // so the server discovers this device and can push a config to it.
    // This is safe for solar-only clients: the registration payload is
    // tiny, startup debounce has already confirmed stable power, and
    // the device will never be discoverable otherwise.
    Serial.println(F("No monitors configured — sending registration..."));
    addSerialLog("Boot registration (no monitors)");
    sendRegistration("boot");
  }

  // Firmware-update confirmation: if a new firmware version just booted, force an immediate
  // sync so the boot note above (telemetry for configured clients, registration otherwise)
  // transmits right now. This lets an operator verify two-way communication immediately after
  // an update rather than waiting up to the periodic outbound window (6 h on solar clients).
  if (gFirmwareJustUpdated) {
    Serial.println(F("Firmware updated — forcing immediate sync to confirm transmission"));
    addSerialLog("Firmware updated - immediate transmission test");
#ifdef TANKALARM_WATCHDOG_AVAILABLE
  #if defined(ARDUINO_OPTA) || defined(ARDUINO_ARCH_MBED)
    mbedWatchdog.kick();
  #else
    IWatchdog.reload();
  #endif
#endif
    J *fwSyncReq = notecard.newRequest("hub.sync");
    if (fwSyncReq) {
      J *fwSyncRsp = notecard.requestAndResponse(fwSyncReq);
      if (fwSyncRsp) {
        const char *fwSyncErr = JGetString(fwSyncRsp, "err");
        if (fwSyncErr && fwSyncErr[0] != '\0') {
          Serial.print(F("Firmware-update sync warning: "));
          Serial.println(fwSyncErr);
        } else {
          Serial.println(F("Firmware-update confirmation sync initiated"));
        }
        notecard.deleteResponse(fwSyncRsp);
      }
    }
  }

  // Report any pending OTA outcome (applied/reverted) to the server so the dashboard reflects
  // update success/failure instead of it only living in Notehub's dfu.status.
  reportOtaOutcome();

  Serial.println(F("Client setup complete"));
  tankalarm_printHeapStats();
  addSerialLog("Client started successfully");
}

void loop() {
#if defined(TANKALARM_DFU_MCUBOOT)
  // Belt-and-suspenders secondary confirmation once peripherals are up.
  // The unconditional early confirmSketch() in setup() is the primary gate;
  // this catches the case where loop() is reached with Notecard available.
  tankalarm_markFirmwareHealthy();
#endif

  unsigned long now = millis();

  logSolarHardwareTestHeartbeat(now);

#ifdef TANKALARM_WATCHDOG_AVAILABLE
  // Reset watchdog timer to prevent system reset
  #if defined(ARDUINO_OPTA) || defined(ARDUINO_ARCH_MBED)
    mbedWatchdog.kick();
  #else
    IWatchdog.reload();
  #endif
#endif

  // Check notecard health periodically (with exponential backoff)
  // Use remote-tunable base interval if configured, otherwise compile-time default
  static unsigned long lastHealthCheck = 0;
  const unsigned long healthBaseInterval = (gConfig.healthCheckBaseIntervalMs > 0) 
    ? gConfig.healthCheckBaseIntervalMs 
    : NOTECARD_HEALTH_CHECK_BASE_INTERVAL_MS;
  static unsigned long healthCheckInterval = NOTECARD_HEALTH_CHECK_BASE_INTERVAL_MS;
  if (now - lastHealthCheck > healthCheckInterval) {
    lastHealthCheck = now;
    if (!gNotecardAvailable) {
      bool recovered = checkNotecardHealth();
      if (recovered) {
        // Notecard recovered — reset backoff to base interval
        healthCheckInterval = healthBaseInterval;
        Serial.println(F("Notecard health check interval reset to base"));
      } else {
        // Still failing — exponential backoff up to max
        if (healthCheckInterval < NOTECARD_HEALTH_CHECK_MAX_INTERVAL_MS) {
          healthCheckInterval *= 2;
          if (healthCheckInterval > NOTECARD_HEALTH_CHECK_MAX_INTERVAL_MS) {
            healthCheckInterval = NOTECARD_HEALTH_CHECK_MAX_INTERVAL_MS;
          }
        }
        // Enforce higher floor in low-power states to conserve battery
        if (gPowerState >= POWER_STATE_LOW_POWER && healthCheckInterval < 1200000UL) {
          healthCheckInterval = 1200000UL;  // 20 min floor in LOW_POWER+
        } else if (gPowerState >= POWER_STATE_ECO && healthCheckInterval < 600000UL) {
          healthCheckInterval = 600000UL;   // 10 min floor in ECO
        }
        Serial.print(F("Notecard health check backoff: next in "));
        Serial.print(healthCheckInterval / 60000UL);
        Serial.println(F(" min"));
      }
    }
  }

  // ---- Prolonged I2C failure detection ----
  // If both Notecard AND all current-loop sensors are failing for an extended
  // period, the system is in a "zombie" state (alive but blind).  Force a
  // hardware reset via the watchdog rather than running indefinitely broken.
  {
    static uint32_t consecutiveTotalI2cFailLoops = 0;
    bool notecardDown = !gNotecardAvailable;
    bool anyCurrentLoopFailed = false;
    for (uint8_t i = 0; i < gConfig.monitorCount; i++) {
      if (gConfig.monitors[i].sensorInterface == SENSOR_CURRENT_LOOP &&
          gMonitorState[i].consecutiveFailures >= SENSOR_FAILURE_THRESHOLD) {
        anyCurrentLoopFailed = true;
        break;
      }
    }
    if (notecardDown && anyCurrentLoopFailed) {
      consecutiveTotalI2cFailLoops++;
      if (consecutiveTotalI2cFailLoops == I2C_DUAL_FAIL_RECOVERY_LOOPS) {
        // First escalation: attempt I2C bus recovery
        Serial.println(F("I2C: sustained dual failure — attempting bus recovery"));
        recoverI2CBus();
        logI2CRecoveryEvent(I2C_RECOVERY_DUAL_FAILURE);
        tankalarm_ensureNotecardBinding(notecard);
        // Fix C1 (v2.0.50): the A0602's Blueprint-assigned address lives in its own MCU's
        // RAM and normally survives a tankalarm_recoverI2CBus() SCL-toggle cycle. BUT if
        // the module was externally power-cycled (brownout, loop-power loss, hardware reset)
        // it lost its 0x0B assignment and is now listening at the OPTA_DEFAULT_SLAVE_I2C_ADDRESS
        // (0x0A == CURRENT_LOOP_I2C_ALT_ADDRESS_1). A lightweight re-probe finds it and
        // steers gConfig.currentLoopI2cAddress at runtime (not persisted). We deliberately do
        // NOT call bootstrapA0602Managed() here — see the comment block at its definition for
        // why (OPTA_CONTROLLER_RESET is broadcast + expensive). See review document
        // CODE_REVIEW_06252026_CURRENT_LOOP_SENSORS.md §10 for full rationale.
        if (!gDfuInProgress) {
          delay(50);  // brief peripheral settle after Wire.end()/begin() (§7.1)
          uint8_t prev = gConfig.currentLoopI2cAddress;
          uint8_t resolved = resolveCurrentLoopI2cAddress(prev);
          if (resolved != prev) {
            gConfig.currentLoopI2cAddress = resolved;  // runtime steering only
            Serial.print(F("A0602: post-recovery re-probe address change 0x"));
            if (prev < 0x10) Serial.print('0');
            Serial.print(prev, HEX);
            Serial.print(F(" -> 0x"));
            if (resolved < 0x10) Serial.print('0');
            Serial.println(resolved, HEX);
          }
          if (resolved == 0x0A) {
            // §9.3: distinguish "address found" from "sensor working." A re-probe to 0x0A
            // means the A0602 is at its UNMANAGED default; raw framed reads MAY or MAY NOT
            // be serviced by an unmanaged module. Operator should treat this as a hint that
            // a maintenance-window re-management may be needed.
            Serial.println(F("WARNING: A0602 at unmanaged default 0x0A after recovery; "
                             "framed reads may still fail until module is re-managed"));
          }
        }
      } else if (consecutiveTotalI2cFailLoops >= I2C_DUAL_FAIL_RESET_LOOPS) {
        // Prolonged dual failure — force watchdog reset
        Serial.println(F("FATAL: Prolonged I2C failure on all buses. Forcing reset."));
        // Stop kicking the watchdog — triggers hardware reset within 30s
        while (true) { delay(100); }
      }
    } else {
      consecutiveTotalI2cFailLoops = 0;
    }
  }

  // ---- Current-loop-only I2C failure detection ----
  // If all current-loop sensors are failing but Notecard is fine, the A0602
  // expansion may have locked up.  Attempt bus recovery independently.
  // Uses exponential backoff to avoid excessive recovery cycles on
  // persistent hardware faults (threshold doubles each time, capped at
  // I2C_SENSOR_RECOVERY_MAX_BACKOFF × base threshold).
  {
    static uint16_t consecutiveSensorOnlyFailLoops = 0;
    static uint8_t sensorRecoveryBackoff = 1;
    static uint8_t sensorRecoveryTotalAttempts = 0;
    static uint32_t readsOkAtLastRecovery = 0;  // v2.1.4: watermark for real recovery detection
    if (gNotecardAvailable) {  // Notecard is OK — isolate to sensor bus
      bool allCurrentLoopFailed = false;
      uint8_t currentLoopCount = 0;
      uint8_t failedCount = 0;
      for (uint8_t i = 0; i < gConfig.monitorCount; i++) {
        if (gConfig.monitors[i].sensorInterface == SENSOR_CURRENT_LOOP) {
          currentLoopCount++;
          if (gMonitorState[i].consecutiveFailures >= SENSOR_FAILURE_THRESHOLD) {
            failedCount++;
          }
        }
      }
      allCurrentLoopFailed = (currentLoopCount > 0 && failedCount == currentLoopCount);
      // v2.1.4: only escalate to bus recovery when the fault signature actually implicates
      // the bus/expansion (NACKs, framing/CRC failures). UNDER_RANGE and OVER_RANGE mean the
      // framed read passed CRC + channel-echo validation — the I2C path is healthy and the
      // loop itself is open/unpowered/out-of-range. SCL toggling cannot fix a de-energized
      // loop, and every attempt publishes a diag.qo (7-event burst observed 2026-07-02 with
      // i2c_errs:0 + cl_fault:6 while the stored config drove PWM on an unused terminal).
      // The sensor-fault alarm + telemetry fault:"under_range"/ma_raw already give the
      // operator full visibility of an open loop.
      if (allCurrentLoopFailed &&
          (gLastClFaultReason == CL_FAULT_UNDER_RANGE ||
           gLastClFaultReason == CL_FAULT_OVER_RANGE)) {
        allCurrentLoopFailed = false;  // loop fault, not a bus fault — skip recovery
      }
      if (allCurrentLoopFailed) {
        consecutiveSensorOnlyFailLoops++;
        uint16_t effectiveThreshold = (uint16_t)I2C_SENSOR_ONLY_RECOVERY_THRESHOLD * sensorRecoveryBackoff;
        if (consecutiveSensorOnlyFailLoops >= effectiveThreshold) {
          if (sensorRecoveryTotalAttempts >= I2C_SENSOR_RECOVERY_MAX_ATTEMPTS) {
            // Circuit breaker: stop retrying after max total attempts
            if (sensorRecoveryTotalAttempts == I2C_SENSOR_RECOVERY_MAX_ATTEMPTS) {
              Serial.println(F("I2C: sensor recovery attempts exhausted — permanent fault"));
              sensorRecoveryTotalAttempts++;  // prevent repeat log
            }
          } else {
            Serial.print(F("I2C: all current-loop sensors failing — bus recovery (backoff x"));
            Serial.print(sensorRecoveryBackoff);
            Serial.println(F(")"));
            recoverI2CBus();
            // v2.0.46: recoverI2CBus() does Wire.end()/begin(); re-bind the Notecard so its
            // I2C session survives the bus cycle (mirrors the dual-failure recovery path).
            tankalarm_ensureNotecardBinding(notecard);
            // Fix C1 (v2.0.50): same as the dual-failure site — lightweight re-probe to catch
            // an externally power-cycled A0602 that dropped to its 0x0A unmanaged default.
            // See CODE_REVIEW_06252026_CURRENT_LOOP_SENSORS.md §10 for rationale.
            if (!gDfuInProgress) {
              delay(50);  // brief peripheral settle (§7.1)
              uint8_t prev = gConfig.currentLoopI2cAddress;
              uint8_t resolved = resolveCurrentLoopI2cAddress(prev);
              if (resolved != prev) {
                gConfig.currentLoopI2cAddress = resolved;  // runtime steering only
                Serial.print(F("A0602: post-recovery re-probe address change 0x"));
                if (prev < 0x10) Serial.print('0');
                Serial.print(prev, HEX);
                Serial.print(F(" -> 0x"));
                if (resolved < 0x10) Serial.print('0');
                Serial.println(resolved, HEX);
              }
              if (resolved == 0x0A) {
                Serial.println(F("WARNING: A0602 at unmanaged default 0x0A after recovery; "
                                 "framed reads may still fail until module is re-managed"));
              }
            }
            logI2CRecoveryEvent(I2C_RECOVERY_SENSOR_ONLY);
            sensorRecoveryTotalAttempts++;
            readsOkAtLastRecovery = gCurrentLoopReadsOk;  // v2.1.4: arm the recovery watermark
            // Reset sensor failure counters to give them a fresh chance
            for (uint8_t i = 0; i < gConfig.monitorCount; i++) {
              if (gConfig.monitors[i].sensorInterface == SENSOR_CURRENT_LOOP) {
                gMonitorState[i].consecutiveFailures = 0;
                gMonitorState[i].sensorFailed = false;
              }
            }
            // Exponential backoff: double threshold each time, capped
            if (sensorRecoveryBackoff < I2C_SENSOR_RECOVERY_MAX_BACKOFF) {
              sensorRecoveryBackoff *= 2;
            }
          }
          consecutiveSensorOnlyFailLoops = 0;
        }
      } else {
        consecutiveSensorOnlyFailLoops = 0;
        // v2.1.4: only treat the sensors as "recovered" when a framed read has actually
        // succeeded since the last recovery attempt. The old unconditional reset
        // self-defeated both the exponential backoff and the circuit breaker: each
        // recovery zeroes consecutiveFailures (above), which makes allCurrentLoopFailed
        // false on the very next pass and landed here — resetting backoff to x1 before
        // it could grow (observed as "backoff x1" on every attempt, 2026-07-02 bench).
        if (gCurrentLoopReadsOk != readsOkAtLastRecovery) {
          sensorRecoveryBackoff = 1;        // Reset backoff — a real read succeeded
          sensorRecoveryTotalAttempts = 0;  // Reset circuit breaker on true recovery
        }
      }
    } else {
      consecutiveSensorOnlyFailLoops = 0;  // dual-fail path handles this
    }
  }

  // ---- Power-state-aware sample interval ----
  // In ECO/LOW_POWER states, sample less frequently to conserve energy
  unsigned long sampleInterval = (unsigned long)gConfig.sampleSeconds * 1000UL;
  if (gPowerState == POWER_STATE_ECO) {
    sampleInterval *= POWER_ECO_SAMPLE_MULTIPLIER;
  } else if (gPowerState == POWER_STATE_LOW_POWER) {
    sampleInterval *= POWER_LOW_SAMPLE_MULTIPLIER;
  }
  // In CRITICAL_HIBERNATE, skip sampling entirely
  if (gPowerState != POWER_STATE_CRITICAL_HIBERNATE) {
    if (now - gLastTelemetryMillis >= sampleInterval) {
      gLastTelemetryMillis = now;
      if (gConfig.monitorCount > 0) {
        sampleMonitors();
      } else if (now - gLastHeartbeatMillis >= HEALTH_TELEMETRY_INTERVAL_MS) {
        // No monitors configured — send infrequent heartbeat (every 6h)
        // so the server knows this device is still online and awaiting configuration.
        gLastHeartbeatMillis = now;
        sendRegistration("heartbeat");
      }
    }
  }

  // ---- Power-state-aware polling intervals ----
  // Determine base polling interval based on power source.
  // When unconfigured (monitorCount == 0) use an aggressive interval regardless
  // of power source — the device is idle and needs config as fast as possible.
  unsigned long baseInboundInterval;
  if (gConfig.monitorCount == 0) {
    baseInboundInterval = AWAITING_CONFIG_INBOUND_INTERVAL_MS;  // 1 min — awaiting first config
  } else if (gConfig.solarPowered) {
    baseInboundInterval = (unsigned long)SOLAR_INBOUND_INTERVAL_MINUTES * 60000UL;
  } else {
    baseInboundInterval = 600000UL; // 10 minutes for grid power
  }

  // Apply power-state multiplier (skipped when awaiting config)
  unsigned long inboundInterval = baseInboundInterval;
  if (gConfig.monitorCount > 0) {
    if (gPowerState == POWER_STATE_ECO) {
      inboundInterval *= POWER_ECO_INBOUND_MULTIPLIER;
    } else if (gPowerState == POWER_STATE_LOW_POWER) {
      inboundInterval *= POWER_LOW_INBOUND_MULTIPLIER;
    }
  }
  // In CRITICAL_HIBERNATE, skip all inbound polling

  if (gPowerState != POWER_STATE_CRITICAL_HIBERNATE) {
    if (now - gLastConfigCheckMillis >= inboundInterval) {
      gLastConfigCheckMillis = now;
      pollForConfigUpdates();
    }

    if (now - gLastRelayCheckMillis >= inboundInterval) {
      gLastRelayCheckMillis = now;
      pollForRelayCommands();
    }

    if (now - gLastSerialRequestCheckMillis >= inboundInterval) {
      gLastSerialRequestCheckMillis = now;
      pollForSerialRequests();
    }

    if (now - gLastLocationRequestCheckMillis >= inboundInterval) {
      gLastLocationRequestCheckMillis = now;
      pollForLocationRequests();
    }

    // Check for server-requested sync (helps push pending inbound notes
    // through weak cellular links — see Phase 3 sync-on-demand)
    if (now - gLastConfigCheckMillis < 2000UL) {
      // Poll sync_request.qi right after config check (same cadence, minimal overhead)
      pollForSyncRequests();
    }

    // Check for server-requested fresh telemetry (dashboard "Update" button).
    // Piggybacks on the same inbound cadence so we only open one Notecard
    // session per cycle. When triggered, takes a fresh sensor reading,
    // force-publishes each enabled monitor, then forces hub.sync so the new
    // reading reaches Notehub immediately instead of waiting for the next
    // outbound window (up to 6 hours on solar/periodic clients).
    if (now - gLastTelemetryRequestCheckMillis >= inboundInterval) {
      gLastTelemetryRequestCheckMillis = now;
      pollForTelemetryRequests();
    }
  }

  // Check for momentary relay timeout (30 minutes) — skip in CRITICAL (relays are off)
  if (gPowerState != POWER_STATE_CRITICAL_HIBERNATE) {
    checkRelayMomentaryTimeout(now);
  }
  
  // Check for physical clear button press
  checkClearButton(now);

  // Check for front-panel USER button press (triggers immediate hub.sync)
  checkUserButton(now);

  // Restore periodic mode when the temporary service window expires
  checkServiceWindowExpiry(now);
  
  // Poll solar charger for battery health data (SunSaver MPPT via RS-485)
  // In CRITICAL_HIBERNATE we still poll the solar charger (if enabled) to detect
  // battery recovery, but at reduced frequency (controlled by sleep duration).
  if (gSolarManager.isEnabled()) {
    if (gSolarManager.poll(now)) {
      // Chemistry verification: once setpoints are read, cross-check them
      // against the user-selected battery type / pack voltage. This is a
      // one-shot log so it doesn't spam the serial console.
      if (!gChemistryChecked && gSolarManager.getData().setpointsValid) {
        gChemistryChecked = true;
        char chemMsg[160];
        SolarManager::ChemistryCheck cc = gSolarManager.verifyChemistry(
          (uint8_t)gConfig.batteryMonitor.batteryType,
          gConfig.batteryMonitor.nominalVoltage,
          chemMsg, sizeof(chemMsg));
        Serial.print(F("Solar: chemistry check: "));
        switch (cc) {
          case SolarManager::CHEMISTRY_CHECK_OK:               Serial.print(F("OK — "));        break;
          case SolarManager::CHEMISTRY_CHECK_MISMATCH:         Serial.print(F("MISMATCH — ")); break;
          case SolarManager::CHEMISTRY_CHECK_VOLTAGE_MISMATCH: Serial.print(F("V_PACK MISMATCH — ")); break;
          case SolarManager::CHEMISTRY_CHECK_PENDING:          Serial.print(F("pending — ")); break;
        }
        Serial.println(chemMsg);
      }

      // A poll was attempted - check alerts using the refreshed communication state
      // (suppress alarm sending in CRITICAL to save power).
      SolarAlertType alert = gSolarManager.checkAlerts();
      if (alert != SOLAR_ALERT_NONE && gPowerState != POWER_STATE_CRITICAL_HIBERNATE) {
        // SMS-1 fix: no gNotecardAvailable gate — sendSolarAlarm buffers via publishNote.
        // Only send alert if different from last, or enough time has passed
        if (alert != gLastSolarAlert || 
            (now - gLastSolarAlarmMillis >= SOLAR_ALARM_MIN_INTERVAL_MS)) {
          sendSolarAlarm(alert);
          gLastSolarAlert = alert;
          gLastSolarAlarmMillis = now;
        }
      } else if (alert == SOLAR_ALERT_NONE) {
        gLastSolarAlert = SOLAR_ALERT_NONE;  // Clear last alert state
      }

      // Optional serial output for hardware bring-up.
      logSolarPollSnapshot(now, alert);
    }
  }
  
  // Poll battery voltage (sourced from MPPT/Vin divider — never the Notecard)
  // Always poll even in CRITICAL — needed to detect battery recovery.
  // Fix 11: pollBatteryVoltage no longer issues Notecard I/O, so the previous Fix 10 Opta
  // compile guard and the `gNotecardAvailable` gate are no longer required for the poll
  // itself. sendBatteryAlarm() publishes via publishNote(), which buffers to flash when the
  // Notecard is unavailable (SMS-1 fix).
  if (gConfig.batteryMonitor.enabled) {
    unsigned long batteryPollInterval = (unsigned long)gConfig.batteryMonitor.pollIntervalSec * 1000UL;
    // In reduced power states, poll less often (but still poll for recovery detection)
    if (gPowerState >= POWER_STATE_LOW_POWER) {
      batteryPollInterval *= 2;  // 2x slower when conserving
    }
    if (now - gLastBatteryPollMillis >= batteryPollInterval) {
      gLastBatteryPollMillis = now;
      if (pollBatteryVoltage(gBatteryData, gConfig.batteryMonitor)) {
        // Suppress normal battery alert processing in CRITICAL to avoid redundant alarms
        if (gPowerState != POWER_STATE_CRITICAL_HIBERNATE) {
          checkBatteryAlerts(gBatteryData, gConfig.batteryMonitor);
        }
      }
    }
  }
  
  // Poll analog Vin voltage divider (when hardware is connected)
  // Always poll even in CRITICAL — needed to detect battery recovery.
  if (gConfig.vinMonitor.enabled) {
    unsigned long vinPollInterval = (unsigned long)gConfig.vinMonitor.pollIntervalSec * 1000UL;
    if (gPowerState >= POWER_STATE_LOW_POWER) {
      vinPollInterval *= 2;  // 2x slower when conserving
    }
    if (now - gLastVinPollMillis >= vinPollInterval) {
      gLastVinPollMillis = now;
      gVinVoltage = readVinDividerVoltage();
    }
  }
  
  // ---- Update power conservation state (after polling battery sources) ----
  updatePowerState();
  
  // Periodic firmware update check via Notecard host-pull MCUboot DFU
  // Interval matches inbound poll: 10 min (grid) / 1 hour (solar)
  // Skip in LOW_POWER and CRITICAL — firmware updates are not urgent
  if (gPowerState <= POWER_STATE_ECO) {
    unsigned long dfuInterval = gConfig.solarPowered
        ? (unsigned long)SOLAR_INBOUND_INTERVAL_MINUTES * 60000UL  // 1 hour (solar)
        : 600000UL;  // 10 minutes (grid)
    if (now - gLastDfuCheckMillis > dfuInterval) {
      if (!gDfuInProgress && gNotecardAvailable) {
        gLastDfuCheckMillis = now;  // only advance the timer when a check actually runs
#ifdef TANKALARM_WATCHDOG_AVAILABLE
  #if defined(ARDUINO_OPTA) || defined(ARDUINO_ARCH_MBED)
        mbedWatchdog.kick();  // QSPI blacklist mount + dfu.status query can be slow
  #else
        IWatchdog.reload();
  #endif
#endif
        checkForFirmwareUpdate();
        // Always apply a pushed OTA update from Notehub when one is available. The per-client
        // update policy was removed — the device unconditionally accepts firmware pushed to it.
        if (gDfuUpdateAvailable) {
          Serial.println(F("Auto-DFU: Applying available firmware update (MCUboot)..."));
          enableDfuMode();
        }
      } else {
        // Could not check this cycle (DFU busy or Notecard offline). Do NOT burn the
        // full interval — a brief Notecard/I2C hiccup at the tick should not defer the
        // OTA check by a whole hour. Retry in ~1 min. (now > dfuInterval in this branch
        // because gLastDfuCheckMillis >= 0, so the subtraction cannot underflow.)
        gLastDfuCheckMillis = now - dfuInterval + 60000UL;
        Serial.println(F("DFU check deferred (DFU busy or Notecard offline) - retrying ~1 min"));
      }
    }
  }

  // ---- Daily firmware-update safety net (power-state override) ----
  // The frequent DFU check above is intentionally skipped in LOW_POWER and CRITICAL_HIBERNATE
  // to conserve energy. But an OTA must NEVER be permanently blocked by power state — otherwise
  // a device that mis-reads its voltage (or has a genuinely weak battery) could get stuck on
  // broken firmware with no remote way to recover. So at least once per day, regardless of
  // voltage or power state, force a sync + DFU check and apply any pending update. The device
  // already wakes every POWER_CRITICAL_SLEEP_MS (5 min) even in hibernate, so this needs no RTC
  // alarm — it just runs on a normal loop iteration once the daily interval has elapsed.
  if (gPowerState > POWER_STATE_ECO) {  // only LOW_POWER / CRITICAL_HIBERNATE (ECO/NORMAL handled above)
    bool dailyDfuDue = (gLastDailyDfuCheckMillis == 0)
        ? (now >= DAILY_DFU_BOOT_GRACE_MS)
        : (now - gLastDailyDfuCheckMillis >= DAILY_DFU_CHECK_INTERVAL_MS);
    if (dailyDfuDue && !gDfuInProgress && gNotecardAvailable) {
      gLastDailyDfuCheckMillis = now;
      Serial.println(F("Daily DFU window: checking for firmware update (power-state override)"));
      addSerialLog("Daily DFU check (low-power override)");
#ifdef TANKALARM_WATCHDOG_AVAILABLE
  #if defined(ARDUINO_OPTA) || defined(ARDUINO_ARCH_MBED)
      mbedWatchdog.kick();
  #else
      IWatchdog.reload();
  #endif
#endif
      // Force a sync so the Notecard pulls the latest dfu.status/firmware from Notehub even
      // though inbound polling is otherwise suspended in this state.
      J *dfuSyncReq = notecard.newRequest("hub.sync");
      if (dfuSyncReq) {
        J *dfuSyncRsp = notecard.requestAndResponse(dfuSyncReq);
        if (dfuSyncRsp) notecard.deleteResponse(dfuSyncRsp);
      }
#ifdef TANKALARM_WATCHDOG_AVAILABLE
  #if defined(ARDUINO_OPTA) || defined(ARDUINO_ARCH_MBED)
      mbedWatchdog.kick();
  #else
      IWatchdog.reload();
  #endif
#endif
      checkForFirmwareUpdate();
      // Apply regardless of power state — recovery from broken/old firmware takes priority over
      // power conservation. enableDfuMode() kicks the watchdog throughout the staging operation.
      // The per-client update policy was removed: a pushed OTA is always accepted.
      if (gDfuUpdateAvailable) {
        Serial.println(F("Daily DFU window: applying available firmware update (MCUboot)..."));
        addSerialLog("Daily DFU apply (low-power override)");
        enableDfuMode();
      }
    }
  }

  persistConfigIfDirty();
  retryPendingConfigAckIfDue();

  // Periodic health telemetry (when enabled, skip in CRITICAL to save power)
#ifdef TANKALARM_HEALTH_TELEMETRY_ENABLED
  if (gPowerState <= POWER_STATE_ECO && gNotecardAvailable) {
    if (now - gLastHealthTelemetryMillis >= HEALTH_TELEMETRY_INTERVAL_MS) {
      gLastHealthTelemetryMillis = now;
      sendHealthTelemetry();
    }
    // Track heap low-watermark on every loop iteration (cheap operation)
    uint32_t currentHeap = tankalarm_freeRam();
    if (currentHeap > 0 && currentHeap < gHeapMinFreeBytes) {
      gHeapMinFreeBytes = currentHeap;
    }
  }
#endif
  
  // Skip time sync and daily reports in CRITICAL_HIBERNATE
  if (gPowerState != POWER_STATE_CRITICAL_HIBERNATE) {
    ensureTimeSync();
    updateDailyScheduleIfNeeded();

    bool reportDue = false;
    if (isSolarOnlyActive()) {
      // Opportunistic reporting: send ASAP if overdue by configured threshold
      double nowEpoch = currentEpoch();
      if (nowEpoch > 0.0 && gSolarOnlyStartupComplete && isSensorVoltageGateOpen()) {
        double hoursSinceLastReport = 9999.0;
        if (gSolarOnlyLastReportEpoch > 0.0) {
          hoursSinceLastReport = (nowEpoch - gSolarOnlyLastReportEpoch) / 3600.0;
        }
        if (hoursSinceLastReport >= (double)gConfig.solarOnlyConfig.opportunisticReportHours) {
          reportDue = true;
        }
        // Also honor the scheduled time if it has passed
        if (gNextDailyReportEpoch > 0.0 && nowEpoch >= gNextDailyReportEpoch) {
          reportDue = true;
        }
      }
    } else {
      // Standard scheduled reporting
      reportDue = (gNextDailyReportEpoch > 0.0 && currentEpoch() >= gNextDailyReportEpoch);

      // Fallback: if Notecard time never syncs (no cellular/GPS), fire daily
      // report based on millis() every 24h to avoid permanent blackout.
      if (!reportDue && currentEpoch() <= 0.0) {
        static unsigned long lastFallbackReportMillis = 0;
        if (lastFallbackReportMillis == 0) {
          // First check: only fire after 24h of uptime (allow time for Notecard sync)
          if (millis() >= 24UL * 60UL * 60UL * 1000UL) {
            Serial.println(F("WARNING: No time sync — sending daily report via millis fallback"));
            reportDue = true;
            lastFallbackReportMillis = millis();
          }
        } else if ((millis() - lastFallbackReportMillis) >= 24UL * 60UL * 60UL * 1000UL) {
          Serial.println(F("WARNING: No time sync — sending daily report via millis fallback"));
          reportDue = true;
          lastFallbackReportMillis = millis();
        }
      }
    }

    if (reportDue) {
      sendDailyReport();
      gSolarOnlyLastReportEpoch = currentEpoch();
      if (isSolarOnlyActive()) {
        saveSolarStateToFlash();  // Persist last report epoch across power cycles
      }
      scheduleNextDailyReport();
    }
  }
  
  // Solar-only sunset protocol: detect declining voltage and save state
  if (isSolarOnlyActive() && gSolarOnlyStartupComplete) {
    checkSolarOnlySunsetProtocol(now);
  }

  // Sleep to reduce power consumption between loop iterations
  // Duration is controlled by the power conservation state machine.
  // Higher states = longer sleep = lower power draw.
  // For sleep durations longer than the watchdog timeout, we sleep in chunks
  // and kick the watchdog between each chunk to prevent a hardware reset.
  unsigned long sleepMs = getPowerStateSleepMs(gPowerState);
  safeSleep(sleepMs);
}

// Helper: Get recommended pulse sampling parameters based on expected rate
// This helps configure optimal sampling for the expected RPM/flow rate range
// Returns: pulseSampleDurationMs, pulseAccumulatedMode recommendations
static PulseSamplingRecommendation getRecommendedPulseSampling(float expectedRate) {
  PulseSamplingRecommendation rec;
  
  if (expectedRate <= 0.0f) {
    // No expected rate configured - use defaults
    rec.sampleDurationMs = RPM_SAMPLE_DURATION_MS;
    rec.accumulatedMode = false;
    rec.description = "Default (60s sample)";
  } else if (expectedRate < 1.0f) {
    // Very low rate (< 1 RPM/GPM): use accumulated mode
    // Count pulses over entire telemetry interval for accuracy
    rec.sampleDurationMs = 60000;  // 60s sample within each interval
    rec.accumulatedMode = true;
    rec.description = "Accumulated mode (very low rate)";
  } else if (expectedRate < 10.0f) {
    // Low rate (1-10 RPM/GPM): longer sample for accuracy
    rec.sampleDurationMs = 60000;  // 60 seconds
    rec.accumulatedMode = false;
    rec.description = "60s sample (low rate)";
  } else if (expectedRate < 100.0f) {
    // Medium rate (10-100 RPM/GPM): moderate sample
    rec.sampleDurationMs = 30000;  // 30 seconds
    rec.accumulatedMode = false;
    rec.description = "30s sample (medium rate)";
  } else if (expectedRate < 1000.0f) {
    // High rate (100-1000 RPM/GPM): shorter sample is sufficient
    rec.sampleDurationMs = 10000;  // 10 seconds
    rec.accumulatedMode = false;
    rec.description = "10s sample (high rate)";
  } else {
    // Very high rate (> 1000 RPM): quick sample
    rec.sampleDurationMs = 3000;   // 3 seconds
    rec.accumulatedMode = false;
    rec.description = "3s sample (very high rate)";
  }
  
  return rec;
}
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
