SenaxInc/SenaxTankAlarm/TankAlarm-112025-Common/src/TankAlarm_DFU.h

/**
 * TankAlarm_DFU.h
 *
 * IAP (In-Application Programming) firmware update via Blues Notecard.
 *
 * The Blues Wireless for Opta carrier does NOT route the AUX pins needed for
 * Outboard DFU (ODFU). This module implements IAP DFU instead:
 *   1. Notecard downloads firmware from Notehub (automatic, background)
 *   2. Host polls dfu.status to detect when firmware is "ready"
 *   3. Host enters DFU mode (hub.set mode=dfu)
 *   4. Host reads firmware chunks via dfu.get
 *   5. Host writes chunks to internal flash via Mbed FlashIAP
 *   6. Host verifies, clears DFU state, restores hub mode, and reboots
 *
 * Reference: https://dev.blues.io/notehub/host-firmware-updates/iap-firmware-update/
 *            https://dev.blues.io/notehub/host-firmware-updates/notecard-api-requests-for-dfu/
 *
 * Copyright (c) 2025-2026 Senax Inc. All rights reserved.
 */

#ifndef TANKALARM_DFU_H
#define TANKALARM_DFU_H

#include <Arduino.h>
#include <Notecard.h>

// ============================================================================
// IAP DFU Configuration
// ============================================================================

// Chunk size for dfu.get reads (bytes of raw binary per request).
// Over I2C, must stay within Notecard I2C MTU. 128 bytes is safe and
// results in ~176 bytes of base64 in the JSON response.
#ifndef DFU_IAP_CHUNK_SIZE
#define DFU_IAP_CHUNK_SIZE 128
#endif

// Maximum retries for a single dfu.get chunk before aborting
#ifndef DFU_IAP_CHUNK_RETRIES
#define DFU_IAP_CHUNK_RETRIES 3
#endif

// Maximum time (ms) to wait for Notecard to enter DFU mode after hub.set
#ifndef DFU_IAP_MODE_TIMEOUT_MS
#define DFU_IAP_MODE_TIMEOUT_MS 60000UL
#endif

// ============================================================================
// IAP DFU Setup — called from each sketch's initializeNotecard()
// ============================================================================
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
