SenaxInc/SenaxTankAlarm/(commit log)

2026-05-01 Address review round 2: bufLen>=24, integer today, cross-day throttle reset, config validation, fix UTC formula
    Agent-Logs-Url: https://github.com/SenaxInc/SenaxTankAlarm/sessions/e612d0ea-647b-4a90-8780-1b03bb16ffa8
    [TankAlarm-112025-Viewer-BluesOpta.ino]
2026-05-15 Add flash write observability and hash-gated saves
    Add on-device flash write observability and hash-gated persistence to reduce wear and improve diagnostics. Introduces serverWriteFileAtomic() wrapper that counts successful writes, failures, bytes, skipped-hash events and records last paths/timestamps, and replaces direct tankalarm_posix_write_file_atomic() calls to route writes through the counter. Adds FNV-1a hashing and hash-gate logic for history and hot-tier saves (saveHistorySettings, saveHotTierSnapshot) to skip redundant writes and increment skipped counters. Exposes a new /api/system-status endpoint and printMemoryBudget() for runtime flash/heap visibility. Gates pre-backup server_c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
2026-05-15 Bump firmware/docs to v1.6.14
    Prepare release v1.6.14 by updating version strings across the project: README (release/version and deployment checklist), Bill of Materials, library.properties, and FIRMWARE_VERSION in TankAlarm_Common.h. Ensures documentation, package metadata, and firmware macro stay in sync for the new release.
2026-05-31 assign sample time not send time
    avoid stale readings getting fresh timestamps
    [TankAlarm-112025-Client-BluesOpta.ino]
2026-06-01 feat: implement dynamic transistor power gating for A0602 current loop sensors
    - Add ankalarm_setPwm() to TankAlarm_I2C.h to gate high-side output switches.
    - Integrate dynamic parameter mapping (pwmGatingEnabled, pwmGatingChannel, pwmGatingWarmup, pwmGatingSampleDelay) inside TankAlarm-Client-BluesOpta.
    - Verify flash persistence parameters and dynamic timings during averaging loops within
    eadCurrentLoopSensor().
    - Add customizable PWM gating configurations and stabilization input fields to webpage config generator.
    - Add general A0602 / transistor gating test utility sketches.
2026-06-01 chore: add local arduino-cli to gitignore
2026-06-01 Add stale-deletion flag and UI approval
    Bump library/firmware version to 1.7.1 and introduce a controlled stale-client deletion workflow. Server: add meta.staleDeletionPending, persist it (sdp) in metadata save/load, and expose it in client JSON as dp. checkStaleClients now flags long-offline clients for deletion (and logs) instead of auto-removing them, and clears the flag if the client reports again; metadata persistence is triggered when dirty. UI: surface a STALE badge in the client list, include dp in normalized API data, add an "Approve Deletion" button and approveDeletion() flow that prompts for an admin pin and calls DELETE /api/client. This prevents automatic data loss and requires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
    [TankAlarm_Common.h]
2026-06-04 feat: conversion-architecture + calibration sync (schema v2), PWM-gating watchdog/retry fixes
    Client: self-describing sensor payloads (ot/mu/st/raw/lvl/cap/cv), pushed-calibration apply, under-range mA (<3.6) sensor-fault guard, _sv stamped before serialize so buffered/flushed notes carry it. PWM sensor power gating now feeds the watchdog across warmup/sample delays and retries the I2C enable. Server: resolveLevel trusts client lvl unless calibration version stale, per-client calibration injection into config, per-client system-SMS limiter. Common: FIRMWARE_VERSION 1.7.2, NOTEFILE_SCHEMA_VERSION 2.
    [TankAlarm-112025-Client-BluesOpta.ino, TankAlarm_Common.h]
2026-06-04 Add code review reports for v1.7.2 and v1.6.15
    Add two comprehensive code review artifacts (dated 2026-06-04) for the TankAlarm Server/Client firmware: CODE_REVIEW_06042026_SERVER_CLIENT_WIRELESS_SENSOR_v1.7.2_COPILOT.md and CODE_REVIEW_06042026_v1.6.15_COPILOT.md. Each file documents scope, executive summary, severity-ranked findings, suggested fixes and tests; notable issues include offline note buffer truncation (loss of >1024B notes), inbound command validation and peek-then-delete handling, server config snapshot size mismatch, current-loop disconnect silencing with learned calibration, schema/version stamping gaps, and source-authentication/UID trust concerns. These reviews provide con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
2026-06-07 Add code review reports and update docs/sketches
    Add three code review artifacts (CODE_REVIEW_06072026... v1.1, v1.2, v1.3) for the 112025 Server/Client v1.7.2 firmware and make assorted documentation and sketch updates. Changes include updates to README.md, Bill of Materials, fleet implementation/migration guides, server and client .ino sketches, common library.properties and TankAlarm_Common.h, several tutorial guides, and addition of term_health.txt. These changes capture review findings, tighten documentation, and update firmware source and metadata; run the project build/tests to verify runtime behavior and follow up on review action items.
    [TankAlarm-112025-Client-BluesOpta.ino, TankAlarm_Common.h]
2026-06-07 Add Opta firmware build job and tidy workflows
    Document and restructure CI for the 112025 Opta release: update .github/workflows/README.md to describe the new Arduino CI & firmware build flow and note the retirement of the 092025 project. Rename and update arduino-ci-112025.yml (job renamed to compile-check) and add a build-firmware job that checks out the FTPSclientOPTA library, installs Opta core/libs, generates config headers from the BLUES_PRODUCT_UID secret, compiles Client/Server/Viewer/FTPS test bins, and commits firmware/112025/*.bin with an automated rebase strategy. Rename release-server-112025.yml to release-firmware-112025.yml and adjust it to build and publish Client/Server/View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
2026-06-08 ci: install arduino-cli via direct binary download
2026-06-08 Harden Solar RS485 communication, resolve float charging issues and clamp inputs v1.8.4
    [TankAlarm-112025-Client-BluesOpta.ino, TankAlarm_Common.h, TankAlarm_Solar.cpp, TankAlarm_Solar.h]
2026-06-09 Bump version to v1.8.5 and implement Coordinated ODFU update handshake on remote DIN-rail clients with zero hardware mods
2026-06-09 v1.8.6: revert client to IAP firmware updates and harden IAP path
    ODFU is not supported on the Blues Wireless for Opta carrier (AUX/I2C expansion bus does not route the STM32H747 BOOT0/NRST/USART1 lines; confirmed via Blues + Arduino datasheets and Notehub {odfu-fail} history). v1.8.5's Coordinated ODFU broke the working OTA path, so the client reverts to host-driven IAP (dfu.get + FlashIAP) used successfully from v1.3.0 through v1.8.4.
    IAP hardening in TankAlarm_DFU.h: sector-by-sector flash erase with watchdog kicks between sectors (prevents watchdog reset mid-erase brick); kick watchdog before/after every blocking Notecard requestAndResponse and after retry delays.
    Client: per-version D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
    [TankAlarm-112025-Client-BluesOpta.ino, TankAlarm_Common.h, TankAlarm_DFU.h]
2026-06-09 feat: Implement Track B CI/CD and Key Provisioning
2026-06-10 Add v1.9.0 MCUboot update system code reviews
    Add four detailed code review documents for the v1.9.0 update system: COPILOT, COPILOT_FINAL, COPILOT_v2, and PROPOSED_FIXES. The reviews analyze MCUboot integration, CI artifact/key handling, Client/Server DFU flows, and critical security/availability regressions (infinite watchdog loop, live-flash overwrite, committed private keys, and non-compiling MCUboot helper), and provide remediation recommendations and a prioritized action plan. These documents are intended to guide follow-up fixes and release gating before tagging or field deployment.
2026-06-10 Add MCUboot DFU support, QSPI OTA and policies
    Integrates MCUboot-based OTA flow across Client, Server and Viewer builds: adds DEVICE_ROLE defines, a client updatePolicy config (disabled/alert-only/auto-MCUboot), and library version bump (1.9.1). Introduces MCUboot configuration header (slot geometry), QSPI/FAT provisioning and staging logic, and persistent pending_ota.json to track trial/confirm/rollback state. Implements tankalarm_performMcubootUpdate with safety checks (MCUboot magic, CRC32 verification, slot padding, role/source matching), local blacklist handling, watchdog kicking, and graceful restore on failure. Adds utilities: tankalarm_resolvePendingOta (resolve pending OTA on boot)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
    [TankAlarm-112025-Client-BluesOpta.ino, TankAlarm-112025-KeyProvisioning.ino, TankAlarm-112025-Viewer-BluesOpta.ino, TankAlarm_Common.h, TankAlarm_DFU.h, TankAlarm_MCUbootConfig.h]
2026-06-10 Add MCUboot provisioning and testing guide
    Introduce a new runbook detailing one-time MCUboot hardware provisioning for Arduino Opta devices, including flashing the bootloader, key provisioning, QSPI formatting, and initial firmware setup. Adds a comprehensive bench-testing validation matrix (swap, watchdog, CRC failure, role mismatch, rollback, offline boot) and a maintenance file mapping for relevant source files and helpers.
2026-06-10 Fix Arduino compilation errors: wrap MCUboot function calls in TANKALARM_DFU_MCUBOOT guards
    [TankAlarm-112025-Client-BluesOpta.ino, TankAlarm-112025-Viewer-BluesOpta.ino, TankAlarm_DFU.h]
2026-06-10 Fix enableDfuMode() in Viewer sketch: add success=false in else branch, move failure handling outside MCUboot guard
    [TankAlarm-112025-Viewer-BluesOpta.ino]
2026-06-10 Fix: send dfu.status stop:true in non-MCUboot else branch for all sketches
    [TankAlarm-112025-Client-BluesOpta.ino, TankAlarm-112025-Viewer-BluesOpta.ino]
2026-06-12 Hardened QSPI Partition 4 Storage, Fixed Notecard DFU trigger logic, and Updated Provisioning Tutorials with Cold-Boot & DTR recovery procedures
    [TankAlarm-112025-Client-BluesOpta.ino, TankAlarm_Common.h, TankAlarm_DFU.h]
2026-06-12 Configure development CI to automatically sign and build Client secure .slot.bin images on master push version bumps
2026-06-12 feat: config epoch timestamps, client v1.9.5 with actual effective battery monitor daily sourcing and masked server front-end client-card VIN render limit < 6V
2026-06-13 fix(server): restore v1.6.15 conversion-architecture, per-client SMS limiter, stale-deletion approval, and GitHub route alias accidentally reverted by 81a8c0b (v1.8.5); bump to v1.9.6
    81a8c0b pasted a stale copy of the Server .ino (blob identical to f8c39ea), silently reverting 6 server-only commits while only the Client was edited for ODFU. Restored semantically onto current minified HEAD: (1) fe861a2 resolveLevel self-describing decode + injectCalibrationIntoConfig push + redispatchConfigWithCalibration + per-client lastSystemSmsEpoch limiter; (2) ab4b645 stale-client deletion approval (flag instead of auto-remove, dp flag, STALE badge, Approve Deletion button); (3) 4ee3122 GitHub route al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
    [TankAlarm_Common.h]
2026-06-13 fix(server): restore 04bc159 fixes including CLIENT_CONFIG_SNAPSHOT_PAYLOAD_MAX, history pruning survivor compaction, central schema gate, and validation checks; bump to v1.9.7
    [TankAlarm_Common.h]
2026-06-13 fix(client): publish firmwareVersion fv centrally on publishNote; map and resolve fv in site configuration view; bump to v1.9.8
    [TankAlarm-112025-Client-BluesOpta.ino, TankAlarm_Common.h]
2026-06-13 fix(server): render configured sensor name/type/unit/contents on dashboard + site-config; prefer MPPT solar.bv over Notecard v for VIN; bump to v1.9.10
    Dashboard and site-config showed client-reported telemetry defaults (Primary Tank/tank/inches) instead of the operator-configured values. Added getConfiguredSensorDisplay() to resolve name/monitorType/measurementUnit/contents from the cached client config snapshot, and made /api/clients prefer them over the stale self-reported SensorRecord fields. handleDaily now prefers the SunSaver MPPT battery voltage (solar.bv, true 12V pack over RS-485) over the top-level v field, which on LDO-only clients reflects the ~5V Notecard rail.
    [TankAlarm_Common.h]
2026-06-14 fix(client): treat under-range 4-20mA on gas monitors as loop fault, not 0.0; feat(server): dashboard shows 'Updated Nh ago' in hours; bump v1.9.11
    Client: the live-zero under-range fault gate (<3.6mA) was exempted for gas monitors, so an unpowered/open gas loop read ~0mA and was reported as a real 0.0 PSI. A healthy 4-20mA transmitter sources 4mA even at true zero pressure, so under-range is always a loop fault. Removed the gas exemption; an unpowered gas loop now escalates a sensor-fault and withholds telemetry instead of publishing a fake 0.0. Server: dashboard relative time no longer rolls over to days (always hours) and is prefixed with 'Updated' (or 'No data yet' when none).
    [TankAlarm-112025-Client-BluesOpta.ino, TankAlarm_Common.h]
2026-06-14 feat(client): send immediate confirmation telemetry on first boot after a firmware update; bump v1.9.12
    Adds checkFirmwareUpdateMarker(): on boot the client compares FIRMWARE_BUILD_SEQ against a persisted marker on the app data partition. On a change (OTA or USB update, or first boot of this firmware) it forces an immediate hub.sync after the boot telemetry/registration note so transmission can be verified right away instead of waiting for the periodic outbound window (up to 6h on solar clients). Fires once per update; power-safe. The boot note already carries the firmware version, so the dashboard fv updates immediately too.
2026-06-14 fix(client): exclude Notecard card.voltage from battery estimate when USB-powered; bump v1.9.13
    Root cause of 'no telemetry for days': getEffectiveBatteryVoltage() took the min() of the MPPT battery voltage and the Notecard card.voltage. With batteryMonitor enabled and the Notecard powered from USB, card.voltage reports the ~4.66-5V USB/V+ rail (not the battery), dragging the effective voltage far below the 11.5V critical threshold. The client then entered CRITICAL_HIBERNATE, which by design skips sensor sampling (no telemetry), config polling, daily reports AND firmware-update apply (gated by gPowerState <= ECO) - a deadlock where the device can neither report nor receive the OTA that would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
    [TankAlarm-112025-Client-BluesOpta.ino, TankAlarm_Common.h]
2026-06-14 fix(client): never use Notecard card.voltage as a battery reading on Opta (V+ is regulated to ~5V); bump v1.9.14
    Hardware fact: on the Blues 'Wireless for Opta' carrier the Notecard's V+ is fed through a DC-DC converter regulated to ~5V, so card.voltage physically cannot read above ~5V and can never represent the 12V battery. v1.9.13's usbPowered guard was too narrow. This makes pollBatteryVoltage() a no-op on Opta/mbed (sets valid=false, returns false) - the single chokepoint that disables the Notecard as a battery source for the power-state machine, battery SMS alerts, and the daily battery section alike. Battery voltage now comes solely from the SunSaver MPPT (RS-485) and/or the analog Vi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
    [TankAlarm-112025-Client-BluesOpta.ino, TankAlarm_Common.h]
2026-06-14 feat(client): daily firmware-update window that bypasses power-state gating so OTA is never blocked by hibernate; bump v1.9.15
    Previously checkForFirmwareUpdate()/enableDfuMode() were gated by 'gPowerState <= POWER_STATE_ECO', so in LOW_POWER and CRITICAL_HIBERNATE a device could get stuck on broken firmware with no remote recovery (it could neither report nor receive the OTA that would fix it). Added a daily safety-net in loop() that runs ONLY in LOW_POWER/CRITICAL_HIBERNATE: at least once per DAILY_DFU_CHECK_INTERVAL_MS (24h, first check after a 2-min boot grace) it forces a hub.sync, checks for a firmware update, and applies it - regardless of voltage or power state. The device already wa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
    [TankAlarm-112025-Client-BluesOpta.ino, TankAlarm_Common.h]
2026-06-14 feat(client): strip per-client update policy - always accept a pushed OTA from Notehub; bump v1.9.16
    Removed the client-side updatePolicy gate entirely. Both DFU auto-apply sites (the normal power-gated check and the daily low-power override window) now apply a pending firmware update unconditionally when gDfuUpdateAvailable, instead of requiring updatePolicy == AUTO_MCUBOOT. Removed the updatePolicy struct field and its default/load/save/apply-update references. Rationale: the per-client policy was only ever set from a config key the server generator never emits, so it always defaulted to DISABLED and silently blocked all OTA. The device now always accepts firmware pushed to it from Notehub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
2026-06-14 fix(server): real-time inbound telemetry sync so dashboard updates continuously; bump v1.9.17
    Root cause of the dashboard freezing until a reboot: the server's Notecard ran in continuous mode WITHOUT sync:true. processNotefile() only reads notes already downloaded to the Notecard; it never forces a Notehub sync. Because the server rarely sends outbound notes, its Notecard rarely initiated a sync, so inbound client telemetry routed to the server piled up at Notehub undelivered until a reboot forced a sync. Fix: (1) add sync:true to the continuous-mode hub.set so Notehub notifies the Notecard the instant an inbound note is queued, triggering an immediate sync (near real-time dashboard updates)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
    [TankAlarm_Common.h]
2026-06-14 fix(server): auto-clear stale sensor-stuck alarm on telemetry when stuck detection is disabled; bump v1.9.18
    A latched sensor-stuck alarm was only cleared by a client sensor-recovered note or a config re-dispatch. After a client firmware reflash/reboot (which resets the client runtime failed-state) or when stuck detection is turned off, the client never sends a recovery note, so the alarm stayed latched on the dashboard indefinitely. handleTelemetry now self-clears it: when fresh telemetry arrives for a sensor whose cached config has stuckDetection disabled (or absent = client default off), any lingering sensor-stuck latch is definitively stale and is cleared (rec->alarmActive=false + clearA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
    [TankAlarm_Common.h]
2026-06-14 client v1.9.19: fix gated 4-20mA read cadence (priming read + 300ms settle floor)
    Production readCurrentLoopSensor() sampled the A0602 current-loop at the configured pwmGatingSampleDelay (5ms) with no priming read, 60x faster than the validated P1_Transistor_Gating_Test (300ms spacing). The A0602 ADC needs settle time after channel-select to return a fresh conversion; at 5ms it returns a stale/constant high value (seen as a pegged ~18mA / 43.8psi). Add a discard/priming read + settle after warmup and floor the gated inter-sample delay to CURRENT_LOOP_GATED_SETTLE_MS (300ms), matching the proven sequence. WDT kept fed across the added delays.
    [TankAlarm-112025-Client-BluesOpta.ino, TankAlarm_Common.h]
2026-06-15 v1.9.20: OTA update management (expected-vs-reported reconciliation + failure reporting)
    Server: ClientMetadata gains expectedFirmwareVersion/otaState/otaDetail/otaStateEpoch/otaAttempts; reconcileClientOta() flags pending->stalled (>26h, just over the daily DFU window) when a client keeps reporting an old version, and clears to ok on success. New POST /api/ota/expect {client|all,version} (defaults to server build) sets the expectation; an 'Expect Update' button on site-config drives it. handleConfigAck now routes st=ota-* reports to handleOtaResult (applied/reverted/stage-failed) with SMS + transmission log. /api/clients emits os/efv/od; dashboard client panel + site-config Quick Reference/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
    [TankAlarm-112025-Client-BluesOpta.ino, TankAlarm_Common.h, TankAlarm_DFU.h]
2026-06-15 v1.9.21: include live system voltage in telemetry notes (temporary)
    Client sendTelemetry adds doc[v]=getEffectiveBatteryVoltage to every telemetry note so dashboard VIN updates in near-real-time instead of waiting for the daily report. Server handleTelemetry reads doc[v] into ClientMetadata vinVoltage. Both carry a TEMPORARY comment; may be removed later.
2026-06-15 v1.9.22: current-loop safety/diagnostics + autonomous Ethernet recovery
    Current loop (client): readCurrentLoopSensor() now returns NAN (sensor fault) when the P1 power-gate enable fails instead of sampling the floating/unpowered channel and reporting a fabricated pressure; drives P1 off defensively. Telemetry emits pg (power-gate ok) for gated current-loop sensors so floating/stale vs real reads are visible remotely. Config-generator sample-settle default 5->300ms. Root protocol rewrite (framed ARG_OA_CH_ADC config + ARG_OA_GET_ADC read) staged pending hardware validation; library source confirms production never configures the A0602 channel nor sends a valid GET frame.
    Ethernet (server): a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
    [TankAlarm-112025-Client-BluesOpta.ino, TankAlarm_Common.h]
2026-06-15 v1.9.23: A0602 current-loop root fix - official Blueprint framed ADC config + read
    Replaces the bare write(channel)/requestFrom(2) shortcut (which never configured the A0602 channel and read a stale register -> constant ~18mA/43.8psi) with the official Blueprint framed protocol, constants copied verbatim from the installed Arduino_Opta_Blueprint source: tankalarm_configureCurrentAdcChannel() sends SET ARG_OA_CH_ADC(0x09) with the current-ADC payload + CRC8(poly 0x07); tankalarm_readCurrentAdcFramed() sends GET ARG_OA_GET_ADC(0x0A), CRC-validates the 7-byte answer, and returns mA = 25*raw/65535 (the A0602 current-ADC scale, also correcting the old 4+raw/65535*16 formula). Client readCurrentLo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
    [TankAlarm-112025-Client-BluesOpta.ino, TankAlarm_Common.h, TankAlarm_I2C.h]
2026-06-15 docs: add post-implementation reports to both CODE REVIEW analyses
    Current-loop doc gains section 18 (v1.9.22 safety+diagnostics and v1.9.23 framed-protocol root fix, with the actual changed code). Ethernet doc gains section 15 (v1.9.22 autonomous recovery state machine + DHCP-fallback log fix, with code). Both describe files changed, code snippets, build results, and verification performed vs still required.
2026-06-15 v1.9.24: harden A0602 framed current-loop protocol (channel + ACK validation)
    Implements the two unanimous post-implementation review follow-ups in TankAlarm_I2C.h: (1) tankalarm_readCurrentAdcFramed() now rejects an answer whose channel byte (a[3]) does not match the requested channel - CRC alone passes another channel's valid frame, so this guards bus cross-talk / stale answer buffers. (2) tankalarm_configureCurrentAdcChannel() now reads and validates the SET-ACK frame [BP_ANS_SET=0x04][ANS_ARG_OA_ACK=0x20][LEN=0x00][CRC] instead of blind-draining, returning false on a missing/garbled ACK (non-fatal: the GET read CRC-validates independently, but a failed config is now surfaced). Both stric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
    [TankAlarm_Common.h, TankAlarm_I2C.h]
2026-06-15 v1.9.25: stream server settings page from flash to fix heap-exhaustion render failure
    Rewrite serveServerSettingsPage to stream SERVER_SETTINGS_HTML directly from PROGMEM in 512-byte chunks via new streamProgmemRange helper, injecting the loading overlay, DFU target block, and hide-script inline with a computed Content-Length. Eliminates the prior double full-page String allocation (body + merged) that could exhaust the Opta heap and make the Server Settings page fail to render/hang. Finds the last </body> to match respondHtml's lastIndexOf convention.
    [TankAlarm_Common.h]
2026-06-15 v1.9.26: free web-server LISTEN socket before Ethernet recovery re-begin
    The autonomous Ethernet recovery loop called gWebServer.begin() after initializeEthernet() without first calling gWebServer.end(), leaking a LISTEN PCB on the Opta's 4-deep LWIP socket pool each recovery cycle and eventually starving port 80 / FTPS. Now ends the listener before re-initializing, mirroring the end()-before-begin pattern already used around the FTP backup/restore paths. Addresses the post-implementation review follow-up (CODE_REVIEW_06152026_OPTA_POST_DFU_ETHERNET section 18.1).
    [TankAlarm_Common.h]
2026-06-15 v1.9.27: fix client OTA staging path (QSPI/fs_ota contention, gDfuInProgress latch, downgrade guard) + harden KeyProvisioning
    TankAlarm_DFU.h: replace the 5 per-function QSPIFBlockDevice+MBRBlockDevice+FATFileSystem('fs_ota') instances with a single shared tankalarm_otaFsMount()/Unmount() built on BlockDevice::get_default_instance(). Eliminates (a) a second QSPI driver fighting the app singleton on the same pins and (b) duplicate 'fs_ota' prefix registrations that made later mount() calls fail - both could abort OTA staging on a fully provisioned board. Mount is idempotent; staging-failure path now unmounts. Added tankalarm_otaSelfCheck() boot diagnostic.
    Client checkForFirmwareUpdate(): a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
    [TankAlarm-112025-Client-BluesOpta.ino, TankAlarm-112025-KeyProvisioning.ino, TankAlarm_Common.h, TankAlarm_DFU.h]
2026-06-16 ci: build client OTA slot via core security=sien
    Both release-firmware-112025 and arduino-ci-112025 now compile the client with --fqbn ...:security=sien (core bundled imgtool 1.8.0-arduino.2 + default keychain) instead of build-plain + pip imgtool + header_size monkeypatch + custom-key sign. The prior approach produced a .slot.bin the v25 bootloader would not swap on the device. See CODE_REVIEW_06152026_OTA_VS_USB_UPDATE_FAILURE.md section 16.
2026-06-16 v1.9.28: bump firmware version and build seq to 218
    Strictly newer than the bench client (1.9.27 / build 217) so the MCUboot downgrade guard allows a genuine A/B swap test using the corrected CI slot image. Version/build-sequence bump only; no functional code changes.
    [TankAlarm_Common.h]
2026-06-16 Bump version to v1.9.29 and handle stale-latching sensor stuck alarms
    [TankAlarm_Common.h]
2026-06-17 client OTA: make update check robust + observable; harden DFU cleanup
    Implements review findings (CODE_REVIEW_06162026_OTA_SILENT_CHECK_FAILURE):
    F15/F13: route performMcubootUpdate preflight + hub.set-mode-dfu lost-response failures through mcuboot_restore_hub so the Notecard DFU is stopped and hub mode restored (prevents stranding the Notecard offline for ~4h). F16: clear stale gDfuUpdateAvailable/length/version on dfu.status comm-failure and error paths. F17: clear those flags on enableDfuMode staging failure to stop perpetual retry of a permanently-failing image. F8: stop+report a refused (downgrade/equal/blacklisted) firmware once per version so the Notecard stops re-advertising it. F1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
    [TankAlarm-112025-Client-BluesOpta.ino, TankAlarm_DFU.h]
2026-06-17 Harden DFU parsing and add OTA diagnostics
    Fix OTA/DFU edge cases and improve build visibility. Changes:
    - TankAlarm_DFU.h: tolerate leading 'v' in version strings, validate sscanf result to avoid false downgrade rejections; add name:"user" when stopping DFU on rollback.
    - TankAlarm-112025-Client-BluesOpta.ino: add compile-time warning when TANKALARM_DFU_MCUBOOT is not defined and print OTA ENABLED/DISABLED banner at boot for diagnostics.
    - TankAlarm_Common.h & library.properties: bump firmware version to 1.9.32 and build sequence to 222; bump library.properties version accordingly.
    - Add a CODE REVIEW document describing the OTA v1.9.30→v1.9.31 failure analysis and recommended rollout ste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
    [TankAlarm-112025-Client-BluesOpta.ino, TankAlarm_Common.h, TankAlarm_DFU.h]
2026-06-17 fix(client): recover OTA version from filename when dfu.status has no version (1.9.34, build 224)
    A ready host .slot.bin carries no embedded Blues version, so dfu.status returns an empty version field and the host silently ignored a fully-downloaded OTA (mode stayed 'ready'). tankalarm_checkDfuStatus now derives the version from the update filename (and captures the filename from body name/file/source or the response root), so the apply path runs.
    [TankAlarm_Common.h, TankAlarm_DFU.h]
2026-06-18 fix(client): unmount fs_ota + checked boot_set_pending at MCUboot handoff (1.9.36, build 226)
    Root-cause fix for OTA swap-never-takes (v1.9.34->v1.9.35). The host kept QSPI partition 2 mounted as fs_ota while calling the void MCUboot::applyUpdate, so the core's boot_set_pending could not open the secondary slot to write the swap trailer and the failure was silently discarded. Now: unmount fs_ota before the handoff; call boot_set_pending(0) directly and check the return code; on failure clear the trial marker and abort the reset (return false -> ota-stage-failed) instead of a false rollback. Also adds bootloader-identity + signed-image (MCUboot header) diagnostics to tankalarm_otaSelfCheck so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
    [TankAlarm_Common.h, TankAlarm_DFU.h]
2026-06-19 fix(client): remove raw internal-flash reads from otaSelfCheck (HardFault) - 1.9.37/227
    The bootloader-identity diagnostic added in 1.9.36 read raw internal-flash addresses (incl. the MCUboot primary-slot header at 0x08020000). On the STM32H7, reading an erased/unprogrammed flash word raises a double-bit ECC fault -> HardFault, which crashed the client at boot (Mbed fault-handler red-LED blink, no host telemetry). Removed all raw flash reads from tankalarm_otaSelfCheck; bootloader identity is available via the STM32H747_getBootloaderInfo sketch instead. The OTA handoff fix (unmount fs_ota + checked boot_set_pending) from 1.9.36 is retained.
    [TankAlarm_Common.h, TankAlarm_DFU.h]
2026-06-19 release: bump to 1.9.38 (build 228) - fresh OTA target to test 1.9.37 handoff fix
    Version-only bump. The running 1.9.37 client (USB-flashed, recovered from the 1.9.36 HardFault) carries the OTA handoff fix (unmount fs_ota + checked boot_set_pending). 1.9.38 is a fresh, never-attempted version (1.9.35 is blacklisted on the device), so it is a clean target to validate whether the handoff fix lets the MCUboot A/B swap take effect.
    [TankAlarm_Common.h]
2026-06-19 fix(ota): stage through the MCUboot core's /fs mount, not a competing fs_ota mount (1.9.39/229)
    Notehub showed v1.9.37->v1.9.38 OTA failing at boot_set_pending (MCUboot staging failed). Core mounts QSPI p2 as 'fs' at static-init and keeps it mounted; boot_set_pending reaches /fs/update.bin via that mount. Our helpers mounted the same partition again as 'fs_ota' -> two FatFs caches -> staged bytes not coherent to the core's view -> trailer write failed. Fix: otaFsMount() calls core get_filesystem() (single coherent mount); otaFsUnmount() is a no-op; all OTA files /fs_ota/* -> /fs/*. Compiles 350684B.
    [TankAlarm_Common.h, TankAlarm_DFU.h]
2026-06-19 release: bump to 1.9.40 (build 230) - fresh OTA target for the 1.9.39 /fs staging fix
    Version-only bump. The running 1.9.39 client (USB-flashed) stages OTA through the MCUboot core's single /fs mount, so boot_set_pending should now succeed. 1.9.40 is a fresh, never-attempted target to validate the staging fix end-to-end.
    [TankAlarm_Common.h]
2026-06-20 fix(client): rename config-store mount /fs -> /cfg to free the MCUboot OTA mount (1.9.41/231)
    ROOT CAUSE of the long-standing OTA-swap failure: the client mounted its config LittleFileSystem under the name 'fs' (partition 4), the SAME Mbed mount name the MCUboot core hardcodes for the OTA secondary slot (partition 2, secondary_bd.cpp). The app mount (registered in setup) shadowed the core's, so /fs/update.bin resolved to the CONFIG partition (no update.bin) -> every boot_set_pending / staging fopen failed ('MCUboot staging failed'). Notehub showed 1.9.40 failing before even reaching 'staged for MCUboot' (the app's own /fs/update.bin open now hit p4). The core's get_secondary_bd is NOT weak (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
    [TankAlarm-112025-Client-BluesOpta.ino, TankAlarm_Common.h]
2026-06-20 release: bump to 1.9.42 (build 232) - fresh OTA target for the 1.9.41 mount-collision fix
    Version-only bump. Running 1.9.41 client no longer shadows the core /fs OTA mount (config moved to /cfg), so staging should hit partition 2 and boot_set_pending should succeed. 1.9.42 validates the full OTA path.
    [TankAlarm_Common.h]
2026-06-22 fix(voltage/sensor): dashboard correctness fixes + bump 2.0.0 (build 233)
    Implements the code fixes from CODE_REVIEW_06222026_VOLTAGE_ALARM (Section 6 live re-review). The three dashboard symptoms are independent issues: stale server voltage metadata, a real I2C bus fault (hardware, not code), and a reused daily 0.0 reading. CLIENT: (1) compile-gate the Notecard card.voltage source out of getEffectiveBatteryVoltage on Opta/mbed so the ~5V rail can never be a battery reading; (2) live-zero guard in readAnalogSensor returns NAN for an unpowered elevated-min analog sensor instead of a fabricated 0.0; (7) tag the voltage source (vs=mppt|vin-divider) on telemetry+daily v; (8) emit sf/ru data-qual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
    [TankAlarm-112025-Client-BluesOpta.ino, TankAlarm_Common.h]
2026-06-22 ci(release): attach per-version release notes; add v2.0.0 notes + deferred-items review
    The v2.0.0 firmware release was never built because no v2.0.0 tag was pushed (the release workflow triggers on v* tags; only the commit went to master). This adds release-notes/vX.Y.Z.md support to the release workflow (body_path + a stub fallback so future tags never break, with generate_release_notes still appending the commit changelog), authors release-notes/v2.0.0.md, and commits the deferred-items code review referenced by those notes. Tagging v2.0.0 next will build the firmware and create the release with these notes attached.
2026-06-22 fix(ota): make versionToSeq monotonic; fix downgrade guard + pending-OTA resolve (v2.0.40)
    versionToSeq used major*100+minor*10+patch, which is non-monotonic once patch>9: 1.9.42 -> 232 but 2.0.0 -> 200, so a running 1.9.42 client refused the 2.0.0 OTA as 'not newer than running firmware'. Switch to major*1000000+minor*1000+patch (each field has 0-999 head-room).
    Client downgrade guard now compares versionToSeq(offered) against versionToSeq(FIRMWARE_VERSION) instead of FIRMWARE_BUILD_SEQ (a separate build counter).
    resolvePendingOta now decides trial-success vs rollback by the staged target VERSION string (target_v), not the stored target_seq: pending_ota.json is written by old firmware in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
    [TankAlarm-112025-Client-BluesOpta.ino, TankAlarm_Common.h, TankAlarm_DFU.h]
2026-06-23 fix(ci): rebuild client OTA slot with security=sien; release v2.0.41
    The v2.0.40 OTA was accepted and staged by the running 1.9.42 client (the versionToSeq fix worked), but MCUboot reverted the trial boot. Root cause: commit 2926b11 (v2.0.0 release-notes) silently reverted the client OTA build step from the core 'security=sien' path back to the broken 'build-plain + pip imgtool + custom keys' approach, undoing a9bacd1.
    security=sien links the firmware for the MCUboot slot address (0xA0000000, vs 0x08040000 for a plain build) and signs/encrypts it with the core's bundled imgtool + default MCUboot keychain the Opta bootloader trusts. The plain build produced an image linked for the wrong addr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
    [TankAlarm_Common.h]
2026-06-23 ci(release): fail the build if the client OTA slot image is not a security=sien MCUboot image
    Adds a 'Validate client OTA slot image (MCUboot magic)' step that checks the slot .bin begins with the MCUboot IMAGE_MAGIC (3d b8 f3 96). A plain security=none build starts with the STM32 vector table instead, so this would have caught the 2926b11 regression that shipped a non-bootable v2.0.40 OTA image. Safety net so a future revert of the security=sien build step fails loudly at release time instead of silently shipping a bad OTA.
2026-06-23 feat(solar): make MPPT RS-485 link observable from Notehub; release v2.0.42
    When the SunSaver MPPT is enabled but the Modbus/RS-485 link does not respond, the client previously produced NO signal: getEffectiveBatteryVoltage() returns 0 (no v sent), appendSolarDataToDaily() omitted the whole solar block on comm failure, and alertOnCommFailure defaults off. An enabled-but-failing charger was indistinguishable from a disabled one.
    sendTelemetry now emits scOk:1/0 whenever solarCharger.enabled (Modbus link healthy vs not), so the state is visible every cycle. appendSolarDataToDaily now emits {commOk:0,errs:N} on failure instead of omitting the block, and tags the healthy block commOk:1. No chan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
    [TankAlarm-112025-Client-BluesOpta.ino, TankAlarm_Common.h]
2026-06-23 docs(review): field diagnostics - MPPT voltage, A0602 sensor fault, config delivery; exploration plan
    New code review covering the open field issues on dev:...545: (1) no battery voltage = likely client config still grid (solarCharger.enabled false) so the SunSaver poller never starts; config-gen trap where 'Non-Monitored MPPT' sets mpptEnabled but not solarCharger.enabled. (2) current-loop reads 0/ru:1 = A0602 I2C hardware fault (deferred Fix 11); dashboard sensor-fault is a stale 1.9.42 latch. (3) config-apply confirmation is async (queued -> client inbound sync -> config_ack). Plus RS-485 driver watch items (pre-delay=0, alertOnCommFailure default, scOk observability added in 2.0.42) and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
2026-06-23 v2.0.43: bounded retry on SunSaver realtime block for RS-485 noise immunity
    TankAlarm_Solar: wrap the verified realtime read (0x0008..0x000C) in a bounded retry loop (3 attempts, 100ms settle, WDT kicked per attempt). Prevents a single transient RS-485 disturbance from running up SOLAR_COMM_FAILURE_THRESHOLD and raising a false comm-failure alarm. Setpoint/status/daily reads are intentionally NOT retried so worst-case Modbus blocking stays bounded.
    Version bump 2.0.42 -> 2.0.43 (build seq 237). Client comment now reflects the actual 1000ms default Modbus timeout. Drops the stale v1.9.30 implementation-status section from the OTA silent-check review; adds the 06/23 field-diagnostics review +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
    [TankAlarm-112025-Client-BluesOpta.ino, TankAlarm_Common.h, TankAlarm_Solar.cpp, TankAlarm_Solar.h]
2026-06-23 harden(solar): cap modbusTimeoutMs at 4000ms to bound the v2.0.43 retry vs the 30s watchdog
    sanitizeSolarConfig already floored modbusTimeoutMs at 500ms but had no ceiling. With the v2.0.43 bounded retry (SOLAR_REALTIME_MAX_ATTEMPTS attempts, each trying both Modbus function codes = up to 2x timeout), an out-of-range/corrupted config timeout could let a single solar poll approach WATCHDOG_TIMEOUT_SECONDS (30s). A legitimate SunSaver/MRC-1 reply is sub-second, so a 4000ms ceiling is generous and keeps the whole retried poll well under the watchdog window. Completes the floor/ceiling pattern already used for pollIntervalSec. Reviewed the v2.0.43 RS-485 retry: correct, WDT-safe (kicked per atte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
    [TankAlarm-112025-Client-BluesOpta.ino]
2026-06-23 fix(solar): read SunSaver registers individually (v2.0.44)
    Production polled the 5 realtime registers (0x0008) and 4 setpoint registers (V_REG) as multi-register block reads. Bench-proven test sketches that successfully talk to the SunSaver through the MRC-1 MeterBus->RS-485 bridge read one register at a time (count=1). The MRC-1 bridge answers single-register reads but does not reliably answer multi-register block reads, which matches the field symptom: the single-read startup probe succeeds but every block-read poll fails with scOk:0.
    Add readRegistersIndividually() helper that issues each register as its own Modbus transaction (WDT-kicked per read, short-circuits on first failure) and us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
    [TankAlarm_Common.h, TankAlarm_Solar.cpp]
2026-06-23 fix(solar): signed-current scOk:0 regression + field diagnostics (v2.0.45, Release A)
    SunSaver scaleCurrent() read the two's-complement current registers as unsigned, so a small negative charge current at night (~-16 counts) scaled to ~158A, tripped the plausibility clamp, and silently failed the whole poll -> scOk:0 on a healthy Modbus read. Fix: cast through int16_t; gate communicationOk on battery voltage only; clamp array/current as data quality. Skip unused realtime 0x000A and setpoint gap 0x0034; preserve FC03/FC04 cache on transient failure; add Modbus error taxonomy (lastError/addr/ms/scImpl) emitted in telemetry + daily failure block; drain RS-485 RX before each transaction.
    A0602: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
    [TankAlarm-112025-Client-BluesOpta.ino, TankAlarm_Common.h, TankAlarm_I2C.h, TankAlarm_Solar.cpp, TankAlarm_Solar.h]
2026-06-24 v2.0.46: A0602 shared-bus I2C hardening
    Firmware-only single-bus discipline for the A0602 current-loop reads that share the Wire bus with the Notecard (no HW change; the Opta exposes one usable I2C bus). FT1 two-phase sampleMonitors (defer all Notecard publishes until after the A0602 read burst). FT2 timeouts: Notecard/global I2C_WIRE_TIMEOUT_MS 25->50ms, A0602 scoped to 25ms. FT7 per-op 400kHz clock window around A0602 frames with guaranteed 100kHz restore on every exit. FT4 reject raw 0xFFFF in tankalarm_readCurrentAdcFramed + over-range (>21mA) guard. FT3 ensureNotecardBinding after sensor-only recovery + fix PB_8/PB_9->PH_7/PH_8 comment. FT5/FT6 daily cl_ok/cl_or/cl_fault/cl_dur_us obser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
    [TankAlarm-112025-Client-BluesOpta.ino, TankAlarm_Common.h, TankAlarm_Config.h, TankAlarm_I2C.h]
2026-06-24 Add A0602 diagnostic docs and sketch
    Add a set of USB-only diagnostic materials and a test sketch for investigating the A0602 current-loop issue. New files include a comprehensive findings/test plan (A0602_ADDRESSING_FINDINGS_AND_FIX_TEST_PLAN), a USB diagnostic plan, client commands and todo lists, a run-log placeholder, and the diagnostic sketch TankAlarm-112025-A0602_Diagnostic.ino. These artifacts guide a managed-vs-raw I2C discrimination (OptaController/AnalogExpansion vs production raw frames), outline flashing/MCUboot signing steps, and provide reproducible USB-only procedures — no production firmware was changed.
    [TankAlarm-112025-A0602_Diagnostic.ino]
2026-06-25 v2.0.47: A0602 managed addressing bootstrap (OptaController) + CI lib install
    Bench diagnostic + Notehub telemetry showed the field A0602 never lived at the
    legacy 0x64/0x0A probe defaults but at 0x0B (the first Blueprint-assigned
    address). Every v2.0.46 framed Blueprint frame was silently NACKed at 0x64 so
    the read path returned stale buffer bytes -- the "stuck ~18 mA" field symptom.
    Add a one-shot OptaController.begin() handshake in setup() to discover the
    A0602's assigned address and steer gConfig.currentLoopI2cAddress at it.
    v2.0.46's existing framed-protocol read path (configureCurrentAdcChannel ->
    getAnalogChannelFunction -> readCurrentAdcFramed) is unchanged and now talks to
    the r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
    [TankAlarm-112025-Client-BluesOpta.ino, TankAlarm_Common.h]
2026-06-25 Add battery voltage sampling code review
    Add a detailed code review for the Blues Opta client firmware (TankAlarm-112025-Client-BluesOpta) that documents architectural and logical issues with battery voltage sampling and reporting. The review (dated June 25, 2026, analyst: GitHub Copilot) identifies five major inconsistencies: dead Notecard voltage code, missing compile guards around battery monitoring, redundant daily battery reporting, a hazardous "lower-of" selection that lets noisy ADC readings override MPPT, and a missing live-zero fault gate for analog sensors. It recommends deleting the unused readNotecardVinVoltage, adding ARDUINO_OPTA/ARDUINO_ARCH_MBED compile guards, enforcing MPPT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
2026-06-25 v2.0.48: battery monitor sources from MPPT/Vin (Fix 9/10/11) + Voltage Monitor UI
    - Strict MPPT > Vin-divider priority in getEffectiveBatteryVoltage (Fix 9)
    - Notecard card.voltage removed as a battery source on all platforms (Fix 11)
    - pollBatteryVoltage refactored to read from getEffectiveBatteryVoltage; deleted
    readNotecardVinVoltage and configureBatteryMonitoring
    - batteryMonitor alerts deferred when source == MPPT (avoids dup w/ solarCharger)
    - Daily-report battery section tagged with active source (battery.src)
    - Server UI: 3-option Voltage Monitor selector (None / Voltage Divider / RS485)
    replacing the 2-option Vin Monitor toggle; solarCharger.enabled now derived
    from the select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
    [TankAlarm-112025-Client-BluesOpta.ino, TankAlarm_Battery.h, TankAlarm_Common.h]
2026-06-25 v2.0.49: RS-485 / SunSaver MPPT Modbus hardening (Fix S1-S4)
    - Fix S1: dynamic DE turnaround delay (was hardcoded 1200 us; bus contention at
    19200+ baud). Now (11_000_000 / baud) us, floor 150 / ceiling 1500.
    - Fix S2: reset Modbus error counters in sendDailyReport() so merr is windowed
    per 24h instead of lifetime-since-boot.
    - Fix S3: adaptive realtime poll - when consecutiveErrors >= 1, cap retries to
    1 and skip alternate-FC probe. Worst-case dead-bus blocking drops from
    ~6.2s to ~1s per poll. Pulse sampler no longer starved.
    - Fix S4: derive chargeState from electrical values in updateHealthStatus so
    getChargeStateDescription stops permanently reporting 'Starting' in
    productio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
    [TankAlarm-112025-Client-BluesOpta.ino, TankAlarm_Common.h, TankAlarm_Solar.cpp]
2026-06-25 v2.0.50: current-loop sensor hardening (Fix C1 + Fix C2)
    - Fix C1: lightweight post-recovery A0602 address re-probe at the two sensor-
    recovery sites (dual-failure L1987-L2019, sensor-only L2071-L2097). Replaces
    the rejected original Inconsistency B recommendation to call
    bootstrapA0602Managed() outside setup() (violates explicit prohibition).
    Worst case ~150 ms. Runtime steering only - not persisted. WARNING log line
    on a 0x0A landing distinguishes 'address found' from 'sensor working'.
    - Fix C2: configure ADC channel BEFORE PWM warmup; split 400 kHz burst window
    into CONFIGURE and SAMPLE phases with a normal-clock warmup gap between.
    AD74412R sense node is now connected to th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
    [TankAlarm-112025-Client-BluesOpta.ino, TankAlarm_Common.h, TankAlarm_I2C.h]
2026-06-25 Add post-v2.0.50 remaining issues doc
    Add a detailed code-review doc capturing the bench state and remaining work after v2.0.48–v2.0.50. The new document records: bench unit status, resolved vs. open items from the prior review, a ranked list of outstanding work (high: OTA field upgrade to v2.0.50 and bench carrier voltage-divider audit; medium: A0602 telemetry surfacing, true A0602 re-management, SunSaver fault reads, bench-validation captures; low: PWM gating, multi-day voltage trends, misc. docs), recommended operator actions and rollback plan, and references. Use this as the canonical post-release checklist and to prioritize the next Client/Server releases and bench sessions.
2026-06-25 v2.0.51: current-loop telemetry is raw mA only, fault string on failure (Fix 12)
    - buildSensorObject() current-loop branch rewrite:
    - Successful read -> emit ma always (drop the >=4.0 mA gate that hid
    live-zero readings).
    - Failed read (sampleReused) -> emit
    ault: <short_string> (one of
    pwm_nack / config_nack / func_wrong / read_fail / over_range / unknown);
    do NOT emit ma or lvl.
    - Skip lvl/cap for current-loop sensors so a faulted read can never
    masquerade as a real 0 PSI / 0 in reading. Other sensor types unchanged.
    - New clFaultReasonString() helper maps the ClFaultReason enum to short
    stable strings for dashboard rendering.
    - Resolves the v2.0.50 diagnostic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
    [TankAlarm-112025-Client-BluesOpta.ino, TankAlarm_Common.h]
2026-06-25 v2.0.53: Fix 13 server-side mA conversion + Fix 14/R1-R6 RS-485 observability
    Combined release rolling up two waves of changes that share the same
    client/server file set:
    Fix 13 (originally planned as v2.0.52, absorbed here):
    - Server resolveLevel derives levelInches from cached config when client
    sends raw ma without lvl (v2.0.51+ current-loop format)
    - SensorRecord.sensorFault transient field ingested from doc[fault];
    emitted as flt via API
    - Dropped legacy >=4.0f mA gate across 6 API serializers and registry save
    - Dashboard renders red FAULT badge + small gray raw mA below converted level
    Fix R1-R6 (telemetry observability for ambiguous RS-485 failures):
    - R1 per-poll classified er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
    [TankAlarm-112025-Client-BluesOpta.ino, TankAlarm_Common.h, TankAlarm_Solar.cpp, TankAlarm_Solar.h]
2026-06-26 Simplify current-loop sensor sampling
    Replace the complex A0602 framed I2C burst workflow with a simpler gating-and-sampling approach in readCurrentLoopSensor: enable PWM gating, wait 3000ms for stabilization, take 5 samples spaced 300ms using readCurrentLoopMilliamps(), kick watchdog as needed, then disable PWM. Preserve existing bounds checks, fault handling (over-range, live-zero, read failures), calibration and level/pressure calculations. Also add a detailed code review (CODE_REVIEW_06262026_CURRENT_LOOP_SIMPLIFICATION.md) and a text copy of the new function (new_readCurrentLoopSensor.txt). Bump firmware version/build sequence to 2.0.54 (build 248) and include compile output (compile_ou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
    [TankAlarm-112025-Client-BluesOpta.ino, TankAlarm_Common.h]
2026-06-26 Add OptaView & RS-485 diagnostics; bump version
    Add a standalone OptaView demo and diagnostics tooling and harden SunSaver RS-485 handling. Key changes:
    - Add OptaView/OptaView.ino and README: interactive CLI tool, hardened Modbus TX turnaround, probe wizard, raw/frame utilities and live telemetry parsing.
    - Add code review notes: CODE_REVIEW_06262026_DIAGNOSTICS_OPTAVIEW_AND_PRODUCTION_RESTORE.md and extend current-loop review document with SunSaver RS-485 isolation notes.
    - Add direct-bypass test firmware firmware/sunsaver-rs485-direct-serial2/sunsaver-rs485-direct-serial2.ino to exercise Serial2 + DE/RE pins without ArduinoRS485/Modbus layers.
    - Bind RS-485 to explicit Serial2 instances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
2026-06-29 v2.0.56: fix orphaned-epoch in daily reports + rename headline cache fields to be sensor-agnostic
    Telemetry fixes (per CODE_REVIEW_06292026_CLIENT_TELEMETRY.md):
    - Client: appendDailyMonitor now emits per-sensor acquisition epoch ('t') in each entry of the daily.qo sensors array. Previously daily reports carried no per-sensor timestamp, so when sampleMonitors() reused a stale cached reading (sf/ru flagged), the server bumped lastUpdateEpoch to report-time and the dashboard falsely showed the stale value as 'just updated'.
    - Server: handleDaily() now prefers the nested t['t'] over the top-level report epoch when computing rec->lastUpdateEpoch, resolving the orphaned-epoch bug for every sens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
    [TankAlarm-112025-Client-BluesOpta.ino, TankAlarm-112025-Viewer-BluesOpta.ino, TankAlarm_Common.h, TankAlarm_Config.h]
2026-06-29 v2.0.57: fix dashboard graph rendering (Chart.js date adapter + snapshot timestamp guards)
    Root cause: HISTORICAL_DATA_HTML loaded Chart.js 4.4.1 but no date adapter. Chart.js 4.x dropped the bundled moment integration, so charts using scales.x.type='time' (the level chart, voltage chart, and archived chart) silently fail to construct and the <canvas> stays blank. Added chartjs-adapter-date-fns@3.0.0 from jsdelivr, loaded right after chart.umd.min.js in the page head.
    Defensive fixes for the snapshot pipeline that surfaced during the audit:
    - recordTelemetrySnapshot() now refuses to write a snapshot when currentEpoch() returns 0 (server clock not yet synced from Notecard). Previously such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
    [TankAlarm_Common.h]
2026-06-29 v2.0.58: chart X-axis uses sensor acquisition time, not server receive time
    Plumb the client's sensor acquisition epoch through to recordTelemetrySnapshot so chart X-axis points land at when the reading was actually taken, not when the server happened to record it.
    What changed:
    - recordTelemetrySnapshot() gains a required eventEpoch parameter and replaces its always-currentEpoch() body with a sane-window check: eventEpoch is used if it falls between 2020-01-01 and (currentEpoch+24h), else falls back to currentEpoch, else refuses to record.
    - handleTelemetry passes doc['t'] (client's lastReadingEpoch) -> processNotefile epoch as fallback.
    - handleAlarm passes doc['t'] -> epoch as fallbac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
    [TankAlarm_Common.h]
2026-06-29 v2.0.59: dashboard sparkline shows accurate placeholder when no trend data
    The main dashboard's sensor cards include a small inline sparkline backed by /api/history. When the server had no history (just-booted, never received a daily.qo, or all snapshots dropped by the new timestamp-validity guard), data.sensors came back empty and the placeholder kept reading 'Loading trend...' forever — leaving the user unsure whether the data was still loading or simply unavailable.
    Changes (dashboard JS, embedded in HOME_HTML on the server):
    - state gains sparkLoaded and sparkError flags.
    - loadSparklineData() now sets sparkLoaded=true and calls renderSparklines() on EVERY exit path (HTTP failure, e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
    [TankAlarm_Common.h]
2026-06-29 v2.0.60: add Test Connection button to FTP settings
    New /api/ftp-test endpoint performs a full round-trip against the saved FTP/FTPS settings: connect+login -> STOR a tiny test file -> RETR it back -> verify byte-for-byte content match. Returns per-step JSON with elapsed times and per-step error messages so the operator can see exactly which stage failed (DNS/connect, login, TLS handshake, PASV, STOR, or RETR).
    Dashboard server-settings page gains a 'Test Connection' button next to Backup Now / Restore Now, with an inline color-coded status panel showing the step-by-step result.
    Test file is <ftpPath>/<serverUid>/tankalarm-conn-test.txt — overwritten on each test so it never accumulates.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
    [TankAlarm_Common.h]
2026-06-29 v2.0.61: fix FTP Test Connection — feed watchdog so the Opta does not reset mid-test
    Symptom: clicking 'Test Connection' on the server-settings page would show 'Connecting, uploading, downloading, verifying...' for about a minute and then the browser would silently bounce to /login with no error displayed.
    Root cause: handleFtpTestPost() in v2.0.60 invoked ftpConnectAndLogin / ftpsConnectAndLogin and the Store/RetrieveBuffer helpers without ever calling serviceTransferWatchdog(). When the FTP host was unreachable or slow, a single network step could block for longer than WATCHDOG_TIMEOUT_SECONDS (=30s), the hardware watchdog fired, the device reset, and a fresh session token was generated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
    [TankAlarm_Common.h]
2026-06-29 Fix FTP test/backup crash + auto-create plain-FTP remote dir
    v2.0.69
    ROOT CAUSE: handleFtpTestPost() called memset(&session, 0, sizeof(session))
    on FtpSession, whose ::ctrl is an EthernetClient holding a
    std::shared_ptr<MbedClient>. memsetting a shared_ptr is undefined behavior
    and corrupted the control block, causing the next session.ctrl.connect()
    call to crash. The device would reset before the handler could respond,
    which is what the user observed as 'Failed to fetch' followed by a
    redirect to /login.
    ftpConnect/banner now succeed in ~17 ms on a reachable host, matching
    the existing performFtpBackupDetailed() timing. Both backup and test
    share the same code path.
    ADDITIONAL FIX: plain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
    [TankAlarm_Common.h]
2026-06-29 FTP audit: discover-fingerprint button + close MKD gaps + FTPS-aware archive retrieval
    v2.0.71
    FEATURE: Discover SHA-256 Fingerprint button on the FTP settings page
    Adds POST /api/ftp-discover-fingerprint that opens an FTPS handshake to
    the configured host, skips certificate validation, captures the peer
    cert's SHA-256 fingerprint via the new
    FtpsClient::discoverFingerprint() API (FTPSclientOPTA 0.3.0), and
    returns it to the browser. The JS shows the fingerprint in a confirm
    dialog so the operator can verify it with the server admin before
    pasting it into the field. Save Settings and Test Connection now warn
    when FTPS is enabled but the fingerprint field is empty.
    AUDIT: close MKD/protoco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
    [TankAlarm_Common.h]
2026-06-30 Fix FTP JS syntax error + document FTPSclientOPTA upstream changes
    v2.0.72
    The v2.0.71 server settings page had a JavaScript syntax error in the
    new confirmMissingFingerprint() string: a 'server\\'s' apostrophe was
    embedded inside a single-quoted JS literal inside a C++ raw string.
    The raw string preserved the backslash literally, so the browser saw
    '\\\\' (an escape for '\') followed by an unescaped ' that closed the
    string early, then a stray 's that broke parsing of the entire IIFE.
    The visible symptom was that Test Connection, Backup Now, Restore Now,
    and Discover Fingerprint all stopped responding to clicks because the
    event listeners never registered.
    Fix: remove the apostrophe from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
    [TankAlarm_Common.h]
2026-06-30 CI: vendor FTPSclientOPTA 0.3.0 overlay so build passes pre-upstream
    Build failures in runs #428, #429 (compile-check) and #60, #61 (release)
    were caused by FtpsClient::discoverFingerprint(...) not existing in
    the upstream dorkmo/FTPSclientOPTA repo yet (it was added locally for
    the v2.0.70+ Discover Fingerprint button but the library tag has not
    been published).
    Bridge: vendor the three modified library files
    (library.properties + src/FtpsClient.{h,cpp}) under
    vendor/FTPSclientOPTA-overlay/ and add a CI step that copies them on
    top of the upstream checkout right after the checkout completes.
    Once dorkmo/FTPSclientOPTA publishes 0.3.0, delete:
    - vendor/FTPSclientOPTA-overlay/
    - the 'Ov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
2026-06-30 CI: drop FTPSclientOPTA 0.3.0 overlay now that upstream is released
    dorkmo/FTPSclientOPTA v0.3.0 is now published with FtpsClient::discoverFingerprint(), so the temporary vendor/FTPSclientOPTA-overlay/ bridge and the matching 'Overlay local FTPSclientOPTA 0.3.0 patch' step in arduino-ci-112025.yml and release-firmware-112025.yml are no longer needed. CI now pulls the upstream library as-is.
2026-06-30 Client: hard-fail build when TANKALARM_DFU_MCUBOOT is not defined
    Convert the existing soft #warning into a #error so it becomes impossible
    to ship a client binary that silently lacks MCUboot OTA-apply support.
    A non-MCUboot client downloads every Notehub payload, then takes the
    #else branch in checkForFirmwareUpdate() and reports
    _health.qo: 'MCUboot DFU not supported in this build'
    on every retry. The server logs an ota-stage-failed SMS each time and
    the device stays stuck — recovery requires another USB flash.
    This is exactly what just happened to dev:860322068056545 (2.0.55 ->
    2.0.58, see Notehub event 7e204dbc-...06704). Root cause was a local
    arduino-cli compile that omitted the -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
    [TankAlarm-112025-Client-BluesOpta.ino]
2026-06-30 v2.0.73: bump for hard-fail TANKALARM_DFU_MCUBOOT guard release
    Triggers auto-tag-on-version-bump workflow -> creates tag v2.0.73 ->
    runs Release TankAlarm Firmware (112025) -> publishes signed
    TankAlarm-Client-secure-v2.0.73.slot\$...bin (with the new #error
    guard at the top of TankAlarm-112025-Client-BluesOpta.ino) and the
    matching server bin to the v2.0.73 GitHub release page.
    Once the release artifacts are uploaded, the operator can:
    1. Download TankAlarm-Client-secure-v2.0.73.slot\$....bin
    2. USB-DFU flash it onto dev:860322068056545 (and any other
    stuck client that is still on a non-MCUboot binary)
    3. Cancel the queued v2.0.58 DFU on Notehub for that device
    The server arti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
    [TankAlarm_Common.h]
2026-06-30 v2.0.74: on-demand telemetry update (Update dashboard button)
    Replaces the per-sensor 'Refresh' button (which only pulled queued Notehub events) with an 'Update' button that asks the remote client to take a fresh sensor reading and publish it ASAP via a new command type.
    Pipeline: server POST /api/request-update -> command.qo (_type=telemetry_request) -> Notehub Route -> client telemetry_request.qi -> client sampleMonitors() + force-publish each enabled monitor + hub.sync.
    Hardware note: the Notecard ATTN pin is not wired to a wake GPIO on the Opta, so the client cannot be woken by inbound traffic. The request honors the client's existing inbound polling cadence (10 min grid / 60 min solar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
    [TankAlarm-112025-Client-BluesOpta.ino, TankAlarm_Common.h]
2026-06-30 v2.0.75: fix stuck 4-20mA current-loop reads (restore framed config+read)
    Symptom: dev:860322068056545 (Cox Wellhead gas sensor) published the same mA value (4.26) on every telemetry note regardless of applied pressure. Same signature as the v1.9.22-era 18.02mA stuck bug.
    Root cause: commit e00a25a ('Simplify current-loop sensor sampling') removed the SET CH_ADC channel configuration before reads. In the power-gated production model the A0602/AD74412R rail comes back unconfigured on every cycle; without re-issuing the configure frame, the chip returns a stale default register value that looks plausible (within 4-20mA), passes validation, and is published as if fresh. The simplification was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
    [TankAlarm-112025-Client-BluesOpta.ino, TankAlarm_Common.h]
2026-07-01 v2.0.76: expose CL_FAULT_UNDER_RANGE and emit ma_raw on fault for diagnosis
    The v2.0.75 fix (framed A0602 read path restored) is confirmed working on dev:860322068056545 — event 630015c3 shows fv=2.0.75, pg=1, ru=1, fault='ok'. The framed reads succeed (no read_fail), config succeeds (no config_nack), function verifies (no func_wrong). The averaged mA now genuinely comes back below the 3.6 mA CURRENT_LOOP_FAULT_MA live-zero threshold. Before v2.0.75 the bare-shortcut protocol was returning a stale 4.26 mA default register value that happened to be JUST ABOVE the fault threshold, so the loop's actual state (below 4 mA) was masked.
    Two problems exposed by that:
    1) The under-range branch in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
    [TankAlarm-112025-Client-BluesOpta.ino, TankAlarm_Common.h]
2026-07-01 Bump to v2.0.77 and add A0602 sweep test
    Updates common firmware metadata to v2.0.77 with build sequence 271. Adds a new A0602 multi-channel PWM gating utility sketch that scans for the module and cycles P1–P4 for bench verification of high-side output behavior. Also adds two code review reports documenting the stuck-4.19mA root-cause proof, bench validation results, and PWM/gating diagnostics guidance.
    [A0602_Multi_Channel_Gating_Test.ino, TankAlarm_Common.h]
2026-07-01 Add A0602 loop-power helpers
    Adds new I2C helpers for DAC loop-powered sensor gating, LED control, and soft PWM ramp up/down. Also includes two A0602 utility sketches for validating the DAC-powered loop path and simultaneous LED/gating behavior.
2026-07-02 v2.1.0: retire PWM power gating; DAC internally-powered 4-20mA loop with LED pilot
    Client:
    - readCurrentLoopSensor() now powers the transmitter loop from the sensor
    channel's own DAC (~11V out the channel's +/- terminals) with the current
    ADC overlaid on the same channel (adding_adc), replacing the P1-P4
    PWM/high-side-transistor gating that proved failure-prone (fried P1 MOSFET
    on the bench unit).
    - Channel yellow face LED lights while the loop is powered (pilot light),
    clears on power-down; loop returns to high-impedance between duty cycles.
    - Config fields renamed pwmGating* -> loopPowerEnabled/Warmup/SampleDelay;
    pwmGatingChannel retired and ignored. Legacy pwmGating* keys sti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
    [TankAlarm-112025-Client-BluesOpta.ino, TankAlarm_Common.h]
2026-07-02 v2.1.1: fix DAC loop-power apply-settle timing (v2.1.0 read_fail)
    Root cause (bench-proven by A/B raw-frame forensics): the A0602 applies
    each Blueprint SET in its own main loop -- the ACK only means "queued".
    tankalarm_configureDacLoopPowered() sent CH_DAC / SET_DAC(11V) /
    CH_ADC+adding_adc back-to-back (~1ms apart), so the 11V value was
    processed before the channel had become a DAC and was dropped: the
    applied DAC drove 0V and every read returned a valid frame with raw=0
    (0.000mA read_fail), despite a healthy sensor.
    A0602_DAC_RawFrame_Diag A/B on the same hardware: settle=0 -> 0.000mA
    forever; settle=300ms -> live loop current. Bus-silence timeout theory
    tested and falsified (readings su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
    [A0602_DAC_RawFrame_Diag.ino, TankAlarm_Common.h, TankAlarm_I2C.h]
2026-07-02 v2.1.2: fix mA scale on DAC loop-powered reads (10.245mA telemetry bug)
    The A0602 add-ADC-on-DAC special case programs the AD74412R with the
    BIPOLAR +/-2.5V range across the 100R sense resistor (expansion
    parse_setup_adc_channel()), unlike the unipolar 0-2.5V range of a plain
    current ADC. Zero current sits at mid-scale (~0x8000) and sourced loop
    current reads negative. tankalarm_readCurrentAdcFramed() applied the
    unipolar 25*raw/65535 formula to both modes, so the real -4.51mA loop
    sample (raw 26857) was transmitted as 10.245mA. The managed library's
    pinCurrent() has a dedicated branch (((raw/65535)*5.0-2.5)/100 A) for
    this mode, which is why the bench DAC utility read 4.51mA from the same
    r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
    [TankAlarm-112025-Client-BluesOpta.ino, TankAlarm_Common.h, TankAlarm_I2C.h]
2026-07-02 v2.1.3: selectable PWM/DAC loop power, mA clipping detection, config advisories
    Loop power (client + server):
    - PWM switched-supply loop power reinstated as a selectable mode alongside
    the v2.1.0 DAC method (loopPowerMode "dac"/"pwm" + loopPowerPwmChannel
    P1-P4). Fixes applied vs the retired pre-2.1.0 code: soft ramp-up/down
    (~1s, inrush/flyback protection per the P1 MOSFET post-mortem) instead of
    a hard 0->100% step, ACK probe after the ramp (pwm_nack detection),
    configured warmup/sample-delay honored with watchdog-chunked warmup, and
    the unreliable GET 0x40 function verify NOT reinstated. PWM mode pairs
    with the unipolar ext-power ADC scale; DAC mode keeps the bipolar reader.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
    [A0602_PWM_Loop_Test.ino, TankAlarm-112025-Client-BluesOpta.ino, TankAlarm_Common.h, TankAlarm_I2C.h, TankAlarm_Solar.cpp, TankAlarm_Solar.h]
2026-07-02 docs: current-loop no-shunt measurement architecture review (07012026)
2026-07-02 Add post-config diag burst investigation report
    Add a new code review report documenting the 2026-07-02 incident on dev:860322068056545. The write-up identifies two separate root causes: configuration persistence loss after OTA (device booting on defaults) and false-positive SENSOR_ONLY I2C recovery triggered by under-range loop faults despite zero I2C errors. It includes timeline evidence, payload-level analysis, and prioritized remediation steps for config-load diagnostics and recovery gating.
2026-07-02 TankAlarm v2.1.4: fix I2C recovery false-positives, repair backoff, diag polish
    Client fixes from the 2026-07-02 v2.1.3 end-to-end bench review (see
    CODE REVIEW/CODE_REVIEW_07022026_POST_CONFIG_DIAG_BURST_AND_CONFIG_LOSS.md):
    - SENSOR_ONLY I2C bus recovery is now gated on bus-implicating fault
    signatures (pwm_nack/config_nack/read_fail). CRC-valid under_range /
    over_range reads no longer trigger SCL-toggle recovery — an open loop
    is not a bus fault. Kills the 7-event diag.qo burst observed when the
    stored legacy config drove PWM on an unused terminal.
    - Recovery exponential backoff and circuit breaker actually work now:
    the post-recovery counter reset made allCurrentLoopFailed f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
    [TankAlarm-112025-Client-BluesOpta.ino, TankAlarm_Common.h]
2026-07-03 docs: RS-485 link RESOLVED - MRC-1 power switch must be ON; document switch requirement + LED guide in READMEs, wiring tutorial, boot print
    [TankAlarm-112025-Client-BluesOpta.ino]
2026-07-03 TankAlarm v2.1.5: fix endless SunSaver setpoint re-probe; ship MRC-1 switch warning
    RS-485 stack review after the link restoration (MRC-1 power switch root
    cause, see CODE_REVIEW_07022026_RS485_SUNSAVER_MRC1_LINK_INVESTIGATION.md
    S11). Stack verified sound end-to-end on the live link: transport timing,
    scaling (13.22V decoded == MSView reference), plausibility gates, alert
    reachability, and the voltage path to the server (telemetry v + vs:"mppt",
    daily solar block, windowed merr buckets).
    One defect fixed: the charge-setpoint probe (chemistry verification)
    re-read all three setpoint registers and printed an "implausible values"
    warning on EVERY 60s poll forever on SunSaver firmware revision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
    [TankAlarm_Common.h, TankAlarm_Solar.cpp]
2026-07-06 v2.2.0: viewer dashboard redesign (server-styled cards, active alarm section, request update) + viewer-managed contacts synced to server
    [TankAlarm-112025-Viewer-BluesOpta.ino, TankAlarm_Common.h]
2026-07-08 v2.2.1: per-contact SMS/Email alert channels, email alert pipeline (alarms/reminders/unloads/test), apply email-format settings, corrected Route #5 tutorial (General HTTP + SendGrid)
    [TankAlarm_Common.h]
2026-07-12 v2.2.6: fix empty Alarm Message Contacts list - escapeHtml was never defined on the config-generator page (renderMsgContacts threw mid-render; also repairs the Load Configuration client list modal)
    [TankAlarm_Common.h]
2026-07-12 v2.2.7: contacts page is master daily report section (recipients + local send time + timezone + DST toggle), settings page daily UI removed, client config Daily Report Contacts checkbox picker replac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
    [TankAlarm_Common.h]
2026-07-14 v2.2.10: fix Notehub Twilio placeholder syntax - [.body.to]/[.body.message] (leading dot required; dotless form passed through literally causing Twilio error 21265)
    [TankAlarm_Common.h]
2026-07-20 v2.2.11: fix issue #313 server webpage bugs
    P0: client-console dead since 502bbcd (extra brace in normalizeApiData -> whole-script SyntaxError); /historical wiped by missing sites key (derive client-side; restores sensors/sites/VIN chart); dashboard trend killed by phantom sensor-0 history + ||1 key collision (ingest guard k>=1 in handleTelemetry/handleDaily, purge k==0 on hot-tier load, ==null?1: in JS). P1: ftpArchiveEnabled now default-on with settings toggle + archiveHistory via /api/server-settings + honest banner (FTP-off vs archive-off vs first-sync-pending); FTP Save button + Saved indicator + save-before-test. Issue item 6: dedicated serverSmsRecipients list for server events (power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
    [TankAlarm_Common.h]
2026-07-21 v2.2.12: viewer DHCP-first networking with Starlink-safe static fallback + server-pushed IP profile over Notehub
    Viewer: tries DHCP, falls back to a static profile when no lease (default 192.168.1.15/24 gw 192.168.1.1 dns 1.1.1.1 - inside the Starlink router's never-auto-assigned .2-.19 range); all defaults overridable in ViewerConfig.h for custom builds (VIEWER_USE_STATIC_IP / VIEWER_STATIC_IP_x / VIEWER_GATEWAY_x / VIEWER_SUBNET_x / VIEWER_DNS_x). New: server-pushed network profile rides the viewer summary note (net{m,ip,gw,sn,dns,rev}); viewer applies each revision once, persists it to QSPI partition-4 LittleFS (/vcfg/viewer_net.json, client-style mount, no reformat of other partitions),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
2026-09-09 docs: add full repository review for 2026-09-08 (multi-agent verified)
    Reviews HEAD (4f30a7f, v2.2.14) from a clean worktree rather than the
    working tree, which holds June code that would revert v2.1.0-v2.1.6.
    125 findings: 27 High, 49 Medium, 49 Low. 118 were confirmed by two
    independent adversarial verifiers each; 7 were established directly
    during the review from compiler warnings, live page rendering, and the
    device data committed in this repo. Two candidates refuted, two split,
    thirteen recorded as unverified leads in Appendix A.
    Highlights:
    - getRelayPin() uses LED_D0+index, but the Opta LED constants are
    7/9/8/153, so relays 2 and 3 are transposed and relay 4 is never driven
    - Dig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
2026-09-09 docs: expand 2026-09-08 review with recovered lenses and prior-item status
    The verification run that was cut short by a usage limit completed on
    re-run (171 agents, no failures), so this fills in everything the first
    commit had to defer.
    - 163 findings, up from 125: 32 High, 67 Medium, 64 Low. The 15
    candidates parked in Appendix A are now verified and folded into the
    main list, and four recovered lenses (server loop timing, client
    energy, server performance, CI and documentation) contribute 22 more.
    - Section 7 is rewritten around measured numbers: gClientConfigs holds
    84,800 bytes of static RAM, /api/history materialises the hot tier
    twice, pollNotecard runs 13 blocking note.get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
2026-09-14 web: unify page chrome and fix layout/style inconsistencies across server pages
    Style and layout consistency pass over the 14 embedded server pages. All
    changes are in STYLE_CSS or page markup; no protocol, storage or handler
    changes.
    - One header on every authenticated page: Dashboard / Client Console /
    History / Contacts / Server Settings with the current section active,
    hidden pause button and Logout. History was previously reachable only
    by URL, and five pages highlighted nothing.
    - Define --card-bg, --accent, --chart-grid (used but never defined) and
    add AA-contrast status tokens; PIN chip and Site Config badge use them.
    - Add rules for ~45 classes the Client Console, History,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
2026-09-14 web: contacts as a table, boxed checkbox fields, one checkbox style site-wide
    - The global input{width:100%;padding:0.6rem} rule applied to checkboxes,
    so every checkbox sat in a stretched, padded box and never lined up
    with its neighbours. input[type=checkbox|radio] now sizes naturally.
    - Contacts renders a real <table> instead of a 7-column CSS grid: SMS and
    Email Alerts checkboxes centre under their headers, association chips
    live in a colspan row, and on phones the table scrolls inside its card
    with the email column hidden by class.
    - Config generator: Stuck Sensor Detection and Calibration Learning were
    loose lines after the sensor grid; each is now a labelled field with a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
2026-09-14 docs(TODO): record review follow-ups on #315/#316; sensor indexes are 1-based
2026-09-14 docs(TODO): S-T06 Clear Relay targets the monitor by dashboard array position (from the #315 review)
2026-09-14 fix(web): bind six dead controls programmatically, restrict client UIDs, clamp config inputs, add page checker to CI
    Six page controls threw ReferenceError on click because their handlers were
    declared inside the page's async IIFE and never reachable from the inline
    onclick/onchange attributes that called them (S-W02):
    - /site-config: Expect Update, Remove Client (and Edit Config, click-to-copy UID)
    - /calibration: Reset (per sensor), sensor-name link (view data points)
    - /transmission-log: Cancel (pending config)
    - /historical: custom date range start/end
    Those attributes also spliced client UIDs into JavaScript source, so a UID
    containing a quote could run code once the handlers worked.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
    [check_web_pages.py]
2026-09-14 fix(web): bind the dashboard and client-console controls programmatically too
    The dashboard's Update, Snooze Reminders, Clear Relay and Remove Client
    buttons and the client console's Edit Config / Edit Configuration and
    Approve Deletion buttons still spliced client UIDs into inline onclick
    JavaScript (the same pattern the first commit removed from the six dead
    controls; encodeURIComponent() does not encode a single quote either).
    They now carry the UID and, where needed, the sensor index and action in
    HTML-escaped data attributes and are handled by one delegated listener per
    page. The client console's UID readout is HTML-escaped as well. No page
    renders a client UID into JavaScript source an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
2026-09-14 fix(web): attribute-safe escaping on every page; validate persisted UIDs at boot
    Six pages implemented escapeHtml() by serialising a text node, which
    escapes & < > but not quotes, so a stored UID containing a double quote
    could break out of an attribute value. Every page now uses the same
    five-character escaper (& < > " ') the dashboard already had; text output
    is unchanged.
    Records persisted before isValidClientUid() gained its character set
    (calibrations, calibration summaries, hot-tier history and FTP cache
    summaries, client config snapshots, client metadata) are validated when
    they are loaded at boot and skipped with a serial warning if their UID is
    not a valid device UID, so the pages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
2026-09-14 fix(web): make config generator round-trips lossless and fix calibration sensor identity
    Config generator (S-W01; CLAUDE H-15, H-16, H-17). loadConfig() rebuilt the
    4-20 mA subtype select after restoring its value, so every ultrasonic tank
    re-saved as pressure; it never unchecked the threshold a config did not
    carry, so a low-only or high-only alarm re-acquired the template's 100/20
    default on save; and it never restored the float-switch trigger, so
    not_activated silently became activated. Now the subtype is restored after
    updateSensorTypeFields() has rebuilt the select (and its dependent fields are
    updated), each threshold checkbox mirrors whether the config carried that
    threshold (zero is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
2026-09-14 fix(web): truthful operator status and save feedback across the server pages
    S-W06 (operator status; CLAUDE M-30, M-31, M-41, L-25, L-51):
    - Dashboard renders float switches as "Float Switch" with ON/OFF instead
    of "Tank Level --" with an inches-per-24h delta and a trend sparkline,
    and a level of exactly 0 in reads 0.0" instead of "--".
    - An "Update requested" pill now expires after the client's reply window
    (10 min grid, 60 min solar); the button comes back as "Retry Update"
    with a tooltip, and the 10 s polling stops with the pill.
    - /api/clients no longer overwrites the client-level alarm type with the
    newest sensor's (a multi-sensor client showed "ALARM: clear").
    - Site Config k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
2026-09-15 v2.2.15: server web UI release (PRs #314-#317) - dead controls, lossless config round-trips, calibration identity, operator status, UID hardening
    Server-only release; client and viewer are version bumps only (notefile
    schema, command formats and the config payload are unchanged). Details in
    release-notes/v2.2.15.md and CODE REVIEW/CODE_REVIEW_09152026_WEBSITE_PRS_314_317_CLAUDE.md.
2026-09-23 ci: add a host unit-test job for hardware-free firmware logic
    Runs `make test` in every tests/host/<suite>/ folder with g++ on
    ubuntu, with ArduinoJson v7.4.3 headers available as ARDUINOJSON_DIR.
    build-firmware now also waits for it, and tests/host/** changes trigger
    the workflow. No suites yet; the S-D03 and C-T01 fixes add them.
2026-09-23 test(host): add the client alarm debounce header and its host test suite
    C-T01 step 1, no behaviour change. TankAlarm_AlarmDebounce.h holds the
    pure alarm logic the next commits move into evaluateAlarms() and
    checkAlarmRateLimit(): a strictly consecutive one-channel debounce step,
    the v2.2.15 analog threshold comparisons, the two-channel high/low
    composition, and a wrap-safe millis() window predicate. It includes only
    <stdint.h> and sits in the client sketch folder (not Common), so the
    host tests compile the exact source the firmware compiles and the
    Common ZIP workflow is not triggered. The sketch includes it; nothing
    calls it yet, so flash and globals are unchanged.
    tests/host/alarm_debou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
2026-09-23 fix(alarms): deliver alarm notes in the first 5 minutes and prune the hourly budget wrap-safely
    C-T01 step 2 (F-05/M-12a, M-12d), client only.
    setup() stamped every per-type last-alarm time as 0 whenever millis()
    was below the 300 s minimum interval, which is always the case at boot.
    checkAlarmRateLimit tests (now - last) < 300000, so every high, low and
    sensor-fault note in the first 5 minutes of uptime was rate-limited and
    never sent (a tank already in alarm at power-up latched silently).
    The stamps are now always millis() - (interval + 1 ms); the unsigned
    subtraction wraps and the modular test lets the first alarm of each
    type through at any uptime.
    The per-monitor and global hourly pru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
    [TankAlarm-112025-Client-BluesOpta.ino]
2026-09-23 fix(alarms): keep rate-limited alarm edges pending and re-send them publish-only
    C-T01 step 3 (M-12b/c, F-05, R-04), client only.
    sendAlarm() drove the local output and remote relays and then dropped
    the alarm.qo note whenever checkAlarmRateLimit denied it. A latch edge
    caught by the 300 s per-type interval or the hourly caps (a re-latch
    right after a config push, a flapping level, the 11th alarm in an
    hour) therefore never reached the server, although the client stayed
    latched. Re-calling sendAlarm to retry would re-drive the outputs and,
    after a momentary timeout or manual reset, re-send remote relay ON.
    sendAlarm() now keeps its actuation code byte-for-byte and hands the
    note to notifyA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
    [TankAlarm-112025-Client-BluesOpta.ino]
2026-09-23 fix(alarms): strictly consecutive debounce, hold on invalid samples, notify relay restores
    C-T01 step 4 (F-04, R-03, H-06, H-05 notification half), client only.
    evaluateAlarms() now runs the analog and digital debounce through
    TankAlarm_AlarmDebounce.h, the code the host tests exercise.
    - Strictly consecutive evidence. An analog trigger counter was reset
    only by a sample in the hysteresis band (or by the other side's
    trigger) and a clear counter was never reset by a band sample, so
    high=80/hyst=5 latched HIGH on [90,50,90,50,90] and cleared a latched
    HIGH on [70,78,70,78,70] (the low side likewise). Any sample that does
    not qualify now resets that direction's count, so a latch or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
    [TankAlarm-112025-Client-BluesOpta.ino, TankAlarm_AlarmDebounce.h]
2026-09-23 fix(alarms): re-assert a latched level alarm after sensor-recovered (NEW-B)
    C-T01 step 5, client only.
    The server treats a sensor-recovered note as a clear and has already
    overwritten the monitor's alarm type with sensor-fault, while the
    client holds its high/low (or digital) latch through the failure. A
    tank still in alarm therefore showed as clear on the server for up to
    a day, until the daily report re-latched it.
    When validateSensorReading() declares a recovery, a monitor with alarms
    enabled, a latch set and nothing already pending now queues that edge
    (high, low, triggered or not_triggered) in the pending slot. It does no
    I/O there: the same pass's evaluateAlarms() re-sends it publish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
    [TankAlarm-112025-Client-BluesOpta.ino]
2026-09-23 test(host): add the warm-tier store core and its host test suite (S-D03)
    Adds TankAlarm-112025-Server-BluesOpta/WarmTierStore.h, a header-only
    implementation of the warm tier's storage logic with no Arduino or mbed
    dependency, and tests/host/warm_store, which builds and runs it on a PC:
    - a buffered reader and a byte-level array element splitter for the
    daily_YYYYMM.json files, so memory use does not grow with the file;
    read errors and short reads are I/O errors, never "corrupt"
    - a two-pass month merge that never empties a file because a read
    failed, replaces a row only with one that has a larger n, copies all
    other rows byte for byte, and rebuilds an unreadable file from its
    rea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
    [WarmTierStore.h, warm_store_test.cpp, warm_test_io.h]
2026-09-23 fix(archive): Load Data fetches only archives listed in the manifest (S-D03)
    Client archives are uploaded under the server's raw Notecard UID
    ("<ftpPath>/dev:.../archived_clients/..."), but GET
    /api/history/archived?file= accepted only [A-Za-z0-9-_./], so the
    History page's "Load Data" answered 400 for every archive.
    The check now accepts a file only if it exactly matches an ftpFile in
    the archive manifest (warmManifestHasFile, host-tested), after refusing
    anything over 255 bytes or containing CR, LF, NUL or "..". A path that
    is not listed answers 404 "Archive not in manifest", and an unreadable
    manifest answers 500. The manifest document is freed before the FTP
    session starts. Existing arc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
    [WarmTierStore.h, warm_store_test.cpp]
2026-09-23 fix(alarms): re-assert after sensor-recovered only while still in alarm
    Address review of the NEW-B re-assertion (C-T01 step 5).
    The re-assertion queued the latched edge whenever the latch was held
    and never looked at the recovered reading. evaluateAlarms() zeroes the
    debounce counters while sensorFailed, so on the recovery sample the
    latch cannot release yet and the retry published the edge at once. A
    HIGH-latched tank pumped down while its loop was disconnected (H=80,
    hyst=5, recovered at 30) therefore sent sensor-recovered, then 'high'
    at 30 in (a new server alarm event and HIGH SMS), then clear two
    samples later. The LOW mirror (tank refilled during the outage) and a
    stuck float that re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
    [TankAlarm-112025-Client-BluesOpta.ino]
2026-09-23 fix(history): address S-D03 review in the warm-tier store
    Review round 1 of WarmTierStore.h and its host tests:
    - A month file that fails to read or write on every try no longer
    holds up the rollup. The position still stays put on an I/O or
    memory error, but after WARM_MAX_FAILED_TICKS (6) hourly ticks in a
    row fail, the rest of that month is skipped (counted in skippedDays,
    logged once) and later months are rolled. The next boot's re-check
    tries it again. Before, one unreadable file blocked every later day
    until it fell below the backfill floor, up to 3 months.
    HISTORICAL_DATA_ARCHITECTURE.md describes the skip.
    - Documents are built with the public JsonDocument constructors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
    [WarmTierStore.h, warm_store_test.cpp, warm_test_io.h]
2026-09-23 fix(history): keep the monthly archive frame out of loop() (S-D03)
    Streaming the warm-tier fallback through warmMonthSummaryVisitor made
    archiveMonthToFtp() small enough for GCC to inline into loop(), which
    put its WarmMonthSensor[20] buffer (1,440 B) into loop()'s own stack
    frame. loop()'s frame grew from 812 B (v2.2.15) to 2,220 B, and that
    space was taken on every path that loop() calls, including web
    requests, FTPS/TLS and DFU. archiveMonthToFtp() is now declared
    noinline. loop() is back to 796 B, and archiveMonthToFtp() has its own
    2,124 B frame, which is only in use during the monthly archive.
    Also adds the S-D03 bench build from the spec's test plan. With
    -DTANKALARM_WARM_SELFTEST, s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
2026-09-23 test(host): find the manifest move-aside rename from the op trace
    The failed-move test searched failure points 0-399 for the first
    rename, but the manifest is written one fwrite per byte first, so that
    rename comes later and the search found nothing (CI: 3 failures in the
    manifest group, 9534 other checks passed). Take the index from the
    trace of a successful salvage instead, as the neighbouring test does.
    [warm_store_test.cpp]
2026-09-23 fix(alarms): stamp alarm notes with the reading's acquisition time
    Alarm notes carried t = send time while their level is the monitor's
    last reading. The server files that level in its history under t, so
    a relay_timeout note or a config-push clear sent hours after the last
    sample put an old reading on a later day, and an edge sent just after
    UTC midnight moved the reading to the next day.
    publishAlarmNote() now sends the reading's acquisition time
    (lastReadingEpoch), as sendTelemetry() already does, and falls back to
    the send time only before the first valid reading. Every latch edge,
    pending retry and sensor-recovered re-assertion is published on a
    fresh sample, so for those t is that sam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
    [TankAlarm-112025-Client-BluesOpta.ino]
2026-09-23 fix(history): record only fresh readings, at their acquisition time (S-D03)
    Rule for daily history: a day's row is built only from fresh readings
    taken on that day. Nothing from another day fills a gap; a day with no
    readings stays blank. When a value's freshness or time is not known, it
    is left out rather than guessed. The dashboard, alarm state and SMS are
    unchanged; only what enters the hot-tier ring (and so the daily rows)
    - Fresh readings only. handleTelemetry records a snapshot only when the
    note is not reused (ru), not from a failed sensor (sf), has no fault,
    and, for a current-loop sensor, carries a raw mA (ma or sensorMa).
    Without it resolveLevel yields a placeholder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
    [WarmTierStore.h]
2026-09-23 test(host): cover what enters history (S-D03)
    New "provenance" group in tests/host/warm_store for the rule that a
    daily row holds only fresh readings taken on that day:
    - Gaps stay blank: sensor A reads on Sep 1-3 and 7-9, sensor B on
    Sep 1-9 except Sep 5, with a rollup every night through Sep 10. Rows
    exist exactly for the days with readings. A's Sep 7 row opens at its
    own first reading and its min/max/mean/n come from Sep 7 only. A day
    whose only readings are in its last minute gets a row from those
    alone. A reboot's re-check of the window adds nothing.
    - warmAcquisitionEpoch: 0, negative, NaN, infinity, the 2020 and 2100
    bounds, an unset server clock, +3600 s accepted and +360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
    [warm_store_test.cpp]
2026-09-23 fix(history): address review of what enters history (S-D03)
    The rule: a daily row uses only fresh readings taken on that day, and a
    value whose time is not known is left out rather than guessed. Review
    round 1 of the provenance change found four ways it still let a
    reading land on the wrong day or count twice, and one output that
    shows the wrong time:
    - Alarm notes no longer add a history snapshot. Their "t" is when the
    note was sent, not when the value was read: at least 1.2 s later on
    a current-loop client (Phase B runs after the A0602 reads), and
    hours later for the "clear" sent when a config push turns alarms off
    while one is latched. That clear carries no ru, so it passed the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
    [WarmTierStore.h, warm_store_test.cpp]
2026-09-23 fix(history): address review round 2 of what enters history (S-D03)
    value whose time or freshness is not known is left out rather than
    guessed. Review round 2 found an alarm that lands on no day, a reading
    and alarms that land on the next day, and a placeholder that passes as
    a reading:
    - A late alarm counts on its own day again. `al` counts alarms by the
    note's "t", but an alarm that arrived after its day was rolled up
    (a client offline across midnight, or an alarm from the last minutes
    of a day delivered after the hourly tick) never reached that day's
    row: nothing re-rolled the day, and a re-roll with the same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
    [WarmTierStore.h, warm_store_test.cpp]
2026-09-23 fix(telemetry): send reading times as whole seconds, and none when unknown
    Telemetry and alarm notes sent t as a fractional epoch. ArduinoJson
    rounds it half-up to 10 digits, so a reading taken at 23:59:59.5 or
    later arrived stamped 00:00:00 of the next day, while the daily
    report's copy of the same reading (already truncated to uint32) kept
    the right day.
    Both now send the acquisition time truncated to whole seconds, like
    the daily report. Telemetry with no valid reading since boot (an
    on-demand request before the first sample) no longer falls back to
    the send time: it sends no t, and the server (PR #319) leaves it out
    of history instead of guessing when it was measured. The server reads
    t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
    [TankAlarm-112025-Client-BluesOpta.ino]
2026-09-23 test(host): run the Apps Script email bridge against stubbed services
    tests/host/email_bridge reads the bridge script from EMAIL_SETUP_HTML
    in the server sketch, so it tests exactly what operators paste, and runs
    it under node's vm with stubs for ContentService, CacheService,
    LockService and MailApp. It covers the first send, repeats by event ID
    and by message id, a failed send releasing its claim, calls with
    nothing to dedupe on, a busy lock and a failing cache (both still
    send), the SECRET check, both body shapes, and that the script parses.
    The Makefile's test target runs node; ARDUINOJSON_DIR is not used.
2026-09-23 fix(history): address review round 3 of what enters history (S-D03)
    The rule: a daily row uses only fresh readings taken on that UTC day,
    and a value whose time or freshness is not known is left out. Review
    round 3 found a converter default and placeholders that still pass as
    readings, alarms counted from reused values, a cached voltage from the
    day before, and upgrade-time snapshots of unknown provenance:
    - A current-loop note enters history only with a raw mA from 4 to 20.
    resolveLevel and convertMaToLevelWithTemp convert only that range and
    return 0.0 otherwise, but the client sends 3.6-21 mA as valid (e.g.
    an overfilled ultrasonic sensor at 3.9 mA, a transmitter at 20.4 mA),
    so t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
    [WarmTierStore.h]
2026-09-23 test(host): cover review round 3 of what enters history (S-D03)
    - warmVinOnReadingDay: telemetry voltage kept only for readings from
    01:00:00 to 23:54:59 UTC; the daily report's voltage only when the
    report was built at least an hour into the reading's day; invalid
    times and spans.
    - legacyCount: the oldest entries never enter a row, before and after
    the ring wraps and a full ring overwrites them.
    - The first boot after an update from v2.2.15: the re-check leaves the
    row v2.2.15 wrote (n 2) despite a late copy in its ring, adds no row
    for a day it never rolled, and the update day's row holds only the
    reading recorded after the update. Without the mark it does both.
    Co-Authored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
2026-09-23 fix(email): use microseconds in message IDs before the clock is set
    With the clock unset the ID was "<uid>-m<millis>-<counter>", and the
    counter restarts at 1 on every boot. Two boots within the bridge's
    6-hour window that each queue their first email at the same millisecond
    of uptime got the same ID, and the bridge dropped the second email as a
    duplicate. Startup jitter is only tens of milliseconds, so that was not
    unlikely for an email sent at a fixed point after setup. The fallback is
    now "<uid>-u<micros>-<counter>".
2026-09-23 fix(alarms): re-send a pending alarm edge only while the sample is in alarm
    Address Copilot review of #318 (retryPendingAlarm).
    retryPendingAlarm() re-sent a rate-limited latch edge whenever its
    latch was still set. The latch holds through up to two release
    samples, and evaluateAlarms() zeroes the debounce counters while
    sensorFailed, so the latch cannot release on the recovery sample. A
    HIGH deferred before a sensor failure (the NEW-B gate only skipped
    queueing when the slot was empty) was therefore sent at once after
    sensor-recovered even when the recovered reading was normal: H=80,
    hyst=5, recovered at 70 sent 'high' at 70, then clear two samples
    later. The same happened without a failur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
    [TankAlarm-112025-Client-BluesOpta.ino, TankAlarm_AlarmDebounce.h]
2026-09-23 fix(history): address review round 4 of what enters history (S-D03)
    Review round 4 found days pruned from the hot tier before the rollup
    reached them, a leftover .tmp that can be the only copy of a month,
    and a stored row dropped for a replacement that cannot be written:
    - The hot-tier prune no longer removes snapshots from a day the rollup
    has not processed yet. The rollup runs first but is bounded (2 month
    rewrites per hourly tick), so after an outage a backfill takes several
    ticks, and a failing month is retried for up to 6; the prune removed
    everything older than hotTierRetentionDays after the first.
    warmPruneCutoff() clamps the cutoff to the start of the first day not
    proces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
    [WarmTierStore.h]
2026-09-23 test(host): cover review round 4 of what enters history (S-D03)
    - Leftover .tmp: restored when its month file is missing (a first
    write; a rebuild cut between its renames, where the .tmp holds a row
    the .bad lacks), dropped when cut mid-write, empty or over the size
    cap (then a .bad beside it is salvaged again), dropped beside its
    month file; a failed stat, read or rename of it, or no memory to read
    it, keeps it and writes nothing. warmRecoverMonthTmp alone reports
    the month file's state. The quarantine test's double fault now
    expects the .tmp restored.
    - A replacement too long to encode leaves the stored row in place,
    alone and in a batch that rewrites the file, including a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
    [warm_store_test.cpp]
2026-09-23 test(alarms): check the overlapping-zone notes against a v2.2.15 port
    Address Copilot review of #318 (overlap behaviour vs. the
    compatibility claim and tests).
    The header and evaluateAlarms() said a sample inside both trigger
    zones (low >= high, a misconfiguration) "keeps v2.2.15's never-latch
    behaviour", and T13b described the old code only in a comment. A
    verbatim port of the v2.2.15 analog debounce (4d2a12a :6339-6412) now
    runs beside the new code in T13 and shows the claim holds only from
    the unlatched state:
    - T13a: neither side latched: neither version ever latches.
    - T13b: LOW latched: v2.2.15 switched the latch to HIGH on the 3rd
    sample and back to LOW on the 5th, sending only ea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
2026-09-23 test(host): expect the stale .tmp kept when the month stat fails (S-D03)
    warmRecoverMonthTmp() now stats the month file before the .tmp. In the
    fault-injection loop that starts with a stale partial .tmp, a failed
    stat of the month file (op 0) ends the tick before it can decide, so
    the .tmp is rightly kept, and checkFaultOutcome reported it as a
    leftover. That tick may now keep exactly the stale .tmp (its text is
    kStaleTmp); nothing else may be left. Each tick of that loop is now
    followed by a clean tick, which must write the expected file and drop
    the .tmp, as in the first loop. Test only; the firmware is unchanged.
    Not run here (no host C++ compiler on this machine): compiled with
    arm-none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
    [warm_store_test.cpp]
2026-09-23 fix(alarms): log a pending alarm edge that a clear supersedes
    A latch edge the rate limiter denied is re-sent only from a later sample
    that is still in alarm. If the level returns to normal first, the latch's
    clear empties the pending slot in notifyAlarmEdge(), so the server never
    receives that HIGH/LOW, and until now nothing said so. v2.2.15 lost these
    edges too.
    When a published clear supersedes a pending edge that was never sent,
    log "Pending alarm dropped (cleared before it was sent): <name> - <type>"
    (Serial and the serial log), once, like the other pending-alarm lines.
    [TankAlarm-112025-Client-BluesOpta.ino]
2026-09-23 docs(alarms): correct the overlapping-zone and sensor-recovery notes
    Overlapping trigger zones (low >= high, a misconfiguration): the notes
    said v2.2.15 never latched from the unlatched state there. It did. The
    v2.2.15 high block counted a reading inside both zones before the low
    block reset it, so the result depended on the order of the readings.
    With high=50, low=60, hyst=5, [70, 70, 55] latched HIGH on the 55, and
    [70, 70, 55, 55, 55, 55] latched HIGH, then flipped to LOW on the 5th
    reading. The new code counts such a reading toward neither alarm, so it
    never latches one and holds an existing latch. The header and
    evaluateAlarms() comments now say that. Host tests T13e and T13f check
    both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
    [TankAlarm-112025-Client-BluesOpta.ino, TankAlarm_AlarmDebounce.h]
2026-09-23 docs(ci): say only the host tests pin ArduinoJson 7.4.3
    The host-tests step name and tests/host/README.md said v7.4.3 is the
    version the firmware is built with. That is not true: compile-check,
    build-firmware and the release workflow install the latest ArduinoJson
    release. Both now say the host tests pin v7.4.3 and the firmware jobs
    install the latest release.
2026-09-23 docs(tests): scope the header-only note to the C++ suites
    The README's last paragraph said only Arduino-free headers can be
    tested, which contradicts the node email_bridge suite described above
    it. It now applies to the C++ suites, and says other suites (such as
    email_bridge) test code embedded in the sketch directly.
2026-09-23 fix(history): address review round 5 of what enters history (S-D03)
    - Midnight `t` from v2.2.16+ clients: #318 (same release) sends
    telemetry and alarm `t` as a truncated uint32_t, so an exact
    00:00:00Z from such a client is a reading or alarm at midnight. Only
    an older client's `t` (a double that arrives rounded, so 23:59:59.5+
    becomes the next midnight) is ambiguous. handleTelemetry now leaves
    out a midnight `t` and handleAlarm leaves a midnight alarm uncounted
    only when the note's "fv" (stamped on every client note) is older
    than 2.2.16 or missing. CLIENT_ONDEMAND_T_TRUSTED_SINCE is renamed
    CLIENT_EXACT_T_SINCE, since it now gates both #318 changes.
    - Rollup retry streak: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
    [WarmTierStore.h]
2026-09-23 test(host): cover review round 5 of what enters history (S-D03)
    - (10c) Rollup retry streak: August fails WARM_MAX_FAILED_TICKS - 1
    ticks, then gets through while September fails for the first time in
    the same tick. September is retried (failedTicks 1, "will retry",
    nothing skipped), keeps its position for its next tries and is
    skipped only on its own WARM_MAX_FAILED_TICKS-th failure. (10b), the
    single failing month skipped after 6 ticks, is unchanged.
    - (8) Midnight `t`: a `t` sent as a uint32_t (v2.2.16+, #318) arrives
    truncated, so 23:59:59.6 stays on the day before and only a reading
    taken at 00:00:00 arrives as midnight.
    Not run here (no host C++ compiler on this machine)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
    [warm_store_test.cpp]
2026-09-23 fix(history): keep the midnight check for sensor-fault/stuck alarm notes (S-D03)
    86b9ab7 treated every alarm note from a 2.2.16+ client as having a
    whole-second t. #318 truncates t only in the alarm note builder used
    for level, float-switch and relay notes; its sensor-fault and
    sensor-stuck notes still send currentEpoch() as a double, which
    ArduinoJson rounds, so one raised at 23:59:59.7 arrives as 00:00:00
    of the next day and would be counted there. Diagnostic notes now keep
    the midnight check whatever the version. Comments, the architecture
    doc and the WARM_MAX_FAILED_TICKS note (failed tries with no batch
    getting through in between) now say this.
    Server build: 1,041,004 B flash, 361,344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
    [WarmTierStore.h]
2026-09-23 fix(web): show operator times without seconds
    Messages move at minute scale, so seconds on the operator pages are noise.
    - Transmission Log: Date/Time column without seconds (formatEpoch).
    - History: tooltipFormat 'MMM d, yyyy, h:mm a' on the level, VIN voltage
    and archived-client charts. Without it the date-fns adapter's datetime
    format ('MMM d, yyyy, h:mm:ss aaaa') is used, which has seconds.
    - Server Settings: Server Time without seconds; the firmware "Last Updated"
    line shows the build time as HH:MM (the buildTime API field is unchanged).
    - Email Format: the preview's "Generated:" and "Last:" lines.
    - Client Console: the cached location time goes through the page's
    formatEpoch, l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
    [TankAlarm-112025-Viewer-BluesOpta.ino]
2026-09-23 fix(history): drop the midnight check for rounded client times (S-D03)
    From v2.2.16 (#318) every client note `t` is a whole minute, truncated
    and written as an integer, so it is always on the day the reading was
    taken. For older clients, whose telemetry and alarm `t` arrives rounded
    to the second, a reading or alarm from the last half second of a UTC
    day may now be filed under the next day. That is accepted, and such a
    reading is still stored once: its daily-report copy (23:59:59,
    truncated) is within the 1 s dedupe of the telemetry's 00:00:00.
    Removed: warmRoundedEpochAtMidnight, the telemetry midnight skip and
    the alarm-count midnight gate with its sensor-fault/stuck exception.
    The server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
    [WarmTierStore.h, warm_store_test.cpp]
2026-09-23 fix(notes): send note times as whole minutes, written as integers
    Messages move on a scale of minutes, so note times no longer carry
    seconds. Every note t the client writes now goes through one helper,
    noteEpochMinute(): the epoch truncated to the whole minute and written
    as a uint32_t. That covers telemetry, alarm and the daily report's
    per-sensor t, sensor-fault/stuck/recovered, clear, the solar, battery,
    power, solar_sunset, battery_failure and i2c-error-rate alarms,
    registration, the daily report's top-level t, and unload pt and t.
    Truncating never moves a reading to another UTC day. Telemetry, alarm
    and daily copies of one reading all come from the same
    lastReadingEpoch, so they carry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
    [TankAlarm-112025-Client-BluesOpta.ino]
2026-09-23 fix(server,viewer): write sensor and unload epochs to JSON as integers
    ArduinoJson 7 stores a double that fits exactly in a float as a float and
    writes it with 7 significant digits, which for a current epoch is up to
    ~500 s off. One whole-second epoch in 128 fits a float, and one whole-minute
    epoch in 32. Once the pages hide seconds, that error shows as a wrong
    minute, so these are now written as uint32_t:
    - /api/sensors "u" and "pe"
    - /api/clients client and per-sensor "u"
    - /api/unloads "t" and "pt"
    - the viewer summary "u"
    - sensor_registry.json "u" and "pe"
    - the viewer's own /api/sensors "u" (it re-serialized the value it read
    from the summary as a double, so the viewer dashboard's "U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
    [TankAlarm-112025-Viewer-BluesOpta.ino]
2026-09-23 fix(server): write location and calibration times as integers; compare u at that resolution
    Review follow-ups to the integer-epoch change:
    - /api/location locationEpoch and client_metadata "le" (the Client
    Console's "Cached Location (as of ...)" time) and the calibration log
    timestamps were still written as doubles. ArduinoJson stores a double
    that fits a float as a float and prints 7 digits, so 1 in 128 (1 in
    32 for the whole-minute calibration times) showed a wrong minute.
    - sendClientDataJson picked the client's most recent sensor by
    comparing a precise lastUpdateEpoch with the "u" it had already
    written as a whole second; it now compares at that resolution, so a
    same-second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
2026-09-23 docs(history): say which note times are whole minutes (S-D03)
    #318 sends telemetry, daily-report and alarm t as whole minutes; its
    i2c-recovery diag note keeps a fractional t (the server never reads
    it). The CLIENT_EXACT_T_SINCE comment and the architecture doc no
    longer say "every note".
2026-09-24 docs: PRs #318-#321 merged; summary review document and TODO statuses
    S-D03 and C-T01 done (PRs #319, #318); S-T06 closed as a duplicate of
    S-T01; C-P07 closed (working tree clean since 2026-09-22); duplicate
    emails tracked and done as S-T07 (#320). New open items: S-W09
    (dashboard 24 h change across gaps) and C-T04 (alarm rate limiter at
    the millis() wrap). X-R01 notes the new host-tests job; X-R02 notes the
    stale committed viewer binary. CODE_REVIEW_09232026_PRS_318_321_CLAUDE.md
    records the changes, owner decisions, verification, review rounds and
    what is left open.
